xavercai/PICAR/论文设计与代码实现对照分析.docx

# 论文设计思路与代码实现对照分析

## 引言

本文档以论文《仿草履虫应激机制的小车避障进化验证系统设计与实现》的设计思路为线索，逐一对比分析系统代码（OEETestFinal_v9.7.1.ino）中各核心设计概念的代码级实现机制。论文提出了”物理结构即算法”的核心假说，并围绕该假说构建了”去标定、去滤波、去PID”三原则、草履虫应激仿生、新奇度驱动开放式进化、“向死而生”混沌机制、自身对照实验设计等五大设计支柱。代码实现（约134,000字符、3,148行）完整覆盖了上述设计思想，以下按论文章节结构展开对照分析。

## 一、“去标定、去滤波、去PID”三原则的代码实现

### 1.1 去标定：ADC原始值直接用于阈值比较

论文表2-3明确指出”去标定”原则的含义为”不转换物理单位”，实现方式为”ADC原始值直接用于阈值比较”，工程要点为”仅做零点校准（相对校准）“。代码中这一原则体现在传感器数据的读取与使用方式上。

在SensorCalibration类中，getLeftRaw()和getRightRaw()方法直接调用analogRead()读取GPIO引脚的原始ADC值，没有任何量程转换、物理单位映射或零点校准操作：

static int getLeftRaw() { return analogRead(PIN_SENSOR_LEFT); }
static int getRightRaw() { return analogRead(PIN_SENSOR_RIGHT); }

传感器原始值随后被直接用于条件比较。在BehaviorRule::compare()中，传感器值直接与预设的阈值常数进行大于/小于/等于比较：

case OP_GREATER: return value > threshold;
case OP_LESS: return value < threshold;
case OP_EQUAL: return abs(value - threshold) < 50;

阈值常量OBSTACLE_ADC_THRESH（1500）和CLEAR_ADC_THRESH（600）直接作用于ADC原始值域，没有经过任何线性变换或物理距离映射。这完全符合论文”去标定”原则中”ADC原始值直接用于阈值比较”的设计要求。传感器值在帧日志FrameLogEntry中也是以原始int16_t形式记录，保持了数据的”未加工”状态。

### 1.2 去滤波：传感器直连ADC，无信号平滑

论文表2-3指出”去滤波”原则的含义为”不进行信号平滑”，实现方式为”传感器直连ADC，无RC滤波”，工程要点为”ADC采样抖动约±50计数”。代码中同样没有任何滤波操作：

在MotorController::update()方法的每一帧执行中，传感器值通过SensorCalibration::getLeftRaw()和getRightRaw()直接读取，未进行移动平均、中值滤波、低通滤波或任何平滑处理。传感器原始值的抖动（约±50计数）被完整保留并传递到行为规则的条件评估和帧日志记录中。论文明确指出这种抖动不是需要消除的噪声，而是”硬件噪声与差动驱动的机械耦合成为行为变异的天然来源”——这正是”去滤波”原则的核心思想：让物理噪声参与计算，而非将其过滤掉。

### 1.3 去PID：不用反馈控制

论文表2-3指出”去PID”原则的含义为”不用反馈控制”。代码中确实不存在任何PID控制器、比例调节或误差反馈回路。电机的PWM输出完全由行为表规则（BehaviorRule）的motorL/motorR字段直接指定，或混沌模式下由GPIO35热噪声直接映射：

int modMotorL = constrain((int)(r.motorL * noiseMod), -255, 255);
int modMotorR = constrain((int)(r.motorR * noiseMod), -255, 255);
startPhysicsAction(modMotorL, modMotorR, modDuration);

电机速度不基于任何误差信号的积分/微分计算，而是由基因编码的规则条件直接触发离散的动作指令。即使存在编码器反馈（用于卡死检测和物理终止），也仅用于判断是否终止当前动作，而非用于实时速度调节。这严格遵循了论文”去PID”原则——用”全或无”的规则触发替代连续反馈控制。

## 二、草履虫应激机制的仿生实现

### 2.1 膜电位作为通用物理量

论文2.1.2节指出，草履虫的细胞膜电位将多模态环境信息（化学、机械、电信号）统一编码为单一物理量（电压），膜电位的升降直接决定纤毛摆动方向。论文2.2.1节进一步说明：ESP32微控制器的GPIO引脚电平或ADC读数被赋予了类似”膜电位”的功能，作为整合传感器信息的通用物理量，直接驱动电机的差动转向。

代码中，左右红外传感器的ADC原始值（leftSensorRaw、rightSensorRaw）扮演了”膜电位”的角色：它们是被统一编码的”通用物理量”，不经过任何语义解析或特征提取，直接被行为规则的条件部分（condType/condOp/condValue）进行比较判断。当传感器值超过阈值时，直接触发对应的电机动作（motorL/motorR），实现了论文所描述的”传感器原始值直接映射为左右轮PWM输出”的仿生映射链路。

### 2.2 回避反射的”全或无”特性

论文2.1.3节描述了草履虫的”回避反射”（Avoiding Reaction）机制：一旦刺激强度超过阈值，纤毛摆动方向瞬间反转，使虫体后退；随后以特定角度转向，再尝试前进。这种”全或无”（All-or-None）特性避免了弱刺激下的无效微调。

代码中，行为表规则引擎完整复现了这一机制：

（1）条件触发是二值的：BehaviorRule::compare()返回true或false，不存在”部分触发”或”渐变响应”。当传感器值超过OBSTACLE_ADC_THRESH时，条件匹配立即触发完整动作。

（2）动作执行是离散的：匹配到规则后，立即调用startPhysicsAction()设置电机PWM值和方向，动作持续durationMs毫秒后自动终止。不存在比例调节——要么全速前进/后退/转向，要么停止。

（3）种子个体中编码了回避反射的典型模式：规则0”左传感器遇障→左轮后退150、右轮前进150”（差动转向），规则1”右传感器遇障→左轮前进150、右轮后退150”（反向差动转向），规则3”卡死检测→后退右转脱困”。这些规则精确对应了草履虫”后退→转向→前进”的回避反射三阶段。

## 三、开放式进化范式的代码实现

### 3.1 新奇度搜索替代目标导向优化

论文1.2.4节指出，传统遗传算法的适应度函数将搜索限制在静态适应性景观中，而开放式进化追求”无目标的进化”。论文的核心设计之一是以新奇度搜索（Novelty Search）替代适应度函数。代码中NoveltyArchive类完整实现了这一机制：

（1）12维行为描述符（BehaviorDescriptor）：

代码中BehaviorDescriptor结构体定义了12个维度的行为特征，分为传感器维度（左/右传感器均值、方差、不对称性）、运动维度（平均速度、速度方差、转向偏置、总距离）和行为模式维度（前进比、转向比、后退比、空闲比）：

struct BehaviorDescriptor {
float leftSensorMean, rightSensorMean; // 传感器均值
float sensorVariance, sensorAsymmetry; // 传感器方差与不对称性
float avgSpeed, speedVariance, turnBias, totalDistance; // 运动维度
float forwardRatio, turnRatio, reverseRatio, idleRatio; // 行为模式
};

（2）K近邻新奇度计算：

NoveltyArchive::computeNovelty()方法计算当前个体到档案中K=5个最近邻的平均欧氏距离。距离计算在12维归一化空间中进行（normalize()方法），确保各维度量纲一致：

float distances[NOVELTY_ARCHIVE_MAX];
int k = min(NOVELTY_K_NEAREST, count);
// 排序取前K个最近邻
float sum = 0;
for (int i = 0; i < k; i++) sum += distances[i];
return sum / k; // 平均最近邻距离 = 新奇度

（3）档案管理与选择机制：

addIfNovel()方法将新奇度超过阈值（NOVELTY_ADD_THRESHOLD=0.15）且档案未满的个体加入档案（最多200条）。进化引擎中，种群按新奇度分数降序排序，保留前25%（精英保留），然后通过锦标赛选择（tournamentSelectByNovelty，规模为3）选择父本进行交叉和变异。这完全替代了传统GA中基于适应度值的排序与选择。

### 3.2 物理结构承担计算

论文v8.0版本日志提出”物理结构承担计算”的设计维度，包含三个子机制：物理终止条件、噪声连续调制、脉冲式控制。

（1）物理终止条件：

论文强调”以物理碰撞终止与噪声连续调制替代代码级计时”。代码中，动作的终止不是由固定计时器决定，而是由编码器检测物理运动状态决定：

void updatePhysicsAction() {
updateEncoders(); // 读取编码器
int32_t currentTicks = distanceTicks;
int deltaTicks = abs((int)(currentTicks - actionLastTicks));
if (deltaTicks == 0) actionStallFrames++; // 编码器停滞计数
else actionStallFrames = max(0, actionStallFrames - 1);
if (actionStallFrames > PHYSICS_STALL_FRAMES || elapsed > PHYSICS_MAX_ACTION_MS)
stopMotors(); // 物理停滞 → 终止动作
}

当编码器检测到轮子停滞（deltaTicks=0持续10帧）或动作超过最大时长3秒时，动作自动终止。终止条件由物理系统的实际运动状态驱动，而非代码中硬编码的固定时间。

（2）噪声连续调制：

论文v8.0版本日志指出”GPIO35每帧读取，调制所有行为参数（0.71.3倍）“。代码中，MotorController::update()方法每帧读取GPIO35的热噪声，并将其映射为0.71.3的调制系数：

float noise = (float)(SensorCalibration::readNoise() % 1000) / 1000.0f;
float noiseMod = 0.7f + noise * 0.6f; // 范围: 0.7 ~ 1.3
int modMotorL = constrain((int)(r.motorL * noiseMod), -255, 255);
int modMotorR = constrain((int)(r.motorR * noiseMod), -255, 255);

这一机制将硬件热噪声（物理世界的随机性）连续地注入到行为参数中，使同一基因型在不同时刻产生略有差异的行为输出。这正是论文所说的”硬件噪声与差动驱动的机械耦合成为行为变异的天然来源”的代码实现。

（3）脉冲式控制：

论文v8.0版本日志提到”删除逐帧平滑，速度变化由物理系统决定”。代码中，电机PWM值由行为规则的durationMs字段控制持续时间，动作在持续时间内以恒定PWM输出，结束后立即停止。速度变化是脉冲式的（突增突降），而非逐帧平滑过渡，符合”物理系统决定运动平滑”的设计理念。

### 3.3 可变长度行为表基因

论文v8.0版本日志提出”以可变长度行为表基因替代固定参数编码”。代码中，BehaviorRule结构体定义了一条IF-THEN规则，包含8种条件类型（后扩展为10种）和动作参数：

struct BehaviorRule {
uint8_t condType; // 条件类型 (0-9, 10种)
int16_t condValue; // 阈值
uint8_t condOp; // 比较操作 (> / < / =)
int16_t motorL; // 左轮PWM
int16_t motorR; // 右轮PWM
uint16_t durationMs; // 持续时间
uint8_t nextRule; // 跳转下一条规则
};

每个个体携带2~16条规则（MIN_RULES=2, MAX_RULES=16），规则数量本身是可进化的。Gene结构体中的ruleCount字段动态记录当前规则数量。

（1）条件类型（10种）： 代码支持COND_SENSOR_LEFT、COND_SENSOR_RIGHT、COND_SENSOR_BOTH、COND_SENSOR_ANY、COND_DISTANCE、COND_TIME、COND_IDLE、COND_ALWAYS、COND_STUCK、COND_ESCAPE共10种条件类型，覆盖了传感器感知、距离判断、时间判断、状态检测等多种行为触发场景。

（2）交叉操作： Gene::crossover()实现随机切割点交叉：从父本1取前k1条规则，从父本2取后k2条规则拼接为子代，结果约束在MIN_RULES~MAX_RULES范围内。这支持可变长度基因组的自然重组。

（3）变异操作（10种）： Gene::mutate()实现了丰富的变异操作，包括：参数微调（condValue±200、motorL/R±50）、持续时间微调（±200ms）、条件类型随机变更（10种随机选择）、操作符变更、跳转目标变更、规则增删（ruleCount++/–）、规则交换顺序。这些操作共同保证了行为空间的充分探索。

（4）规则执行引擎： MotorController::update()方法实现了规则评估引擎：每帧遍历个体的所有规则，按顺序匹配条件。匹配到规则后执行对应动作（startPhysicsAction），动作持续durationMs后自动终止，然后根据nextRule字段跳转到下一条规则或结束当前规则链。这种”条件→动作→计时→跳转”的执行模式构成了行为表的完整语义。

## 四、“向死而生”混沌机制的代码实现

### 4.1 卡死检测（三模式）

论文v8.9-chaos-v4版本日志提出”双模式卡死检测”，代码中实现了三种检测模式，全部在MotorController::update()方法中实现：

// 模式1：编码器差值卡死 - diff > 30 且持续增大，两轮都在转，持续1秒
bool diffStuck = (diff > ENCODER_DIFF_THRESHOLD && diffIncreasing &&
leftSpinning && rightSpinning && !escapeActive);
// 模式2：单轮卡死 - 一个轮子转(>20)，另一个轮子停(<3)，持续1秒
bool oneWheelStuck = ((leftSpinning && rightStopped) ||
(rightSpinning && leftStopped)) && !escapeActive;
// 模式3：大差值兜底 - diff > 60，任意轮子在转，持续1秒
bool largeDiffStuck = (diff > ENCODER_DIFF_THRESHOLD * 2 &&
anySpinning && !escapeActive);
bool isStuckCondition = diffStuck || oneWheelStuck || largeDiffStuck;

三种模式分别检测不同类型的卡死场景：差值卡死（两轮都在转但编码器差值持续增大，可能打滑）、单轮卡死（一个轮子停转，可能卡在障碍物上）、大差值兜底（极端差值情况）。当卡死条件持续ENCODER_STUCK_DURATION（1000ms=1秒）后，设置stuckFlag=true。

### 4.2 混沌触发与物理噪声驱动

论文v8.9-chaos-v5版本日志提出”向死而生”混沌机制的核心哲学：当基因驱动的脱困策略在CHAOS_TIMEOUT_MS（2秒）内未能解除卡死，系统判定”物理结构陷入了基因也无法破解的绝境”。此时代码彻底退场，GPIO35热噪声直接驱动电机，物理世界自主寻找脱困路径。

if (stuckFlag && !chaosActive) {
uint32_t stuckDuration = millis() - stuckStartTime;
if (stuckDuration >= CHAOS_TIMEOUT_MS) { // 2秒超时
startChaos(); // 触发混沌
return;
}
}

startChaos()方法设置chaosActive=true，记录混沌起始时间和距离快照。随后MotorController::updateChaos()方法每帧执行：读取GPIO35热噪声（analogRead(PIN_NOISE_SOURCE)），放大后映射到左右电机PWM：

uint16_t noiseRaw = SensorCalibration::readNoise();
int noiseL = constrain((int)(noiseRaw / 4) * CHAOS_NOISE_AMPLIFIER / 64,
-CHAOS_NOISE_AMPLIFIER, CHAOS_NOISE_AMPLIFIER);
int noiseR = constrain((int)(-noiseRaw / 4) * CHAOS_NOISE_AMPLIFIER / 64,
-CHAOS_NOISE_AMPLIFIER, CHAOS_NOISE_AMPLIFIER);
setMotorSpeed(noiseL, noiseR);

关键设计在于：混沌期间，代码不执行任何行为表规则评估、不进行任何基因解码、不做出任何决策。GPIO35的热噪声（物理世界的量子/热力学随机性）直接驱动电机，小车的行为完全由物理世界的随机涨落决定。这正是论文所说的”代码退场哲学：混沌期间代码不决策，物理世界自主探索”的精确实现。

### 4.3 混沌退出与代码接管

混沌模式需要安全退出机制，让代码在物理运动恢复后重新接管控制。代码中实现了基于编码器实际运动检测的退出机制：

bool hasPhysicalMovement = (totalDelta > 5);
if (hasPhysicalMovement) {
stableFrames++;
if (stableFrames >= CHAOS_RECOVER_STABLE_FRAMES) { // 20帧稳定
endChaos(); // 物理运动恢复 → 代码重新接管
}
}
// 超时保护：5秒无运动强制退出 + 脱困冲撞
if (millis() - chaosStartTime > CHAOS_FORCE_TIMEOUT_MS) {
setMotorSpeed(-CHAOS_ESCAPE_PWM, CHAOS_ESCAPE_PWM); // 后退
delay(300);
setMotorSpeed(CHAOS_ESCAPE_PWM, -CHAOS_ESCAPE_PWM); // 前进
delay(300);
endChaos();
}

退出机制包含两层保障：（1）正常退出——编码器检测到持续运动（totalDelta>5持续20帧），表明物理结构已恢复运动能力，代码安全接管；（2）强制退出——混沌持续5秒无运动，执行脱困冲撞动作（前后交替反转）后强制退出，防止系统永久陷入混沌。这体现了论文”向死而生”的完整闭环：物理结构”死寂”→代码感知→接通物理随机源→物理世界自主决策→物理运动恢复→代码重新接管。

## 五、自身对照实验设计的代码实现

### 5.1 数据分流标记

论文v8.9-chaos-v6版本日志提出”自身对照”方法论：以混沌触发为时间分界线，将同一硬件上的行为数据划分为基线组（Chaos-Free）和实验组（Chaos-Intervention），通过差分分析消除硬件偏差与环境噪声干扰。

代码中，FrameLogEntry结构体新增了chaosActive:1位字段，用于标记每帧数据属于基线组还是实验组：

struct FrameLogEntry {
uint32_t timestamp_ms;
int16_t sensorLeft;
int16_t sensorRight;
uint8_t motorLeftPWM;
uint8_t motorRightPWM;
uint8_t directionL : 1;
uint8_t directionR : 1;
uint8_t chaosActive : 1; // 关键标记位
uint8_t reserved : 4;
};

MotorController::logFrame()方法根据chaosActive标志将每帧数据分流到不同的统计通道：

if (chaosActive) {
chaosFrameCount++;
chaosSpeedLSum += currentSpeedL;
chaosSpeedRSum += currentSpeedR;
} else {
baselineFrameCount++;
baselineSpeedLSum += currentSpeedL;
baselineSpeedRSum += currentSpeedR;
}

这样，同一测试周期内的基线行为数据和混沌干预行为数据被完整记录且可区分，为后续的差分分析（基线 vs 实验组对比）提供了数据结构基础。

### 5.2 混沌统计记录与保存

ChaoticTestRecord结构体（56字节/条）完整记录了混沌相关的统计数据，包括触发次数、总时长、最大时长、首次/末次触发时间、基线/混沌组的距离和帧数、基线/混沌组的平均速度等：

struct ChaoticTestRecord {
uint32_t chaosTriggerCount; // 混沌触发次数
uint32_t chaosTotalDuration; // 混沌总时长
uint32_t chaosMaxDuration; // 单次最大混沌时长
int32_t baselineDistance; // 基线组距离
int32_t chaosDistance; // 混沌组距离
float baselineAvgSpeedL; // 基线组左轮平均速度
float chaosAvgSpeedL; // 混沌组左轮平均速度
uint8_t chaosSuccess; // 混沌是否发生
};

在endCurrentTestImpl()方法中，系统收集MotorController中累积的混沌统计数据，构建ChaoticTestRecord并保存到SPIFFS（/chaos_g{N}_i{X}.csv）。同时，RobustStorage类提供了混沌记录的内存缓冲和批量写入能力，确保数据不丢失。

## 六、物理终止条件与非阻塞状态机

### 6.1 非阻塞状态机重构

论文v8.6版本日志指出RTC看门狗复位问题：“physicsTerminatedAction()内部使用while(1)+delay()，最长阻塞3秒，期间不喂狗→触发RTCWDT_RTC_RST”。修复方案是将阻塞式动作执行重构为非阻塞状态机：

// 旧设计（阻塞式）：
void physicsTerminatedAction() { while(1) { delay(1000); } } // 致命！

// 新设计（非阻塞状态机）：
void startPhysicsAction(int leftPWM, int rightPWM, uint16_t minDurationMs) {
actionInProgress = true; // 设置状态
actionStartTime = millis();
setMotorSpeed(leftPWM, rightPWM);
}
void updatePhysicsAction() {
if (!actionInProgress) return; // 非阻塞，每帧调用
updateEncoders();
if (actionStallFrames > PHYSICS_STALL_FRAMES) {
actionInProgress = false; // 物理终止
stopMotors();
}
}

这种重构使系统在每个loop()周期内可以处理多个任务（传感器读取、编码器更新、Web请求、串口命令），避免了单一动作执行阻塞整个系统。论文v8.6版本日志明确指出”Web控制台在动作执行期间保持响应”，这正是非阻塞状态机带来的工程收益。

### 6.2 主循环架构

代码的主循环（loop()方法）体现了分层架构设计，按照优先级依次处理：

void loop() {
// 1. 物理动作更新（非阻塞）
MotorController::updatePhysicsAction();

// 2. 混沌模式处理（物理噪声驱动）
if (MotorController::isChaosActive()) {
MotorController::updateChaos();
}

// 3. 进化测试执行（行为表规则引擎）
if (EvolutionEngine::isTestActive()) {
Gene& gene = EvolutionEngine::getCurrentGene();
MotorController::update(gene); // 规则评估+动作执行
if (millis() - testStartTime > TEST_DURATION_MS) {
EvolutionEngine::endCurrentTest();
EvolutionEngine::nextIndividual();
}
}

// 4. Web服务器处理
if (wifiReady) CarWebServer::handleClient();

// 5. 状态过渡处理
if (EvolutionEngine::getPendingTransition()) { ... }

// 6. 串口命令处理
if (Serial.available()) { ... }

// 7. 存储心跳
RobustStorage::tick();
}

主循环的架构清晰地体现了论文提出的”三层算法”思想：混沌层（物理噪声直接驱动，代码不决策）> 行为表层（基因编码的规则引擎）> 进化层（代际选择与变异）。每层有明确的优先级和执行边界，互不干扰。

## 七、数据持久化与实验生命周期管理

论文v8.7版本日志提出了完整的数据持久化方案。代码中GeneStorage类实现了多种数据格式的持久化：

（1）种群快照（二进制）： pop_gen_{N}.bin文件以二进制格式保存整个种群的完整基因（所有个体的所有规则），包含魔数（0x47454E45）和版本号（0x0002）用于数据完整性校验。写入采用原子操作策略：先写临时文件→验证大小→重命名为正式文件，防止写入中断导致数据损坏。

（2）个体记录（CSV）： gen_{N}id{M}.csv文件以人类可读的CSV格式保存单个个体的完整基因和测试数据，包括规则数量、每条规则的条件类型/阈值/动作/持续时间、存活时间、编码器计数、新奇度分数等。

（3）帧日志（二进制）： frm_{N}_i{M}.bin文件以紧凑的二进制格式（每帧11字节）保存测试过程中的逐帧数据，包括时间戳、左右传感器值、左右电机PWM、方向标志和混沌标记。FRAME_LOG_SIZE=4096，可存储约40秒的连续数据。

（4）实验状态管理： 实验状态持久化到experiment_state.mrk文件，支持重启后自动恢复实验进度。每轮固定20代（MAX_GENERATIONS_PER_EXPERIMENT=20），自动检测新实验并清理旧数据。这确保了实验的可重复性和断点续跑能力。

## 八、电机PWM不平衡补偿

论文附录A.3记录了电机动力失衡问题的排查过程：“小车存在动力失衡问题（原地打转），经排查发现左电机接线极性错误且左右电机存在约10%~15%的物理性能差异”。代码中通过分方向增益补偿解决此问题：

#define LEFT_FWD_GAIN 1.00 // 左轮前进增益
#define RIGHT_FWD_GAIN 1.30 // 右轮前进增益（补偿）
#define LEFT_REV_GAIN 1.30 // 左轮反转增益
#define RIGHT_REV_GAIN 1.30 // 右轮反转增益

setMotorSpeed()方法根据电机方向应用不同的增益系数：前进时右轮增益1.30倍补偿其物理偏弱，反转时两轮均使用1.30倍增益。同时设置了死区补偿（LEFT_DEADZONE/RIGHT_DEADZONE），解决PWM低占空比下电机不转的问题。这体现了论文”硬件不透明算法”理念中的工程实践——承认硬件的物理不对称性，在代码层面进行补偿而非试图消除。

## 九、总结：代码与论文设计的一致性评估

通过对代码实现与论文设计的逐一对比分析，可以得出以下一致性评估结论：

（1）“去标定、去滤波、去PID”三原则——完全实现。 代码中传感器数据全程保持原始ADC值，未经任何标定转换、滤波平滑或PID调节。传感器值直接用于条件比较和帧日志记录，硬件噪声被完整保留并作为行为变异的来源。电机PWM由行为规则直接指定，不存在任何误差反馈回路。

（2）草履虫应激仿生——完整实现。 传感器原始值作为”通用物理量”直接驱动电机差动转向，行为规则采用”全或无”的二值触发机制，种子个体中编码了完整的”后退→转向→前进”回避反射三阶段规则链。COND_STUCK和COND_ESCAPE两种新条件类型进一步扩展了仿生应激的语义空间。

（3）新奇度搜索——完整实现。 NoveltyArchive类实现了12维行为描述符、K近邻新奇度计算、阈值档案管理和基于新奇度的锦标赛选择+精英保留机制。进化目标从”最大化适应度”转变为”最大化行为多样性”，自适应变异率根据种群新奇度健康度动态调整。

（4）物理结构承担计算——完整实现。 物理终止条件（编码器停滞检测）替代代码计时，GPIO35热噪声连续调制行为参数（0.7~1.3倍），脉冲式控制使速度变化由物理系统决定。非阻塞状态机确保系统多任务并发响应。

（5）“向死而生”混沌机制——完整实现。 三模式卡死检测（差值卡死、单轮卡死、大差值兜底）在2秒超时后触发混沌。混沌期间代码彻底退场，GPIO35热噪声直接驱动电机。基于编码器运动检测的安全退出机制确保物理运动恢复后代码重新接管，5秒强制超时提供兜底保障。

（6）自身对照实验设计——完整实现。 FrameLogEntry中的chaosActive标记位实现帧级数据分流，ChaoticTestRecord结构体完整记录混沌前后的统计数据（距离、帧数、平均速度等），支持基线组与实验组的差分分析。所有数据通过SPIFFS持久化，提供Web下载端点供离线分析。

综上所述，代码（v9.7.1版本）对论文设计思路的实现是完整且高度忠实的。论文提出的”物理结构即算法”核心假说在代码中得到了系统性的工程落地，从传感器数据采集到行为规则执行、从新奇度驱动进化到混沌机制干预、从数据持久化到实验管理，每一层设计都有对应的代码实现。代码不仅是论文思想的”翻译”，更在工程实现过程中通过迭代修复（如类型溢出修复、卡死检测修复、电机平衡补偿等）丰富了设计的细节和鲁棒性。
