xavercai/PICAR/软件版本演进路径0824.docx

仿草履虫应激机制 - 小车避障进化验证系统
软件版本演进路径

版本按时间顺序升序排列 | 共计40个版本记录 | 覆盖v2.0 ~ v9.11

硬件平台: ESP32-S3-WROOM-1U (AT8236电机驱动) | 文档来源: OEETestLOG_full.ino

版本号 | 时间 | 演进内容 | 硬件变化 | 引脚变化 | 新逻辑
v2.0 | 早期 | 仿草履虫应激机制 - 向死而生。死局检测：卡住3秒以上或前方障碍物过近且持续无变化；混沌注入：进入死局后主动发疯（随机PWM激荡3秒）；共振脱困：混沌中发现脱困路径立即退出；向死而生：混沌后无改善个体被淘汰。 | 原始小车平台 | | 物理差动驱动（left-right直接控制转向）；基因（k_turn, speed_bias）通过物理噪声变异+生存时间选择；混沌注入器：卡住时随机激荡尝试脱困。
v3.3 | 早期 | 左右轮速度补偿（左轮独立加速）。修复左轮方向，增加LEFT_SPEED_COMP补偿左轮硬件速度不足，保持steer驱动转向的核心逻辑。 | | 矫正左轮电机方向 | 左轮独立速度补偿
v3.4 | 早期 | Wi-Fi实时日志 + 混沌强制停机修复。Wi-Fi AP模式实时发送日志到电脑/手机；混沌失败后强制停机并跳转STATE_CALC_SCORE；增加混沌超时保护防止死循环。 | | | 新增Wi-Fi AP模块；混沌超时保护机制
v3.4.1 | 早期 | 上电不走问题修复版。FORWARD_BIAS从30提升到80；speed_bias范围从120~180调整为150~180；STATE_LOAD_GENE增加基因损坏检测和自动修复；增加启动PWM调试输出。 | | | 基因损坏检测与自动修复；增大基础驱动力
v3.4.2 | 早期 | 主动前进修复版。增加主动前进模式（即使无传感器刺激也前进）；优化转向灵敏度避免疯狂转圈；增加速度阈值检测。 | | | 主动前进模式；转向灵敏度优化
v3.4.3 | 早期 | 电机方向修正 + 动力增强版。交换DIR引脚定义修正电机方向；FORWARD_BIAS 80→120；ACTIVE_FORWARD 60→80；增加最小PWM阈值保护(≥150)；左轮独立补偿+30。 | | 交换DIR引脚定义（修正电机方向） | 最小PWM阈值保护(≥150)
v3.4.4 | 早期 | 左偏修正版。LEFT_WHEEL_COMP从30→70（加大左轮补偿）；增加RIGHT_WHEEL_REDUCE参数（右轮减速）；强制对称校正（左轮优先满速，右轮跟随）。 | | | 强制对称校正机制
v3.4.5 | 早期 | 方向修正（右拐修复）。LEFT_WHEEL_COMP从+70→-20（左轮减速）；RIGHT_WHEEL_REDUCE从+20→-30（右轮加速）；增加调试信息观察左右轮PWM差。 | | | 细化左右轮PWM偏差调试
v3.5.0 | 早期 | WiFi远程控制与数据提取增强版（无JSON依赖）。WiFi命令控制：启动/停止/重置进化；实时状态监测：速度、传感器、位置；数据提取：种群数据导出、统计信息。Web控制面板美观UI界面。 | | | Web控制面板；WiFi命令控制；数据提取API
v4.0.0 | 2026-07-14 | Web控制 + 自身对照。记录每个个体混沌前/后生存时间（纯物理差动阶段 vs 混沌干预阶段）；通过自身对照消除硬件差异对进化数据的影响；CSV导出包含自身对照数据。6个精英保留（原4个），增加基因多样性。16个体种群规模，30-60秒测试时长。 | | | 自身对照实验设计（混沌前/后数据分离）；6精英保留机制；16个体种群
v4.1.0 | 2026-07-15 | Web控制 + 自身对照 + 6精英 + 驱动修复。修复左轮驱动逻辑错误；降低PWM阈值提升低速性能；优化基础速度计算。 | | | 左轮驱动逻辑修复；低速性能优化
v5.0 | 2026-07-16 | 模块化重构 · 鲁棒性增强。代码划分为15个模块（硬件参数、基因结构、全局变量、电机控制、传感器读取、物理差动控制、死局检测、基因库、变异杂交、种群初始化、打印调试、进化状态机、中断服务、主程序）；看门狗复位（卡死超5秒自动重启）；传感器超时保护；死区补偿；数据有效性检查；参数集中管理。 | | 参数集中管理，所有可调参数统一在模块1 | 看门狗复位；传感器超时保护；死区补偿；参数集中管理
v5.1 | 2026-07-16 | 模块化 + Wi-Fi/Web控制 + 方向修正。新增Web服务器处理模块；代码结构扩展至15个模块。修复方向控制逻辑。 | | | 增加Web模块；方向修正
v5.2 | 2026-07-17 | 杂交版（501界面 + 402核心）。Web界面采用v5.01美观界面；状态机采用v4.02可靠状态机；电机控制采用v4.02逻辑但修正方向；保留硬件健康管理和传感器鲁棒读取。 | | | 多版本代码融合策略
v5.3 | 2026-07-17 | 整合版 - 电机控制已优化。正PWM=前进，负PWM=后退（清晰统一）；方向引脚配置集中一处；所有功能模块化可读性强；电机控制逻辑从bylwv503pmotor整合。代码按类重构：Logger/Gene/EEPROMStorage/Motor/Encoders/Sensors/Population/EvolutionEngine/MyWebServer。 | | 方向引脚配置集中定义 | 正PWM=前进/负PWM=后退统一范式；类封装重构
v5.4 | 2026-07-18 | 修正传感器反逻辑 + 页面动态显示。传感器值反转（未遮挡高值→低值，遮挡低值→高值），适应[遮挡=低值]传感器特性。修复速度计算逻辑避免原地转圈；页面动态显示传感器和电机参数；每个个体生存时间改为30秒。降低传感器阈值：SENSOR_THRESHOLD=400, CLEAR_THRESHOLD=150。evo2~evo9多次迭代调优。 | 硬件端对调IN1和IN2的GPIO12和14对接方式 | IN1/IN2 GPIO12和14对调接线 | 传感器值反转；阈值降低(2000→400,1500→150)；重写速度计算逻辑（差值>80才转向）；限制转向幅度≤基础速度30%；evo5修复PWM通道共用问题
v5.6-ESP32S3-RAM-ONLY | 2026-07-25 | 基于v5.5修改，将EEPROM/SPIFFS存储替换为RAM存储。移除EEPROM和SPIFFS相关所有代码；种群数据仅存储在RAM中；历史数据通过Web接口从RAM导出；保留所有控制逻辑、传感器逻辑、混沌逻辑、避障算法、进化机制。 | ESP32-S3-WROOM-1U (AT8236电机驱动) | 左电机: IN1=GPIO16, IN2=GPIO15；右电机: IN1=GPIO9, IN2=GPIO46；左编码器: A=GPIO18, B=GPIO17；右编码器: A=GPIO11, B=GPIO10；TCRT5000: GPIO35/36；板载LED: GPIO14 | 去除EEPROM依赖；纯RAM存储；Web导出替代Flash持久化
v5.6-ESP32S3-RAM-ONLY-GP2Y0E03 | 2026-07-27 | 传感器换代：TCRT5000模拟传感器 → GP2Y0E03 I2C数字测距传感器。移除ADC传感器引脚，启用I2C GPIO12(SDA)/GPIO13(SCL)；Sensors类接口完全兼容上层代码。 | 传感器从TCRT5000升级为GP2Y0E03 I2C数字测距传感器 | 废弃ADC传感器引脚(GPIO4/5)；新增I2C: SDA=GPIO12, SCL=GPIO13 | I2C数字传感器接口；传感器类接口向后兼容
v5.6-ESP32S3-RAM-ONLY-GP2Y0E03-PowerControl | 2026-07-27 | 分时供电方案：两个GPIO分别控制左右传感器VCC。解决I2C地址冲突问题。 | HW-131降压模块（分时供电） | 新增GPIO2/GPIO3分时控制左右传感器VDD（后续修正为GPIO40/GPIO41） | 分时供电；I2C总线设备冲突规避
v5.6-ESP32S3-GP2Y0E03-TIME-SHARE（最终版） | 2026-07-28 | 分时供电引脚修正：GPIO2/3板载插座未引出，更换为GPIO40(IO40)/GPIO41(IO41)。搭载两块HW-131降压模块：HW131#1输出3.3V持续供给GP2Y0E03 VIN(IO)引脚永久通电；GP2Y0E03 VDD由ESP32 GPIO40/41分时控制通断，电源源自ESP32板载3.3V。电机增益：LeftGain=1.30f, RightGain=1.50f。 | ESP32-S3 Maturo一体底板(AT8236驱动)；两块HW-131降压模块；GP2Y0E03双路I2C传感器 | GPIO40→左传感器VDD分时供电；GPIO41→右传感器VDD分时供电；I2C: SDA=GPIO12, SCL=GPIO13；左电机: PWM=GPIO9, DIR2=GPIO46；右电机: PWM=GPIO16, DIR2=GPIO15；编码器: 左A/B=18/17, 右A/B=11/10；GPIO6悬空噪声；板载LED=GPIO14 | 供电架构：VIN(IO)永久常通+VDD分时开关；I2C总线并联；左右传感器地址0x40/0x41
v5.9-ESP32S3-GP2Y0A21YK0F-PURE-ANALOG | 2026-08-03 | 废弃GP2Y0E03 I2C数字方案，更换为GP2Y0A21YK0F模拟红外测距传感器。关键决策：I2C数字接口引入了量化环节（物理世界离散化），违背[去标定]三原则。无滑动平均、无RC滤波，环境噪声直接参与控制与基因变异；控制逻辑steer=左ADC-右ADC，纯物理几何差动映射。 | 传感器从GP2Y0E03更换为GP2Y0A21YK0F模拟红外；需5V供电（禁止直连3.3V） | GPIO35→左传感器ADC；GPIO36→右传感器ADC；GPIO6→悬空热噪声；GPIO39→预留中断；GPIO14→LED；GPIO9→左电机PWM；GPIO46→左电机DIR2；GPIO16→右电机PWM；GPIO15→右电机DIR2；GPIO18/17→左编码器A/B；GPIO11/10→右编码器A/B | 回归[去标定]原则：仅读ADC原始值(0~4095)，不换算距离/电压；物理即算法：steer = left_adc - right_adc；GPIO6悬空热噪声生成物理真随机变异源
v6.0 / v6.1-NOVELTY-BEHAVIOR | 2026-08-13 | 代码融合：融合v5.9硬件驱动层 + v8.6 NoveltySearch进化引擎。延迟WiFi初始化避免softAP阻塞；新增SPIFFS持久化存储（掉电/复位后自动恢复）；传感器引脚确认GP2Y0A21YK0F模拟红外(GPIO4/5)；电机驱动AT8236(GPIO9/46/16/15内部走线)。Novelty Search新奇度驱动进化 + 可变长度行为表基因(2~16条IF-THEN规则)。 | ESP32-S3 Maturo一体底板；GP2Y0A21YK0F模拟红外；AT8236电机驱动 | 采用目标系统定义：GPIO46/GPIO15方向控制；GPIO4/5传感器ADC | Novelty Search新奇度驱动进化；行为表基因(BehaviorRule 2~16条)；SPIFFS持久化+RAM双轨；非阻塞物理动作状态机
v7.0-脱困优先版 | 2026-08-09 | 舍弃[生存时间]作为适应度指标，以[脱困能力]为唯一筛选标准。脱困率+脱困速度→综合评分；不能脱困的个体淘汰；从连续量进化转向离散量进化。 | | | 脱困率为核心适应度指标；离散量进化
v7.1-全面修复版 | 2026-08-09 | 修复11项：电机转向定义验证；左右电机增益重新校准；双轮转速差卡死检测（双维度判定）；碰撞计数器衰减逻辑；传感器基准值启动校准；速度平滑过渡(每帧最大变化15)；转向死区(差值<50直行)；混沌脱困后计数器重置；直行偏好；摇摆检测阈值修复；编译错误修复。 | | | 双维度卡死检测；传感器自动校准；速度平滑过渡；转向死区
v7.2-鲁棒持久化版 | 2026-08-09 | SPIFFS存储鲁棒性大幅提升：3次挂载重试；批量写入策略(每10秒或5条记录)；原子文件操作(临时文件+重命名)；写入失败3次重试；文件完整性验证；自动清理旧数据(保留500条)；电源中断保护；双缓冲区(RAM+Flash)；强制保存API；存储状态监控。修复所有编译错误。 | | | 鲁棒SPIFFS存储（批量写入+原子操作+3次重试）；双缓冲区；存储状态监控
v7.3-完整修复版 | 2026-08-09/10 | 电机增益调优(左1.20/右1.35)；混沌超时后进入后退复位；修复strategyStats重复计数；后退复位增加防卡死逻辑；混沌超时后清空困境计数器；优化转向平滑度；增加混沌步数动态调整。移植自v5.9 MotorDriver电机增益控制逻辑：新增writeMotorHardware统一入口；全部替换为ledcWrite匹配AT8236；修复编码器ISR正交解码；混沌脱困后增加escapeRetreat随机方向后退500ms。 | 右电机驱动补偿RIGHT_GAIN=1.25 | PIN_NOISE_SOURCE从GPIO6改为GPIO35（GPIO6与Flash SPI CLK冲突） | 电机增益统一控制；编码器正交解码ISR；混沌脱困后随机方向后退；混沌脱困失败→立即死亡（不靠recovery苟活稀释进化压力）
v7.3-fixed-v2 | 2026-08-11 | 编译错误全面修复（10项致命+警告修复）：EvolutionEngine重构为单例+静态包装模式；ledcAttach拆分为ledcSetup+ledcAttachPin；ledcWrite参数改为通道号；PIN_NOISE_SOURCE GPIO6→GPIO35；删除重复server.on注册；添加<cstdio>头文件；新增public getter方法。 | | 确认PIN_NOISE_SOURCE=GPIO35 | 单例+静态包装模式；编译系统全面修正
v8.0-开放式进化重构 | 2026-08-11 | 设计哲学转变：从[目标导向优化]转向[行为多样性探索]。Novelty Search新奇度驱动：12维行为描述符(传感器4维+运动4维+策略4维)；新奇度=到档案k=5近邻欧氏距离；自适应变异率。物理结构承担计算：物理终止条件、噪声连续调制(0.7~1.3倍)、脉冲式控制。可变长度行为表基因(2~16条规则，数量可进化)。 | | | Novelty Search新奇度驱动；12维行为描述符；可变长度行为表基因；自适应变异率；物理结构承担计算（去PID/去滤波/去标定）
v8.5-final | 2026-08-12 | 硬件适配与编译修复。方向引脚修正：PIN_LEFT_DIR2 21→46，PIN_RIGHT_DIR2 33→15；setMotorSigned重写为setMotorSpeed同时控制方向和PWM；删除writeMotorHardware统一使用setMotorSpeed。此时SPIFFS被禁用，数据仅保存在RAM中。 | | PIN_LEFT_DIR2: 21→GPIO46；PIN_RIGHT_DIR2: 33→GPIO15 | 统一电机控制接口setMotorSpeed；右电机正反转与v5.9对齐
v8.6-非阻塞状态机重构 | 2026-08-13~14 | 修复RTC看门狗复位(rst:0x10)问题。physicsTerminatedAction()拆分：startPhysicsAction()+updatePhysicsAction()每帧调用；移除所有阻塞delay()；Web控制台在动作执行期间保持响应。 | | | 非阻塞物理动作状态机（无delay）；每帧检测编码器停滞→自动终止
v8.6.4-数据修复 | 2026-08-14 | 实机运行数据分析与关键Bug修复。distanceTicks uint32_t下溢溢出修复(→int32_t)；distanceTicks在个体间从未重置修复；下溢值污染行为描述符修复。共12处类型修复。 | | | distanceTicks: uint32_t→int32_t；个体间编码器重置
v8.7-完整基因存储+二进制帧日志 | 2026-08-15 | GeneStorage类：完整基因原子保存与加载（种群快照/pop_gen_N.bin、个体记录/gen_N_id_X.csv、帧日志/frm_N_iX.bin）。原子写入策略（临时文件→验证大小→重命名）。实验生命周期管理（每轮20代自动检测）；重启后自动恢复进度。文件头含魔数(0x47454E45)和版本号(0x0002)。 | | | GeneStorage完整基因持久化；原子写入；实验生命周期管理（20代）；数据完整性魔数校验
v8.8-卡死感知+向死而生混沌 | 2026-08-15 | 恢复混沌/卡死检测逻辑。卡死检测硬编码基础设施：检测条件轮子在转(>50)但编码器差值持续增大(>50)→持续1秒→stuckFlag=true。COND_STUCK和COND_ESCAPE条件类型；种子个体包含卡死脱困规则。 | | | 卡死检测基础设施；COND_STUCK/COND_ESCAPE条件类型；种子个体含脱困规则
v8.9-robust-stable | 2026-08-15 | 鲁棒性增强：修复状态机死锁(stopMotors强制重置ruleActive)；种群数据完整性验证自动修复损坏个体；initImpl末尾强制验证重建种子个体；startPhysicsAction检查motorEnabled；所有状态记录帧日志。 | | | 状态机死锁修复；种群数据完整性验证；自动修复损坏个体
v8.9-chaos ~ v8.9-chaos-v6 | 2026-08-15/16 | 混沌机制完整实现与向死而生演进。条件类型COND_STUCK=8/COND_ESCAPE=9实装；双模式卡死检测(差值+单轮+大差值兜底)；向死而生混沌机制：GPIO35热噪声直接驱动电机，代码彻底退场；物理世界自主寻找脱困路径。自身对照实验设计：ChaoticTestRecord结构体(56字节/条)；混沌/基线分流统计；14处代码修改。 | | GPIO35热噪声源 | 向死而生混沌（代码退场，物理噪声直接驱动电机）；双模式卡死检测；自身对照实验（混沌前/后数据分流）；基因驱动脱困策略→物理噪声自主探索
v9.3-OEETestV3 | 2026-08-16 | 完整功能基线：Novelty Search新奇度驱动进化；可变长度行为表基因(2~16条规则)；物理终止条件；噪声连续调制；双模式卡死检测；向死而生混沌机制；完整基因存储；二进制帧日志；原子写入；实验生命周期管理；自身对照实验设计；完整Web下载端点；SPIFFS持久化。 | | | 代码退场哲学：混沌期间代码不决策，物理世界自主探索；物理结构即算法；进化不预设目标
v9.4-ChaosFix | 2026-08-16 | 混沌触发修复。根因：卡死检测和混沌触发逻辑被放在if(!ruleActive)代码块内部→ruleActive恒为true→永不触发。修复：卡死检测逻辑移出→每帧都执行；混沌触发判断移到ruleActive块外部；触发后立即return避免规则冲突。 | | | 混沌触发链路完全修复（从ruleActive内部移出）
v9.5-DataAuditFix | 2026-08-16 | 数据审计修复。FRAME_LOG_SIZE 256→4096(可存40秒)；删除重复写入；新增独立下载端点(/download/genes, /download/frames, /download/individual, /download/population)；单个体完整数据包下载。 | | | 帧日志容量256→4096；独立下载端点分离；单个体完整数据包
v9.7-MotorBalanceFix | 2026-08-16 | 电机平衡修复。分方向增益+死区补偿：LEFT_FWD_GAIN=1.00, RIGHT_FWD_GAIN=1.25唯一直行组合；左转/右转Web控制PWM调整(-130/120)；完整串口命令(ls/status/frame/pop/chaos/popall/help)；FRAME_LOG_SIZE=4096(可存40秒)。 | | | 分方向电机增益补偿；死区补偿；完整串口命令系统
v9.7.1-ChaosTimeoutFix ★ | 2026-08-16 | 混沌超时修复（当前版本标注）。混沌模式基于编码器实际运动检测恢复（替代虚假信号检测）；混沌超时保护：5秒无运动强制退出+脱困冲撞(CHAOS_ESCAPE_PWM=200)；电机PWM不平衡补偿(LEFT_FWD=1.00, RIGHT_FWD=1.30)；新增popall<代>命令。 | | | CHAOS_FORCE_TIMEOUT_MS=5000ms强制退出；CHAOS_ESCAPE_PWM=200脱困冲撞；CHAOS_RECOVER_STABLE_FRAMES=20稳定帧检测；基于编码器实际运动检测恢复
v9.8-RAMLogBuffer ★ | 2026-08-16 | RAM动态日志缓冲+SPIFFS滚动覆盖（当前版本）。RAMLogBuffer类：6000帧环形缓冲区(72KB)，Web/串口动态提取；RollingStorage类：自动滚动覆盖保留最近5代Top2；增量保存每500帧写入SPIFFS；CRC32校验文件头；滑动窗口卡死检测(10帧窗口验证)；存储空间预警。MotorState枚举(IDLE/WALKING/STUCK/CHAOS/ESCAPING)替代4个布尔标志。帧日志差分压缩每帧压缩1字节。 | | PIN_NOISE_SOURCE改为GPIO1 | RAMLogBuffer 6000帧环形缓冲；RollingStorage滚动覆盖(5代Top2)；CRC32校验；滑动窗口卡死检测(10帧)；状态机重构(单一枚举替代多布尔)；差分压缩帧日志
v9.9-ChaosFix+WebRefactor | 2026-08-17 | 混沌修复+Web重构。修复混沌永不触发Bug（卡死检测条件过严+stuckStartTime被错误重置）；loop()中兜底保护检测STATE_STUCK超时强制触发混沌；startChaos增加醒目日志。Web页面重构：顶部全宽状态矩阵卡片(IDLE/WALKING/STUCK/CHAOS/ESCAPING高亮)；混沌噪声值实时显示；存储报警；一键下载全部文件。新增/download/all端点。 | | | 混沌触发兜底保护；5状态矩阵可视；存储空间预警变色；一键下载全部文件
v9.9-Fixed | 2026-08-18 | 数据持久化修复。loadExperimentState()增加种群文件验证；initImpl()增加种群文件存在性检查；新增setCurrentGeneration()方法；FORMAT_SPIFFS_ON_BOOT宏控制格式化；新增串口命令reset/format。 | | | 种群文件验证与自动修复；reset/format串口命令
v9.10-AuditFix | 2026-08-18 | 依赖链路审计与修复（15个问题，3轮修复全部通过）。C级3个：Fix#C01 logFrame环形缓冲区溢出修复；Fix#C02 saveFrameLog差分压缩参考值类型错误修复；Fix#C03 FORMAT_SPIFFS_ON_BOOT改为0。H级4个：Fix#H01 baselineDistanceTicks累积修复；Fix#H02 atomicWrite原子性修复；Fix#H03 ensureSpace死代码激活；Fix#H04 SPIFFS总空间硬编码→SPIFFS.totalBytes()。M级+L级8个：重复调用/CSV格式/缓冲/死代码/原子重试/时间戳等修复。 | | | 15个链路问题全修复（C3+H4+M5+L3）；全链路依赖审计通过
v9.11-Emergence | 2026-08-18 | 物理涌现重构：目标移除植入算法，让物理参数由基因编码。Phase1: Gene结构体扩展11个物理参数移入基因(obstacleThreshold/clearThreshold/encoderDiffThreshold/encoderDiffMin/wheelSpinThreshold/wheelStopThreshold/stuckWindowSize/chaosNoiseAmplifier/chaosMinPwm/chaosTimeoutMs/chaosForceTimeoutMs)。Phase2: FILE_VERSION 0x0004→0x0005。Phase3: 移除COND_STUCK(8)和COND_ESCAPE(9)→卡死只能通过混沌模式(物理噪声)脱困。Phase4: MotorController使用基因参数替代硬编码常量。Phase5: 移除人工种子个体→完全随机初始化。Phase6: 移除PHYSICS_STALL_FRAMES和PHYSICS_MAX_ACTION_MS→仅由基因durationMs控制。Phase7: SensorCalibration使用基因阈值。约60%硬编码物理参数已移入基因，剩余10个植入算法标记待后续演进。 | | | 11个物理参数移入基因可进化；移除COND_STUCK/ESCAPE（算法脱困→物理噪声脱困）；ESCAPING状态移除（5→4状态机）；种子个体随机初始化；基因durationMs控制动作长度；基因阈值替代校准代码；60%硬编码参数已基因化

说明：

1. "★"标注的版本为当前活跃版本号。版本按时间顺序升序排列，早期未标注具体日期的版本以功能迭代为序。

2. 硬件平台经历了多次迭代：TCRT5000 → GP2Y0E03(I2C) → GP2Y0A21YK0F(模拟红外)，每次更换都基于实验发现和设计哲学的根本性冲突。

3. 进化策略经历了三次范式转换：经典GA(v7.x) → Novelty Search(v8.x) → 物理涌现(v9.11)，逐步从[植入算法驱动]走向[物理结构涌现驱动]。

4. 存储方案多次演进：EEPROM → SPIFFS → RAM Only → SPIFFS滚动覆盖+RAMLogBuffer，最终在v9.8确定了当前稳定方案。

文档生成日期: 2026-08-24 来源: OEETestLOG_full.ino INTERNAL
