xavercai/PICAR/进化小车固件功能结构地图.docx

# 进化小车固件 v9.7.1 — 功能结构地图

基于函数最小颗粒度的模块化功能结构分析

## 一、全局常量与枚举定义模块

### 1.1 硬件引脚定义（L28-L48）

宏定义 | 引脚号 | 功能说明
PIN_SENSOR_LEFT | 4 | 左侧传感器模拟输入
PIN_SENSOR_RIGHT | 5 | 右侧传感器模拟输入
PIN_NOISE_SOURCE | 1 | 噪声源模拟输入（用于混沌模式和随机种子）
PIN_OBSTACLE_INT | 39 | 障碍物中断输入
PIN_LED | 14 | LED 指示灯
PIN_LEFT_PWM | 9 | 左电机 PWM 输出
PIN_LEFT_DIR2 | 46 | 左电机方向控制
PIN_RIGHT_PWM | 16 | 右电机 PWM 输出
PIN_RIGHT_DIR2 | 15 | 右电机方向控制
PIN_LEFT_ENC_A | 18 | 左编码器 A 相
PIN_LEFT_ENC_B | 17 | 左编码器 B 相
PIN_RIGHT_ENC_A | 11 | 右编码器 A 相
PIN_RIGHT_ENC_B | 10 | 右编码器 B 相

核心功能：定义 ESP32 所有硬件引脚的映射关系，是底层硬件驱动的抽象层。

### 1.2 LEDC 配置（L51-L55）

宏定义 | 值 | 功能说明
LEDC_FREQ | 5000 | PWM 频率 (Hz)
LEDC_RESOLUTION | 8 | PWM 分辨率 (bit)
LEDC_CHANNEL_LEFT | 0 | 左电机 PWM 通道
LEDC_CHANNEL_RIGHT | 1 | 右电机 PWM 通道

核心功能：配置 ESP32 的 LEDC（LED 控制器）PWM 输出参数，用于电机调速。

### 1.3 电机方向定义（L58-L62）

宏定义 | 值 | 功能说明
LEFT_FORWARD | HIGH | 左电机正转方向电平
LEFT_REVERSE | LOW | 左电机反转方向电平
RIGHT_FORWARD | LOW | 右电机正转方向电平（反向逻辑）
RIGHT_REVERSE | HIGH | 右电机反转方向电平（反向逻辑）

核心功能：定义左右电机正转/反转对应的 GPIO 电平，右电机方向逻辑与左电机相反。

### 1.4 电机增益补偿（L65-L73）

宏定义 | 值 | 功能说明
LEFT_FWD_GAIN | 1.00f | 左轮前进增益
RIGHT_FWD_GAIN | 1.30f | 右轮前进增益（右轮加力）
LEFT_REV_GAIN | 1.30f | 左轮反转增益（左转力度不够调大）
RIGHT_REV_GAIN | 1.30f | 右轮反转增益（右转力度不够调大）
LEFT_DEADZONE | 35 | 左轮死区补偿值
RIGHT_DEADZONE | 20 | 右轮死区补偿值（右轮死区降低）
MOTOR_PWM_MAX | 255 | 电机 PWM 最大值

核心功能：配置电机增益补偿和死区参数，解决左右轮动力不平衡和低速死区问题。

### 1.5 WiFi 配置（L76-L78）

宏定义 | 值 | 功能说明
WIFI_SSID | “CarLogger” | WiFi AP 名称
WIFI_PASSWORD | “12345678” | WiFi AP 密码

核心功能：定义 Web 服务器的 WiFi AP 热点凭据。

### 1.6 进化参数（L81-L83）

宏定义 | 值 | 功能说明
POPULATION_SIZE | 16 | 种群大小
TEST_DURATION_MS | 30000 | 单个个体测试时长 (ms)
LOOP_DELAY_MS | 10 | 主循环延迟 (ms)

核心功能：配置进化算法的核心参数（种群大小、测试时长、循环周期）。

### 1.7 物理动作参数（L86-L87）

宏定义 | 值 | 功能说明
PHYSICS_STALL_FRAMES | 10 | 物理动作卡死检测帧数阈值
PHYSICS_MAX_ACTION_MS | 3000 | 物理动作最大持续时间 (ms)

核心功能：配置物理动作的卡死检测和超时参数。

### 1.8 传感器阈值（L90-L91）

宏定义 | 值 | 功能说明
CLEAR_ADC_THRESH | 600 | 无障碍 ADC 阈值
OBSTACLE_ADC_THRESH | 1500 | 障碍物 ADC 阈值

核心功能：定义传感器判断无障碍/障碍物的 ADC 阈值。

### 1.9 行为规则参数（L94-L98）

宏定义 | 值 | 功能说明
MAX_RULES | 16 | 最大规则数
MIN_RULES | 2 | 最小规则数
MAX_RULE_DURATION | 2000 | 规则最大持续时间 (ms)
MIN_RULE_DURATION | 50 | 规则最小持续时间 (ms)

核心功能：定义行为规则的数量和时长约束边界。

### 1.10 Novelty Search 参数（L101-L103）

宏定义 | 值 | 功能说明
NOVELTY_ARCHIVE_MAX | 200 | 新奇档案库最大容量
NOVELTY_K_NEAREST | 5 | K 近邻数量
NOVELTY_ADD_THRESHOLD | 0.15f | 加入档案库的新奇度阈值

核心功能：配置 Novelty Search 算法的档案库大小、K 近邻数和加入阈值。

### 1.11 存储参数（L106-L107）

宏定义 | 值 | 功能说明
STORAGE_SAVE_INTERVAL_MS | 10000 | 自动保存间隔 (ms)
FRAME_LOG_SIZE | 4096 | 帧日志最大条目数

核心功能：配置数据存储的保存间隔和帧日志缓冲区大小。

### 1.12 固件版本（L110-L111）

宏定义 | 值 | 功能说明
FIRMWARE_VERSION | “v9.7.1-ChaosTimeoutFix” | 固件版本号
VERSION_MARKER_FILE | “/version_…” | 版本标记文件路径

核心功能：定义固件版本号及版本标记文件路径，用于检测版本升级并清理旧数据。

### 1.13 卡死检测参数（L114-L118）

宏定义 | 值 | 功能说明
ENCODER_DIFF_THRESHOLD | 30 | 编码器差值卡死阈值
ENCODER_STUCK_DURATION | 1000 | 卡死持续时间阈值 (ms)
ENCODER_DIFF_MIN | 5 | 编码器差值最小增量
WHEEL_SPIN_THRESHOLD | 20 | 车轮打滑检测阈值
WHEEL_STOP_THRESHOLD | 3 | 车轮停止检测阈值

核心功能：配置编码器卡死检测的多种判定参数（差值阈值、打滑阈值、停止阈值）。

### 1.14 混沌超时参数（L121-L126）

宏定义 | 值 | 功能说明
CHAOS_TIMEOUT_MS | 2000 | 混沌模式触发超时 (ms)
CHAOS_NOISE_AMPLIFIER | 180 | 混沌噪声放大器系数
CHAOS_MIN_PWM | 20 | 混沌模式最小 PWM
CHAOS_RECOVER_STABLE_FRAMES | 20 | 混沌恢复稳定帧数
CHAOS_FORCE_TIMEOUT_MS | 5000 | 混沌强制退出超时 (ms)
CHAOS_ESCAPE_PWM | 200 | 脱困冲撞 PWM 值

核心功能：配置混沌模式（卡死后的应急行为）的触发、执行和退出参数。

### 1.15 条件类型枚举 CondType（L130-L141）

枚举值 | 编号 | 功能说明
COND_SENSOR_LEFT | 0 | 左传感器条件
COND_SENSOR_RIGHT | 1 | 右传感器条件
COND_SENSOR_BOTH | 2 | 左右传感器同时条件
COND_SENSOR_ANY | 3 | 左右传感器任一条件
COND_DISTANCE | 4 | 距离条件
COND_TIME | 5 | 时间条件
COND_IDLE | 6 | 空闲条件
COND_ALWAYS | 7 | 恒真条件
COND_STUCK | 8 | 卡死条件
COND_ESCAPE | 9 | 逃逸条件

核心功能：定义行为规则的 10 种条件判断类型，覆盖传感器、距离、时间、状态等多种触发源。

### 1.16 条件操作枚举 CondOp（L143-L147）

枚举值 | 编号 | 功能说明
OP_GREATER | 0 | 大于比较
OP_LESS | 1 | 小于比较
OP_EQUAL | 2 | 等于比较（容差 50）

核心功能：定义条件比较操作的 3 种运算符。

## 二、数据结构定义模块

### 2.1 BehaviorRule 结构体（L152-L189）

核心功能：定义行为规则的数据结构，包含条件类型、条件值、操作符、左右电机 PWM、持续时间、下一条规则索引。

函数名 | 功能说明
randomize() | 随机生成规则参数（条件类型 0-9、条件值 -3000~3000、操作符 0-2、电机 PWM -255~255、持续时间、下一条规则 0-2）
clamp() | 将所有字段约束到合法范围（电机 PWM 约束 -255~255、持续时间约束 50~2000、条件类型约束 0-9、操作符约束 0-2）
compare() | 根据操作符比较值与阈值（OP_GREATER: value > threshold; OP_LESS: value < threshold; OP_EQUAL: abs(value-threshold) < 50）

### 2.2 BehaviorDescriptor 结构体（L194-L232）

核心功能：定义行为描述符，包含 12 个浮点特征维度，用于 Novelty Search 的行为相似度计算。

函数名 | 功能说明
init() | 将所有 12 个特征字段初始化为 0
distance() | 计算与另一个描述符的欧几里得距离（12 维特征空间）
normalize() | 按最大值的比例归一化（leftSensorMean, rightSensorMean, sensorVariance, avgSpeed, speedVariance, totalDistance）

### 2.3 FrameLogEntry 结构体（L237-L247）

核心功能：定义 11 字节紧凑帧日志条目，记录每帧的传感器、电机、方向、混沌状态。

字段 | 大小 | 说明
timestamp_ms | 4 bytes | 时间戳
sensorLeft | 2 bytes | 左传感器值
sensorRight | 2 bytes | 右传感器值
motorLeftPWM | 1 byte | 左电机 PWM
motorRightPWM | 1 byte | 右电机 PWM
directionL | 1 bit | 左电机方向
directionR | 1 bit | 右电机方向
chaosActive | 1 bit | 混沌模式激活
reserved | 4 bits | 保留

### 2.4 HistoryRecord 结构体（L252-L260）

核心功能：定义进化历史记录条目，包含时间戳、代数、新奇度、存活时间、距离、规则数。

### 2.5 ChaoticTestRecord 结构体（L265-L285）

核心功能：定义混沌实验记录条目，包含混沌触发次数、总时长、最大时长、基线/混沌距离和速度等 18 个字段。

## 三、Logger 模块（L303-L317）

核心功能：提供系统日志输出能力，所有日志带时间戳前缀。

函数名 | 访问修饰 | 功能说明
init() | static | 初始化串口通信（115200 波特率，延迟 500ms）
log() | static | 输出日志消息，自动添加 “[OE] {秒数}s” 时间戳前缀
logf() | static | 格式化日志输出（支持 printf 风格可变参数），内部调用 log()

## 四、SensorCalibration 模块（L322-L354）

核心功能：传感器校准与读取，提供左右传感器原始值读取、障碍物检测、无障碍检测和噪声源读取。

函数名 | 访问修饰 | 功能说明
calibrate() | static | 传感器校准：采样 50 次取平均，计算左右基准值
getLeftRaw() | static | 读取左传感器原始 ADC 值
getRightRaw() | static | 读取右传感器原始 ADC 值
isObstacleLeft() | static | 判断左传感器是否检测到障碍物（ADC > 1500）
isObstacleRight() | static | 判断右传感器是否检测到障碍物（ADC > 1500）
isClear() | static | 判断路径是否无障碍（左右传感器 ADC 均 < 600）
readNoise() | static | 读取噪声源 ADC 值（用于混沌模式和随机种子）

静态变量： - leftBase：左传感器校准基准值 - rightBase：右传感器校准基准值

## 五、RobustStorage 模块（L359-L535）

核心功能：鲁棒数据存储层，提供 SPIFFS 文件的缓冲写入、历史记录管理、混沌实验记录管理和 CSV 数据导出。

### 私有函数

函数名 | 功能说明
appendToFile() | 以追加模式打开文件写入数据，文件不存在则创建
loadHistory() | 从 SPIFFS 读取历史记录 CSV 文件，解析并加载到 RAM 缓冲区（最多 1000 条）

### 公有函数

函数名 | 功能说明
init() | 初始化存储系统：尝试挂载 SPIFFS，失败则使用 RAM 模式；挂载成功后加载历史记录
addRecord() | 添加历史记录：写入 RAM 缓冲区（满时前滚覆盖），同时追加到待写入缓冲区，缓冲区满或条目数 >= 5 时自动刷新
flushBuffer() | 刷新待写入缓冲区到 SPIFFS 文件；SPIFFS 不可用时清空缓冲区
forceSave() | 强制保存待写入缓冲区
isReady() | 检查存储系统是否就绪（SPIFFS 是否挂载成功）
getTotalSaved() | 获取已保存的记录总数
tick() | 周期保存钩子：距上次保存超过 10 秒且有待写入数据时自动刷新
clearAll() | 清空所有存储数据（缓冲区 + RAM 历史）
getCSVData() | 获取完整 CSV 数据字符串（先刷新缓冲区，再从文件读取或从 RAM 构建）
addChaosRecord() | 添加混沌实验记录到混沌历史 CSV 文件
getChaosHistoryCSV() | 读取混沌历史 CSV 文件内容

静态变量： - HISTORY_FILE：“/oe_history.csv” - CHAOS_HISTORY_FILE：“/chaos_history.csv” - fsReady：SPIFFS 就绪标志 - lastSaveTime：上次保存时间 - unsavedCount：未保存计数 - totalSaved：总保存计数 - pendingBuffer：待写入缓冲区 - ramHistory[1000]：RAM 历史记录数组 - ramHistoryCount：RAM 历史记录计数

## 六、FirmwareVersionManager 模块（L540-L578）

核心功能：固件版本管理，检测版本升级并清理旧数据。

函数名 | 功能说明
isNewVersion() | 检查是否为新版本：无 SPIFFS 或版本标记文件不存在或内容不匹配则返回 true
cleanAllData() | 清理所有数据文件：删除 /pop_gen_, /gen_, /frm_*, /oe_history.csv, /experiment_state.mrk, 旧版本标记文件
writeVersionMarker() | 写入版本标记文件，内容为当前固件版本号

## 七、FileUtils 模块（L583-L622）

核心功能：文件工具集，提供原子写入、安全读取和文件大小查询。

函数名 | 功能说明
atomicWrite() | 原子写入：先写入 .tmp 文件，写入成功后删除原文件并重命名 .tmp 为目标文件
atomicWriteString() | 原子写入字符串，内部调用 atomicWrite()
safeRead() | 安全读取文件全部内容，文件不存在或 SPIFFS 不可用时返回空字符串
getFileSize() | 获取文件大小，文件不存在或 SPIFFS 不可用时返回 0

## 八、Gene 模块（L627-L677 + L1616-L1634）

核心功能：基因结构体定义及进化操作（初始化、条件评估、变异、交叉）。

### 内联函数

函数名 | 功能说明
init() | 初始化基因：随机规则数（MIN_RULES~MAX_RULES），随机化所有规则，重置存活时间、距离、新奇度、行为描述符
mutate() | 变异函数：对每条规则执行 7 种变异操作（条件值扰动 ±200、左电机扰动 ±50、右电机扰动 ±50、持续时间扰动 ±200、条件类型随机替换、操作符随机替换、下一条规则随机替换），以及 3 种结构变异（增加规则、删除规则、交换两条规则）
crossover() | 交叉函数：双点交叉，从两个父代各取一段规则拼接成子代，不足部分用父代规则填充

### 前置声明函数（在结构体内声明，L1616-L1634 实现）

函数名 | 功能说明
evaluateCondition() | 评估行为规则条件：根据 condType 选择传感器值/距离/时间等，处理特殊条件（COND_SENSOR_BOTH/ANY/IDLE/ALWAYS/STUCK/ESCAPE），最后调用 BehaviorRule::compare() 比较

## 九、GeneStorage 模块（L682-L928）

核心功能：基因持久化存储，管理种群文件、个体记录、帧日志和混沌记录的读写，以及实验状态管理。

### 公有函数

函数名 | 功能说明
init() | 初始化基因存储：加载实验状态（代数、实验 ID）
startNewExperiment() | 开始新实验：清空所有实验数据，设置新实验 ID 和代数
shouldStartNewExperiment() | 检查是否应开始新实验：实验标记不存在或代数 >= 20 时返回 true
isExperimentActive() | 检查实验是否活跃
getCurrentGeneration() | 获取当前代数
getMaxGenerations() | 获取最大代数（20）
getProgress() | 获取实验进度（当前代数/最大代数）
isExperimentComplete() | 检查实验是否完成（当前代数 >= 20）
incrementGeneration() | 增加代数并保存实验状态
savePopulation() | 保存种群：二进制格式写入（Magic + Version + PopSize + Gen + ExpID + 个体数据），使用原子写入
saveIndividualRecord() | 保存个体记录：CSV 格式，包含每条规则的参数和个体评估结果
saveFrameLog() | 保存帧日志：二进制格式（每帧 11 字节），最多保存 FRAME_LOG_SIZE 帧
saveChaosRecord() | 保存混沌记录：CSV 格式
loadPopulation() | 加载种群：二进制格式读取，验证 Magic 和 PopSize
clearAllExperimentData() | 清空所有实验数据文件

### 私有函数

函数名 | 功能说明
saveExperimentState() | 保存实验状态到标记文件（实验 ID, 代数）
loadExperimentState() | 从标记文件加载实验状态

静态变量： - MAX_GENERATIONS_PER_EXPERIMENT：20 - FILE_VERSION：0x0002 - FILE_MAGIC：0x47454E45 (“GENE”) - POP_PREFIX：“/pop_gen_” - GEN_RECORD_PREFIX：“/gen_” - FRAME_LOG_PREFIX：“/frm_” - EXPERIMENT_MARKER：“/experiment_state.mrk” - currentExperimentId：当前实验 ID - currentGeneration：当前代数 - experimentActive：实验活跃标志

## 十、NoveltyArchive 模块（L933-L1029）

核心功能：新奇度搜索档案库，维护行为描述符档案，计算新奇度评分，支持从帧日志提取行为描述符。

函数名 | 访问修饰 | 功能说明
init() | public | 初始化档案库（大小为 0，最大值归一化基准为 0）
updateMaxValues() | private | 更新归一化最大值（leftSensorMean, rightSensorMean, sensorVariance, avgSpeed, speedVariance, totalDistance）
computeNovelty() | public | 计算新奇度：归一化描述符 → 计算与档案库中所有描述符的距离 → K 近邻排序 → 返回 K 个最近距离的平均值
addIfNovel() | public | 若新奇度 >= 阈值则加入档案库（档案满时循环覆盖）；更新最大值
extractFromFrameLog() | public | 从帧日志提取行为描述符：计算 12 个特征（左/右传感器均值、传感器方差、传感器不对称性、平均速度、速度方差、转向偏差、总距离、前进/转向/后退/空闲比例）
getArchiveSize() | const | 获取档案库当前大小

私有变量： - archive[NOVELTY_ARCHIVE_MAX]：行为描述符档案数组 - archiveSize：档案库当前大小 - maxValues：归一化最大值

## 十一、MotorController 模块（L1034-L1611）

核心功能：电机驱动核心模块，负责 PWM 输出、编码器读取、卡死检测、混沌模式、行为规则执行和帧日志记录。是系统中功能最密集的模块。

### 私有函数

函数名 | 功能说明
setMotorSpeed() | 设置电机速度：左右电机分别处理（分方向增益 + 死区补偿），写入 PWM 和方向 GPIO
updateEncoders() | 更新编码器：读取左右编码器 A/B 相，计算增量（正交编码），累加到距离计数器，去抖（10ms 间隔）

### 公有函数

函数名 | 功能说明
isStuck() | 检查是否处于卡死状态
isEscapeActive() | 检查是否处于逃逸状态
isChaosActive() | 检查是否处于混沌模式
getChaosDuration() | 获取混沌模式持续时间
getTestChaosTriggerCount() | 获取混沌触发次数
getTestChaosTotalDuration() | 获取混沌累计持续时间
getTestChaosMaxDuration() | 获取混沌最大单次持续时间
getTestChaosFirstTriggerTime() | 获取首次混沌触发时间
getTestChaosLastTriggerTime() | 获取上次混沌触发时间
getBaselineDistanceTicks() | 获取基线阶段距离
getChaosDistanceTicks() | 获取混沌阶段距离
getBaselineFrameCount() | 获取基线阶段帧数
getChaosFrameCount() | 获取混沌阶段帧数
getBaselineAvgSpeedL() | 获取基线阶段左轮平均速度
getBaselineAvgSpeedR() | 获取基线阶段右轮平均速度
getChaosAvgSpeedL() | 获取混沌阶段左轮平均速度
getChaosAvgSpeedR() | 获取混沌阶段右轮平均速度
getChaosHappened() | 检查是否发生过混沌
resetChaosStatistics() | 重置所有混沌统计数据
setEscapeActive() | 设置逃逸状态
resetStuck() | 重置卡死标志和计时
getLeftTicks() | 获取左编码器累计刻度
getRightTicks() | 获取右编码器累计刻度
getEncoderDiff() | 获取左右编码器差值绝对值
init() | 初始化电机控制器：设置 GPIO 模式、配置 LEDC PWM、附加引脚、初始化所有状态变量
stopMotors() | 停止所有电机：设置 PWM 为 0、方向为 LOW、重置动作/规则/卡死状态
enableMotor() | 启用电机并停止
disableMotor() | 禁用电机并停止
isMotorEnabled() | 检查电机是否启用
startPhysicsAction() | 开始物理动作：设置动作标志、记录起始时间和刻度、调用 setMotorSpeed()
updatePhysicsAction() | 更新物理动作：读取编码器、计算增量、检测卡死（deltaTicks == 0 累计帧数），超时或卡死则停止
forceStopAction() | 强制停止动作
isActionInProgress() | 检查是否有动作正在进行
startChaos() | 启动混沌模式：停止当前动作，设置混沌标志，记录触发时间和距离，递增触发计数
updateChaos() | 更新混沌模式：读取噪声源 → 生成左右噪声 PWM → 驱动电机；基于编码器实际运动检测恢复条件（稳定帧 >= 20）；5 秒无运动强制退出（执行脱困冲撞：前后交替 PWM 200）
endChaos() | 结束混沌模式：停止电机，记录混沌持续时间/距离，重置卡死/逃逸状态
startFrameLog() | 开始帧日志记录：重置日志头指针和计数
logFrame() | 记录一帧：写入帧日志缓冲区（时间戳、传感器、电机 PWM、方向、混沌标志），同时统计基线/混沌阶段的帧数和速度累加
update() | 主更新循环（核心调度函数）：更新编码器 → 读取传感器 → 卡死检测（三种卡死条件：差值卡死、单轮卡死、大差值卡死）→ 卡死超时触发混沌 → 混沌模式执行 → 动作执行 → 行为规则匹配（遍历规则，评估条件，应用噪声调制，启动物理动作）→ 记录帧
getDistanceTicks() | 获取距离刻度
resetDistanceTicks() | 重置距离刻度和编码器
getFrameLog() | 获取帧日志指针
getFrameLogCount() | 获取帧日志计数
getCurrentSpeedL() | 获取左轮当前速度
getCurrentSpeedR() | 获取右轮当前速度

静态变量（共 35+ 个）： - currentSpeedL/R：当前左右速度 - distanceTicks：距离刻度（volatile） - lastMoveTime：上次移动时间 - testStartTime：测试开始时间 - leftSensorRaw/rightSensorRaw：传感器原始值 - currentRuleIndex/ruleStartTime/ruleActive：当前规则状态 - frameLog[frameLogCount]：帧日志缓冲区 - motorEnabled：电机启用标志 - lastLeftA/lastRightA：编码器上次状态 - lastEncoderReadTime：上次编码器读取时间 - actionInProgress/StartTime/LastTicks/StallFrames：动作状态 - leftTicks/rightTicks：编码器刻度（volatile） - stuckFlag/stuckStartTime/lastDiff：卡死检测 - escapeActive：逃逸标志 - chaosActive/chaosStartTime：混沌模式 - testChaos：混沌统计 - baseline/chaos：基线/混沌阶段统计

## 十二、EvolutionEngine 模块（L1639-L1852）

核心功能：进化引擎核心，管理种群、测试循环、进化操作（选择、交叉、变异）和新奇度搜索。采用单例模式。

### 私有函数

函数名 | 功能说明
createSeedIndividual() | 创建种子个体：6 条预定义规则（左传感器避障、右传感器避障、空闲前进、卡死逃逸、逃逸完成、恒真前进）
initImpl() | 初始化进化引擎：加载已有种群或创建初始种群（前两个个体为种子变异），保存初始种群
startCurrentTestImpl() | 开始当前个体测试：启用电机、开始帧日志、重置卡死和混沌统计
endCurrentTestImpl() | 结束当前个体测试：停止电机、计算存活时间和距离、提取行为描述符、计算新奇度、加入档案库、保存历史记录和个体记录、帧日志、混沌记录
nextIndividualImpl() | 切换到下一个个体：结束当前测试，如果是最后一个个体则执行进化操作，然后开始下一个个体的测试
evolveImpl() | 进化操作：按新奇度排序 → 精英保留（前 1/4）→ 锦标赛选择 → 交叉 → 变异 → 自适应变异率调整
tournamentSelectByNovelty() | 锦标赛选择：随机选 3 个个体，返回新奇度最高的
getAvgNovelty() | 计算种群平均新奇度

### 公有函数

函数名 | 功能说明
init() | 初始化进化引擎
startCurrentTest() | 开始当前个体测试
endCurrentTest() | 结束当前个体测试
nextIndividual() | 切换到下一个个体
isTestActive() | 检查测试是否活跃
getTestStartTime() | 获取测试开始时间
getGeneration() | 获取当前代数
getIndividual() | 获取当前个体索引
getMutationRate() | 获取当前变异率
getBestNoveltyEver() | 获取历史最佳新奇度
getArchiveSize() | 获取档案库大小
getCurrentGene() | 获取当前基因引用
setPendingTransition() | 设置待处理切换标志
getPendingTransition() | 获取待处理切换标志
clearPendingTransition() | 清除待处理切换标志
setMutationRate() | 设置变异率（约束 0.01~1.0）
setControlMode() | 设置控制模式（关闭进化，允许手动控制）

私有变量： - instance：单例实例 - population[POPULATION_SIZE]：种群数组 - archive：新奇度档案库 - currentGeneration：当前代数 - currentIndividual：当前个体索引 - testStartTime：测试开始时间 - testActive：测试活跃标志 - pendingTransition：待处理切换标志 - controlMode：控制模式标志 - mutationRate：变异率 - bestNoveltyEver：历史最佳新奇度

## 十三、CarWebServer 模块（L1857-L2339）

核心功能：Web 服务器，提供基于 ESP32 软 AP 的 Web 界面和 RESTful API，用于监控、控制和数据导出。

### 私有函数

函数名 | 功能说明
buildHTMLPage() | 构建完整的 HTML 网页（含 CSS 样式、JavaScript 自动刷新逻辑、控制面板）

### 公有函数（Web 路由处理）

函数名 | 路由 | 功能说明
init() | — | 注册所有路由并启动 Web 服务器（端口 80）
handleClient() | — | 处理 Web 客户端请求
handleStatus() | GET /status | 返回系统状态 JSON（代数、个体、新奇度、规则数、距离、传感器、编码器、卡死/混沌状态等）
handleArchive() | GET /archive | 返回档案库大小和最佳新奇度 JSON
handleEvolution() | GET /evolution?action=start/stop/next | 控制进化流程（启动/停止/下一个）
handleMotor() | GET /motor?action=enable/disable/stop/forward/backward/left/right | 电机控制（启用/禁用/停止/前进/后退/左转/右转）
handleReset() | GET /reset | 重启 ESP32
handleAdminClean() | GET /admin/clean | 清理所有数据（调用 FirmwareVersionManager::cleanAllData）
handleExperimentStatus() | GET /experiment/status | 返回实验状态 JSON（活跃标志、当前代数、最大代数、进度）
handleVersion() | GET /version | 返回固件版本 JSON
handleDownloadHistory() | GET /download/history | 下载历史记录 CSV
handleDownloadEvolution() | GET /download/evolution | 下载进化数据 CSV
handleDownloadChaos() | GET /download/chaos | 下载混沌数据（所有 /chaos_* 文件）
handleDownloadPopulation() | GET /download/population | 下载种群快照（所有 /pop_gen_* 文件）
handleDownloadGenes() | GET /download/genes | 下载基因记录（所有 /gen_* 文件）
handleDownloadFrames() | GET /download/frames | 下载帧日志（所有 /frm_* 文件或指定代/个体）
handleDownloadIndividual() | GET /download/individual?gen=X&id=Y | 下载个体数据包（基因 + 帧日志 + 混沌数据）
handleListFiles() | GET /list/files | 列出 SPIFFS 所有文件 JSON

## 十四、串口命令处理模块（L2347-L2591）

核心功能：提供串口调试命令，用于在串口终端查看和解析存储数据。

函数名 | 功能说明
listSPIFFSFiles() | 列出 SPIFFS 所有文件，按类型分类显示（种群/基因/帧日志/混沌/历史），统计总文件数和总字节数
printStatus() | 打印系统状态：版本、代数、个体、新奇度、规则数、距离、卡死/混沌状态、SPIFFS 状态
parseFrameLog() | 解析帧日志二进制文件，显示前 50 帧的完整字段（时间戳、传感器、PWM、方向、混沌标志）
parsePopulation() | 解析种群快照二进制文件，显示 Magic/版本/种群大小/代数，以及每个个体的所有规则详情
parseChaosRecord() | 解析混沌记录 CSV 文件，完整输出
parseAllIndividuals() | 汇总一代所有 16 个个体的数据：规则数、新奇度、混沌次数、左右轮速度、速度比、评价（良好/混沌救回/死亡/失衡），并统计总体指标

## 十五、WiFi 初始化模块（L2596-L2609）

函数名 | 功能说明
initWiFi() | 初始化 WiFi AP：设置 AP 模式，创建热点（SSID: CarLogger），启动 Web 服务器。调用一次后不再重复（wifiInitialized 标志）

静态变量： - wifiInitialized：WiFi 已初始化标志 - wifiReady：WiFi 就绪标志

## 十六、setup() 函数（L2614-L2648）

核心功能：系统启动初始化流程，按依赖顺序依次初始化各子系统。

初始化顺序： 1. 串口初始化（115200 波特率） 2. 打印启动信息 3. RobustStorage::init() — 存储系统 4. FirmwareVersionManager::isNewVersion() — 检查版本，升级则清理数据 5. GeneStorage::init() — 基因存储 6. GeneStorage::shouldStartNewExperiment() — 检查是否需新实验 7. 配置噪声源引脚为输入 8. randomSeed() — 以噪声源值初始化随机种子 9. SensorCalibration::calibrate() — 传感器校准 10. MotorController::init() — 电机控制器 11. EvolutionEngine::init() — 进化引擎 12. 打印就绪信息（含 WiFi 热点信息）

## 十七、loop() 函数（L2653-L2732）

核心功能：主循环，按优先级执行各子系统。

执行顺序： 1. initWiFi() — 首次循环初始化 WiFi（若未初始化） 2. MotorController::updatePhysicsAction() — 更新物理动作（编码器 + 卡死检测） 3. MotorController::updateChaos() — 若混沌模式激活则更新混沌 4. EvolutionEngine 测试循环： - 获取当前基因 - MotorController::update(gene) — 执行行为规则驱动 - 超时检测（30 秒）→ 结束当前测试 → 下一个个体 5. CarWebServer::handleClient() — 若 WiFi 就绪则处理 Web 请求 6. 待处理切换：若 pendingTransition 为 true 则切换到下一个个体 7. 串口命令处理：解析串口输入并执行对应命令（ls/status/frame/pop/chaos/popall/help） 8. RobustStorage::tick() — 周期保存 9. delay(LOOP_DELAY_MS) — 主循环延迟 10ms

## 附录：全局函数调用关系总览

调用方 | 被调用方 | 调用场景
setup() | RobustStorage::init() | 系统启动
setup() | FirmwareVersionManager::isNewVersion() | 版本检测
setup() | GeneStorage::init() | 存储初始化
setup() | SensorCalibration::calibrate() | 传感器校准
setup() | MotorController::init() | 电机初始化
setup() | EvolutionEngine::init() | 进化引擎初始化
loop() | MotorController::updatePhysicsAction() | 主循环
loop() | MotorController::updateChaos() | 混沌更新
loop() | MotorController::update(gene) | 行为驱动
loop() | CarWebServer::handleClient() | Web 服务
loop() | RobustStorage::tick() | 周期保存
EvolutionEngine::endCurrentTestImpl() | RobustStorage::addRecord() | 保存历史
EvolutionEngine::endCurrentTestImpl() | GeneStorage::saveIndividualRecord() | 保存个体
EvolutionEngine::endCurrentTestImpl() | GeneStorage::saveFrameLog() | 保存帧日志
EvolutionEngine::endCurrentTestImpl() | GeneStorage::saveChaosRecord() | 保存混沌记录
EvolutionEngine::evolveImpl() | GeneStorage::savePopulation() | 保存种群
MotorController::update() | Gene::evaluateCondition() | 条件评估
MotorController::update() | MotorController::startChaos() | 混沌触发
MotorController::update() | MotorController::startPhysicsAction() | 动作启动
NoveltyArchive::computeNovelty() | BehaviorDescriptor::distance() | 距离计算
NoveltyArchive::addIfNovel() | NoveltyArchive::computeNovelty() | 新奇度计算
NoveltyArchive::addIfNovel() | NoveltyArchive::updateMaxValues() | 更新最大值
CarWebServer::buildHTMLPage() | (返回 HTML 字符串) | Web 页面构建
CarWebServer::handleStatus() | EvolutionEngine::getCurrentGene() | 状态查询
CarWebServer::handleMotor() | MotorController::enableMotor() | 电机控制
CarWebServer::handleEvolution() | EvolutionEngine::startCurrentTest() | 进化控制
