xavercai/PICAR/智能体构建手册.docx

# "物理结构即算法"具身智能体实验平台搭建手册

# "物理结构即算法"具身智能体实验平台

从零搭建手册 —— 一个可操作、可重复、可验证的四阶段构建指南

2026年8月 · 配套文档 · 与《方法论文档》和《学术论文》互补

## 目录

1. 前言：这份手册是什么、不是什么
2. 第一阶段：物理基线的建立（v2.0→v3.4.5）
3. 第二阶段：进化底板与数据体系（v4.0→v7.3）
4. 第三阶段：范式转变与涌现重构（v8.0→v9.11）
5. 第四阶段：审计与可靠性收敛（v9.10→v9.15）
6. 附录A：物料清单（BOM）
7. 附录B：常见故障排查表
8. 附录C：阶段自检清单汇总
9. 后记：从"搭出来"到"证明它"

## 前言：这份手册是什么、不是什么

#### 这份手册是

- 一份按时间线组织的搭建指南，告诉你每一步做什么、为什么这样做
- 一份技术决策参考，在每个岔路口提供选择依据
- 一份故障排查手册，记录了我们踩过的坑和修复方法
- 一份自检清单，每个阶段结束后你可以对照检查

#### 这份手册不是

- 不是代码文档——如果你需要完整的函数索引，请参考《函数编号与依赖关系定义文档》
- 不是理论论文——如果你需要哲学论证，请参考《"物理结构即算法"驱动的具身智能体构建方法论》
- 不是逐行代码教程——它会引用关键代码片段，但不会展示全部实现

搭建手册的核心承诺 如果你按照本手册的四个阶段，从第一阶段搭到第四阶段，你将得到：一个能够自主进化出避障能力的双轮机器人，其行为不由程序员预设，而是由物理结构+新奇度搜索在代际迭代中涌现。

4

构建阶段

13

GPIO引脚

19

关键版本节点

220+

函数总量

## 第一阶段：物理基线的建立

时间跨度：v2.0 → v3.4.5 · 约占总工作量 25%

核心目标：让机器人能动、能感知、能在卡死时通过物理噪声自救。这一阶段不涉及任何进化或实验逻辑——只做最底层的物理验证。

### 1.1 阶段动机：为什么不直接从进化开始？

在任何进化实验开始之前，你必须先回答一个基础问题：这个物理平台能否在"无人干预"的情况下持续运行？如果机器人卡在墙角时需要一个人类去手动扶正，进化就不可能运行——因为进化需要数百代的无人值守操作。第一阶段的所有工作都围绕"无人值守自持运行"展开。

### 1.2 硬件准备

#### 所需物料

组件 | 规格/型号 | 数量 | 来源/建议
主控板 | ESP32 Dev Module (双核 Xtensa LX6) | 1 | 带WiFi，需支持SPIFFS
电机驱动 | TB6612FNG（推荐）或 L298N（需电平转换） | 1 | TB6612可直接用3.3V逻辑
直流电机 | TT马达或N20减速电机，工作电压6-12V | 2 | 带正交编码器的型号优先
正交编码器 | AB相输出，每圈脉冲≥20 | 2 | 须与电机匹配安装
红外传感器 | 模拟反射式（如TCRT5000模块） | 2 | 模拟输出比数字输出提供更多信息
轮子 | 直径≥60mm，有足够抓地力 | 2 | 过小的轮子在毛毡/地毯上会打滑
底板 | 亚克力/铝板/3D打印 | 1 | 需预留所有模块的安装孔位
电源 | 2S（7.4V）或3S（11.1V）锂电池 | 1 | 需配合LM2596降压模块给ESP32供电
降压模块 | LM2596 DC-DC，输出5V/3A | 1 | 将电池电压降至ESP32可接受的5V
万向轮 | 小型球式或旋转式 | 1-2 | 用于底盘支撑

[留白：需要线下确认的硬件信息]

请补充以下信息：① 所使用的具体电机型号和额定参数（电压/空载转速/堵转扭矩）；② 编码器的每圈脉冲数和安装方式（轴装/轮装）；③ 底板的实际尺寸和材质；④ 电池的具体容量（mAh）和放电倍率。

#### 引脚接线表

以下接线表基于最终稳定版本（v9.15），已验证可正常工作。如果你使用不同的电机驱动芯片（如L298N），请注意EN引脚的连接方式可能不同。

功能 | ESP32引脚 | 连接到 | 类型 | 注意事项
左红外 | GPIO4 (ADC1_CH0) | TCRT5000模块模拟输出 | 模拟输入 | 使用ADC1通道，不受WiFi干扰
右红外 | GPIO5 (ADC1_CH1) | TCRT5000模块模拟输出 | 模拟输入 | 同上
噪声源 | GPIO1 (ADC1_CH0) | 悬空！不接任何东西 | 浮空ADC | 必须避开Flash/PSRAM复用的GPIO
障碍物中断 | GPIO39 | 数字障碍物传感器（可选） | 仅输入 | 仅支持输入，无内部上拉
状态LED | GPIO14 | LED + 220Ω限流电阻 → GND | 数字输出
左电机PWM | GPIO9 | 电机驱动 IN1/PWM | LEDC输出 | 5kHz, 8-bit (0-255)
左电机DIR | GPIO46 | 电机驱动 IN2/DIR | 数字输出 | 前进=HIGH, 后退=LOW
右电机PWM | GPIO16 | 电机驱动 IN3/PWM | LEDC输出 | 5kHz, 8-bit
右电机DIR | GPIO15 | 电机驱动 IN4/DIR | 数字输出 | 前进=LOW, 后退=HIGH（极性反转！）
L298N ENA | GPIO21 | L298N ENA（若用L298N） | PWM | TB6612可直接拉高或跳过
L298N ENB | GPIO22 | L298N ENB（若用L298N） | PWM
左编码A相 | GPIO18 | 左轮编码器A相 | 数字输入 | 上升沿触发计数
左编码B相 | GPIO17 | 左轮编码器B相 | 数字输入 | 方向判断
右编码A相 | GPIO11 | 右轮编码器A相 | 数字输入 | 上升沿触发计数
右编码B相 | GPIO10 | 右轮编码器B相 | 数字输入 | 方向判断（注意左右方向逻辑不同）

关键警告：噪声源引脚选择 GPIO1被用作浮空ADC读取热噪声。历史上噪声源曾使用GPIO6（与ESP32内部Flash冲突导致读取异常），后迁移到GPIO35，最终v9.9确定为GPIO1。选择噪声源引脚时必须查阅ESP32的IO_MUX表，确认该引脚不与Flash/PSRAM复用。如果你使用不同的ESP32开发板（如ESP32-S3），噪声源引脚需要重新验证。

### 1.3 物理差动驱动：第一步代码

在开始任何复杂逻辑之前，你需要先实现最底层的电机控制。本系统的核心控制公式（v2.0确立）极其简单：

// 物理差动驱动：转向 = 左右PWM原始差值
steer = left_raw_pwm - right_raw_pwm;

// 无PID、无滤波、无标定
// 物理系统自行吸收速度差异

这看起来像是"偷懒"，但实际上是一个深思熟虑的方法论决策：任何PID校正都会引入软件对物理系统的"模型假设"——假设电机是线性的、假设摩擦力是恒定的、假设左右是对称的。这些假设在真实物理世界中都不成立。与其建立一个虚假的模型去"修正"物理，不如让物理系统自己定义运动轨迹。

#### 技术决策树：方向极性问题的排查流程

① 现象： 机器人前进时明显偏向一侧（如向左偏）
→ 不是去调整代码中的速度补偿，而是先检查：那个"慢"的轮子是方向反了吗？
→ v3.3.2的教训：左轮方向反转导致看似"速度慢"，实则是"方向反"。

② 排查方法： 抬起机器人，单独驱动一个轮子，用肉眼确认它是否按预期方向旋转。
→ 如果方向反了：交换该电机的DIR引脚逻辑（前进=HIGH改为前进=LOW）。
→ 如果方向正确但转速不对：进入增益补偿阶段。

### 1.4 电机调校的实证记录

以下是v3.3到v3.4.5的实际调校过程——它不是"一次性校准"的案例，而是反复试错的经验收敛。搭建者应做好类似的迭代准备：

版本 | 尝试的措施 | 观察到的结果 | 结论
v3.3 | 左轮速度补偿+30 | 左轮仍明显慢于右轮 | 补偿量不足
v3.3.1 | 左轮速度补偿增至+70 | 左轮加速过度，反而右边慢了 | 补偿超调
v3.3.2 | 发现左轮在"正向"命令下实际反转 | 根本原因不是速度，是方向极性 | 方向极性错误被误认为速度问题
v3.3.3 | 交换左电机DIR引脚的正反转定义 | 方向修正，但速度需要重新标定 | 硬件接线是根因
v3.4 | 左轮速度补偿重新标定为-20 | 基本达到左右平衡 | 方向修正后补偿值完全不同
v3.4.5 | FORWARD_BIAS从30增至120 | 爬坡和越过门槛的能力显著增强 | 动力参数与地形直接相关

最重要的教训：先查物理，再调参数 当你的机器人"跑不直"时，最高概率的原因不是补偿参数不对，而是物理假设不对——方向反了、轮子松了、电池没电了。软件工程师的本能是改代码，但硬件调校的正确顺序是：① 检查接线 → ② 检查供电 → ③ 检查方向极性 → ④ 最后才调整软件补偿参数。

### 1.5 增益补偿体系

当方向正确、接线正确，但左右仍然速度不一致时，你需要引入增益补偿。这不是"精确标定"——这是"够用就行"的工程补偿。本系统最终使用的补偿参数如下（你的机器人几乎肯定需要不同的值）：

参数 | 左电机 | 右电机 | 说明
前进增益 | 1.00 | 1.30 | 右电机前进时需额外30%的PWM占空比才能与左电机匹敌
后退增益 | 1.30 | 1.30 | 两电机后退时效率均低于前进，统一需要30%补偿
死区阈值 | 35 | 20 | 低于此值的PWM电机不转，直接抬升到此值
最大PWM | 255（8-bit LEDC分辨率） | | ESP32 LEDC的8-bit模式上限

死区补偿的逻辑：当目标PWM值低于死区阈值时（如要求左轮走10），电机根本不转。代码将自动把输出值抬升到死区阈值（35），使电机至少能转动。这比复杂的"低PWM线性化"更实用——因为物理世界不在乎线性，它只在乎"动还是不动"。

[留白：需要你在你自己的机器上实测的增益值]

上述增益值仅适用于本项目使用的具体电机和机械结构。你需要在自己的机器人上做以下实测：
① 给左右电机相同的PWM（如100），测量它们各自在10秒内走的距离，计算前进增益比；
② 给左右电机相同的负PWM（如-100），重复测量，确定后退增益；
③ 从低到高逐渐增加PWM，找到每个电机"开始转动"的最小PWM值——这就是死区阈值。

### 1.6 "向死而生"混沌注入器

这是第一阶段最核心的模块——它是整个"物理结构即算法"哲学的第一个工程落地。其设计原则在v2.0中确立并在后续版本中不断完善：

混沌注入器的设计原则 当机器人检测到卡死状态时，代码不再执行任何方向性决策。GPIO1（浮空ADC）的实时噪声读数被放大后直接驱动左右电机。代码的角色从"决策者"变为"物理世界的接口"——它只是在读取和放大物理信号，而不是在"想"怎么脱困。

卡死检测逻辑：

// 滑动窗口（10帧）监测编码器差值变化
// 条件：轮子速度 > 20（命令确实发出了）
// + 编码器差值 < 30（轮子实际几乎没转）
// + 持续1秒以上（排除瞬时打滑）
// → 判定卡死 → 进入混沌模式

混沌模式的行为：

// 每帧执行：
left_pwm = analogRead(GPIO1) * CHAOS_NOISE_AMPLIFIER / 4095;
right_pwm = analogRead(GPIO1) * CHAOS_NOISE_AMPLIFIER / 4095;
setMotorSpeed(left_pwm, right_pwm);

// 每一帧的GPIO1读数都不同
// → 每一帧的PWM输出都不同
// → 机器人产生不可预测的随机运动
// → 这是物理热噪声在"计算"，不是代码在计算

混沌退出条件：

// 编码器读数连续20帧稳定变化（差值 > 5）
// → 轮子实际上在转，机器人已脱离卡死
// → 退出混沌，恢复正常行为表驱动

混沌注入器必须验证的基础用例 在你继续任何后续阶段之前，请确认以下三个场景都能正常运行：
① 机器人被手动推向墙角（模拟卡死）→ 1秒内应自动进入混沌模式，开始随机挣扎
② 混沌中的随机挣扎最终使其脱离墙角 → 编码器稳定读数后应自动退出混沌
③ 让机器人在开放空间中跑1分钟 → 不应触发混沌（验证卡死检测没有误触发）

### 1.7 第一阶段自检清单

电机能正反转，方向正确

红外传感器能正确区分"有障碍"和"无障碍"（参考阈值：<600无障碍，>1500有障碍）

编码器读数在电机转动时持续变化（用串口打印验证）

GPIO1悬空时读取到明显波动的ADC值（范围应覆盖0-4095的至少50%）

机器人被卡在墙角时，1秒内自动进入混沌模式

混沌模式中的随机运动能够使其脱困，且脱困后自动退出混沌

增益补偿和死区补偿生效：低速命令下电机也能转动，左右基本平衡

## 第二阶段：进化底板与数据体系

时间跨度：v4.0 → v5.4 → v7.3 · 约占总工作量 20%

核心目标：在第一阶段"能动"的基础上，搭建进化算法的基本框架、自身对照实验的数据采集体系、以及让系统能够"存下实验结果"的持久化机制。

### 2.1 阶段动机：从"活着"到"进化"

第一阶段结束后，你的机器人已经能够自主运行、在卡死时通过混沌脱困。但这不够——它只是在"活着"，而不是在"变好"。第二阶段要解决的问题是：如何让机器人通过反复运行自动变得更好？

这需要三个基础设施：一个进化算法（用于"选择更好的个体"）、一个实验设计（用于"判断谁是更好的个体"）、以及一个数据存储系统（用于"记住谁更好，下一轮继续"）。

### 2.2 自身对照实验设计

v4.0引入了"自身对照实验"（Self-Controlled Experiment），这是本系统实验方法论的基石。其设计动机非常务实：

问题： 如果你有两个机器人A和B，A混了10秒后脱困，B混了30秒后脱困。能说A"更好"吗？
不能。 因为它们的硬件不同（左轮偏快0.5%就可能有巨大影响）、起始位置不同、电池电量不同——这些差异不是"进化"的结果，而是"物理偏差"的结果。
解决方案： 不做A vs B的比较，而是做"每个个体自身的混沌前 vs 混沌后"的比较。以混沌触发时刻为分界线，将每个个体的生命周期切为"基线组"（混沌前）和"实验组"（混沌后）。因为同一个体的基线组和实验组使用完全相同的硬件，硬件偏差在差分时自动抵消。

实现这一设计的关键变量：

变量 | 含义 | 记录时机
baselineFrameCount | 混沌触发前，该个体正常运行的帧数 | 混沌触发时刻快照
baselineDistanceTicks | 混沌触发前，该个体编码器累计行程 | 混沌触发时刻快照
chaosFrameCount | 混沌期间运行的帧数 | 混沌持续期间的逐帧累加
chaosTriggerCount | 该个体累计触发混沌的次数 | 每次进入混沌时递增

v9.10的重大发现： baselineDistanceTicks 变量在代码中定义了，但从未被真正赋值——它一直停留在初始值0。这意味着自有代码历史以来，自身对照实验的"基线行程"数据是完全缺失的。这个Bug只有在进行系统性依赖链路审计时才会被发现。它表明：你的实验设计再精巧，如果没有对数据管道做端到端的赋值路径验证，关键数据可能从未存在。

### 2.3 经典GA基线（v7.3）

v7.3实现了一个标准的经典遗传算法作为"学习走路"的基线。如果你之前在计算机上做过GA实验，这里的主要区别是：适应度评估发生在真实的物理世界中，而不是在仿真中。这带来了三个你必须在设计中考虑的问题：

#### 个体死亡率

计算机GA中每个个体都"活完"评估周期。但在物理世界中，个体可能死在墙角（耗光电）、死在桌腿缝里（物理卡死无法脱困）、电池没电。你必须设计超时终止和死亡处理机制。

#### 测试时间成本

计算机GA每代几毫秒，物理GA每代几分钟到几十分钟。种群大小=5，每代60秒测试时间+通信开销，一代约6-8分钟。100代大约需要10-13小时——这不是你能"看着"的实验。

#### 环境不可控

光照条件变？红外传感器读数漂移。地毯皱了？摩擦力变化。这类环境变量在计算机仿真中不存在，在物理实验中却是常态。自身对照实验的设计正是为了应对这一点。

#### 技术决策树：GA参数的选择依据

① 种群大小 = 5: 非标准选择（通常≥20）。选择5的原因是时间预算——20个体×60秒=20分钟/代，实验将不可接受地慢。5个体×60秒=5分钟/代，100代≈8小时，可接受。

② 测试时长 = 60秒: 平衡"足够发生卡死"和"单代总时间可控"。如果你的环境更大/更复杂，可能需要延长。

③ 突变率 = 0.2: 高突变率（相对于典型的0.01-0.05）。因为种群小、多样性容易丧失，需要高突变维持探索。

### 2.4 数据存储子系统

第二阶段需要搭建数据存储的基础设施。你可能认为这是"最后才做的事"，但实际上数据存储的设计决定了你能从实验中获得什么信息——一个没有完善存储系统的实验等于没做实验。

#### 存储介质选择：SPIFFS

ESP32有约3MB的SPIFFS可用空间。你不需要SD卡——SPIFFS足够存储数代进化数据，而且没有额外的接线和功耗。但SPIFFS有一个关键特性：它不是事务性文件系统。如果写入中途断电或复位，文件可能损坏。这就是为什么后续版本中引入了原子写入策略。

#### 基本数据结构

结构 | 典型大小 | 存储内容
个体基因文件 | ~500B | 行为表规则集 + 物理参数（v9.11后）
行为描述符 | ~48B (12×4B) | 12维浮点数向量
帧日志（每个体） | ~5KB (256帧×20B) | 逐帧状态快照
种群文件 | ~5KB | 当前一代所有个体数据

#### SPIFFS容量预算

基于上述数据结构，你可以做一个简单的存储预算：每个个体约67KB，一代5个体约335KB，SPIFFS 1.5MB可用空间约可存4.5代数据。你需要设计一个淘汰策略——在空间不足时，决定覆盖哪些老数据。

### 2.5 第二阶段自检清单

经典GA能完整运行一代：5个个体依次测试、记录数据、选择、交叉、变异

自身对照实验的两个关键变量（baselineFrameCount、chaosFrameCount）在混沌触发时正确记录

baselineDistanceTicks在混沌触发前确实被赋值（非0）。这是v9.10才修复的Bug——你从一开始就应该做对

数据能正确写入SPIFFS，重启后能正确读取（验证持久化不是"看起来写了"）

连续运行至少3代，确认每代数据不互相覆盖、不丢失

## 第三阶段：范式转变与涌现重构

时间跨度：v8.0 → v9.11 · 约占总工作量 35%

核心目标：从"经典GA优化"转向"开放式进化"，让行为不再由程序员预设，而是由物理结构+新奇度搜索在代际迭代中涌现。这是整个项目中最深刻、最复杂的一个阶段。

### 3.1 阶段动机：为什么经典GA不够？

v7.3的经典GA可以工作——它确实能让机器人"避障"（通过最大化生存时间）。但问题在于：最大化生存时间的策略几乎肯定是"躲在一个安全角落不动"。GA收敛到了最无聊的策略上，因为它被要求优化一个错误的指标。v8.0的回答是：不要问"谁更好"，要问"谁更新"。

### 3.2 v8.0：三维范式转变

v8.0在三个维度上同时完成了范式转变——这不是三个独立的修改，而是同一个哲学前提在不同维度的表达：

#### 维度一：新奇度搜索

替代： 适应度最大化 → 新奇度最大化
机制： 维护一个NoveltyArchive（容量200），记录所有个体的12维行为描述符。新个体的新奇度 = 其行为向量与档案中K=5最近邻的平均距离。
参数： K=5, 档案容量=200, 12维行为描述符

#### 维度二：可变长度行为表基因

替代： 固定基因 → 可变长度基因
机制： 每个个体携带2~16条IF-THEN规则，规则数量本身可进化。变异操作包括增删规则。
含义： 基因长度不是设计选择，而是进化结果。

#### 维度三：物理结构承担计算

替代： 代码控制 → 物理涌现
机制： 行为表不再描述"动作序列"，只描述"触发条件→施加PWM"。PWM施加后物理系统的动力学响应是计算。
配套： 脉冲式控制 + 物理终止条件 + 噪声连续调制

### 3.3 12维行为描述符的设计

行为描述符是连接"物理行为"和"进化选择"的桥梁。它的12个维度不是随意选择的——每个维度都对应一种特定的物理行为模式：

维度 | 含义 | 反映什么物理行为
totalDistance | 总行程（编码器累计） | 活跃度——爱动的个体vs爱停的个体
avgSpeed | 平均速度 | 运动风格——快冲vs慢走
leftTurnBias | 左转倾向 | 方向偏好——总是左转的个体会被发现
rightTurnBias | 右转倾向 | 方向偏好——总是右转的个体也会被发现
stuckCount | 卡死次数 | 鲁棒性——但"从不卡死"可能意味着从不探索复杂地形
chaosDuration | 混沌总时长 | 依赖混沌的程度——频繁混沌暗示策略脆弱
sensorLeftAvg | 左传感器平均读数 | 传感器使用模式——靠左走vs靠右走
sensorRightAvg | 右传感器平均读数 | 传感器使用模式
... | 等其余4个维度

为什么是12维？ 太少（如3维）不足以区分不同行为策略——所有个体看起来都差不多。太多（如50维）会导致"维度灾难"——稀疏空间中新奇度计算失去意义。12维是在"区分度"和"稀疏性"之间的经验平衡点。

### 3.4 v9.11物理涌现重构：七个Phase的详细操作

v9.11完成了本系统最深层的重构——将11个关键物理参数从硬编码常量（#define）移到基因结构体中。这意味着这些参数不再由程序员设定，而是由进化决定。以下是七个Phase的操作指南：

Phase | 具体操作 | 验证方法
Phase 1 | 在基因结构体中添加11个物理参数字段：obstacleThreshold（障碍检测阈值）、encoderDiffThreshold（卡死检测编码器差值阈值）、chaosNoiseAmplifier（混沌噪声放大倍数）、chaosDurationMin/Max（混沌持续时间范围）、stuckDetectFrames（卡死检测帧数）等。从#define中删除这些常量。 | 编译通过；原#define引用全部报错→确认已被替换
Phase 2 | 实现syncGeneParams()函数：每帧从基因结构体中将11个参数复制到MotorController运行实例中。 | 在串口打印每帧的参数值，确认基因值确实被同步
Phase 3 | 从基因条件枚举中移除COND_STUCK和COND_ESCAPE。这两种条件原本是程序员预设的"脱困策略"——属于"代码在决策"而非"物理在涌现"。 | 检查evaluateRule()中不再有这两个条件的处理路径
Phase 4 | 控制器中所有使用原#define常量的位置，改为读取基因参数。 | 逐一核对原#define的每个引用点是否已被替换
Phase 5 | 修改种群初始化：完全随机生成初始种群的基因（包括11个物理参数的范围内的随机值），不预设任何"聪明"的初始行为。 | 观察初始代的行为——它们应该看起来"很笨"
Phase 6 | 移除PHYSICS_STALL_FRAMES和PHYSICS_MAX_ACTION_MS两个固定值——物理终止条件（多少帧无变化算堵转、单动作最大持续多久）也移入基因。 | 验证不同个体的这些参数不同
Phase 7 | 进行涌现审计：审查系统中所有决策点，分类为"纯涌现""混合""已移除""剩余植入"。审计工具：遍历所有if/else分支，判断每个分支的条件是否来自基因参数。 | 生成审计报告：3个纯涌现点+8个混合点+7个已移除+10个剩余植入点

Phase 7涌现审计的方法论意义 审计结论不是"消除所有植入点"——有些植入点是结构性的（如行为表规则格式本身、种群大小5）。正确的结论是："标记所有植入点，为每一个评估消除的可行性，对不可消除的明确其方法论含义。" 10个剩余植入点（I-01~I-10）的完整列表详见日志文件log.ino的v9.11审计记录。

### 3.5 v9.13混沌反馈进化

v9.13完成了"向死而生"哲学的最后一环——让混沌中发现的脱困行为变成可遗传的基因规则。在此之前，混沌只是"帮助个体活下来"；在此之后，混沌中发现的策略可以在种群中传播。

实现步骤：

Step 1: 快照收集

混沌期间，每T帧收集一个ChaosSnapshotEntry（7字节）：sensorLeft, sensorRight, leftPWM, rightPWM, duration。存储于RAM中。

Step 2: 条件反推

从快照的传感器读数反推匹配条件。例如：左红外>阈值→COND_SENSOR_LEFT。关键是使用基因中的阈值参数，而非全局常量。

Step 3: 基因注入

将反推的条件+动作编码为行为表规则，注入当前个体的基因。规则数达到上限(16)时替换新奇度最低的已有规则。

Step 4: 交叉继承

在交叉操作中，标记为chaosRule=1的规则与父本规则平等参与交换，可传递给子代。

混沌反馈进化的核心论证 如果某个混沌中发现的脱困行为（如"后退+右转"）在物理世界中反复有效，它会被编码为基因规则→通过交叉在种群中传播→后代不再需要依赖混沌来执行同样的脱困。这意味着混沌频率应该代际衰减——这是论文提出的三个可证伪条件之一。

### 3.6 第三阶段自检清单

新奇度档案能正常运作：新个体的新奇度分数正确计算，档案不超过200条

可变长度基因正确运作：2~16条规则，增删变异能改变规则数量

11个基因物理参数在每帧被正确同步到控制器（验证方法：在串口打印参数值确认变化）

初始种群行为看起来"笨"——不应该有任何预设的聪明策略

混沌快照被正确收集和存储（v9.13后）

连续运行≥20代，确认行为多样性没有崩溃（行为描述符种类持续增长或至少不萎缩）

## 第四阶段：审计与可靠性收敛

时间跨度：v9.10 → v9.15 · 约占总工作量 20%

核心目标：从"能跑"到"可证明"——通过系统性依赖链路审计，确保从物理现象到实验结论的每一条数据链路都完整、正确、可追溯。

### 4.1 阶段动机：在"看起来能跑"和"真的对"之间

前三阶段结束后，你的机器人可以自主进化。但你能回答以下问题吗？

- 自身对照实验的基线数据（混沌前的baselineDistanceTicks）是否真的被记录了？
- SPIFFS中的数据在写入中断后是否完整可读？
- 不同文件之间的版本号是否一致——有没有某个文件还在用旧格式？
- 混沌帧和非混沌帧在数据文件中是否能被区分？

如果任何一个问题的答案是"不确定"，你的实验结论就缺乏经验基础。第四阶段的工作就是系统性地回答这些问题，并修复所有发现的问题。

### 4.2 审计的四个维度

依赖链路审计不是一次性的"代码审查"——它是一个持续的方法论实践。本项目经历了四次审计，分别关注不同的维度：

审计 | 版本 | 焦点 | 发现问题数
系统审计 | v9.10 | 所有数据链路的完整性——从硬件中断到SPIFFS写入 | 15个（C01-C03, H01-H04, M01-M04, L01-L03）
涌现审计 | v9.11 | 系统中每个决策点是否由物理涌现决定 | 18个决策点分类+10个剩余植入点
数据管道审计 | v9.11 | 7个数据流动阶段的转换正确性 | 两个管道完整性95%，一个管道存在截断风险
存储审计 | v9.14-v9.15 | 数据在存储介质上的物理语义保留 | 9个（R1-R9）

### 4.3 v9.10系统审计：最重要的六个修复

编号 | 问题 | 修复 | 方法论教训
C01 | 环形缓冲区溢出：frameLogCount可能超过缓冲区容量 | 添加frameLogCount上限检查和截断 | 缓冲区边界检查不是可选的防御——它是结构性的必需
C02 | 差分压缩参考值使用了错误的类型（CompressedFrameEntry而非FrameLogEntry） | 修正prev变量的类型 | 类型系统的"隐式转换"在嵌入式场景中几乎是Bug的同义词
H01 | baselineDistanceTicks从未被赋值 | 在混沌触发前添加距离快照 | 核心实验变量的赋值路径必须端到端追踪
H02 | atomicWrite采用"先删后改"策略 | 改为"写临时文件→验证大小→rename" | "原子"在文件系统中的精确定义：不存在双丢失窗口
H03 | CRC校验码在数据写入前计算 | CRC计算移到数据写入完成后 | 校验码保护的是"刚写下去的数据"，而非"将要写的数据"
H04 | 部分基因文件版本号0x0004，部分0x0005 | 统一为0x0005（后升级到0x0006） | 版本号变更必须是事务性的——要么全改，要么全不改

### 4.4 原子写入的正确实现

v9.10 Fix#H02的修复是本阶段最重要的方法论收获。在嵌入式文件系统中，"原子写入"有一个精确的工程定义，而这个定义与直觉相反：

// ❌ 错误：直觉上的"原子"（先删后写）
SPIFFS.remove("/data.dat"); // 旧数据已删除
File f = SPIFFS.open("/data.dat", "w");
f.write(newData); // 如果在这里断电→新旧数据都丢失！
f.close();

// ✅ 正确：工程上的"原子"（写临时→验证→重命名）
File tmp = SPIFFS.open("/data.tmp", "w");
tmp.write(newData);
tmp.close(); // 确保flush到闪存
if (SPIFFS.exists("/data.tmp") &&
getFileSize("/data.tmp") >= MIN_EXPECTED_SIZE) {
SPIFFS.remove("/data.dat"); // 现在才删除旧文件是安全的
SPIFFS.rename("/data.tmp", "/data.dat");
}
// 任何时刻断电：要么旧数据完好（重命名之前），要么新数据就位（重命名之后）
// 不存在"双丢失"窗口

### 4.5 v9.14-v9.15存储审计（R1-R9）

存储审计的9个修复代表了审计的最高维度——不再只关心"数据正确"，而是关心"物理语义在存储介质上是否被完整保留"：

编号 | 修复内容 | 为什么重要
R1 | chaosSnapshots持久化到SPIFFS | 混沌快照是"可遗传的物理经验"，不是调试信息
R2 | inferRule使用基因阈值而非全局常量 | 规则推断的参数化程度决定了规则的"进化兼容性"
R3 | CSV输出中添加chaosRule标记位 | 数据格式的每个字段都是某个物理事实的符号对应物
R5 | 引入excludeChaosFrames参数 | 混沌帧与行为表帧在分析时需要战略区分
R6 | 交叉操作中保留chaosRule标记 | 混沌生成规则的"遗传身份"必须逐代传递
R7 | FrameLogEntry中添加isChaosFrame位 | 帧级混沌标记→离线可重建完整混沌时间线
R8 | 文件头版本统一 | 跨文件版本不一致可导致解析失败

### 4.6 如何进行你自己的审计

以下是你可以在自己的项目中使用的审计流程：

依赖链路审计标准化流程
Step 1 —— 绘制数据流图：从硬件中断到文件写入，标出每一个变量的产生、转换、存储节点。
Step 2 —— 逐节点追踪赋值路径：对每个关键变量，在代码中搜索所有赋值语句，确认赋值确实发生。
Step 3 —— 验证类型一致性：每个"A的输出= B的输入"的数据流，验证两端类型完全一致。
Step 4 —— 测试存储完整性：模拟写入中途断电（手动复位），重启后验证数据是否完整。
Step 5 —— 生成审计报告：列出所有发现的问题，标注优先级和影响范围。

### 4.7 第四阶段自检清单

所有关键实验变量（baselineDistanceTicks, chaosFrameCount等）都有完整的端到端赋值路径

原子写入策略正确实现：写入中途断电后数据不丢失、不损坏

所有数据文件的FILE_VERSION一致

CRC32校验码保护的是"刚写入的数据"，不是"写入前的数据"

混沌帧和非混沌帧在数据文件中可被区分（isChaosFrame标记位）

已完成涌现审计：你知道系统中哪些决策是涌现的、哪些是预设的

## 附录A：物料清单（BOM）

# | 组件 | 规格 | 数量 | 预估单价 | 关键注意事项

1 | ESP32 Dev Module | 双核Xtensa LX6, 4MB Flash | 1 | ¥25-40 | 必须确认支持SPIFFS；不同开发板的GPIO编号可能不同
2 | 电机驱动模块 | TB6612FNG（推荐） | 1 | ¥8-15 | TB6612支持3.3V逻辑，L298N需要5V逻辑需电平转换
3 | 直流减速电机 | | 2 | | [留白] 型号和参数待补充
4 | 正交编码器 | AB相，每圈≥20脉冲 | 2 | | [留白] 具体型号和安装方式待补充
5 | 红外传感器模块 | TCRT5000模拟输出 | 2 | ¥3-5 | 模拟输出比数字输出提供更多信息
6 | 轮子 | 直径≥60mm | 2 | ¥5-10 | 需适配电机轴径；过小的轮子抓地力差
7 | 万向轮 | 小型球式/旋转式 | 1-2 | ¥3-8 | 底盘支撑用
8 | 底板 | | 1 | | [留白] 材质、尺寸、加工方式待补充
9 | 锂电池 | 2S(7.4V)或3S(11.1V) | 1 | | [留白] 容量和放电倍率待补充
10 | 降压模块 | LM2596, 5V/3A输出 | 1 | ¥5-10 | 将电池电压降至ESP32可接受的5V
11 | 面包板/杜邦线 | 公母各若干 | 若干 | ¥10-20 | 初期调试用；最终版本建议焊接
12 | 状态LED | 5mm红色/蓝色 | 1 | ¥1 | + 220Ω限流电阻

[留白：需要线下补充的BOM项]

以下信息在你的搭建过程中需要补全：
① 电机的具体品牌/型号、额定电压、空载转速(rpm)、堵转扭矩、轴径；
② 编码器的品牌/型号、每圈脉冲数、安装方式（轴装还是轮装）；
③ 底板的材质（亚克力/铝合金/3D打印）、精确尺寸、是否有图纸；
④ 电池的容量(mAh)、放电倍率(C数)、实际续航时间；
⑤ 各物料的实际购买来源和单价（方便其他搭建者采购）。

## 附录B：常见故障排查表

以下故障排查表基于本项目实际遇到的Bug和修复经验。当你的搭建过程中遇到问题时，按"症状→可能根因→修复方法"的顺序排查。

症状 | 最可能的原因（按概率排序） | 修复方法
机器人前进时严重偏向一侧 | ① "慢"的那侧电机方向反了 ② 电机接线松动 ③ 增益补偿不够 | ① 抬起机器人，单独驱动该电机确认方向 ② 检查并加固接线 ③ 增大该侧的增益补偿
GPIO1噪声源读数始终为0或异常稳定 | ① GPIO1被其他外设占用或接了东西 ② GPIO1与Flash/PSRAM共用（不同型号板） ③ ADC配置错误 | ① 确保GPIO1完全悬空 ② 换用GPIO35或查阅你的板的IO_MUX ③ 检查analogRead调用是否正确
SPIFFS数据每次重启后丢失 | FORMAT_SPIFFS_ON_BOOT被设为1（v9.10 Fix#C03） | 将该宏改为0。这是调试配置，绝不能留在生产代码中
编码器读数出现4294967xxx等巨大数字 | uint32_t类型存储了负数差值（下溢） | 将所有编码器差值变量改为int32_t类型
混沌模式无法退出，一直随机运动 | ① 编码器未正确连接 ② 卡死恢复阈值（差值>5）太高 ③ 编码器方向不一致导致读数相互抵消 | ① 验证编码器接线，在串口打印编码器计数 ② 降低恢复阈值到3或2 ③ 检查编码器方向逻辑（左右方向判断不同）
SPIFFS写入后文件大小为0或异常小 | ① 写入后未调用close()或flush() ② 写入中途ESP32复位 ③ SPIFFS空间不足 | ① 确保所有File对象在写入后close() ② 实现原子写入策略 ③ 实现RollingStorage淘汰机制
进化实验中所有个体行为趋同（多样性崩溃） | ① 新奇度档案已满且淘汰策略不合理 ② K值（近邻数）太小 ③ 变异率太低 | ① 检查NoveltyArchive容量和淘汰逻辑 ② 增大K（如5→10） ③ 增大变异率（如0.2→0.3）
电机低速命令下不转动 | 死区效应：PWM值低于电机启动所需的最小占空比 | 实现死区补偿：低于阈值时自动抬升到阈值

[留白：需要你在搭建过程中补充的故障记录]

建议你在搭建过程中维护自己的故障日志，格式：日期 | 症状 | 排查过程 | 根因 | 修复方案 | 是否引入新问题。这将帮助后续的搭建者。

## 附录C：阶段自检清单汇总

使用说明： 完成每个阶段后逐项检查。所有项打勾前不要进入下一阶段。如果你跳过某个阶段直接进入下一阶段，你将在后续阶段中花费成倍的时间来调试被跳过的项目所覆盖的问题。

#### 第一阶段自检（物理基线）

电机正反转正确，增益补偿使左右基本平衡

红外传感器正确区分有障/无障

编码器读数正常工作

GPIO1悬空ADC读数显著波动

卡死→混沌自动触发，脱困→混沌自动退出

#### 第二阶段自检（进化底板）

GA完整运行一代（测试→选择→交叉→变异）

自身对照实验变量正确记录（特别是baselineDistanceTicks非0）

SPIFFS读写正确，重启后数据不丢失

连续运行≥3代数据不互相覆盖

#### 第三阶段自检（涌现重构）

新奇度档案正常运作

可变长度基因增删变异生效

11个基因参数每帧同步到控制器

混沌快照被正确收集

≥20代后行为多样性未崩溃

#### 第四阶段自检（可靠性收敛）

所有关键变量有完整赋值路径

原子写入中途断电不丢数据

所有文件版本号一致

CRC校验码保护正确数据

混沌/非混沌帧可区分

已完成涌现审计

## 后记：从"搭出来"到"证明它"

如果你完成了上述四个阶段，你手头就有了一个能自主进化避障行为的双轮机器人。但"搭出来"只是第一步——接下来的问题是"证明它真的在工作"。

三个可证伪条件（来自论文第五章）
① 新奇度档案饱和度： 如果进化在产生真正的新行为，档案应该持续增长——如果它在200条之前就停滞了，说明进化没有产生任何新东西。
② 行为多样性指数： 种群中不同行为描述符的数量应该随着代数增加或至少维持——如果它下降，说明进化收敛到了一个局部最优。
③ 混沌频率代际衰减： 如果混沌反馈进化在生效，后代应该比前代更少触发混沌——因为有效的脱困策略已在基因中编码。

这三个条件是可证伪的——如果你的实验数据与它们不一致，说明你的系统没有按照预期工作。这比"机器人看起来在避障"强得多，因为"看起来"不是科学证据。

本手册与配套文档的关系
如果你需要理解每个决策背后的理论依据，请参考《"物理结构即算法"驱动的具身智能体构建方法论》（methodology-report.html）。
如果你需要查阅完整的函数索引和依赖关系，请参考《函数编号与依赖关系定义文档》。
如果你需要理解论文的学术框架和四层架构，请参考论文中期底稿和结构分析文档。

— 手册完 —

## 数据来源

1. 仿草履虫应激机制的小车避障进化验证系统设计与实现（论文中期底稿，2026年8月）。 用户上传论文文档
2. log.ino + OEETestLOG_Integrated.ino + OEETestLOG v2.ino — 三个版本演进日志文件，覆盖v2.0~v9.15全版本历史。 用户上传代码文件
3. 函数编号与依赖关系定义文档 — 220个函数索引、六层架构归类、四大核心调用链路。 用户上传文档
4. Hardware Analysis.html + 电路图.html — 硬件平台逆向复原报告和引脚接线图。 用户上传文档
5. 论文结构图、论文-软件映射、软件架构图 — 22个概念节点×14个软件类的结构分析文档。 用户上传文档

本搭建手册基于用户提供的论文、代码、日志、硬件分析和结构分析文件综合撰写。所有代码引用以最终版本 OEETestFinal_v9919_Final_v2.ino 为基准。
标记为"[留白]"的部分需要搭建者根据实际使用的硬件自行补全。
