xavercai/PICAR/智能体构建方法论.docx

# "物理结构即算法"驱动的具身智能体构建方法论

# "物理结构即算法"驱动的具身智能体构建方法论

基于仿草履虫应激机制的开放式进化机器人系统的工程实践与方法论重构

2026年8月 · 方法论文档 · 与其学术论文互补

## 目录

1. 引言：从论文框架到方法论重构
2. 第一章 哲学前提
3. 第二章 硬件规划、演进、约束与赋能
4. 第三章 软件与硬件的关系
5. 第四章 哲学前提对软件构建的推动
6. 第五章 实验可验证性
7. 第六章 依赖链路审计作为构建总监理
8. 结语：从平台搭建到大规模验证的方法论路线图

## 引言：从论文框架到方法论重构

论文《仿草履虫应激机制的小车避障进化验证系统设计与实现》提供了一个完整的学术证明：它从草履虫的物理应激机制出发，论证了"物理结构即算法"这一核心命题，并搭建了一个可运行的开放式进化验证平台。该论文的六章结构——绪论、仿生控制理论基础与系统定义、硬件设计、软件设计、实验验证、总结与展望——构成了一个经典工程论文的完整闭环。

然而，方法论文档的任务与论文不同。论文关心的是"我们做了什么、为什么正确"，而方法论文档关心的是"我们如何做到、如何重复做到、如何让其他人也能做到"。论文是"证明"，方法论是"指南"。两者互补：论文定义了四层架构（物理层→具身算法层→元算法层→实验基础设施层），包含22个核心概念节点（P1-P4, E1-E6, M1-M6, X1-X6）；方法论文档则以这四层架构为骨架，填充论文无法容纳的工程演进细节。

方法论的核心论证 一个成功的具身智能体系统的构建，不是"先有理论再有实践"的线性推进，而是在哲学前提→硬件约束→软件架构→实验验证→依赖审计的五维闭环中螺旋上升。每一轮迭代都同时涉及这五个维度的调整；遗漏任何一个维度，闭环就会断裂。

4

架构层次（物理→具身→元算法→实验）

22

核心概念节点

220+

函数，六层代码归类

19

主要版本迭代（v2.0→v9.15）

方法论文档的主要素材来源包括：论文中期底稿（学术框架）、三个版本演进日志文件（集成版+两个未归档详细版）、函数编号与依赖关系定义文档（220函数索引+四大核心调用链路）、硬件复原报告与电路图、以及论文结构分析与软件架构映射文档。这些素材共同构成了从"学术概念"到"代码实现"的完整证据链。

## 第一章 哲学前提

构建一个具身智能体，首先需要回答一个本体论问题：计算发生在哪里？ 传统AI的回答是"计算发生在神经网络权重中"或"计算发生在规则引擎中"——计算与物理世界是分离的。然而，当我们将这个前提推到一个四轮机器人的极限场景——一个资源极度受限、必须与物理世界实时交互的系统中——传统答案开始失效。

### 1.1 线性代数三重预设的批判

论文第一章第五节提出了对当前自动驾驶技术范式的三个批判性预设[1]：

#### 预设一：多维独立变量构成状态空间（本体论预设）

线性代数将任何空间的维度视为相互独立的基底——这意味着变量之间不存在结构耦合。但在物理系统中，电机转速与传感器读数是时序耦合的，不是可独立枚举的基底。

#### 预设二：矩阵乘法构成映射（关系论预设）

神经网络的核心计算是矩阵乘法——这是一种将高维空间映射到低维空间的操作。但物理系统中的因果关系不是映射，而是时序耦合。

#### 预设三：结果依赖训练函数而非结构本身（认识论预设）

神经网络的性能取决于训练数据和损失函数，而非其架构的物理对应物。这意味着"能力"是从外部注入的，而非从结构内部涌现的。

这三个预设共同构成了一种"计算与物理分离"的世界观。而本项目的方法论起点恰恰是对这组预设的倒转：如果把计算"还"给物理结构本身，会怎样？

### 1.2 "物理结构即算法"的四层本体论框架

论文第二章提出了核心概念定义[1]："物理结构即算法"（Physical Structure as Algorithm）是一种智能体构建哲学，它主张物理结构本身不是算法的被动执行媒介，而是直接参与计算——物理结构的非线性、物理随机性、动力学耦合本身就是算法的一部分。为完整描述这一框架，论文定义了四层架构：

物理层

硬件拓扑作为计算基底：差速驱动底盘、红外传感器、正交编码器、物理噪声源（GPIO1浮空ADC）。这一层不是"执行算法"的硬件，而是本身就在计算。

具身算法层

物理结构的计算能力被"读取"：行为表规则引擎、物理终止条件、噪声连续调制、脉冲式控制、混沌注入器。这一层不是"控制"，而是翻译——将物理正在做的事翻译为可操作、可记录的符号。

元算法层

慢时间尺度上的搜索：新奇度驱动进化、12维行为描述符、可变长度行为表基因、10种变异操作。这一层不直接参与物理交互，而是在代际尺度上"挑选"物理结构。

实验基础设施层

方法论保障：自身对照实验设计、逐帧数据采集、可证伪条件、数据持久化、依赖链路审计。这一层确保前三层的所有操作可观测、可验证、可复现。

这四个层次不是简单的抽象堆叠。它们之间存在严格的时序约束：物理层以微秒级运行，具身算法层以毫秒级（每帧10ms），元算法层以分钟级（单次测试60秒），实验基础设施层以小时/天级（一代进化数小时）。这种时序分层本身就是方法论的核心——它确保了"快时间尺度上的探索"与"慢时间尺度上的选择"不会相互干扰。

### 1.3 "向死而生"：混沌作为相变催化剂

在传统机器人编程中，"卡死"是一个需要被"处理"的异常——代码检测到卡死后，执行一个预设的脱困程序。但在本项目中，"向死而生"（Embrace Death to Live）被确立为核心哲学前提[2]：卡死不是需要修复的Bug，而是物理结构获得自主探索权的契机。

该概念在v2.0中首次确立[3]：当机器人检测到卡死状态时，系统不执行任何代码设计的脱困策略，而是将电机控制权完全移交给物理噪声源——GPIO1浮空ADC读取的环境电磁噪声和半导体热噪声被放大后直接驱动左右电机。这意味着代码在混沌期间完全退场，物理世界成为唯一决策者。其方法论含义是深远的：

代码退场哲学的核心论点 混沌不是"代码设计的逃生机制"，而是物理结构在绝境中的自我救赎。在混沌期间，代码不决策——GPIO1热噪声直接驱动电机，物理世界自主探索。如果物理结构能够通过噪声驱动的随机运动找到脱困路径，说明物理结构本身具备计算能力——而这种能力无法被任何预编码的算法替代，因为它依赖于物理世界在那一特定时刻的具体状态。

从方法论角度看，"向死而生"定义了三个层次的技术退场[4]：

#### 第一层：代码退场

- 混沌期间，不执行行为表规则匹配
- 不执行任何方向性运动决策
- 电机控制直接来自GPIO1噪声读数
- CHAOS_NOISE_AMPLIFIER = 180 控制噪声放大倍数

#### 第二层：算法退场

- 混沌期间的行为不能被行为表基因编码
- 但混沌中"发现"的脱困行为可以被后续版本通过混沌快照机制转化为可遗传基因规则（v9.13混沌反馈进化）

第三层：进化退场 当物理结构通过混沌探索发现了稳定的脱困模式，且该模式被编码为可遗传的基因规则后，该个体在进化竞争中将自然地淘汰那些需要频繁依赖混沌的同代个体。这意味着进化本身在"退场"——它不再需要主动搜索，而是让物理效率说话。

### 1.4 物理噪声的本体论地位

在上述哲学前提下，物理噪声不是一个工程缺陷，而是在本体论上具有独立地位的"计算资源"。它与PRNG（伪随机数生成器）的区别不仅仅是"真随机vs伪随机"——它们的区别在于谁拥有计算权：

维度 | PRNG（伪随机数生成器） | GPIO1物理噪声（热噪声ADC）
本体论地位 | 确定性算法的输出，由CPU执行 | 物理世界的直接取样，不由CPU生成
计算权归属 | 软件拥有计算权，PRNG是工具 | 物理结构拥有计算权，ADC是接口
时间依赖性 | 同一种子产生相同序列（可复现） | 每一时刻的读数都与该时刻的物理状态耦合（不可复现）
在系统中的作用 | 随机种子初始化（randomSeed） | 混沌驱动（CHAOS_NOISE_AMPLIFIER）
历史教训 | 无需演化 | GPIO6→GPIO35→GPIO1三次迁移（避开Flash/PSRAM冲突）

这种对物理噪声的本体论重新定位，在本项目的方法论框架中具有基础性地位。它不仅解释了为什么选择浮空ADC而非软件PRNG——更重要的是，它确立了一条方法论原则：在"物理结构即算法"的体系中，任何物理特性都可以被重新定位为计算资源，只要你能在代码中为它找到一个"不替代它、而是读取它"的接口。

## 第二章 硬件规划、演进、约束与赋能

如果哲学前提定义了"我们为什么这样做"，那么硬件规划定义了"我们能在什么边界内做"。本章的核心论点是：硬件约束并非需要被克服的障碍，而是塑造智能体行为的"骨架"——编码器的下溢、电机的偏航、传感器的噪声，都是进化可以利用的物理资源。

### 2.1 系统总体架构与引脚分配

系统基于ESP32 Dev Module，共使用13个GPIO引脚，构成一个完整的双轮差速驱动机器人平台[5]：

功能类别 | 引脚 | 用途 | 类型
传感器 | GPIO4 (ADC1_CH0) | 左红外避障传感器 | 模拟输入
| GPIO5 (ADC1_CH1) | 右红外避障传感器 | 模拟输入
物理噪声源 | GPIO1 (ADC1_CH0) | 浮空ADC读取热噪声 | 模拟输入
数字输入 | GPIO39 | 障碍物中断引脚 | 仅输入
状态指示 | GPIO14 | 板载状态LED | 数字输出
电机驱动 | GPIO9 | 左电机PWM | LEDC输出
| GPIO46 | 左电机方向 | 数字输出
| GPIO16 | 右电机PWM | LEDC输出
| GPIO15 | 右电机方向 | 数字输出
| GPIO21/22 | L298N ENA/ENB使能 | PWM输出
编码器 | GPIO18 | 左编码器A相 | 数字输入
| GPIO17 | 左编码器B相 | 数字输入
| GPIO11 | 右编码器A相 | 数字输入
| GPIO10 | 右编码器B相 | 数字输入

这一引脚分配不是随意确定的。从v3.x到v8.5的多次硬件适配中[3]，经历了左轮方向引脚从21→46的修正、右轮方向引脚从33→15的修正、噪声源从GPIO6（Flash冲突）→GPIO35→GPIO1的三次迁移。每一次修正都是一个方法论教训：引脚分配的"正确性"不是从数据手册中读出的，而是从实际电路板的物理行为中试出来的。

### 2.2 四个核心硬件约束及其软件应对

论文3.6节提出了硬件约束"定义"软件架构的论点。以下是四个最核心的硬件约束及其在代码中的具体映射[5]：

硬件约束 | 物理表现 | 软件应对 | 方法论教训
Flash/GPIO复用冲突 | GPIO6与ESP32内部Flash共用，噪声采样导致Flash读取异常 | 噪声源引脚三迁移：GPIO6→GPIO35→GPIO1 | 选择浮空ADC引脚时必须查阅芯片的IO_MUX表，避开与Flash/PSRAM复用的GPIO
电机不对称性 | 左右电机相同PWM值下转速差异显著；前进后退效率不同 | 分方向增益补偿：LEFT_FWD_GAIN=1.00, LEFT_REV_GAIN=1.30, RIGHT_FWD_GAIN=1.30, RIGHT_REV_GAIN=1.30；死区补偿（左35/右20） | 电机不对称不是"缺陷"，而是可以被软件体系"吸收"的已知参数——增益补偿表就是这种吸收的机制
编码器方向不一致 | 右电机物理安装方向与左电机相反，同一方向逻辑下编码器计数方向相反 | 正交解码逻辑中左右编码器方向判断条件不同：左A↑时B=HIGH→leftTicks--, 右A↑时B=HIGH→rightTicks++ | 编码器的"正向"不由逻辑定义，而由物理安装决定——软件必须适应这一点，而非试图"修正"物理
uint32_t下溢陷阱 | v8.6.4中编码器距离差用uint32_t计算，负差导致下溢为4294967257等数据 | 统一改用int32_t存储编码器差值 | 数据类型选择是硬件约束的直接映射——unsigned类型在物理世界中几乎没有对应物，因为物理量天然可正可负

### 2.3 电机调校实证记录（v3.3~v3.4.5）

来自日志文件中的一段详细记录[2]，展示了硬件调校不是一个"一次性校准"过程，而是一个反复试错的经验收敛过程：

版本 | 调校措施 | 效果 | 方法论含义
v3.3 | 左轮速度补偿+30 | 左轮仍明显慢于右轮 | 初始补偿不足
v3.3.1 | 左轮速度补偿增至+70 | 左轮加速过度 | 补偿超调
v3.3.2 | 发现左轮方向反转问题 | 正向运动时左电机实际反转 | 方向极性错误非速度问题
v3.3.3 | 交换左电机DIR引脚极性 | 方向修正 | 硬件接线是根本原因
v3.4 | 左轮速度补偿调整为-20 | 基本平衡 | 方向修正后补偿参数需重新标定
v3.4.5 | FORWARD_BIAS从30增至120 | 爬坡/越障能力提升 | 动力参数与地形相关

方法论结论 这段调校记录揭示了硬件适配最重要的教训：软件工程师倾向于先改软件再检查硬件，但硬件调校的顺序应该是先检查物理接线，再调整补偿参数。v3.3→v3.3.2的弯路（先加速→再减速→才发现方向反了）说明：当遇到"参数调不动"的情况时，最大概率的原因不是参数值不对，而是物理假设（方向、接线、供电）不对。

### 2.4 硬件约束"定义"软件架构

论文3.6节的核心论点是[1]：在"物理结构即算法"的方法论中，硬件约束不是消极的限制，而是积极的定义——它定义了软件需要"读取"什么、软件需要"补偿"什么、软件需要"保护"什么。从代码层面看，这一论点体现在三个关键架构决策中：

第一，增益补偿体系不是可选的优化，而是结构性的必需。 setMotorSpeed()函数（F-MC-004[4]）在每一帧执行时都进行分方向增益计算：正转×前进增益、反转×前进增益×后退增益。这意味着物理不对称性被"吸收"到了软件的正常运行路径中，而非作为一个需要外部校准才能消除的"偏差"。

第二，物理随机源的选择是一个本体论决策，而非工程权衡。 从PRNG到GPIO1浮空ADC的转变，反映了"物理结构即算法"这一哲学前提在硬件层面的具体落实——声音不能从假随机中诞生。

第三，编码器的软件轮询方式（非硬件中断）是一个有意的设计选择。 每10ms轮询一次（而非使用ESP32的PCNT硬件计数器），是为了将"编码器读数"与"系统帧时钟"绑定——这是一个方法论的权衡：牺牲微秒级精度换取数据采集的时序一致性。

## 第三章 软件与硬件的关系

在传统嵌入式系统中，软件与硬件的关系是清晰的：软件"控制"硬件，硬件"执行"指令。但在"物理结构即算法"的方法论中，这种关系被倒转：物理结构承担计算，软件负责"翻译"和"记录"。本章通过分析系统的四大核心调用链路，阐明这一倒转关系的具体代码体现。

### 3.1 物理差动驱动：软硬关系的核心宣言

物理差动驱动（Physical Differential Drive）在v2.0中确立[3]，是本系统中最根本的软硬关系宣言。其核心公式简化为：

steer = left_raw_pwm - right_raw_pwm;
// 无PID、无滤波、无标定
// 物理系统自行吸收速度差异

这一公式的含义是：软件不试图"修正"物理系统的非线性，而是将原始PWM值直接映射到转向行为——物理系统自身的惯性、摩擦力和不对称性定义了实际运动轨迹。这种"不控制"反而是最精确的控制，因为任何PID校正都会引入软件对物理的"误读"。

### 3.2 四大核心调用链路分析

函数依赖文档将系统中约220个函数归类为六层架构，并标识出四条核心调用链路[4]——每条链路都展示了一种特定的软硬交互模式：

链路 | 函数路径 | 软硬交互特征 | 方法论含义
行动线 | loop() → runTestLoop() → evaluateRule() → setMotorSpeed() → 电机GPIO | 具身算法层→控制层→硬件。最短路径，微秒级延迟 | 行为决策到物理执行的路径必须极短，任何软件中间层都会破坏物理耦合
记录线 | loop() → updateEncoders() → logFrame() → RAMLogBuffer | 物理→软件读取→内存缓冲。每10ms触发一次 | 数据采集的时序绑定（与帧时钟对齐）比采集精度更重要
存储线 | runTestLoop() → saveIndividualData() → atomicWrite() → SPIFFS | RAM→SPIFFS。500帧触发一次增量保存 | 存储操作的I/O代价不能侵入行动线的时序约束
进化线 | finishCurrentTest() → evaluateNovelty() → selectParents() → crossover() → mutate() → savePopulation() | 测试结束后批量执行。与行动线完全时序隔离 | 进化计算不与物理交互竞争CPU——这是"快慢分离"的关键

### 3.3 物理终止条件："物理结构在计时"

在传统机器人编程中，动作时长由软件计时器控制——执行一个"前进行走2秒"。但在本系统中，动作终止不由软件计时，而由物理状态决定[1]：

#### 编码器堵转检测

物理动作执行期间，如果编码器连续10帧（100ms）无变化，判定电机堵转，自动终止当前动作。这不是"超时"终止，而是"物理事实"终止。

#### 卡死恢复检测

混沌模式下，当编码器读数连续20帧稳定变化（差值>5），判定已脱离卡死。退出的触发者是轮子实际转动的事实，而非一个预设的时间阈值。

物理终止条件的核心方法论意义在于：它消除了软件对物理世界的"时间假设"。代码不假设"前进2秒应该走多远"——它让物理结构自己"报告"动作何时结束。这种设计选择将"计时权"从软件移交给了物理结构。

### 3.4 脉冲式控制与噪声连续调制

在v8.0的范式转变中[2]，系统从逐帧平滑控制转向了脉冲式控制：行为表规则匹配后直接施加目标PWM值，不做逐帧平滑过渡。速度变化由物理系统的惯性和摩擦力自然决定。与之配套的是GPIO1噪声的连续调制——每一帧读取的噪声值通过CHAOS_NOISE_AMPLIFIER放大后，与行为表的PWM输出融合。这创造了两个层次的计算分布：

#### 脉冲式控制

软件只做"离散决策"（匹配→施加），物理系统负责"连续执行"。软件不试图模拟物理的连续性——那是物理结构自己的事。

#### 噪声连续调制

每一帧的GPIO1读数都不同，因此每一帧的PWM输出都有微小的、不可预测的偏移。这创造了物理随机源对软件决策的持续扰动——一个正在运行的物理计算过程。

### 3.5 syncGeneParams()：基因到硬件的实时参数链

v9.11物理涌现重构中引入的syncGeneParams()（F-MC-019[4]）是最能体现"软件翻译物理"的函数。它在每帧执行时，将基因中存储的11个物理参数（如obstacleThreshold、encoderDiffThreshold、chaosNoiseAmplifier等）同步到MotorController的运行实例中。这个函数的存在意味着：

参数的"所有权"属于基因（元算法层），而非代码（具身算法层） 具身算法层的代码只是"读取"基因参数并将其"翻译"为物理信号。真正决定行为的参数值，是在代际进化中通过新奇度选择"涌现"的，而非由程序员预设。这是"物理结构即算法"在软硬关系中的最终体现：连参数值都不在代码中。

## 第四章 哲学前提对软件构建的推动

第一章的哲学前提不是悬挂在空中的抽象宣言——它直接驱动了软件架构的每一个关键决策。本章通过追踪从v7.3到v9.15的代码演进，展示哲学前提如何一步步"翻译"为具体的代码结构。

### 4.1 "三去"原则在代码中的贯彻路径

论文2.2.2节总结了"三去"原则（去控制/去预测/去优化）[1]。在代码演进中，这三个原则被转化为具体的架构决策，并贯穿了整个版本历史：

"去"原则 | 传统做法 | 本系统的做法 | 代码证据
去控制 | PID控制车速，精确标定左右平衡 | 脉冲式PWM施加，增益补偿为唯一校准 | setMotorSpeed() 无PID逻辑
去预测 | 预测前方路径、规划避障轨迹 | IF-THEN规则匹配，即时传感器条件触发 | evaluateRule() 仅检查当前传感器值
去优化 | 梯度下降优化损失函数，最大化适应度 | 新奇度搜索，保持多样性而非收敛 | evaluateNovelty() 使用K近邻稀疏度

### 4.2 v8.0：三维范式转变的代码体现

v8.0是本项目历史上最重要的单次版本跃迁[2]。它在三个维度上同步完成了从"经典GA优化"到"开放式进化"的范式转变：

#### 搜索目标维度：适应度 → 新奇度

不再问"谁更好"，而问"谁更新"。NoveltyArchive类维护一个容量200的行为描述符档案，每位新个体的新奇度等于其行为向量与档案中K=5最近邻的平均距离。

#### 基因结构维度：固定长度 → 可变长度

每个个体携带2~16条IF-THEN规则，规则数量本身是一个可进化的元参数。增删规则的变异操作意味着基因长度是进化的结果，而非设计的选择。

#### 计算位置维度：代码中 → 物理中

行为表描述的是"触发条件→施加PWM"，而非"触发条件→执行动作序列"。PWM施加后，物理系统如何响应——那是物理结构在计算。

### 4.3 v9.11物理涌现重构：软件撤退的七个阶段

日志文件中对v9.11的详述[2]记录了物理涌现重构的7个Phase，这一过程堪称"软件主动撤退"的方法论教科书：

Phase | 操作 | 方法论意义
Phase 1 | 11个关键参数从#define移至基因结构体字段（obstacleThreshold, encoderDiffThreshold, chaosNoiseAmplifier等） | 参数的所有权从程序员移交进化
Phase 2 | 添加syncGeneParams()每帧从基因同步参数到控制器实例 | 建立"基因→软件→硬件"的实时参数链
Phase 3 | 移除基因条件枚举中的COND_STUCK和COND_ESCAPE | 软件脱困策略完全退场
Phase 4 | 控制器改用基因参数替代硬编码常量 | 所有行为阈值不再由程序员设定
Phase 5 | 初始种群完全随机初始化，不预设任何"聪明"行为 | 进化从零开始，不注入人类领域知识
Phase 6 | 移除PHYSICS_STALL_FRAMES和PHYSICS_MAX_ACTION_MS固定值 | 物理终止条件也移入基因
Phase 7 | 对18个决策点进行涌现审计（3纯涌现+8混合+7已移除） | 系统性地评估软件"撤退"到什么程度

在这七个阶段完成后，代码中属于"人类预设"的部分大幅缩减。这不仅仅是代码量的减少——更关键的是，剩余代码的角色从"决策者"变成了"翻译器"：它不再说"遇到障碍应该左转"，而是说"如果基因中的规则X匹配了当前传感器条件，就施加基因中规定的PWM值"。决策来自进化，进化来自物理。

### 4.4 v9.13混沌反馈进化：物理行为到可遗传基因规则的编码闭环

日志文件中保存了v9.13混沌反馈进化的完整设计文档[2]，这是"向死而生"哲学在进化层面最完整的落地。其核心问题是：混沌期间通过噪声随机运动发现的脱困行为，如何转化为可遗传的基因规则？

整个链条分为四个步骤：

Step 1: 快照收集

混沌期间收集ChaosSnapshotEntry（7字节）：发现运动方向、传感器状态、电机PWM读数、持续时间。存储于RAM中的chaosSnapshots环形缓冲。

Step 2: 条件反推

从快照的传感器状态反推匹配条件（左红外>阈值→COND_SENSOR_LEFT，右红外基因中的阈值参数而非全局常量。

Step 3: 基因注入

将反推的条件+动作编码为行为表基因规则，注入当前个体的基因中。如果规则数达到上限(16)，替换新奇度最低的已有规则。

Step 4: 交叉继承

在下一代的交叉操作中，混沌生成的规则与父本规则平等参与交换，标记chaosRule=1的规则可以被交叉传递给子代个体。

这一闭环的方法论意义在于：它打通了从"物理行为"到"可遗传信息"的完整通道。在此之前，混沌只是帮助个体"活下来"——但现在，混沌中发现的脱困策略可以在代际间传播。这是一个本体论上的跃迁：物理探索的成果获得了符号表征，符号表征通过进化在种群中传播，传播后的符号在新个体身上重新表达为物理行为。

### 4.5 "代码退场"的精确实现边界

函数依赖文档中标出了28个"物理结构即算法"核心函数[4]。通过分析这些函数的实现，可以精确界定"代码退场"的边界——代码在哪一刻停止决策，物理在哪一刻接管：

函数 | 代码的角色 | 物理的角色 | 退场时刻
evaluateRule() | 匹配条件，选择动作 | PWM施加后的运动轨迹 | PWM写入LEDC寄存器后
setMotorSpeed() | 增益补偿计算，写入方向+占空比 | 电机响应、惯性、摩擦力 | GPIO写入后
enterChaosMode() | 设置标志位，切换状态 | GPIO1噪声→PWM→运动 | 标志位设置后
exitChaosMode() | 检查编码器条件 | 编码器读数变化（轮子实际转动的事实） | 条件判断——物理事实驱动
updateEncoders() | 轮询GPIO，更新计数 | 编码器A/B相电平 | 代码从不决策，只读取

## 第五章 实验可验证性

一个方法论范式如果不能证明自己，就不是方法论。实验可验证性不是本项目的"附加功能"——它是整个四层架构的第四层（实验基础设施层），其地位与前三个层次同等。本章从数据结构设计、数据持久化、自身对照实验和可证伪条件四个子维度展开。

### 5.1 自身对照实验设计的方法论基础

自身对照实验（Self-Controlled Experiment）在v4.0中首次引入[3]，在v8.9-chaos-v6中得到完善[2]。其基本逻辑是：以混沌触发时刻为时间分界线，将每个个体的生命历程自动切分为"基线组"（混沌前）和"实验组"（混沌后），从而消除个体间硬件差异对实验结果的影响。

差分分析的自动抵消原理 因为每个个体的"基线组"和"实验组"来自同一个体、同一套硬件、同一次测试，所以硬件偏差（如左轮偏快）在两组数据中表现为相同的系统性偏移——做差分比较时自动抵消。这比传统的"对照组+实验组"设计更适用于硬件高度不对称的嵌入式实验场景。

实现这一设计的关键变量在两个日志文件中都有详细追踪。v9.10的Fix#H01是自身对照实验数据完整性的典型案例[2]：发现baselineDistanceTicks从未被累积赋值——这意味着混沌前的基线行程数据完全缺失，自身对照实验的差分分析无法执行。修复后，代码在混沌触发前记录baselineFrameCount和baselineDistanceTicks，在混沌触发后开始累积chaosFrameCount，确保两组数据都能正确采集。

### 5.2 数据结构的物理语义

系统中的每个数据结构都不是随意定义的——它们都承载着特定的物理语义，是"物理状态"在代码中的符号对应物：

数据结构 | 大小 | 关键字段 | 物理语义
FrameLogEntry | 20字节 | state:3bit (IDLE/WALKING/STUCK/CHAOS/ESCAPING), chaosActive:1bit, isChaosFrame:1bit, reserved:2bit | 每帧的状态机快照。3-bit状态字段可离线重建完整的MotorState转移序列，无需保留中间代码逻辑
ChaosSnapshotEntry | 7字节 | sensorLeft, sensorRight, leftPWM, rightPWM, duration | 混沌期间的传感器-动作配对，是v9.13混沌反馈进化的数据来源
BehaviorDescriptor | 12维向量 | totalDistance, avgSpeed, leftTurnBias, rightTurnBias, stuckCount, chaosCount等 | 个体的"行为指纹"，新奇度计算的基础。12个维度覆盖了运动学特征、传感器使用模式和生存策略
基因字段 | v9.11后11个参数 | obstacleThreshold, encoderDiffThreshold, chaosNoiseAmplifier, chaosDurationMin/Max等 | 可进化的物理参数，定义了该个体与物理世界交互的全部"预设"

FrameLogEntry.state字段的3-bit设计特别值得注意。为什么不是4个布尔flag？日志文件中的解释是[2]：用单一枚举变量替代多个布尔标志，确保了"状态机在任何时刻只处于一个确定状态"——这是对物理确定性的软件承诺。如果使用多个布尔标志，不同标志之间的竞态条件会导致未定义的中间状态，而物理世界没有"中间状态"这回事。

### 5.3 数据持久化体系

系统的数据持久化经历了从v8.7的初步SPIFFS集成到v9.8-RAMLogBuffer再到v9.15存储审计修复的多次迭代，最终形成了一个RAM+SPIFFS双轨、原子写入、CRC32校验、版本感知清理的完整体系[2]：

组件 | 机制 | 目的 | 引入版本
RAMLogBuffer | 6000帧环形缓冲，内存中保留最新数据 | 高频采集不触发I/O | v9.8-RAMLogBuffer
SPIFFS RollingStorage | 保留5代Top2个体的数据；满时覆盖最旧非Top2 | 有限存储的智能淘汰 | v9.8-RAMLogBuffer
原子写入 | 临时文件→验证大小→rename覆盖目标 | 防止写入中断导致文件损坏 | v9.9-Fixed
CRC32校验 | 数据块末尾附加CRC32哈希 | 读取时验证完整性 | v9.9-Fixed
增量保存 | 每500帧触发一次SPIFFS写盘 | 平衡采集频率与存储开销 | v9.8-RAMLogBuffer
FILE_VERSION魔数 | 文件头包含版本号（0x0005→0x0006） | 版本感知的格式兼容性 | v9.8→v9.15

日志文件中的SPIFFS容量分析[2]提供了精确的数据预算：每个个体约67KB（FrameLog 256帧 × 20B + 行为描述符12×4B + 基因数据约500B + 快照缓冲约1KB），一代种群(5个体)约335KB，SPIFFS总计约1.5MB可用空间可容纳约4代数据。这个容量预算直接驱动了RollingStorage的淘汰策略设计——在你只有5代缓冲时，必须精心选择保留哪些个体。

### 5.4 可证伪条件与"条件复现→能力复现"的方法论转换

论文第五章提出的三个可证伪条件[1]——新奇度档案饱和度（200条阈值）、种群行为多样性指数下降趋势、混沌频率代际衰减——为整个系统提供了"这个实验是否有效"的判断标准。论文第六章进一步提出了"条件复现→能力复现"的方法论转换：在物理结构即算法的框架下，实验复现不是"复现某次实验的确切结果"（因为物理噪声不可复现），而是"复现实验的条件设置"——如果条件复现了，能力的涌现应该是一致的。

从方法论实践的角度，这意味着实验文档需要记录的不仅是结果数据，还包括：硬件配置（引脚接线、电源电压、电机型号）、软件版本（FILE_VERSION魔数）、初始种群随机种子、进化代数与种群规模、以及数据持久化的完整性校验结果。

## 第六章 依赖链路审计作为构建总监理

如果前五章定义了"物理结构即算法"的构建方法论，那么本章描述的依赖链路审计就是这套方法论在工程层面的总监理——它确保方法论的每一个环节都在代码中有准确、完整的实现，且数据在各个环节之间的传递不会断裂。

### 6.1 v9.10第一次系统审计：15个修复的方法论意义

日志文件详细记录了v9.10-AuditFix的完整内容[2]——这是项目历史上第一次对所有数据链路进行系统性审计，分三轮完成，共发现15个问题：

优先级 | 编号 | 问题简述 | 影响 | 方法论教训
Critical | C01 | 环形缓冲区溢出：frameLogCount上限修正 | 内存污染，数据丢失 | 缓冲区边界检查不是可选的防御，是结构性必需
| C02 | 差分压缩参考值类型错误（prev类型CompressedFrameEntry→FrameLogEntry） | 所有压缩帧解压后数据异常 | 类型系统的"隐式转换"在嵌入式场景中几乎是Bug的同义词
| C03 | FORMAT_SPIFFS_ON_BOOT=1导致每次启动格式化 | 所有历史数据永久丢失 | 调试用的配置绝不能留在发布版本中
High | H01 | baselineDistanceTicks从未累积 | 自身对照实验的基线数据缺失 | 核心实验变量的赋值路径必须从硬件中断一直追踪到SPIFFS写入
| H02 | atomicWrite先删后改导致双文件丢失窗口 | 写入中断时新旧数据同时丢失 | 原子操作的定义不是"先删后写"，而是"写临时→验证→重命名"
| H03 | CRC校验码写入与实际数据不同步 | 校验码保护的是旧数据 | CRC计算必须在数据写入完成后进行，而非写入前
| H04 | 基因文件版本号不一致（部分文件0x0004/部分0x0005） | 跨文件数据解析出错 | 版本号的变更必须是事务性的——要么全部更新，要么全部保持
Medium | M01-M04 | Web端点数据竞态、串口命令缓冲区溢出等 | 交互层数据不一致 | 交互层与存储层的读写必须是同一事务
| Low | L01-L03 | 日志输出格式不一致、注释过期等 | 可读性下降

### 6.2 v9.11涌现审计：18个决策点的审查框架

v9.11在完成物理涌现重构后，进行了一次专门的"涌现审计"[2]——系统性地审查系统中每一个决策点，判断它是由物理结构自然决定（纯涌现）、还是由代码预设但受物理参数影响（混合）、还是完全由代码控制（已移除）。审查覆盖了18个决策点：

3

纯涌现决策点

8

混合决策点

7

已移除植入点

10

剩余植入点(I-01~I-10)

10个剩余植入点（I-01~I-10）的识别和分类尤为关键。它们包括：结构性植入（如行为表规则格式本身是一种结构性约束）、可进一步参数化的混合点（如变异率的固定范围）、以及元参数（如种群大小5）。审计的结论不是"消除所有植入点"——有些植入点是结构性的，无法消除——而是"标记所有植入点，为每一个评估其消除的可行性，并对不可消除的明示其方法论含义"。

### 6.3 v9.11数据管道审计与链路完整性评估

同一版本中还进行了数据管道审计[2]：将整个系统的数据流分解为7个阶段（T0-T7），逐阶段评估数据完整性和转换正确性。审计结果以完整性百分比表示：传感器→logFrame链路完整性95%，交叉→变异→savePopulation链路完整性95%，但帧日志→差分压缩→SPIFFS写入链路中发现了数据截断风险。

这种"以数据链路为审计单元"的方法，其方法论意义在于：在"物理结构即算法"的系统中，数据链路不仅是"记录工具"，而是整个论证体系的脊梁骨。如果链路断裂，意味着从物理现象到论文结论之间的证据链就断了——这比Bug更严重，这是方法论本身的失效。

### 6.4 v9.14-v9.15存储审计（R1-R9）

日志文件中记录了存储审计的9个修复（R1-R9）[2]，它们代表了审计的第三个维度——从"数据正确性"深入到"物理语义的完整保存"：

编号 | 修复内容 | 版本 | 方法论含义
R1 | chaosSnapshots持久化至SPIFFS | v9.14 | 混沌快照不是"调试信息"，而是可遗传的物理经验
R2 | inferRule使用基因阈值而非全局常量 | v9.14 | 规则推断的参数化程度决定了规则的"进化兼容性"
R3 | CSV中添加chaosRule标记位 | v9.14 | 数据格式的每个字段都是某个物理事实的符号对应物
R4 | FILE_VERSION 0x0005→0x0006 | v9.14 | 版本号的更新必须与schema变更同步
R5 | 引入excludeChaosFrames参数 | v9.15 | 混沌帧与行为表帧的战略区分
R6 | 交叉操作中保留chaosRule标记 | v9.15 | 混沌生成规则的"遗传身份"必须逐代传递
R7 | FrameLogEntry中添加isChaosFrame位 | v9.15 | 帧级混沌标记→离线可重建混沌vs非混沌时间线
R8 | 文件头版本统一 | v9.15 | 跨文件一致性是数据链完整性的前提
R9 | SPIFFS清理策略修复 | v9.15 | 存储淘汰不能破坏进化档案的连续性

### 6.5 审计作为方法论的必然环节

函数依赖文档的依赖矩阵[4]本身就揭示了审计的必然性：220个函数分布在六层架构中，函数间的依赖关系形成了复杂的交叉网络。当任何一个函数的输出是另一个函数的输入时，数据格式、时序约束、物理语义的一致性就必须被验证。这不是"优秀的工程实践"，而是方法论的强制性要求——因为如果数据不可信，整个"物理结构即算法"的论证就失去了经验基础。

依赖链路审计的方法论地位 在"物理结构即算法"的构建方法论中，依赖链路审计不是Bug修复的附属活动，而是方法论的第五个维度。它与哲学前提、硬件约束、软件架构、实验验证共同构成了方法论的五维闭环。审计的缺席意味着方法论的缺席——因为没有人能担保"物理结构在计算"这个断言在代码中有完整的、无断裂的实现。

### 6.6 审计发现的核心方法论原则

综合分析四次审计（v9.10-15修复/v9.11涌现审计/v9.11管道审计/v9.14-15存储审计），可以提炼出五条方法论原则：

#### 原则一：完整性追踪

任何核心实验变量的赋值路径必须从硬件中断一直追踪到SPIFFS写入。v9.10 Fix#H01（baselineDistanceTicks从未累积）是一个警示范例——核心变量没有赋值路径，意味着该维度的实验数据从未存在。

#### 原则二：原子性承诺

存储操作的事务性不是可选的"防御"，而是数据可信度的前提。v9.10 Fix#H02（atomicWrite先删后改）揭示了"原子"一词在文件系统中的精确语义：必须是不存在"双丢失窗口"的写临时→验证→重命名序列。

#### 原则三：版本同步

数据格式的版本号变更必须是跨文件的事务性操作。v9.10 Fix#H04（部分文件版本号不一致）和v9.15 Fix#R8（文件头统一）共同说明了版本号管理的精确性要求。

#### 原则四：物理语义保留

数据结构中的每一个字段都必须有明确的物理语义，且该语义在数据管道的每一阶段都不能丢失或变异。v9.15 Fix#R7（isChaosFrame位）和Fix#R2（inferRule使用基因阈值）都是物理语义在存储层面的精确保留。

## 结语：从平台搭建到大规模验证的方法论路线图

本方法论文档以论文的四层架构为阅读地图，以22个核心概念节点为索引，以版本演进日志中的实际经验为证据，重构了"物理结构即算法"驱动的具身智能体构建方法论。

### 方法论的五维闭环

经过六章的分析，可以明确方法论的五个维度及其相互关系：

哲学前提

定义"计算发生在哪里"——物理结构即算法，代码退场。这是方法论的起点，所有后续维度都从这个起点衍生。

硬件约束

定义"计算的物理边界"——硬件不是被克服的障碍，而是塑造行为的骨架。软件的任务是"读取"和"补偿"，而非"修正"。

软件架构

定义"计算如何被翻译"——脉冲式控制+物理终止+噪声调制+基因参数同步。代码的角色从决策者变成翻译器。

实验验证

定义"计算结果如何被证明"——自身对照实验+逐帧数据采集+数据持久化+可证伪条件。数据的完整性就是论证的完整性。

第五维度：依赖链路审计 这是贯穿前四个维度的"总监理"。它不单独存在，而是嵌入在哲学前提的实现验证、硬件约束的代码映射、软件架构的数据管道、实验验证的证据链完整性之中。审计的缺席意味着前四个维度都失去了经验基础。

### 四层架构的螺旋上升

从v2.0到v9.15的版本演进清晰地展示了一个模式：每个层次在演进中都经历了"功能构建→可靠性审计→涌现重构→反馈闭环"的螺旋上升：

图：四层架构的螺旋上升模式（每个层次都经历相同的四阶段循环）

论文第六章提出的"条件复现→能力复现"的方法论转换，为后续大规模实验提供了操作指南：后续实验不需要复现某次实验的确切轨迹（物理噪声使其不可能），而需要复现实验条件——相同的硬件平台、相同的代码版本、相同的进化参数、相同的自身对照实验协议。如果条件复现了，能力的涌现应该是一致的。

### 方法论文档的最终定位

本方法论文档与学术论文形成互补关系：论文是"证明"，方法论是"指南"。论文证明了"物理结构即算法"这一命题在理论和实验层面的可行性；方法论文档则提供了如何在工程实践中重复这一构建过程的详细指南。它不只是一个"项目总结"——它是为其他具身智能体研究者提供的一套可直接参照的构建方法论，包含：哲学前提的设定方式、硬件约束的应对策略、软件架构的设计原则、实验验证的数据结构设计、以及依赖链路审计的操作规程。

这套方法论的核心贡献不在于"我们做出了一个能避障的机器人"——而在于"我们用一种可以被重复的方法，证明了物理结构本身可以承担计算"。这是方法论的终极价值：它让"物理结构即算法"从一个有趣的哲学命题，变成了一个可操作、可验证、可重复的研究范式。

## 数据来源

1. 仿草履虫应激机制的小车避障进化验证系统设计与实现（中期底稿，2026年8月）。 用户上传论文文档
2. log.ino — 未归档详细版本演进日志，包含v9.8~v9.15的完整设计文档、审计记录和状态转移分析。 用户上传代码文件
3. OEETestLOG_Integrated.ino — 集成版版本演进日志，覆盖v2.0~v9.15全版本历史。 用户上传代码文件
4. 函数编号与依赖关系定义文档 — 220个函数的完整索引、六层架构归类、四大核心调用链路及28个核心函数标注。 用户上传文档
5. Hardware Analysis.html — 基于最终代码逆向复原的硬件平台分析报告，包含完整引脚映射表和驱动电路分析。 用户上传文档
6. OEETestLOG v2.ino — 未归档详细版本演进日志补遗。 用户上传代码文件
7. 论文结构图、论文-软件映射、软件架构图 — 22个概念节点×14个软件类的结构分析文档。 用户上传文档

本方法论文档基于用户提供的论文、代码、日志和结构分析文件综合撰写。所有代码引用以最终版本 OEETestFinal_v9919_Final_v2.ino 为基准。
