xavercai/PICAR/OEETestFinal_v99.ino

/*
 * ================================================================
 * 项目名称：仿草履虫应激机制 - 脱困能力进化系统
 * 文件：OEETestFinal_v9.8.ino
 * 版本：v9.8-StateMachineRefactor
 * 最后更新：2026-08-16
 * 
 * 【v9.8 状态管理重构】- 2026-08-16
 * ────────────────────────────────────────────────────────────────
 * 
 *   改进1：单一状态枚举替代多个布尔标志
 *   ────────────────────────────────────────
 *   问题：原系统使用 stuckFlag、chaosActive、escapeActive、ruleActive 
 *         四个独立布尔标志，状态组合存在歧义（如 stuckFlag=true 且 
 *         chaosActive=true 同时存在的不合理状态）。
 * 
 *   解决：引入 MotorState 枚举，包含 5 个互斥状态：
 *         STATE_IDLE(0)     - 空闲
 *         STATE_WALKING(1)  - 基因规则驱动行走
 *         STATE_STUCK(2)    - 卡死检测中
 *         STATE_CHAOS(3)    - 混沌模式（物理噪声驱动）
 *         STATE_ESCAPING(4) - 脱困规则执行中
 *         
 *         用单一 static MotorState motorState 变量替代全部布尔标志。
 * 
 *   收益：状态互斥，无歧义；状态转换清晰可追踪；便于调试和扩展。
 * 
 * 
 *   改进2：统一封装卡死状态清除逻辑
 *   ────────────────────────────────────────
 *   问题：stuckFlag = false 的清除逻辑分散在 stopMotors()、resetStuck()、
 *         update() 等 5 处，修改时容易遗漏，导致状态不一致。
 * 
 *   解决：新增 clearStuckState() 函数，集中处理所有卡死状态清除：
 *         - 判断当前状态是否为 STUCK 或 CHAOS
 *         - 自动切换到 IDLE
 *         - 重置 stuckStartTime
 *         - 清除 escapeActiveCompat
 * 
 *   收益：单一修改点，确保所有清除逻辑一致，避免状态残留。
 * 
 * 
 *   改进3：帧日志增加 state 字段
 *   ────────────────────────────────────────
 *   问题：帧日志仅记录 chaosActive 标志 (1bit)，无法还原完整状态机
 *         阶段，离线分析时无法判断卡死/脱困/混沌的精确时序。
 * 
 *   解决：FrameLogEntry 结构体调整：
 *         - reserved:5 拆分为 state:3 + reserved:2
 *         - 每帧记录当前 motorState 值 (0-4)
 *         - 帧大小从 11 字节变为 11 字节（不变，利用原有保留位）
 * 
 *   收益：离线可精确重建状态机时间线，支持论文数据分析。
 * 
 * 
 *   【状态转换图】v9.8
 *   ──────────────────────────────────────────────────────
 * 
 *         规则匹配成功                   卡死检测
 *    IDLE ──────────────→ WALKING ──────────────→ STUCK
 *      ↑                    │                      │
 *      │                    │ 动作结束              │ 超时2秒
 *      │                    ↓                      ↓
 *      │                  IDLE                   CHAOS
 *      │                                           │
 *      │                   脱困规则触发             │ 运动恢复/超时5秒
 *      └─────────────── ESCAPING ←────────────────┘
 * 
 *   【字段变更】
 *   ──────────────────────────────────────────────────────
 *   FrameLogEntry (11 bytes)
 *   ┌────────────┬────────────┬────────────┬──────────┐
 *   │ 字段       │ 原大小     │ 新大小     │ 说明     │
 *   ├────────────┼────────────┼────────────┼──────────┤
 *   │ timestamp  │ 4 bytes    │ 4 bytes    │ 不变     │
 *   │ sensorL    │ 2 bytes    │ 2 bytes    │ 不变     │
 *   │ sensorR    │ 2 bytes    │ 2 bytes    │ 不变     │
 *   │ motorL PWM │ 1 byte     │ 1 byte     │ 不变     │
 *   │ motorR PWM │ 1 byte     │ 1 byte     │ 不变     │
 *   │ directionL │ 1 bit      │ 1 bit      │ 不变     │
 *   │ directionR │ 1 bit      │ 1 bit      │ 不变     │
 *   │ chaosActive│ 1 bit      │ 1 bit      │ 保留兼容 │
 *   │ state      │ 无         │ 3 bits     │ ★ 新增   │
 *   │ reserved   │ 5 bits     │ 2 bits     │ 缩小     │
 *   └────────────┴────────────┴────────────┴──────────┘
 * 
 * ================================================================
 *//*
 * ================================================================
 * 项目名称：仿草履虫应激机制 - 脱困能力进化系统
 * 文件：OEETestFinal_v9.7.1.ino
 * 版本：v9.7.1-ChaosTimeoutFix
 * 最后更新：2026-08-16
 * 
 * 【版本演进日志】- 按时间顺序完整记录
 * ================================================================
 * 
 * v7.3-fixed-v2 - 经典遗传算法基线 (2026-08-09 ~ 2026-08-11)
 * ────────────────────────────────────────────────────────────────
 *   设计哲学：经典遗传算法(GA)，固定适应度函数，精英保留，收敛到最优。
 *   基因型：5个固定参数 (k_turn, speed_bias, chaos_threshold,
 *           recovery_mode, preferred_action)
 * 
 *   编译错误修复 (v7.3-fixed → v7.3-fixed-v2)：
 *   1. EvolutionEngine 重构为单例+静态包装模式
 *   2. ledcAttach(pin, freq, bits) → ledcSetup + ledcAttachPin 拆分
 *   3. ledcWrite 参数从引脚号改为通道号
 *   4. case 2 中声明 int dir 跨越初始化 → 加花括号
 *   5. PIN_NOISE_SOURCE 从 GPIO6（与Flash冲突）改为 GPIO35
 *   6. isClear() 删除不可达代码
 *   7. 删除重复的 server.on("/status") 注册
 *   8. 添加 #include <cstdio>
 *   9. 新增 MotorController public getter 方法
 * 
 * v8.0 - 开放式进化重构 "物理结构即算法" (2026-08-11)
 * ────────────────────────────────────────────────────────────────
 *   设计哲学转变：从"目标导向优化"转向"行为多样性探索"。
 *   核心思想：不问"谁表现好"，问"谁的行为是档案里没见过的"。
 * 
 *   维度一：Novelty Search 新奇度驱动进化
 *     - 行为描述符 (12维)：传感器4维 + 运动4维 + 策略4维
 *     - 新奇度 = 到档案中 k=5 个最近邻的平均欧氏距离
 *     - 新奇度 > 0.15 → 加入档案 (最多200条)
 *     - 选择：新奇度排序 → 精英保留前25% → 锦标赛选新奇度高的
 *     - 自适应变异率：新奇度停滞 → 加大变异；新奇度健康 → 降低变异
 * 
 *   维度二：物理结构承担计算
 *     - 物理终止条件：physicsTerminatedAction() 检测编码器停滞
 *     - 噪声连续调制：GPIO35每帧读取，调制所有行为参数 (0.7~1.3倍)
 *     - 脉冲式控制：删除逐帧平滑，速度变化由物理系统决定
 * 
 *   维度三：可变长度行为表基因
 *     - BehaviorRule 结构体：8种条件类型 + 电机PWM + 持续时间 + 跳转
 *     - 每个个体 2~16 条规则，规则数量本身可进化
 *     - 交叉：随机切割点交叉 (父本1前k1 + 父本2后k2)
 *     - 变异：10种操作 (参数微调、条件变更、增删规则、交换顺序等)
 * 
 * v8.5-final - 硬件适配与编译修复 (2026-08-12)
 * ────────────────────────────────────────────────────────────────
 *   1. 方向引脚修正：PIN_LEFT_DIR2 21→46，PIN_RIGHT_DIR2 33→15
 *   2. setMotorSigned() 重写为 setMotorSpeed()，同时控制方向和PWM
 *   3. 删除 writeMotorHardware()，统一使用 setMotorSpeed()
 *   4. stopMotors() 直接调用 setMotorSpeed(0, 0)
 *   5. 右电机正反转方向与 v5.9 对齐
 *   SPIFFS状态：此时SPIFFS被禁用，数据仅保存在RAM中。
 * 
 * v8.6 - 非阻塞状态机重构 (2026-08-13 ~ 2026-08-14)
 * ────────────────────────────────────────────────────────────────
 *   问题根因：RTC看门狗复位 (rst:0x10)
 *     physicsTerminatedAction() 内部使用 while(1) + delay()
 *     最长阻塞3秒，期间不喂狗 → 触发 RTCWDT_RTC_RST
 * 
 *   修复方案：
 *     - physicsTerminatedAction() → startPhysicsAction() + updatePhysicsAction()
 *     - startPhysicsAction(): 设置电机并记录起始状态
 *     - updatePhysicsAction(): 每帧调用，检测编码器停滞 → 自动终止
 *     - 移除所有阻塞 delay()
 *     - Web控制台在动作执行期间保持响应
 * 
 * v8.6.4 - 实机运行数据分析与关键Bug修复 (2026-08-14)
 * ────────────────────────────────────────────────────────────────
 *   实机运行数据：
 *     distanceTicks 显示为 4294967257, 4294967220, 4294967204
 *     对应有符号值：-39, -76, -92 (逐个体累积恶化)
 * 
 *   问题1（致命）：distanceTicks 的 uint32_t 下溢溢出
 *     修复：volatile uint32_t → volatile int32_t
 * 
 *   问题2（致命）：distanceTicks 在个体之间从未重置
 *     修复：新增 resetDistanceTicks() 并在 startCurrentTestImpl() 中调用
 * 
 *   问题3（致命）：下溢值污染行为描述符，破坏新奇度计算
 *     修复：改用 int32_t + abs()，确保 totalDistance 反映真实位移
 * 
 *   问题4（中等）：种子个体可能未被首先测试
 *     修复：移除重复的 endCurrentTest() 调用
 * 
 *   修复清单 (共12处类型修复)：
 *     - distanceTicks: uint32_t → int32_t
 *     - actionLastTicks: uint32_t → int32_t
 *     - HistoryRecord::distance_ticks: uint32_t → int32_t
 *     - Gene::distance_ticks: uint32_t → int32_t
 *     - 新增 MotorController::resetDistanceTicks()
 *     - startCurrentTestImpl() 中调用 resetDistanceTicks()
 *     - handleEvolution action="next" 移除重复的 endCurrentTest()
 * 
 * v8.7 - 完整基因存储 + 二进制帧日志 (2026-08-15)
 * ────────────────────────────────────────────────────────────────
 *   改动原因：
 *     1. 完整基因（每条规则的具体内容）从未被持久化
 *     2. 帧日志仅保存在RAM环形缓冲区，测试结束后丢失
 *     3. 数据写入无原子性保证
 *     4. 实验状态无法恢复，重启后所有RAM数据丢失
 * 
 *   新增功能：
 *     1. GeneStorage 类：完整基因的原子保存与加载
 *        - 种群快照：/pop_gen_N.bin (二进制，含所有个体的完整规则)
 *        - 个体记录：/gen_N_id_X.csv (CSV，人类可读)
 *        - 帧日志：/frm_N_iX.bin (二进制，每帧11字节)
 * 
 *     2. 原子写入策略 (FileUtils::atomicWrite)
 *        - 先写临时文件 → 验证大小 → 重命名为正式文件
 * 
 *     3. 实验生命周期管理
 *        - 每轮固定20代，自动检测新实验并清理旧数据
 *        - 实验状态持久化到 /experiment_state.mrk
 *        - 重启后自动恢复实验进度
 * 
 *     4. 数据完整性保证
 *        - 文件头包含魔数 (0x47454E45) 和版本号 (0x0002)
 * 
 *   存储空间需求：总计约1MB (适合1.5-2MB SPIFFS)
 * 
 * v8.8 - 卡死感知 + 向死而生混沌机制 (2026-08-15)
 * ────────────────────────────────────────────────────────────────
 *   问题背景：v8.0-v8.7 重构时，原有的混沌/卡死检测逻辑被"行为表规则替代"
 *   但没有等价功能补上。进化没有选择压力，退化为随机游走。
 * 
 *   新增功能：
 *     1. 卡死检测（硬编码基础设施）
 *        - 检测条件：轮子在转（速度>50）但编码器差值持续增大 (>50)
 *        - 持续1秒 → stuckFlag = true
 * 
 *     2. COND_STUCK 和 COND_ESCAPE 条件类型
 *        - 行为表规则可以检测卡死状态并执行脱困动作
 * 
 *     3. 种子个体包含卡死脱困规则
 *        - 规则3: COND_STUCK → 后退右转脱困 (nextRule=4)
 *        - 规则4: COND_ESCAPE → 清除状态
 * 
 *   设计哲学：
 *     - 卡死检测 = 硬编码基础设施（生存保障）
 *     - 脱困行为 = 基因中的规则控制（可进化）
 * 
 * v8.9-robust-stable - 鲁棒性增强 (2026-08-15)
 * ────────────────────────────────────────────────────────────────
 *   问题现象：烧录后 Web 显示正常，解锁后电机没有任何响应，LED也不闪烁
 * 
 *   根因1（致命）：状态机死锁
 *     修复：stopMotors() 中强制重置 ruleActive=false，重置 currentRuleIndex
 * 
 *   根因2（致命）：种群数据损坏或无有效个体
 *     修复：增加数据完整性验证，自动修复损坏个体
 * 
 *   根因3（致命）：种子个体被覆盖或未正确创建
 *     修复：initImpl() 末尾强制验证并重建种子个体
 * 
 *   根因4（严重）：startPhysicsAction() 未检查 motorEnabled
 *     修复：返回 bool 表示是否成功启动
 * 
 *   根因5（严重）：update() 中无规则匹配时没有 logFrame()
 *     修复：所有状态都记录帧日志
 * 
 * v8.9-chaos - 混沌机制完整实现 (2026-08-15)
 * ────────────────────────────────────────────────────────────────
 *   问题背景：v8.8 中加入的 COND_STUCK 和 COND_ESCAPE 条件类型，
 *   在 evaluateCondition() 中从未实现判断逻辑。
 * 
 *   修复内容：
 *     1. CondType 枚举增加 COND_STUCK = 8, COND_ESCAPE = 9
 *     2. MotorController 新增静态成员：stuckFlag, stuckCounter, 
 *        escapeActive, lastSensorSum, lastSpeedSum
 *     3. 静态变量在类外定义并初始化为 0/false
 *     4. Gene::evaluateCondition() 增加 case COND_STUCK 和 COND_ESCAPE
 *     5. 规则匹配时管理 escapeActive 状态
 *     6. Web界面增加卡死/脱困状态显示
 * 
 * v8.9-chaos-v2 ~ v8.9-chaos-v6 - 向死而生混沌机制演进 (2026-08-15)
 * ────────────────────────────────────────────────────────────────
 *   核心设计哲学：
 *     当基因驱动的脱困策略在 CHAOS_TIMEOUT_MS (2秒) 内未能解除卡死，
 *     系统判定"物理结构陷入了基因也无法破解的绝境"。
 *     此时代码彻底退场，GPIO35 热噪声直接驱动电机，
 *     物理世界自主寻找脱困路径（各态历经搜索 + 对称性破缺）。
 * 
 *   双模式卡死检测 (v8.9-chaos-v4)：
 *     模式1：编码器差值卡死 - diff > 15 且持续增大，两轮都在转，持续1秒
 *     模式2：单轮卡死 - 一个轮子转(>20)，另一个轮子停(<3)，持续1秒
 *     模式3：大差值兜底 - diff > 30，任意轮子在转，持续1秒
 * 
 *   向死而生混沌机制 (v8.9-chaos-v5)：
 *     1. 卡死持续 2 秒后，基因脱困超时 → 启动混沌
 *     2. 读取 GPIO35 热噪声，放大后映射到左右电机 PWM
 *     3. 不经过任何行为表规则、不经过任何基因解码
 *     4. 编码器检测到物理运动恢复 → 自动退出混沌，代码重新接管
 * 
 *   完整闭环：
 *     物理结构"死寂" → 代码感知 → 接通物理随机源
 *     → 物理世界自主决策 (各态历经搜索)
 *     → 物理运动恢复 → 代码重新接管
 * 
 * v8.9-chaos-v6 - 自身对照实验设计 (2026-08-16)
 * ────────────────────────────────────────────────────────────────
 *   论文背景：论文实验设计章节提出了"自身对照"方法论——
 *   以混沌触发为时间分界线，将同一硬件上的行为数据划分为
 *   基线组（Chaos-Free）和实验组（Chaos-Intervention），
 *   通过差分分析消除硬件偏差与环境噪声干扰。
 * 
 *   本次修改 (14处)：
 *     1. FrameLogEntry 结构体 - 将 reserved:6 拆分为 chaosActive:1 + reserved:4
 *     2. 新增 ChaoticTestRecord 结构体 (56字节/条)
 *     3. MotorController 类 (5处) - init(), startChaos(), endChaos(), 
 *        logFrame(), 14个公开访问器 + resetChaosStatistics()
 *     4. EvolutionEngine 类 (2处) - startCurrentTestImpl() 调用 resetChaosStatistics()
 *        endCurrentTestImpl() 收集统计数据并保存
 *     5. GeneStorage + RobustStorage + Web (5处) - saveChaosRecord(),
 *        addChaosRecord(), getChaosHistoryCSV(), /download/chaos 端点
 * 
 *  自身对照数据流：
 *    运行时: 每帧 → logFrame() → 按 chaosActive 分流到基线/实验组
 *    混沌触发 → startChaos() → 记录起始快照
 *    混沌退出 → endChaos() → 计算持续时长和距离
 *    死亡时: endCurrentTestImpl() → 收集全部统计 → 写入个体CSV + 汇总CSV
 * 
 * v9.3-OEETestV3 - 当前状态 (2026-08-16)
 * ────────────────────────────────────────────────────────────────
 *   完整功能清单：
 *     ✅ Novelty Search 新奇度驱动进化
 *     ✅ 可变长度行为表基因 (2~16条IF-THEN规则)
 *     ✅ 物理终止条件 (编码器检测)
 *     ✅ 噪声连续调制 (GPIO35)
 *     ✅ 双模式卡死检测 (差值+单轮)
 *     ✅ 向死而生混沌机制 (物理噪声直接驱动)
 *     ✅ 完整基因存储 (种群快照+个体记录)
 *     ✅ 二进制帧日志 (每帧11字节)
 *     ✅ 原子写入策略 (临时文件+重命名)
 *     ✅ 实验生命周期管理 (20代自动检测)
 *     ✅ 自身对照实验设计 (混沌前后数据标记)
 *     ✅ 完整Web下载端点 (历史/基因/帧日志/混沌记录)
 *     ✅ SPIFFS数据持久化
 * 
 *   架构特点：
 *     - 代码退场哲学：混沌期间代码不决策，物理世界自主探索
 *     - 物理结构即算法：身体参与决策、计时和运动平滑
 *     - 进化不预设目标：新奇度驱动行为多样性探索
 * 
 * v9.4-ChaosFix - 混沌触发修复 (2026-08-16)
 * ────────────────────────────────────────────────────────────────
 *   问题现象：即使编码器差值超过100甚至200，混沌机制从未被触发
 * 
 *   问题根因：MotorController::update() 中，卡死检测和混沌触发逻辑
 *   被放在 if (!ruleActive) 代码块内部。
 *   因为 ruleActive 一直为 true，永远跳不到触发混沌的代码。
 * 
 *   修复方案：
 *     1. 将卡死检测逻辑从 if (!ruleActive) 块中移出 → 每帧都执行
 *     2. 将混沌触发判断移到 if (!ruleActive) 块外部
 *     3. 混沌触发后立即 return，避免与规则执行冲突
 *     4. 增加详细调试日志
 * 
 * v9.5-DataAuditFix - 数据审计修复 (2026-08-16)
 * ────────────────────────────────────────────────────────────────
 *   修复1：增加帧日志容量 - FRAME_LOG_SIZE 256 → 4096 (可存储40秒数据)
 *   修复2：删除重复写入 - endCurrentTestImpl() 中删除 GeneStorage::saveHistoryRecord()
 *   修复3：新增独立下载端点
 *     /download/genes → 仅下载 gen_*.csv 基因记录
 *     /download/frames → 下载帧日志 (支持 ?gen=N&id=M 单个体)
 *     /download/individual → 下载单个体完整数据包
 *   修复4：分离种群快照和基因记录
 *     /download/population → 仅 pop_gen_*.bin
 *     /download/genes → 仅 gen_*.csv
 *   修复5：单个体完整数据包
 *     /download/individual?gen=N&id=M 返回完整数据包
 * 
 * v9.7-MotorBalanceFix - 电机平衡修复 (2026-08-16)
 * ────────────────────────────────────────────────────────────────
 *   1. 电机PWM不平衡补偿 - 分方向增益 + 死区补偿
 *   2. LEFT_FWD_GAIN=1.00, RIGHT_FWD_GAIN=1.25 唯一直行组合
 *   3. 左转/右转 Web 控制 PWM 调整 (-130/120)
 *   4. 完整串口命令: ls, status, frame, pop, chaos, popall, help
 *   5. FRAME_LOG_SIZE=4096 (可存40秒数据)
 * 
 * v9.7.1-ChaosTimeoutFix - 混沌超时修复 (2026-08-16) ★ 当前版本
 * ────────────────────────────────────────────────────────────────
 *   [核心修复]
 *   ● 混沌模式基于编码器实际运动检测恢复（替代虚假信号检测）
 *   ● 混沌超时保护：5秒无运动强制退出 + 脱困冲撞
 *   ● 电机PWM不平衡补偿 (LEFT_FWD=1.00, RIGHT_FWD=1.25)
 *   ● 完整串口命令和Web下载界面
 *   ● 新增 popall <代> 命令：一键查看一代所有个体汇总数据
 * 
 *   [技术细节]
 *   - CHAOS_FORCE_TIMEOUT_MS = 5000ms 强制退出
 *   - CHAOS_ESCAPE_PWM = 200 脱困冲撞
 *   - CHAOS_RECOVER_STABLE_FRAMES = 20 稳定帧检测
 *   - 右轮前进增益从1.25调整为1.30
 * 
 * 【系统架构】
 * ================================================================
 *   ┌─────────────────────────────────────────────────────────────┐
 *   │              仿草履虫应激进化系统 v9.7.1                    │
 *   ├─────────────────────────────────────────────────────────────┤
 *   │  ┌──────────┐  ┌──────────┐  ┌────────────────────────┐  │
 *   │  │ 传感器层 │  │ 执行器层 │  │       存储层           │  │
 *   │  │ ├左红外  │  │ ├左电机  │  │ ├SPIFFS               │  │
 *   │  │ ├右红外  │  │ ├右电机  │  │ ├种群快照             │  │
 *   │  │ └噪声源  │  │ └编码器  │  │ ├帧日志               │  │
 *   │  └────┬─────┘  └────┬─────┘  │ └混沌记录             │  │
 *   │       │             │        └────────────────────────┘  │
 *   │  ┌────┴─────────────┴────┐  ┌────────────────────────┐  │
 *   │  │      控制器层         │  │       接口层           │  │
 *   │  │  ├ MotorController   │  │  ├ Web Server          │  │
 *   │  │  │   ├动作执行       │  │  ├ WiFi AP            │  │
 *   │  │  │   ├卡死检测       │  │  └ 串口命令           │  │
 *   │  │  │   └混沌控制       │  └────────────────────────┘  │
 *   │  │  └ EvolutionEngine   │                               │
 *   │  │      ├Novelty Search │                               │
 *   │  │      ├遗传算法       │                               │
 *   │  │      └行为评估       │                               │
 *   │  └──────────────────────┘                               │
 *   └─────────────────────────────────────────────────────────────┘
 * 
 * 【关键参数速查】
 * ================================================================
 *   混沌控制：
 *     CHAOS_TIMEOUT_MS        = 2000ms  卡死检测超时
 *     CHAOS_FORCE_TIMEOUT_MS  = 5000ms  混沌强制退出
 *     CHAOS_ESCAPE_PWM        = 200     脱困冲撞PWM
 *     CHAOS_NOISE_AMPLIFIER   = 180     噪声放大系数
 * 
 *   电机补偿 (v9.7.1)：
 *     LEFT_FWD_GAIN   = 1.00    左轮前进增益
 *     RIGHT_FWD_GAIN  = 1.30    右轮前进增益（补偿）
 *     LEFT_REV_GAIN   = 1.30    左轮反转增益
 *     RIGHT_REV_GAIN  = 1.30    右轮反转增益
 * 
 *   进化参数：
 *     POPULATION_SIZE = 16      种群大小
 *     TEST_DURATION_MS = 30000  每代测试时长
 *     NOVELTY_K_NEAREST = 5     K近邻数
 *     NOVELTY_ADD_THRESHOLD = 0.15  档案添加阈值
 * 
 * 【硬件引脚映射】
 * ================================================================
 *   PIN_SENSOR_LEFT    = 4     左红外传感器
 *   PIN_SENSOR_RIGHT   = 5     右红外传感器
 *   PIN_NOISE_SOURCE   = 35    噪声源ADC (GPIO35)
 *   PIN_LEFT_PWM       = 9     左电机PWM
 *   PIN_LEFT_DIR2      = 46    左电机方向
 *   PIN_RIGHT_PWM      = 16    右电机PWM
 *   PIN_RIGHT_DIR2     = 15    右电机方向
 *   PIN_LEFT_ENC_A     = 18    左编码器A
 *   PIN_LEFT_ENC_B     = 17    左编码器B
 *   PIN_RIGHT_ENC_A    = 11    右编码器A
 *   PIN_RIGHT_ENC_B    = 10    右编码器B
 *   PIN_LED            = 14    状态LED
 *   PIN_OBSTACLE_INT   = 39    中断输入
 * 
 * 【串口命令】
 * ================================================================
 *   ls / list     - 列出SPIFFS所有文件
 *   status        - 显示系统状态
 *   frame <代> <个体>  - 解析帧日志
 *   pop <代>      - 解析种群快照
 *   chaos <代> <个体>  - 解析混沌记录
 *   popall <代>   - ★ 显示一代所有个体汇总数据
 *   help          - 显示帮助
 * 
 * 【Web界面】
 * ================================================================
 *   AP名称: CarLogger
 *   密码: 12345678
 *   访问地址: http://192.168.4.1
 *   功能：实时监控、电机控制、实验控制、数据导出
 * 
 * 【编译信息】
 * ================================================================
 *   开发板: ESP32 Dev Module
 *   Flash Size: 4MB
 *   Partition: SPIFFS (1.2MB APP / 1.5MB SPIFFS)
 * 
 * 【数据流总览】
 * ================================================================
 * 
 * ┌─ 运行时数据流 ───────────────────────────────────────────────┐
 * │                                                             │
 * │  loop() 每帧:                                               │
 * │    ├─ 混沌模式? → updateChaos() (物理噪声驱动)              │
 * │    ├─ 物理动作? → updatePhysicsAction() (编码器检测终止)    │
 * │    ├─ 规则评估 → 匹配条件 → startPhysicsAction()            │
 * │    ├─ logFrame() → 标记 chaosActive → 分流统计              │
 * │    └─ 卡死检测 → 超时2秒 → startChaos()                    │
 * │                                                             │
 * └─────────────────────────────────────────────────────────────┘
 * 
 * ┌─ 持久化数据流 ───────────────────────────────────────────────┐
 * │                                                             │
 * │  个体死亡 → endCurrentTestImpl():                           │
 * │    ├─ 新奇度计算 → archive.addIfNovel()                    │
 * │    ├─ HistoryRecord → /oe_history.csv                      │
 * │    ├─ ChaoticTestRecord → /chaos_g{N}_i{X}.csv             │
 * │    ├─ 基因记录 → /gen_{N}_id_{X}.csv                       │
 * │    ├─ 帧日志 → /frm_{N}_i{X}.bin (11字节/帧)              │
 * │    └─ 种群快照 → /pop_gen_{N}.bin (原子写入)              │
 * │                                                             │
 * └─────────────────────────────────────────────────────────────┘
 * 
 * ================================================================
 */

/*
 * ================================================================
 * 项目名称：仿草履虫应激机制 - 脱困能力进化系统
 * 文件：OEETestFinal_v9.8_RAMLogBuffer.ino
 * 版本：v9.8-RAMLogBuffer
 * 最后更新：2026-08-16
 * 
 * 【版本演进日志】- 按时间顺序完整记录
 * ================================================================
 * 
 * v7.3-fixed-v2 - 经典遗传算法基线 (2026-08-09 ~ 2026-08-11)
 * ────────────────────────────────────────────────────────────────
 *   设计哲学：经典遗传算法(GA)，固定适应度函数，精英保留，收敛到最优。
 *   基因型：5个固定参数 (k_turn, speed_bias, chaos_threshold,
 *           recovery_mode, preferred_action)
 * 
 *   编译错误修复 (v7.3-fixed → v7.3-fixed-v2)：
 *   1. EvolutionEngine 重构为单例+静态包装模式
 *   2. ledcAttach(pin, freq, bits) → ledcSetup + ledcAttachPin 拆分
 *   3. ledcWrite 参数从引脚号改为通道号
 *   4. case 2 中声明 int dir 跨越初始化 → 加花括号
 *   5. PIN_NOISE_SOURCE 从 GPIO6（与Flash冲突）改为 GPIO35
 *   6. isClear() 删除不可达代码
 *   7. 删除重复的 server.on("/status") 注册
 *   8. 添加 #include <cstdio>
 *   9. 新增 MotorController public getter 方法
 * 
 * v8.0 - 开放式进化重构 "物理结构即算法" (2026-08-11)
 * ────────────────────────────────────────────────────────────────
 *   设计哲学转变：从"目标导向优化"转向"行为多样性探索"。
 *   核心思想：不问"谁表现好"，问"谁的行为是档案里没见过的"。
 * 
 *   维度一：Novelty Search 新奇度驱动进化
 *     - 行为描述符 (12维)：传感器4维 + 运动4维 + 策略4维
 *     - 新奇度 = 到档案中 k=5 个最近邻的平均欧氏距离
 *     - 新奇度 > 0.15 → 加入档案 (最多200条)
 *     - 选择：新奇度排序 → 精英保留前25% → 锦标赛选新奇度高的
 *     - 自适应变异率：新奇度停滞 → 加大变异；新奇度健康 → 降低变异
 * 
 *   维度二：物理结构承担计算
 *     - 物理终止条件：physicsTerminatedAction() 检测编码器停滞
 *     - 噪声连续调制：GPIO35每帧读取，调制所有行为参数 (0.7~1.3倍)
 *     - 脉冲式控制：删除逐帧平滑，速度变化由物理系统决定
 * 
 *   维度三：可变长度行为表基因
 *     - BehaviorRule 结构体：8种条件类型 + 电机PWM + 持续时间 + 跳转
 *     - 每个个体 2~16 条规则，规则数量本身可进化
 *     - 交叉：随机切割点交叉 (父本1前k1 + 父本2后k2)
 *     - 变异：10种操作 (参数微调、条件变更、增删规则、交换顺序等)
 * 
 * v8.5-final - 硬件适配与编译修复 (2026-08-12)
 * ────────────────────────────────────────────────────────────────
 *   1. 方向引脚修正：PIN_LEFT_DIR2 21→46，PIN_RIGHT_DIR2 33→15
 *   2. setMotorSigned() 重写为 setMotorSpeed()，同时控制方向和PWM
 *   3. 删除 writeMotorHardware()，统一使用 setMotorSpeed()
 *   4. stopMotors() 直接调用 setMotorSpeed(0, 0)
 *   5. 右电机正反转方向与 v5.9 对齐
 *   SPIFFS状态：此时SPIFFS被禁用，数据仅保存在RAM中。
 * 
 * v8.6 - 非阻塞状态机重构 (2026-08-13 ~ 2026-08-14)
 * ────────────────────────────────────────────────────────────────
 *   问题根因：RTC看门狗复位 (rst:0x10)
 *     physicsTerminatedAction() 内部使用 while(1) + delay()
 *     最长阻塞3秒，期间不喂狗 → 触发 RTCWDT_RTC_RST
 * 
 *   修复方案：
 *     - physicsTerminatedAction() → startPhysicsAction() + updatePhysicsAction()
 *     - startPhysicsAction(): 设置电机并记录起始状态
 *     - updatePhysicsAction(): 每帧调用，检测编码器停滞 → 自动终止
 *     - 移除所有阻塞 delay()
 *     - Web控制台在动作执行期间保持响应
 * 
 * v8.6.4 - 实机运行数据分析与关键Bug修复 (2026-08-14)
 * ────────────────────────────────────────────────────────────────
 *   实机运行数据：
 *     distanceTicks 显示为 4294967257, 4294967220, 4294967204
 *     对应有符号值：-39, -76, -92 (逐个体累积恶化)
 * 
 *   问题1（致命）：distanceTicks 的 uint32_t 下溢溢出
 *     修复：volatile uint32_t → volatile int32_t
 * 
 *   问题2（致命）：distanceTicks 在个体之间从未重置
 *     修复：新增 resetDistanceTicks() 并在 startCurrentTestImpl() 中调用
 * 
 *   问题3（致命）：下溢值污染行为描述符，破坏新奇度计算
 *     修复：改用 int32_t + abs()，确保 totalDistance 反映真实位移
 * 
 *   问题4（中等）：种子个体可能未被首先测试
 *     修复：移除重复的 endCurrentTest() 调用
 * 
 *   修复清单 (共12处类型修复)：
 *     - distanceTicks: uint32_t → int32_t
 *     - actionLastTicks: uint32_t → int32_t
 *     - HistoryRecord::distance_ticks: uint32_t → int32_t
 *     - Gene::distance_ticks: uint32_t → int32_t
 *     - 新增 MotorController::resetDistanceTicks()
 *     - startCurrentTestImpl() 中调用 resetDistanceTicks()
 *     - handleEvolution action="next" 移除重复的 endCurrentTest()
 * 
 * v8.7 - 完整基因存储 + 二进制帧日志 (2026-08-15)
 * ────────────────────────────────────────────────────────────────
 *   改动原因：
 *     1. 完整基因（每条规则的具体内容）从未被持久化
 *     2. 帧日志仅保存在RAM环形缓冲区，测试结束后丢失
 *     3. 数据写入无原子性保证
 *     4. 实验状态无法恢复，重启后所有RAM数据丢失
 * 
 *   新增功能：
 *     1. GeneStorage 类：完整基因的原子保存与加载
 *        - 种群快照：/pop_gen_N.bin (二进制，含所有个体的完整规则)
 *        - 个体记录：/gen_N_id_X.csv (CSV，人类可读)
 *        - 帧日志：/frm_N_iX.bin (二进制，每帧11字节)
 * 
 *     2. 原子写入策略 (FileUtils::atomicWrite)
 *        - 先写临时文件 → 验证大小 → 重命名为正式文件
 * 
 *     3. 实验生命周期管理
 *        - 每轮固定20代，自动检测新实验并清理旧数据
 *        - 实验状态持久化到 /experiment_state.mrk
 *        - 重启后自动恢复实验进度
 * 
 *     4. 数据完整性保证
 *        - 文件头包含魔数 (0x47454E45) 和版本号 (0x0002)
 * 
 *   存储空间需求：总计约1MB (适合1.5-2MB SPIFFS)
 * 
 * v8.8 - 卡死感知 + 向死而生混沌机制 (2026-08-15)
 * ────────────────────────────────────────────────────────────────
 *   问题背景：v8.0-v8.7 重构时，原有的混沌/卡死检测逻辑被"行为表规则替代"
 *   但没有等价功能补上。进化没有选择压力，退化为随机游走。
 * 
 *   新增功能：
 *     1. 卡死检测（硬编码基础设施）
 *        - 检测条件：轮子在转（速度>50）但编码器差值持续增大 (>50)
 *        - 持续1秒 → stuckFlag = true
 * 
 *     2. COND_STUCK 和 COND_ESCAPE 条件类型
 *        - 行为表规则可以检测卡死状态并执行脱困动作
 * 
 *     3. 种子个体包含卡死脱困规则
 *        - 规则3: COND_STUCK → 后退右转脱困 (nextRule=4)
 *        - 规则4: COND_ESCAPE → 清除状态
 * 
 *   设计哲学：
 *     - 卡死检测 = 硬编码基础设施（生存保障）
 *     - 脱困行为 = 基因中的规则控制（可进化）
 * 
 * v8.9-robust-stable - 鲁棒性增强 (2026-08-15)
 * ────────────────────────────────────────────────────────────────
 *   问题现象：烧录后 Web 显示正常，解锁后电机没有任何响应，LED也不闪烁
 * 
 *   根因1（致命）：状态机死锁
 *     修复：stopMotors() 中强制重置 ruleActive=false，重置 currentRuleIndex
 * 
 *   根因2（致命）：种群数据损坏或无有效个体
 *     修复：增加数据完整性验证，自动修复损坏个体
 * 
 *   根因3（致命）：种子个体被覆盖或未正确创建
 *     修复：initImpl() 末尾强制验证并重建种子个体
 * 
 *   根因4（严重）：startPhysicsAction() 未检查 motorEnabled
 *     修复：返回 bool 表示是否成功启动
 * 
 *   根因5（严重）：update() 中无规则匹配时没有 logFrame()
 *     修复：所有状态都记录帧日志
 * 
 * v8.9-chaos - 混沌机制完整实现 (2026-08-15)
 * ────────────────────────────────────────────────────────────────
 *   问题背景：v8.8 中加入的 COND_STUCK 和 COND_ESCAPE 条件类型，
 *   在 evaluateCondition() 中从未实现判断逻辑。
 * 
 *   修复内容：
 *     1. CondType 枚举增加 COND_STUCK = 8, COND_ESCAPE = 9
 *     2. MotorController 新增静态成员：stuckFlag, stuckCounter, 
 *        escapeActive, lastSensorSum, lastSpeedSum
 *     3. 静态变量在类外定义并初始化为 0/false
 *     4. Gene::evaluateCondition() 增加 case COND_STUCK 和 COND_ESCAPE
 *     5. 规则匹配时管理 escapeActive 状态
 *     6. Web界面增加卡死/脱困状态显示
 * 
 * v8.9-chaos-v2 ~ v8.9-chaos-v6 - 向死而生混沌机制演进 (2026-08-15)
 * ────────────────────────────────────────────────────────────────
 *   核心设计哲学：
 *     当基因驱动的脱困策略在 CHAOS_TIMEOUT_MS (2秒) 内未能解除卡死，
 *     系统判定"物理结构陷入了基因也无法破解的绝境"。
 *     此时代码彻底退场，GPIO35 热噪声直接驱动电机，
 *     物理世界自主寻找脱困路径（各态历经搜索 + 对称性破缺）。
 * 
 *   双模式卡死检测 (v8.9-chaos-v4)：
 *     模式1：编码器差值卡死 - diff > 15 且持续增大，两轮都在转，持续1秒
 *     模式2：单轮卡死 - 一个轮子转(>20)，另一个轮子停(<3)，持续1秒
 *     模式3：大差值兜底 - diff > 30，任意轮子在转，持续1秒
 * 
 *   向死而生混沌机制 (v8.9-chaos-v5)：
 *     1. 卡死持续 2 秒后，基因脱困超时 → 启动混沌
 *     2. 读取 GPIO35 热噪声，放大后映射到左右电机 PWM
 *     3. 不经过任何行为表规则、不经过任何基因解码
 *     4. 编码器检测到物理运动恢复 → 自动退出混沌，代码重新接管
 * 
 *   完整闭环：
 *     物理结构"死寂" → 代码感知 → 接通物理随机源
 *     → 物理世界自主决策 (各态历经搜索)
 *     → 物理运动恢复 → 代码重新接管
 * 
 * v8.9-chaos-v6 - 自身对照实验设计 (2026-08-16)
 * ────────────────────────────────────────────────────────────────
 *   论文背景：论文实验设计章节提出了"自身对照"方法论——
 *   以混沌触发为时间分界线，将同一硬件上的行为数据划分为
 *   基线组（Chaos-Free）和实验组（Chaos-Intervention），
 *   通过差分分析消除硬件偏差与环境噪声干扰。
 * 
 *   本次修改 (14处)：
 *     1. FrameLogEntry 结构体 - 将 reserved:6 拆分为 chaosActive:1 + reserved:4
 *     2. 新增 ChaoticTestRecord 结构体 (56字节/条)
 *     3. MotorController 类 (5处) - init(), startChaos(), endChaos(), 
 *        logFrame(), 14个公开访问器 + resetChaosStatistics()
 *     4. EvolutionEngine 类 (2处) - startCurrentTestImpl() 调用 resetChaosStatistics()
 *        endCurrentTestImpl() 收集统计数据并保存
 *     5. GeneStorage + RobustStorage + Web (5处) - saveChaosRecord(),
 *        addChaosRecord(), getChaosHistoryCSV(), /download/chaos 端点
 * 
 *  自身对照数据流：
 *    运行时: 每帧 → logFrame() → 按 chaosActive 分流到基线/实验组
 *    混沌触发 → startChaos() → 记录起始快照
 *    混沌退出 → endChaos() → 计算持续时长和距离
 *    死亡时: endCurrentTestImpl() → 收集全部统计 → 写入个体CSV + 汇总CSV
 * 
 * v9.3-OEETestV3 - 完整功能基线 (2026-08-16)
 * ────────────────────────────────────────────────────────────────
 *   完整功能清单：
 *     ✅ Novelty Search 新奇度驱动进化
 *     ✅ 可变长度行为表基因 (2~16条IF-THEN规则)
 *     ✅ 物理终止条件 (编码器检测)
 *     ✅ 噪声连续调制 (GPIO35)
 *     ✅ 双模式卡死检测 (差值+单轮)
 *     ✅ 向死而生混沌机制 (物理噪声直接驱动)
 *     ✅ 完整基因存储 (种群快照+个体记录)
 *     ✅ 二进制帧日志 (每帧11字节)
 *     ✅ 原子写入策略 (临时文件+重命名)
 *     ✅ 实验生命周期管理 (20代自动检测)
 *     ✅ 自身对照实验设计 (混沌前后数据标记)
 *     ✅ 完整Web下载端点 (历史/基因/帧日志/混沌记录)
 *     ✅ SPIFFS数据持久化
 * 
 *   架构特点：
 *     - 代码退场哲学：混沌期间代码不决策，物理世界自主探索
 *     - 物理结构即算法：身体参与决策、计时和运动平滑
 *     - 进化不预设目标：新奇度驱动行为多样性探索
 * 
 * v9.4-ChaosFix - 混沌触发修复 (2026-08-16)
 * ────────────────────────────────────────────────────────────────
 *   问题现象：即使编码器差值超过100甚至200，混沌机制从未被触发
 * 
 *   问题根因：MotorController::update() 中，卡死检测和混沌触发逻辑
 *   被放在 if (!ruleActive) 代码块内部。
 *   因为 ruleActive 一直为 true，永远跳不到触发混沌的代码。
 * 
 *   修复方案：
 *     1. 将卡死检测逻辑从 if (!ruleActive) 块中移出 → 每帧都执行
 *     2. 将混沌触发判断移到 if (!ruleActive) 块外部
 *     3. 混沌触发后立即 return，避免与规则执行冲突
 *     4. 增加详细调试日志
 * 
 * v9.5-DataAuditFix - 数据审计修复 (2026-08-16)
 * ────────────────────────────────────────────────────────────────
 *   修复1：增加帧日志容量 - FRAME_LOG_SIZE 256 → 4096 (可存储40秒数据)
 *   修复2：删除重复写入 - endCurrentTestImpl() 中删除 GeneStorage::saveHistoryRecord()
 *   修复3：新增独立下载端点
 *     /download/genes → 仅下载 gen_*.csv 基因记录
 *     /download/frames → 下载帧日志 (支持 ?gen=N&id=M 单个体)
 *     /download/individual → 下载单个体完整数据包
 *   修复4：分离种群快照和基因记录
 *     /download/population → 仅 pop_gen_*.bin
 *     /download/genes → 仅 gen_*.csv
 *   修复5：单个体完整数据包
 *     /download/individual?gen=N&id=M 返回完整数据包
 * 
 * v9.7-MotorBalanceFix - 电机平衡修复 (2026-08-16)
 * ────────────────────────────────────────────────────────────────
 *   1. 电机PWM不平衡补偿 - 分方向增益 + 死区补偿
 *   2. LEFT_FWD_GAIN=1.00, RIGHT_FWD_GAIN=1.25 唯一直行组合
 *   3. 左转/右转 Web 控制 PWM 调整 (-130/120)
 *   4. 完整串口命令: ls, status, frame, pop, chaos, popall, help
 *   5. FRAME_LOG_SIZE=4096 (可存40秒数据)
 * 
 * v9.7.1-ChaosTimeoutFix - 混沌超时修复 (2026-08-16)
 * ────────────────────────────────────────────────────────────────
 *   [核心修复]
 *   ● 混沌模式基于编码器实际运动检测恢复（替代虚假信号检测）
 *   ● 混沌超时保护：5秒无运动强制退出 + 脱困冲撞
 *   ● 电机PWM不平衡补偿 (LEFT_FWD=1.00, RIGHT_FWD=1.25)
 *   ● 完整串口命令和Web下载界面
 *   ● 新增 popall <代> 命令：一键查看一代所有个体汇总数据
 * 
 *   [技术细节]
 *   - CHAOS_FORCE_TIMEOUT_MS = 5000ms 强制退出
 *   - CHAOS_ESCAPE_PWM = 200 脱困冲撞
 *   - CHAOS_RECOVER_STABLE_FRAMES = 20 稳定帧检测
 *   - 右轮前进增益从1.25调整为1.30
 * 
 * v9.8-Refactor - 状态机重构 + 单一状态变量 (2026-08-16)
 * ────────────────────────────────────────────────────────────────
 *   [核心重构]
 *   ● 引入 MotorState 枚举 (IDLE/WALKING/STUCK/CHAOS/ESCAPING)
 *   ● 用单一状态变量替代 4 个布尔标志，消除状态组合歧义
 *   ● 统一封装 clearStuckState() 函数
 *   ● FrameLogEntry 增加 state 字段 (3bit)
 *   ● 状态切换自动记录时间和距离快照
 * 
 *   [架构改进]
 *   - 状态机更加清晰，易于调试和扩展
 *   - 帧日志可离线重建行为模式
 *   - 减少状态不一致导致的bug
 * 
 * v9.8-RAMLogBuffer - RAM动态日志缓冲 + SPIFFS滚动覆盖 (2026-08-16) ★ 当前版本
 * ────────────────────────────────────────────────────────────────
 *   [核心功能]
 *   ● RAMLogBuffer 类：6000帧环形缓冲区，Web/串口动态提取
 *   ● RollingStorage 类：自动滚动覆盖，保留最近5代Top2
 *   ● 增量保存：每500帧自动写入SPIFFS (P1修复)
 *   ● CRC32校验：文件头增加校验字段 (P3修复)
 *   ● 滑动窗口卡死检测：10帧窗口验证 (P4修复)
 *   ● 存储空间预警：getFreeSpace() 实时监控 (P2修复)
 *   ● 帧日志差分压缩：每帧压缩1字节 (P0-①修复)
 * 
 *   [容量优化]
 *   - SPIFFS占用: 12×3000×2×5 = 360KB (原11MB)
 *   - RAM占用: 12×6000 = 72KB
 *   - 压缩后: 11×3000×2×5 = 330KB
 * 
 *   [P0-P4 完整处理状态]
 *   ┌────────┬─────────────────────┬──────────┐
 *   │ 优先级 │ 问题               │ 状态     │
 *   ├────────┼─────────────────────┼──────────┤
 *   │ P0     │ SPIFFS容量不足     │ ✅ 已解决│
 *   │ P1     │ 帧日志中断丢失     │ ✅ 已解决│
 *   │ P2     │ 无存储空间预警     │ ✅ 已解决│
 *   │ P3     │ 数据完整性校验     │ ✅ 已解决│
 *   │ P4     │ 卡死检测误判       │ ✅ 已解决│
 *   └────────┴─────────────────────┴──────────┘
 * 
 *   [新增Web接口]
 *   - /ramlog?start=N&end=M  文本格式提取RAM日志
 *   - /ramlog/download?start=N&end=M  二进制下载
 *   - /storage/status  存储状态查询
 * 
 *   [新增串口命令]
 *   - ramlog <start> <end>  提取RAM日志
 *   - ramlog all  提取全部
 *   - storage  查看存储状态
 * 
 * 【系统架构】v9.8-RAMLogBuffer
 * ================================================================
 *   ┌─────────────────────────────────────────────────────────────────────┐
 *   │              仿草履虫应激进化系统 v9.8-RAMLogBuffer                │
 *   ├─────────────────────────────────────────────────────────────────────┤
 *   │                                                                     │
 *   │  ┌─────────────────────────────────────────────────────────────────┐│
 *   │  │                    RAM 层 (实时可查)                          ││
 *   │  │  ┌──────────────────────────────────────────────────────────┐ ││
 *   │  │  │  RAMLogBuffer (6000帧环形缓冲区, 72KB)                 │ ││
 *   │  │  │  ├─ Web: /ramlog?start=N&end=M 实时提取                │ ││
 *   │  │  │  ├─ 串口: ramlog 0 100 实时提取                        │ ││
 *   │  │  │  └─ 个体结束前数据始终可查                              │ ││
 *   │  │  └──────────────────────────────────────────────────────────┘ ││
 *   │  └─────────────────────────────────────────────────────────────────┘│
 *   │                              │                                      │
 *   │                              ▼                                      │
 *   │  ┌─────────────────────────────────────────────────────────────────┐│
 *   │  │                    SPIFFS 层 (滚动覆盖)                       ││
 *   │  │  ┌──────────────────────────────────────────────────────────┐ ││
 *   │  │  │  RollingStorage (保留最近5代Top2)                       │ ││
 *   │  │  │  ├─ 自动空间检查: getFreeSpace()                        │ ││
 *   │  │  │  ├─ 空间不足时删除最旧代                                 │ ││
 *   │  │  │  ├─ CRC32校验保护数据完整性                             │ ││
 *   │  │  │  └─ 增量保存: 每500帧写入一次                          │ ││
 *   │  │  └──────────────────────────────────────────────────────────┘ ││
 *   │  └─────────────────────────────────────────────────────────────────┘│
 *   │                                                                     │
 *   └─────────────────────────────────────────────────────────────────────┘
 * 
 * 【关键参数速查】
 * ================================================================
 *   混沌控制：
 *     CHAOS_TIMEOUT_MS        = 2000ms  卡死检测超时
 *     CHAOS_FORCE_TIMEOUT_MS  = 5000ms  混沌强制退出
 *     CHAOS_ESCAPE_PWM        = 200     脱困冲撞PWM
 *     CHAOS_NOISE_AMPLIFIER   = 180     噪声放大系数
 * 
 *   电机补偿 (v9.7.1)：
 *     LEFT_FWD_GAIN   = 1.00    左轮前进增益
 *     RIGHT_FWD_GAIN  = 1.30    右轮前进增益（补偿）
 *     LEFT_REV_GAIN   = 1.30    左轮反转增益
 *     RIGHT_REV_GAIN  = 1.30    右轮反转增益
 * 
 *   进化参数：
 *     POPULATION_SIZE = 16      种群大小
 *     TEST_DURATION_MS = 30000  每代测试时长
 *     NOVELTY_K_NEAREST = 5     K近邻数
 *     NOVELTY_ADD_THRESHOLD = 0.15  档案添加阈值
 * 
 *   RAM日志缓冲 (v9.8)：
 *     RAM_LOG_BUFFER_SIZE = 6000    RAM中保留帧数 (≈60秒)
 *     SPIFFS_MAX_GENERATIONS = 5    SPIFFS保留代数
 *     SPIFFS_MAX_INDIVIDUALS = 2    每代保留个体数
 *     INCREMENTAL_SAVE_INTERVAL = 500  增量保存间隔 (帧)
 * 
 * 【硬件引脚映射】
 * ================================================================
 *   PIN_SENSOR_LEFT    = 4     左红外传感器
 *   PIN_SENSOR_RIGHT   = 5     右红外传感器
 *   PIN_NOISE_SOURCE   = 1     噪声源ADC (GPIO1)
 *   PIN_OBSTACLE_INT   = 39    中断输入
 *   PIN_LED            = 14    状态LED
 *   PIN_LEFT_PWM       = 9     左电机PWM
 *   PIN_LEFT_DIR2      = 46    左电机方向
 *   PIN_RIGHT_PWM      = 16    右电机PWM
 *   PIN_RIGHT_DIR2     = 15    右电机方向
 *   PIN_LEFT_ENC_A     = 18    左编码器A
 *   PIN_LEFT_ENC_B     = 17    左编码器B
 *   PIN_RIGHT_ENC_A    = 11    右编码器A
 *   PIN_RIGHT_ENC_B    = 10    右编码器B
 * 
 * 【串口命令】v9.8
 * ================================================================
 *   ls / list     - 列出SPIFFS所有文件
 *   status        - 显示系统状态
 *   frame <代> <个体>  - 解析帧日志
 *   pop <代>      - 解析种群快照
 *   chaos <代> <个体>  - 解析混沌记录
 *   popall <代>   - 显示一代所有个体汇总数据
 *   ramlog <开始> <结束>  - ★ 提取RAM日志 (文本格式)
 *   ramlog all    - ★ 提取全部RAM日志
 *   storage       - ★ 查看存储状态
 *   help          - 显示帮助
 * 
 * 【Web界面】v9.8
 * ================================================================
 *   AP名称: CarLogger
 *   密码: 12345678
 *   访问地址: http://192.168.4.1
 * 
 *   新增端点:
 *   /ramlog?start=N&end=M     - 文本格式提取RAM日志
 *   /ramlog/download?start=N&end=M  - 二进制下载RAM日志
 *   /storage/status           - 存储状态查询
 * 
 * 【编译信息】
 * ================================================================
 *   开发板: ESP32 Dev Module
 *   Flash Size: 4MB
 *   Partition: SPIFFS (1.2MB APP / 1.5MB SPIFFS)
 * 
 * 【数据流总览】v9.8
 * ================================================================
 * 
 * ┌─ 运行时数据流 ───────────────────────────────────────────────────────┐
 * │                                                                     │
 * │  loop() 每帧 (10ms):                                                │
 * │    ├─ MotorController::update()                                    │
 * │    │   ├─ 滑动窗口卡死检测 (10帧窗口)                              │
 * │    │   ├─ 状态机管理 (IDLE→STUCK→CHAOS)                           │
 * │    │   └─ 规则匹配 → 执行动作                                      │
 * │    ├─ MotorController::logFrame()                                 │
 * │    │   ├─ 写入 frameLog[] (环形, 4096帧)                          │
 * │    │   ├─ 写入 RAMLogBuffer (环形, 6000帧) ★                      │
 * │    │   └─ 每500帧增量保存到SPIFFS ★                               │
 * │    └─ updateChaos() (混沌模式)                                    │
 * │                                                                     │
 * └─────────────────────────────────────────────────────────────────────┘
 * 
 * ┌─ 持久化数据流 ───────────────────────────────────────────────────────┐
 * │                                                                     │
 * │  个体结束 → endCurrentTestImpl():                                   │
 * │    ├─ 新奇度计算 → archive.addIfNovel()                            │
 * │    ├─ HistoryRecord → /oe_history.csv                              │
 * │    ├─ ChaoticTestRecord → /chaos_g{N}_i{X}.csv                     │
 * │    ├─ 基因记录 → /gen_{N}_id_{X}.csv                               │
 * │    ├─ 帧日志 → RollingStorage::saveFrameLog() ★                    │
 * │    │   ├─ CRC32校验 ★                                              │
 * │    │   ├─ 只保留Top2 ★                                             │
 * │    │   └─ 自动滚动覆盖 (最多5代) ★                                 │
 * │    └─ 种群快照 → /pop_gen_{N}.bin (原子写入)                       │
 * │                                                                     │
 * └─────────────────────────────────────────────────────────────────────┘
 * 
 * ┌─ 数据提取流 ─────────────────────────────────────────────────────────┐
 * │                                                                     │
 * │  Web/串口请求:                                                      │
 * │    ├─ /ramlog?start=N&end=M → RAMLogBuffer::extractFrames() ★      │
 * │    ├─ /ramlog/download → RAMLogBuffer::extractBinary() ★           │
 * │    ├─ /storage/status → RollingStorage::getStorageStatus() ★       │
 * │    └─ 串口: ramlog 0 100 → RAMLogBuffer::extractFrames() ★        │
 * │                                                                     │
 * └─────────────────────────────────────────────────────────────────────┘
 * 
 * ================================================================
 */

// ================================================================
// 头文件包含
// ================================================================

/*
 * ================================================================
 * 项目名称：仿草履虫应激机制 - 脱困能力进化系统
 * 文件：OEETestFinal_v9.9.ino
 * 版本：v9.9-ChaosFix+WebRefactor
 * 最后更新：2026-08-17
 * 
 * 【v9.9 混沌修复 + Web重构】- 2026-08-17
 * ────────────────────────────────────────────────────────────────
 * 
 *   修复1：混沌永不触发Bug
 *   ─────────────────────────
 *   问题：小车卡死后，Web显示混沌始终为"空闲"，混沌机制从未被触发。
 * 
 *   根因分析：
 *     ① 卡死检测条件过于严格，需要同时满足多个条件
 *     ② stuckStartTime 在卡死状态持续时可能被错误重置
 *     ③ 卡死状态到混沌触发的链路中存在条件判断漏洞
 * 
 *   解决方案：
 *     ① 增加详细的串口调试日志，实时输出卡死检测状态
 *     ② 在 loop() 中添加兜底保护：检测到 STATE_STUCK 超时时强制触发混沌
 *     ③ 降低卡死清除门槛，避免状态抖动导致 stuckStartTime 重置
 *     ④ startChaos() 增加醒目日志输出，便于确认触发
 * 
 * 
 *   改进2：Web页面重构 - 状态矩阵 + 实时监控
 *   ─────────────────────────────────────────────
 *   布局变更：
 *     【顶部区域 - 全宽显示】
 *     ├── 代际 / 个体 / 新奇度 / 存活时间
 *     ├── 状态矩阵卡片 (IDLE/WALKING/STUCK/CHAOS/ESCAPING 高亮)
 *     ├── 混沌噪声值 (GPIO1 实时读数)
 *     ├── 存储报警 (SPIFFS剩余空间，低于阈值变色)
 *     └── 一键下载全部文件 (新增)
 * 
 *     【下部区域 - 原有功能整合】
 *     ├── 实时状态 (传感器、编码器、电机)
 *     ├── 实验控制 (启动/停止/下一个)
 *     ├── 电机控制 (启用/禁用/方向)
 *     └── 数据导出 (历史/混沌/种群/基因/帧日志/个体)
 * 
 * 
 *   新增Web接口：
 *     /download/all - 一键导出所有数据文件
 * 
 *   扩展 /status 接口：
 *     - noiseValue: GPIO1 噪声实时读数
 *     - freeSpace: SPIFFS 剩余空间 (bytes)
 *     - freeSpaceKB: SPIFFS 剩余空间 (KB)
 *     - chaosTriggerCount: 混沌触发次数
 * 
 * 
 *   【状态转换图】v9.9
 *   ──────────────────────────────────────────────────────
 * 
 *         规则匹配成功                   卡死检测
 *    IDLE ──────────────→ WALKING ──────────────→ STUCK
 *      ↑                    │                      │
 *      │                    │ 动作结束              │ 超时2秒
 *      │                    ↓                      ↓
 *      │                  IDLE                   CHAOS (物理噪声驱动)
 *      │                                           │
 *      │                   脱困规则触发             │ 运动恢复/超时5秒
 *      └─────────────── ESCAPING ←────────────────┘
 * 
 *   【混沌触发条件】v9.9
 *   ──────────────────────────────────────────────────────
 *   条件1: 差值卡死 - diff > 30 且持续增大，双轮都在转
 *   条件2: 单轮卡死 - 一轮转(>20)，另一轮停(<3)
 *   条件3: 大差值兜底 - diff > 60，任意轮在转
 *   条件4: 滑动窗口 - 10帧中至少7帧差值持续增大 (★ v9.8)
 *   兜底: STATE_STUCK 持续超过 CHAOS_TIMEOUT_MS (★ v9.9)
 * 
 * ================================================================
 */

// ================================================================
// 头文件包含
// ================================================================

#include <WiFi.h>
#include <WebServer.h>
#include <FS.h>
#include <SPIFFS.h>
#include <vector>
#include <algorithm>
#include <cstdarg>
#include <cstdio>
#include <cmath>
#include <cstring>

// ================================================================
// 硬件引脚定义
// ================================================================
#define PIN_SENSOR_LEFT     4
#define PIN_SENSOR_RIGHT    5
#define PIN_NOISE_SOURCE    1       // ★ GPIO1 是噪声源
#define PIN_OBSTACLE_INT    39
#define PIN_LED             14
#define PIN_LEFT_PWM        9
#define PIN_LEFT_DIR2       46
#define PIN_RIGHT_PWM       16
#define PIN_RIGHT_DIR2      15
#define PIN_LEFT_ENC_A      18
#define PIN_LEFT_ENC_B      17
#define PIN_RIGHT_ENC_A     11
#define PIN_RIGHT_ENC_B     10

// ================================================================
// LEDC 配置
// ================================================================
#define LEDC_FREQ           5000
#define LEDC_RESOLUTION     8
#define LEDC_CHANNEL_LEFT   0
#define LEDC_CHANNEL_RIGHT  1

// ================================================================
// 电机方向定义
// ================================================================
#define LEFT_FORWARD   HIGH
#define LEFT_REVERSE   LOW
#define RIGHT_FORWARD  LOW
#define RIGHT_REVERSE  HIGH

// ================================================================
// 电机增益补偿
// ================================================================
#define LEFT_FWD_GAIN       1.00f
#define RIGHT_FWD_GAIN      1.30f
#define LEFT_REV_GAIN       1.30f
#define RIGHT_REV_GAIN      1.30f
#define LEFT_DEADZONE       35
#define RIGHT_DEADZONE      20
#define MOTOR_PWM_MAX       255

// ================================================================
// WiFi 配置
// ================================================================
#define WIFI_SSID           "CarLogger"
#define WIFI_PASSWORD       "12345678"

// ================================================================
// 进化参数
// ================================================================
#define POPULATION_SIZE     16
#define TEST_DURATION_MS    30000
#define LOOP_DELAY_MS       10

// ================================================================
// 物理动作参数
// ================================================================
#define PHYSICS_STALL_FRAMES    10
#define PHYSICS_MAX_ACTION_MS   3000

// ================================================================
// 传感器阈值
// ================================================================
#define CLEAR_ADC_THRESH     600
#define OBSTACLE_ADC_THRESH  1500

// ================================================================
// 行为规则参数
// ================================================================
#define MAX_RULES           16
#define MIN_RULES           2
#define MAX_RULE_DURATION   2000
#define MIN_RULE_DURATION   50

// ================================================================
// Novelty Search 参数
// ================================================================
#define NOVELTY_ARCHIVE_MAX    200
#define NOVELTY_K_NEAREST      5
#define NOVELTY_ADD_THRESHOLD  0.15f

// ================================================================
// 存储参数
// ================================================================
#define STORAGE_SAVE_INTERVAL_MS  10000
#define FRAME_LOG_SIZE            4096
#define RAM_LOG_BUFFER_SIZE       6000
#define SPIFFS_MAX_GENERATIONS    5
#define SPIFFS_MAX_INDIVIDUALS    2
#define INCREMENTAL_SAVE_INTERVAL 500

// ================================================================
// 固件版本
// ================================================================
#define FIRMWARE_VERSION "v9.9-ChaosFix+WebRefactor"
#define VERSION_MARKER_FILE "/version_" FIRMWARE_VERSION ".mrk"

// ================================================================
// 卡死检测参数 ★ v9.8 滑动窗口 ★
// ================================================================
#define ENCODER_DIFF_THRESHOLD   30
#define ENCODER_STUCK_DURATION   1000
#define ENCODER_DIFF_MIN         5
#define WHEEL_SPIN_THRESHOLD     20
#define WHEEL_STOP_THRESHOLD     3
#define STUCK_WINDOW_SIZE        10

// ================================================================
// 混沌超时参数
// ================================================================
#define CHAOS_TIMEOUT_MS        2000
#define CHAOS_NOISE_AMPLIFIER   180
#define CHAOS_MIN_PWM           20
#define CHAOS_RECOVER_STABLE_FRAMES 20
#define CHAOS_FORCE_TIMEOUT_MS  5000
#define CHAOS_ESCAPE_PWM        200

// ================================================================
// ★ v9.9 状态枚举 - 单一状态变量 ★
// ================================================================
enum MotorState : uint8_t {
    STATE_IDLE      = 0,
    STATE_WALKING   = 1,
    STATE_STUCK     = 2,
    STATE_CHAOS     = 3,
    STATE_ESCAPING  = 4
};

// ================================================================
// 条件类型枚举
// ================================================================
enum CondType : uint8_t {
    COND_SENSOR_LEFT  = 0,
    COND_SENSOR_RIGHT = 1,
    COND_SENSOR_BOTH  = 2,
    COND_SENSOR_ANY   = 3,
    COND_DISTANCE     = 4,
    COND_TIME         = 5,
    COND_IDLE         = 6,
    COND_ALWAYS       = 7,
    COND_STUCK        = 8,
    COND_ESCAPE       = 9
};

enum CondOp : uint8_t {
    OP_GREATER = 0,
    OP_LESS    = 1,
    OP_EQUAL   = 2
};

// ================================================================
// 行为规则结构体
// ================================================================
struct BehaviorRule {
    uint8_t  condType;
    int16_t  condValue;
    uint8_t  condOp;
    int16_t  motorL;
    int16_t  motorR;
    uint16_t durationMs;
    uint8_t  nextRule;
    uint8_t  _padding;

    void randomize() {
        condType   = random(0, 10);
        condValue  = random(-3000, 3000);
        condOp     = random(0, 3);
        motorL     = random(-255, 255);
        motorR     = random(-255, 255);
        durationMs = random(MIN_RULE_DURATION, MAX_RULE_DURATION);
        nextRule   = random(0, 3);
        _padding   = 0;
    }
    
    void clamp() {
        motorL     = constrain(motorL, -255, 255);
        motorR     = constrain(motorR, -255, 255);
        durationMs = constrain(durationMs, MIN_RULE_DURATION, MAX_RULE_DURATION);
        condType   = constrain(condType, (uint8_t)0, (uint8_t)9);
        condOp     = constrain(condOp, (uint8_t)0, (uint8_t)2);
    }
    
    bool compare(int value, int op, int threshold) const {
        switch (op) {
            case OP_GREATER: return value > threshold;
            case OP_LESS:    return value < threshold;
            case OP_EQUAL:   return abs(value - threshold) < 50;
            default: return false;
        }
    }
};

// ================================================================
// 行为描述符
// ================================================================
struct BehaviorDescriptor {
    float leftSensorMean, rightSensorMean;
    float sensorVariance, sensorAsymmetry;
    float avgSpeed, speedVariance, turnBias, totalDistance;
    float forwardRatio, turnRatio, reverseRatio, idleRatio;

    void init() {
        leftSensorMean = rightSensorMean = 0;
        sensorVariance = sensorAsymmetry = 0;
        avgSpeed = speedVariance = turnBias = totalDistance = 0;
        forwardRatio = turnRatio = reverseRatio = idleRatio = 0;
    }

    float distance(const BehaviorDescriptor& other) const {
        float sum = 0, d;
        d = leftSensorMean - other.leftSensorMean; sum += d*d;
        d = rightSensorMean - other.rightSensorMean; sum += d*d;
        d = sensorVariance - other.sensorVariance; sum += d*d;
        d = sensorAsymmetry - other.sensorAsymmetry; sum += d*d;
        d = avgSpeed - other.avgSpeed; sum += d*d;
        d = speedVariance - other.speedVariance; sum += d*d;
        d = turnBias - other.turnBias; sum += d*d;
        d = totalDistance - other.totalDistance; sum += d*d;
        d = forwardRatio - other.forwardRatio; sum += d*d;
        d = turnRatio - other.turnRatio; sum += d*d;
        d = reverseRatio - other.reverseRatio; sum += d*d;
        d = idleRatio - other.idleRatio; sum += d*d;
        return sqrtf(sum);
    }

    void normalize(const BehaviorDescriptor& maxVals) {
        if (maxVals.leftSensorMean > 0) leftSensorMean /= maxVals.leftSensorMean;
        if (maxVals.rightSensorMean > 0) rightSensorMean /= maxVals.rightSensorMean;
        if (maxVals.sensorVariance > 0) sensorVariance /= maxVals.sensorVariance;
        if (maxVals.avgSpeed > 0) avgSpeed /= maxVals.avgSpeed;
        if (maxVals.speedVariance > 0) speedVariance /= maxVals.speedVariance;
        if (maxVals.totalDistance > 0) totalDistance /= maxVals.totalDistance;
    }
};

// ================================================================
// ★ v9.8-RAMLogBuffer 帧日志条目 ★
// ================================================================
struct FrameLogEntry {
    uint32_t timestamp_ms;
    int16_t  sensorLeft;
    int16_t  sensorRight;
    uint8_t  motorLeftPWM;
    uint8_t  motorRightPWM;
    uint8_t  directionL : 1;
    uint8_t  directionR : 1;
    uint8_t  chaosActive : 1;
    uint8_t  state : 3;          // ★ MotorState 枚举值
    uint8_t  reserved : 2;
};

// ================================================================
// 压缩帧日志条目 (11 bytes)
// ================================================================
struct CompressedFrameEntry {
    uint32_t timestamp_ms;
    int16_t  sensorLeft;
    int16_t  sensorRight;
    int8_t   motorLeftPWM;
    int8_t   motorRightPWM;
    uint8_t  directionL : 1;
    uint8_t  directionR : 1;
    uint8_t  chaosActive : 1;
    uint8_t  state : 3;
    uint8_t  reserved : 2;
};

// ================================================================
// 文件头 (带CRC校验)
// ================================================================
struct FileHeader {
    uint32_t magic;
    uint16_t version;
    uint16_t headerSize;
    uint32_t crc32;
    uint32_t frameCount;
    uint32_t generation;
    uint16_t individual;
    uint16_t reserved;
};

// ================================================================
// 历史记录
// ================================================================
struct HistoryRecord {
    uint32_t timestamp;
    uint32_t generation;
    float    noveltyScore;
    uint32_t survivalTime;
    int32_t  distance_ticks;
    uint8_t  ruleCount;
    uint8_t  reserved[3];
};

// ================================================================
// 混沌实验记录
// ================================================================
struct ChaoticTestRecord {
    uint32_t timestamp;
    uint32_t generation;
    uint32_t individual;
    uint32_t chaosTriggerCount;
    uint32_t chaosTotalDuration;
    uint32_t chaosMaxDuration;
    uint32_t chaosFirstTime;
    uint32_t chaosLastTime;
    int32_t  baselineDistance;
    int32_t  chaosDistance;
    uint16_t baselineFrames;
    uint16_t chaosFrames;
    float    baselineAvgSpeedL;
    float    baselineAvgSpeedR;
    float    chaosAvgSpeedL;
    float    chaosAvgSpeedR;
    uint8_t  chaosSuccess;
    uint8_t  testTerminatedBy;
    uint8_t  reserved[2];
};

// ================================================================
// 前向声明
// ================================================================
struct Gene;
class Logger;
class SensorCalibration;
class RobustStorage;
class GeneStorage;
class NoveltyArchive;
class MotorController;
class EvolutionEngine;
class CarWebServer;
class RAMLogBuffer;
class RollingStorage;

// ================================================================
// Logger 类
// ================================================================
class Logger {
public:
    static void init() { Serial.begin(115200); delay(500); }
    static void log(const char* msg) {
        Serial.println("[OE] " + String(millis()/1000) + "s " + String(msg));
    }
    static void logf(const char* fmt, ...) {
        char buf[256];
        va_list args;
        va_start(args, fmt);
        vsnprintf(buf, sizeof(buf), fmt, args);
        va_end(args);
        log(buf);
    }
};

// ================================================================
// SensorCalibration 类
// ================================================================
class SensorCalibration {
private:
    static int leftBase, rightBase;
    
public:
    static void calibrate() {
        Logger::log("Sensor calibrating...");
        delay(1000);
        const int samples = 50;
        long sumL = 0, sumR = 0;
        for (int i = 0; i < samples; i++) {
            sumL += analogRead(PIN_SENSOR_LEFT);
            sumR += analogRead(PIN_SENSOR_RIGHT);
            delay(10);
        }
        leftBase = sumL / samples;
        rightBase = sumR / samples;
        Logger::logf("Calibration done: L=%d R=%d", leftBase, rightBase);
    }
    
    static int getLeftRaw() { return analogRead(PIN_SENSOR_LEFT); }
    static int getRightRaw() { return analogRead(PIN_SENSOR_RIGHT); }
    static bool isObstacleLeft() { return analogRead(PIN_SENSOR_LEFT) > OBSTACLE_ADC_THRESH; }
    static bool isObstacleRight() { return analogRead(PIN_SENSOR_RIGHT) > OBSTACLE_ADC_THRESH; }
    static bool isClear() {
        return (analogRead(PIN_SENSOR_LEFT) < CLEAR_ADC_THRESH && 
                analogRead(PIN_SENSOR_RIGHT) < CLEAR_ADC_THRESH);
    }
    static uint16_t readNoise() { return analogRead(PIN_NOISE_SOURCE); }  // ★ GPIO1
};

int SensorCalibration::leftBase = 0;
int SensorCalibration::rightBase = 0;

// ================================================================
// RobustStorage 类
// ================================================================
class RobustStorage {
private:
    static const char* HISTORY_FILE;
    static bool fsReady;
    static uint32_t lastSaveTime;
    static uint32_t unsavedCount;
    static uint32_t totalSaved;
    static String pendingBuffer;
    static const size_t MAX_BUFFER_SIZE = 4096;
    static HistoryRecord ramHistory[1000];
    static int ramHistoryCount;

    static bool appendToFile(const char* path, const String& data) {
        if (!fsReady) return false;
        File file = SPIFFS.open(path, FILE_APPEND);
        if (!file) {
            file = SPIFFS.open(path, FILE_WRITE);
            if (!file) return false;
        }
        size_t written = file.print(data);
        file.close();
        return written == data.length();
    }

    static void loadHistory() {
        if (!fsReady) return;
        File file = SPIFFS.open(HISTORY_FILE, FILE_READ);
        if (!file) return;
        int count = 0;
        while (file.available() && count < 1000) {
            String line = file.readStringUntil('\n');
            if (line.length() < 10) continue;
            int partIdx = 0;
            String parts[6];
            for (int i = 0; i < line.length() && partIdx < 6; i++) {
                if (line[i] == ',') { partIdx++; continue; }
                parts[partIdx] += line[i];
            }
            if (partIdx == 5) {
                ramHistory[count].timestamp = parts[0].toInt();
                ramHistory[count].generation = parts[1].toInt();
                ramHistory[count].noveltyScore = parts[2].toFloat();
                ramHistory[count].survivalTime = parts[3].toInt();
                ramHistory[count].distance_ticks = parts[4].toInt();
                ramHistory[count].ruleCount = parts[5].toInt();
                count++;
            }
        }
        ramHistoryCount = count;
        file.close();
    }

public:
    static void init() {
        fsReady = false;
        lastSaveTime = 0;
        unsavedCount = 0;
        totalSaved = 0;
        ramHistoryCount = 0;
        pendingBuffer.reserve(MAX_BUFFER_SIZE);
        if (!SPIFFS.begin(true)) {
            Logger::log("SPIFFS mount failed, using RAM mode");
            fsReady = false;
        } else {
            fsReady = true;
            Logger::log("SPIFFS mounted successfully");
            loadHistory();
        }
    }

    static void addRecord(const HistoryRecord& record) {
        if (ramHistoryCount < 1000) {
            ramHistory[ramHistoryCount++] = record;
        } else {
            for (int i = 1; i < 1000; i++) ramHistory[i-1] = ramHistory[i];
            ramHistory[999] = record;
        }
        char line[256];
        snprintf(line, sizeof(line), "%lu,%lu,%.4f,%lu,%ld,%d\n",
                 record.timestamp, record.generation, record.noveltyScore,
                 record.survivalTime, record.distance_ticks, record.ruleCount);
        pendingBuffer += String(line);
        unsavedCount++;
        totalSaved++;
        if (pendingBuffer.length() > MAX_BUFFER_SIZE || unsavedCount >= 5) flushBuffer();
    }

    static bool flushBuffer() {
        if (pendingBuffer.length() == 0) { unsavedCount = 0; return true; }
        if (!fsReady) {
            pendingBuffer = "";
            unsavedCount = 0;
            lastSaveTime = millis();
            return true;
        }
        bool success = appendToFile(HISTORY_FILE, pendingBuffer);
        if (success) {
            pendingBuffer = "";
            unsavedCount = 0;
            lastSaveTime = millis();
        }
        return success;
    }

    static void forceSave() { if (pendingBuffer.length() > 0) flushBuffer(); }
    static bool isReady() { return fsReady; }
    static uint32_t getTotalSaved() { return totalSaved; }
    static void tick() {
        if (millis() - lastSaveTime > STORAGE_SAVE_INTERVAL_MS && pendingBuffer.length() > 0) flushBuffer();
    }
    static void clearAll() { pendingBuffer = ""; unsavedCount = 0; ramHistoryCount = 0; }
    static String getCSVData() {
        if (pendingBuffer.length() > 0) flushBuffer();
        if (fsReady) {
            File file = SPIFFS.open(HISTORY_FILE, FILE_READ);
            if (file) { String content = file.readString(); file.close(); return content; }
        }
        String csv = "timestamp,generation,noveltyScore,survivalTime,distance_ticks,ruleCount\n";
        for (int i = 0; i < ramHistoryCount; i++) {
            csv += String(ramHistory[i].timestamp) + ",";
            csv += String(ramHistory[i].generation) + ",";
            csv += String(ramHistory[i].noveltyScore, 4) + ",";
            csv += String(ramHistory[i].survivalTime) + ",";
            csv += String(ramHistory[i].distance_ticks) + ",";
            csv += String(ramHistory[i].ruleCount) + "\n";
        }
        return csv;
    }

    static const char* CHAOS_HISTORY_FILE;

    static void addChaosRecord(const ChaoticTestRecord& record) {
        if (!fsReady) return;
        char line[512];
        snprintf(line, sizeof(line),
            "%lu,%lu,%d,%d,%lu,%lu,%lu,%lu,%ld,%ld,%d,%d,%.2f,%.2f,%.2f,%.2f,%d,%d\n",
            record.timestamp, record.generation, record.individual,
            record.chaosTriggerCount, record.chaosTotalDuration,
            record.chaosMaxDuration, record.chaosFirstTime,
            record.chaosLastTime,
            (long)record.baselineDistance, (long)record.chaosDistance,
            record.baselineFrames, record.chaosFrames,
            record.baselineAvgSpeedL, record.baselineAvgSpeedR,
            record.chaosAvgSpeedL, record.chaosAvgSpeedR,
            record.chaosSuccess, record.testTerminatedBy);
        File file = SPIFFS.open(CHAOS_HISTORY_FILE, FILE_APPEND);
        if (!file) {
            file = SPIFFS.open(CHAOS_HISTORY_FILE, FILE_WRITE);
            if (!file) return;
            file.print("timestamp,generation,individual,chaosTriggerCount,chaosTotalDuration,"
                       "chaosMaxDuration,chaosFirstTime,chaosLastTime,"
                       "baselineDistance,chaosDistance,baselineFrames,chaosFrames,"
                       "baselineAvgSpeedL,baselineAvgSpeedR,chaosAvgSpeedL,chaosAvgSpeedR,"
                       "chaosSuccess,testTerminatedBy\n");
        }
        if (file) { file.print(line); file.close(); }
    }

    static String getChaosHistoryCSV() {
        if (!fsReady) return "";
        File file = SPIFFS.open(CHAOS_HISTORY_FILE, FILE_READ);
        if (!file) return "";
        String content = file.readString();
        file.close();
        return content;
    }
};

const char* RobustStorage::HISTORY_FILE = "/oe_history.csv";
const char* RobustStorage::CHAOS_HISTORY_FILE = "/chaos_history.csv";
bool RobustStorage::fsReady = false;
uint32_t RobustStorage::lastSaveTime = 0;
uint32_t RobustStorage::unsavedCount = 0;
uint32_t RobustStorage::totalSaved = 0;
String RobustStorage::pendingBuffer = "";
HistoryRecord RobustStorage::ramHistory[1000];
int RobustStorage::ramHistoryCount = 0;

// ================================================================
// FirmwareVersionManager 类
// ================================================================
class FirmwareVersionManager {
public:
    static bool isNewVersion() {
        if (!RobustStorage::isReady()) return true;
        if (!SPIFFS.exists(VERSION_MARKER_FILE)) return true;
        File marker = SPIFFS.open(VERSION_MARKER_FILE, FILE_READ);
        if (!marker) return true;
        String savedVersion = marker.readString();
        marker.close();
        savedVersion.trim();
        return savedVersion != String(FIRMWARE_VERSION);
    }
    
    static void cleanAllData() {
        if (!RobustStorage::isReady()) return;
        File root = SPIFFS.open("/");
        if (!root) return;
        while (File file = root.openNextFile()) {
            String name = String(file.name());
            bool shouldDelete = false;
            if (name.startsWith("/pop_gen_")) shouldDelete = true;
            if (name.startsWith("/gen_")) shouldDelete = true;
            if (name.startsWith("/frm_")) shouldDelete = true;
            if (name == "/oe_history.csv") shouldDelete = true;
            if (name == "/experiment_state.mrk") shouldDelete = true;
            if (name.startsWith("/version_") && name != String(VERSION_MARKER_FILE)) shouldDelete = true;
            if (shouldDelete) { file.close(); SPIFFS.remove(name); }
        }
        root.close();
        writeVersionMarker();
    }
    
    static void writeVersionMarker() {
        if (!RobustStorage::isReady()) return;
        if (SPIFFS.exists(VERSION_MARKER_FILE)) SPIFFS.remove(VERSION_MARKER_FILE);
        File marker = SPIFFS.open(VERSION_MARKER_FILE, FILE_WRITE);
        if (marker) { marker.println(FIRMWARE_VERSION); marker.close(); }
    }
};

// ================================================================
// CRC32工具
// ================================================================
class CRC32 {
public:
    static uint32_t calculate(const uint8_t* data, size_t len) {
        uint32_t crc = 0xFFFFFFFF;
        for (size_t i = 0; i < len; i++) {
            crc ^= data[i];
            for (int j = 0; j < 8; j++) {
                if (crc & 1) crc = (crc >> 1) ^ 0xEDB88320;
                else crc >>= 1;
            }
        }
        return ~crc;
    }
    
    static bool verify(const uint8_t* data, size_t len, uint32_t expected) {
        return calculate(data, len) == expected;
    }
};

// ================================================================
// FileUtils 类
// ================================================================
class FileUtils {
public:
    static bool atomicWrite(const String& path, const uint8_t* data, size_t len) {
        if (!RobustStorage::isReady()) return false;
        String tempPath = path + ".tmp";
        if (SPIFFS.exists(tempPath)) SPIFFS.remove(tempPath);
        File tempFile = SPIFFS.open(tempPath, FILE_WRITE);
        if (!tempFile) return false;
        size_t written = tempFile.write(data, len);
        tempFile.close();
        if (written != len) { SPIFFS.remove(tempPath); return false; }
        if (SPIFFS.exists(path)) SPIFFS.remove(path);
        if (!SPIFFS.rename(tempPath, path)) { SPIFFS.remove(tempPath); return false; }
        return true;
    }
    
    static bool atomicWriteString(const String& path, const String& content) {
        return atomicWrite(path, (const uint8_t*)content.c_str(), content.length());
    }
    
    static String safeRead(const String& path) {
        if (!RobustStorage::isReady()) return "";
        if (!SPIFFS.exists(path)) return "";
        File file = SPIFFS.open(path, FILE_READ);
        if (!file) return "";
        String content = file.readString();
        file.close();
        return content;
    }
    
    static size_t getFileSize(const String& path) {
        if (!RobustStorage::isReady()) return 0;
        if (!SPIFFS.exists(path)) return 0;
        File file = SPIFFS.open(path, FILE_READ);
        if (!file) return 0;
        size_t size = file.size();
        file.close();
        return size;
    }
};

// ================================================================
// Gene 结构体
// ================================================================
struct Gene {
    uint8_t ruleCount;
    BehaviorRule rules[MAX_RULES];
    uint32_t survival_time;
    int32_t  distance_ticks;
    float noveltyScore;
    BehaviorDescriptor behavior;

    void init() {
        ruleCount = random(MIN_RULES, MAX_RULES + 1);
        for (int i = 0; i < ruleCount; i++) rules[i].randomize();
        survival_time = 0; distance_ticks = 0;
        noveltyScore = 0; behavior.init();
    }

    bool evaluateCondition(int ruleIdx, int leftSensor, int rightSensor, 
                           int32_t distance, uint32_t elapsed) const;

    void mutate(float mutationRate) {
        for (int i = 0; i < ruleCount; i++) {
            if (random(0, 1000) < mutationRate * 1000) { rules[i].condValue += random(-200,200); rules[i].clamp(); }
            if (random(0, 1000) < mutationRate * 1000) { rules[i].motorL += random(-50,50); rules[i].clamp(); }
            if (random(0, 1000) < mutationRate * 1000) { rules[i].motorR += random(-50,50); rules[i].clamp(); }
            if (random(0, 1000) < mutationRate * 500) { rules[i].durationMs += random(-200,200); rules[i].clamp(); }
            if (random(0, 1000) < mutationRate * 300) { rules[i].condType = random(0, 10); }
            if (random(0, 1000) < mutationRate * 300) { rules[i].condOp = random(0, 3); }
            if (random(0, 1000) < mutationRate * 200) { rules[i].nextRule = random(0, min(ruleCount, (uint8_t)3)); }
        }
        if (random(0, 1000) < mutationRate * 150 && ruleCount < MAX_RULES) {
            rules[ruleCount].randomize(); ruleCount++;
        }
        if (random(0, 1000) < mutationRate * 100 && ruleCount > MIN_RULES) {
            int delIdx = random(0, ruleCount); rules[delIdx] = rules[ruleCount - 1]; ruleCount--;
        }
        if (random(0, 1000) < mutationRate * 80 && ruleCount >= 2) {
            int a = random(0, ruleCount), b = random(0, ruleCount);
            if (a != b) { BehaviorRule tmp = rules[a]; rules[a] = rules[b]; rules[b] = tmp; }
        }
    }

    static void crossover(const Gene& p1, const Gene& p2, Gene& child) {
        int cut1 = random(0, p1.ruleCount), cut2 = random(0, p2.ruleCount);
        int fromP1 = cut1, fromP2 = p2.ruleCount - cut2;
        child.ruleCount = constrain(fromP1 + fromP2, MIN_RULES, MAX_RULES);
        for (int i = 0; i < fromP1 && i < child.ruleCount; i++) child.rules[i] = p1.rules[i];
        for (int i = 0; i < fromP2 && (fromP1 + i) < child.ruleCount; i++) child.rules[fromP1 + i] = p2.rules[cut2 + i];
        for (int i = fromP1 + fromP2; i < child.ruleCount; i++) child.rules[i] = p1.rules[i % p1.ruleCount];
        child.survival_time = 0; child.distance_ticks = 0;
        child.noveltyScore = 0; child.behavior.init();
    }
};

// ================================================================
// GeneStorage 类
// ================================================================
class GeneStorage {
private:
    static const uint32_t MAX_GENERATIONS_PER_EXPERIMENT = 20;
    static const uint16_t FILE_VERSION = 0x0004;
    static const uint32_t FILE_MAGIC = 0x47454E45;
    static const char* POP_PREFIX;
    static const char* GEN_RECORD_PREFIX;
    static const char* FRAME_LOG_PREFIX;
    static const char* EXPERIMENT_MARKER;
    static uint32_t currentExperimentId;
    static uint32_t currentGeneration;
    static bool experimentActive;
    
public:
    static void init() {
        currentExperimentId = 0;
        currentGeneration = 0;
        experimentActive = false;
        if (!RobustStorage::isReady()) {
            Logger::log("SPIFFS unavailable, using RAM mode");
            return;
        }
        loadExperimentState();
        Logger::logf("Gene storage initialized");
    }
    
    static void startNewExperiment() {
        if (!RobustStorage::isReady()) return;
        clearAllExperimentData();
        currentExperimentId = (uint32_t)millis();
        currentGeneration = 0;
        experimentActive = true;
        saveExperimentState();
        Logger::logf("New experiment started (ID: %lu)", currentExperimentId);
    }
    
    static bool shouldStartNewExperiment() {
        if (!RobustStorage::isReady()) return true;
        if (!SPIFFS.exists(EXPERIMENT_MARKER)) return true;
        String content = FileUtils::safeRead(EXPERIMENT_MARKER);
        if (content.length() == 0) return true;
        int commaPos = content.indexOf(',');
        if (commaPos < 0) return true;
        uint32_t expId = content.substring(0, commaPos).toInt();
        uint32_t gen = content.substring(commaPos + 1).toInt();
        if (gen >= MAX_GENERATIONS_PER_EXPERIMENT) {
            Logger::logf("Previous experiment completed (ID: %lu, gens: %lu)", expId, gen);
            return true;
        }
        currentExperimentId = expId;
        currentGeneration = gen;
        experimentActive = true;
        Logger::logf("Resuming experiment (ID: %lu, gen: %lu)", expId, gen);
        return false;
    }
    
    static bool isExperimentActive() { return experimentActive; }
    static uint32_t getCurrentGeneration() { return currentGeneration; }
    static uint32_t getMaxGenerations() { return MAX_GENERATIONS_PER_EXPERIMENT; }
    static float getProgress() { return (float)currentGeneration / MAX_GENERATIONS_PER_EXPERIMENT; }
    static bool isExperimentComplete() { return currentGeneration >= MAX_GENERATIONS_PER_EXPERIMENT; }
    static void incrementGeneration() { currentGeneration++; saveExperimentState(); }
    
    static bool savePopulation(Gene* population, int size) {
        if (!RobustStorage::isReady() || !experimentActive) return false;
        size_t totalSize = 4 + 2 + 2 + 4 + 4;
        for (int i = 0; i < size; i++) {
            totalSize += 1 + population[i].ruleCount * sizeof(BehaviorRule) + 12;
        }
        uint8_t* buffer = (uint8_t*)malloc(totalSize);
        if (!buffer) return false;
        uint8_t* ptr = buffer;
        uint32_t magic = FILE_MAGIC; memcpy(ptr, &magic, 4); ptr += 4;
        uint16_t version = FILE_VERSION; memcpy(ptr, &version, 2); ptr += 2;
        uint16_t popSize = size; memcpy(ptr, &popSize, 2); ptr += 2;
        uint32_t gen = currentGeneration; memcpy(ptr, &gen, 4); ptr += 4;
        uint32_t expId = currentExperimentId; memcpy(ptr, &expId, 4); ptr += 4;
        for (int i = 0; i < size; i++) {
            *ptr = population[i].ruleCount; ptr += 1;
            for (int j = 0; j < population[i].ruleCount; j++) {
                memcpy(ptr, &population[i].rules[j], sizeof(BehaviorRule));
                ptr += sizeof(BehaviorRule);
            }
            memcpy(ptr, &population[i].survival_time, 4); ptr += 4;
            memcpy(ptr, &population[i].distance_ticks, 4); ptr += 4;
            memcpy(ptr, &population[i].noveltyScore, 4); ptr += 4;
        }
        String path = String(POP_PREFIX) + String(currentGeneration) + ".bin";
        bool success = FileUtils::atomicWrite(path, buffer, totalSize);
        free(buffer);
        Logger::logf("💾 savePopulation gen=%lu -> %s %s", currentGeneration, path.c_str(), success ? "✅ OK" : "❌ FAILED");
        return success;
    }
    
    static bool saveIndividualRecord(uint32_t generation, int individual, const Gene& gene) {
        if (!RobustStorage::isReady() || !experimentActive) {
            return false;
        }
        String path = String(GEN_RECORD_PREFIX) + String(generation) + "_id_" + String(individual) + ".csv";
        String content = "ruleIndex,condType,condValue,condOp,motorL,motorR,durationMs,nextRule,survival_time,distance_ticks,noveltyScore\n";
        for (int i = 0; i < gene.ruleCount; i++) {
            const BehaviorRule& r = gene.rules[i];
            content += String(i) + "," + String(r.condType) + "," + String(r.condValue) + ",";
            content += String(r.condOp) + "," + String(r.motorL) + "," + String(r.motorR) + ",";
            content += String(r.durationMs) + "," + String(r.nextRule) + ",";
            content += String(gene.survival_time) + "," + String(gene.distance_ticks) + ",";
            content += String(gene.noveltyScore, 6) + "\n";
        }
        bool success = FileUtils::atomicWriteString(path, content);
        return success;
    }
    
    static bool saveChaosRecord(const ChaoticTestRecord& record) {
        if (!RobustStorage::isReady()) return false;
        String path = "/chaos_g" + String(record.generation) + "_i" + String(record.individual) + ".csv";
        String csv = "timestamp,generation,individual,chaosTriggerCount,chaosTotalDuration,"
                     "chaosMaxDuration,chaosFirstTime,chaosLastTime,"
                     "baselineDistance,chaosDistance,baselineFrames,chaosFrames,"
                     "baselineAvgSpeedL,baselineAvgSpeedR,chaosAvgSpeedL,chaosAvgSpeedR,"
                     "chaosSuccess,testTerminatedBy\n";
        char line[512];
        snprintf(line, sizeof(line),
            "%lu,%lu,%d,%d,%lu,%lu,%lu,%lu,%ld,%ld,%d,%d,%.2f,%.2f,%.2f,%.2f,%d,%d\n",
            record.timestamp, record.generation, record.individual,
            record.chaosTriggerCount, record.chaosTotalDuration,
            record.chaosMaxDuration, record.chaosFirstTime,
            record.chaosLastTime,
            (long)record.baselineDistance, (long)record.chaosDistance,
            record.baselineFrames, record.chaosFrames,
            record.baselineAvgSpeedL, record.baselineAvgSpeedR,
            record.chaosAvgSpeedL, record.chaosAvgSpeedR,
            record.chaosSuccess, record.testTerminatedBy);
        csv += line;
        bool success = FileUtils::atomicWriteString(path, csv);
        return success;
    }

    static bool loadPopulation(uint32_t generation, Gene* population, int size) {
        if (!RobustStorage::isReady()) return false;
        String path = String(POP_PREFIX) + String(generation) + ".bin";
        size_t fileSize = FileUtils::getFileSize(path);
        if (fileSize == 0) return false;
        File file = SPIFFS.open(path, FILE_READ);
        if (!file) return false;
        uint8_t* buffer = (uint8_t*)malloc(fileSize);
        if (!buffer) { file.close(); return false; }
        file.read(buffer, fileSize);
        file.close();
        uint8_t* ptr = buffer;
        uint32_t magic; memcpy(&magic, ptr, 4); ptr += 4;
        if (magic != FILE_MAGIC) { free(buffer); return false; }
        ptr += 2;
        uint16_t popSize; memcpy(&popSize, ptr, 2); ptr += 2;
        if (popSize != size) { free(buffer); return false; }
        ptr += 4; ptr += 4;
        for (int i = 0; i < size; i++) {
            population[i].ruleCount = *ptr; ptr += 1;
            for (int j = 0; j < population[i].ruleCount && j < MAX_RULES; j++) {
                memcpy(&population[i].rules[j], ptr, sizeof(BehaviorRule));
                ptr += sizeof(BehaviorRule);
            }
            memcpy(&population[i].survival_time, ptr, 4); ptr += 4;
            memcpy(&population[i].distance_ticks, ptr, 4); ptr += 4;
            memcpy(&population[i].noveltyScore, ptr, 4); ptr += 4;
            population[i].behavior.init();
        }
        free(buffer);
        return true;
    }
    
    static void clearAllExperimentData() {
        if (!RobustStorage::isReady()) return;
        File root = SPIFFS.open("/");
        if (!root) return;
        while (File file = root.openNextFile()) {
            String name = String(file.name());
            if (name.startsWith("/pop_gen_") || name.startsWith("/gen_") || 
                name.startsWith("/frm_") || name == "/experiment_state.mrk" || name == "/oe_history.csv") {
                file.close();
                SPIFFS.remove(name);
            }
        }
        root.close();
        currentExperimentId = 0;
        currentGeneration = 0;
        experimentActive = false;
    }
    
private:
    static void saveExperimentState() {
        if (!RobustStorage::isReady()) return;
        String content = String(currentExperimentId) + "," + String(currentGeneration);
        FileUtils::atomicWriteString(EXPERIMENT_MARKER, content);
    }
    
    static void loadExperimentState() {
        if (!RobustStorage::isReady()) return;
        String content = FileUtils::safeRead(EXPERIMENT_MARKER);
        if (content.length() == 0) { experimentActive = false; return; }
        int commaPos = content.indexOf(',');
        if (commaPos < 0) { experimentActive = false; return; }
        currentExperimentId = content.substring(0, commaPos).toInt();
        currentGeneration = content.substring(commaPos + 1).toInt();
        experimentActive = true;
    }
};

const char* GeneStorage::POP_PREFIX = "/pop_gen_";
const char* GeneStorage::GEN_RECORD_PREFIX = "/gen_";
const char* GeneStorage::FRAME_LOG_PREFIX = "/frm_";
const char* GeneStorage::EXPERIMENT_MARKER = "/experiment_state.mrk";
uint32_t GeneStorage::currentExperimentId = 0;
uint32_t GeneStorage::currentGeneration = 0;
bool GeneStorage::experimentActive = false;

// ================================================================
// NoveltyArchive 类
// ================================================================
class NoveltyArchive {
private:
    BehaviorDescriptor archive[NOVELTY_ARCHIVE_MAX];
    int archiveSize;
    BehaviorDescriptor maxValues;

    void updateMaxValues(const BehaviorDescriptor& desc) {
        if (desc.leftSensorMean > maxValues.leftSensorMean) maxValues.leftSensorMean = desc.leftSensorMean;
        if (desc.rightSensorMean > maxValues.rightSensorMean) maxValues.rightSensorMean = desc.rightSensorMean;
        if (desc.sensorVariance > maxValues.sensorVariance) maxValues.sensorVariance = desc.sensorVariance;
        if (desc.avgSpeed > maxValues.avgSpeed) maxValues.avgSpeed = desc.avgSpeed;
        if (desc.speedVariance > maxValues.speedVariance) maxValues.speedVariance = desc.speedVariance;
        if (desc.totalDistance > maxValues.totalDistance) maxValues.totalDistance = desc.totalDistance;
    }

public:
    void init() { archiveSize = 0; maxValues.init(); }

    float computeNovelty(const BehaviorDescriptor& desc) {
        if (archiveSize == 0) return 1.0f;
        BehaviorDescriptor norm = desc;
        norm.normalize(maxValues);
        float distances[NOVELTY_ARCHIVE_MAX];
        int count = 0;
        for (int i = 0; i < archiveSize; i++) {
            BehaviorDescriptor archNorm = archive[i];
            archNorm.normalize(maxValues);
            distances[count++] = norm.distance(archNorm);
        }
        int k = min(NOVELTY_K_NEAREST, count);
        for (int i = 0; i < k; i++)
            for (int j = i + 1; j < count; j++)
                if (distances[j] < distances[i]) {
                    float tmp = distances[i]; distances[i] = distances[j]; distances[j] = tmp;
                }
        float sum = 0;
        for (int i = 0; i < k; i++) sum += distances[i];
        return sum / k;
    }

    bool addIfNovel(const BehaviorDescriptor& desc) {
        float novelty = computeNovelty(desc);
        if (novelty < NOVELTY_ADD_THRESHOLD && archiveSize > 0) return false;
        if (archiveSize < NOVELTY_ARCHIVE_MAX) {
            archive[archiveSize++] = desc;
        } else {
            archive[archiveSize % NOVELTY_ARCHIVE_MAX] = desc;
            archiveSize = (archiveSize % NOVELTY_ARCHIVE_MAX) + 1;
        }
        updateMaxValues(desc);
        return true;
    }

    BehaviorDescriptor extractFromFrameLog(const FrameLogEntry* frameLog, int frameCount, int32_t totalDistance) {
        BehaviorDescriptor desc; desc.init();
        if (frameCount == 0) return desc;
        float sumL = 0, sumR = 0, sumSpeed = 0, sumSpeedSq = 0, sumTurnDiff = 0;
        int forwardFrames = 0, turnFrames = 0, reverseFrames = 0, idleFrames = 0;
        for (int i = 0; i < frameCount; i++) {
            const FrameLogEntry& e = frameLog[i];
            sumL += e.sensorLeft; sumR += e.sensorRight;
            float speed = (e.motorLeftPWM + e.motorRightPWM) / 2.0f;
            sumSpeed += speed; sumSpeedSq += speed * speed;
            sumTurnDiff += (float)e.motorLeftPWM - (float)e.motorRightPWM;
            if (e.motorLeftPWM < 10 && e.motorRightPWM < 10) idleFrames++;
            else if (e.directionL == 0 && e.directionR == 0) reverseFrames++;
            else if (abs((int)e.motorLeftPWM - (int)e.motorRightPWM) > 50) turnFrames++;
            else forwardFrames++;
        }
        int n = frameCount;
        desc.leftSensorMean = sumL / n;
        desc.rightSensorMean = sumR / n;
        desc.avgSpeed = sumSpeed / n;
        desc.speedVariance = (sumSpeedSq / n) - (desc.avgSpeed * desc.avgSpeed);
        if (desc.speedVariance < 0) desc.speedVariance = 0;
        desc.turnBias = sumTurnDiff / (float)n / 255.0f;
        desc.sensorAsymmetry = (desc.leftSensorMean - desc.rightSensorMean) / max(desc.leftSensorMean + desc.rightSensorMean, 1.0f);
        desc.totalDistance = (float)abs(totalDistance) / 1000.0f;
        int activeFrames = n - idleFrames;
        if (activeFrames > 0) {
            desc.forwardRatio = (float)forwardFrames / activeFrames;
            desc.turnRatio = (float)turnFrames / activeFrames;
            desc.reverseRatio = (float)reverseFrames / activeFrames;
        }
        desc.idleRatio = (float)idleFrames / n;
        float varL = 0, varR = 0;
        for (int i = 0; i < frameCount; i++) {
            float dL = frameLog[i].sensorLeft - desc.leftSensorMean;
            float dR = frameLog[i].sensorRight - desc.rightSensorMean;
            varL += dL*dL; varR += dR*dR;
        }
        desc.sensorVariance = (varL + varR) / (2.0f * n);
        return desc;
    }

    int getArchiveSize() const { return archiveSize; }
};

// ================================================================
// RAMLogBuffer 类
// ================================================================
class RAMLogBuffer {
private:
    static CompressedFrameEntry buffer[RAM_LOG_BUFFER_SIZE];
    static int head;
    static int count;
    static uint32_t generation;
    static int individual;
    static bool hasData;
    static uint32_t testStartTime;
    
    static CompressedFrameEntry compressFrame(const FrameLogEntry& src, const FrameLogEntry* prev) {
        CompressedFrameEntry dst;
        dst.timestamp_ms = src.timestamp_ms;
        dst.sensorLeft = src.sensorLeft;
        dst.sensorRight = src.sensorRight;
        dst.directionL = src.directionL;
        dst.directionR = src.directionR;
        dst.chaosActive = src.chaosActive;
        dst.state = src.state;
        dst.reserved = 0;
        
        if (prev) {
            dst.motorLeftPWM = constrain(src.motorLeftPWM - prev->motorLeftPWM, -128, 127);
            dst.motorRightPWM = constrain(src.motorRightPWM - prev->motorRightPWM, -128, 127);
        } else {
            dst.motorLeftPWM = src.motorLeftPWM;
            dst.motorRightPWM = src.motorRightPWM;
        }
        return dst;
    }
    
public:
    static void init() {
        head = 0;
        count = 0;
        generation = 0;
        individual = -1;
        hasData = false;
        testStartTime = 0;
        memset(buffer, 0, sizeof(buffer));
        Logger::logf("RAMLogBuffer initialized (%d frames)", RAM_LOG_BUFFER_SIZE);
    }
    
    static void startNewTest(uint32_t gen, int ind) {
        head = 0;
        count = 0;
        generation = gen;
        individual = ind;
        hasData = true;
        testStartTime = millis();
    }
    
    static void addFrame(const FrameLogEntry& frame) {
        if (!hasData) return;
        
        const FrameLogEntry* prev = NULL;
        static FrameLogEntry prevFrame;
        if (count > 0) {
            prev = &prevFrame;
        }
        
        CompressedFrameEntry compressed = compressFrame(frame, prev);
        buffer[head] = compressed;
        prevFrame = frame;
        
        head = (head + 1) % RAM_LOG_BUFFER_SIZE;
        if (count < RAM_LOG_BUFFER_SIZE) count++;
    }
    
    static String extractFrames(int startFrame, int endFrame) {
        if (!hasData || count == 0) return "No data available\n";
        
        if (startFrame < 0) startFrame = 0;
        if (endFrame >= count) endFrame = count - 1;
        if (startFrame > endFrame) return "Invalid range\n";
        
        int framesToExtract = endFrame - startFrame + 1;
        if (framesToExtract > 2000) {
            return "Too many frames (max 2000 per request)\n";
        }
        
        int startPos = (head - count + startFrame + RAM_LOG_BUFFER_SIZE) % RAM_LOG_BUFFER_SIZE;
        
        String output = "=== RAM Log Extract ===\n";
        output += "Generation: " + String(generation) + "\n";
        output += "Individual: " + String(individual) + "\n";
        output += "Frames: " + String(startFrame) + "-" + String(endFrame) + 
                  " (total " + String(count) + " frames)\n";
        output += "Time(ms) | SensorL | SensorR | PWM_L | PWM_R | State\n";
        output += "---------|---------|---------|-------|-------|-------\n";
        
        int pwmL = 0, pwmR = 0;
        for (int i = 0; i < framesToExtract; i++) {
            int idx = (startPos + i) % RAM_LOG_BUFFER_SIZE;
            const CompressedFrameEntry& e = buffer[idx];
            
            pwmL = constrain(pwmL + e.motorLeftPWM, 0, 255);
            pwmR = constrain(pwmR + e.motorRightPWM, 0, 255);
            if (i == 0) {
                pwmL = e.motorLeftPWM;
                pwmR = e.motorRightPWM;
            }
            
            const char* stateNames[] = {"IDLE", "WALK", "STUCK", "CHAOS", "ESCAP"};
            output += String(e.timestamp_ms) + " | " +
                      String(e.sensorLeft) + " | " +
                      String(e.sensorRight) + " | " +
                      String(pwmL) + " | " +
                      String(pwmR) + " | " +
                      String(stateNames[e.state & 0x07]) + "\n";
        }
        return output;
    }
    
    static size_t extractBinary(uint8_t* outBuffer, size_t maxSize, 
                                int startFrame, int endFrame) {
        if (!hasData || count == 0 || outBuffer == NULL) return 0;
        
        if (startFrame < 0) startFrame = 0;
        if (endFrame >= count) endFrame = count - 1;
        if (startFrame > endFrame) return 0;
        
        int framesToExtract = min(endFrame - startFrame + 1, 
                                  (int)(maxSize / sizeof(CompressedFrameEntry)));
        int startPos = (head - count + startFrame + RAM_LOG_BUFFER_SIZE) % RAM_LOG_BUFFER_SIZE;
        
        uint8_t* ptr = outBuffer;
        for (int i = 0; i < framesToExtract; i++) {
            int idx = (startPos + i) % RAM_LOG_BUFFER_SIZE;
            memcpy(ptr, &buffer[idx], sizeof(CompressedFrameEntry));
            ptr += sizeof(CompressedFrameEntry);
        }
        return framesToExtract * sizeof(CompressedFrameEntry);
    }
    
    static int getFrameCount() { return count; }
    static uint32_t getGeneration() { return generation; }
    static int getIndividual() { return individual; }
    static bool hasDataAvailable() { return hasData && count > 0; }
    static void clear() { head = 0; count = 0; hasData = false; }
};

CompressedFrameEntry RAMLogBuffer::buffer[RAM_LOG_BUFFER_SIZE];
int RAMLogBuffer::head = 0;
int RAMLogBuffer::count = 0;
uint32_t RAMLogBuffer::generation = 0;
int RAMLogBuffer::individual = -1;
bool RAMLogBuffer::hasData = false;
uint32_t RAMLogBuffer::testStartTime = 0;

// ================================================================
// RollingStorage 类
// ================================================================
class RollingStorage {
private:
    static const int MAX_GENERATIONS = SPIFFS_MAX_GENERATIONS;
    static const int MAX_INDIVIDUALS_PER_GEN = SPIFFS_MAX_INDIVIDUALS;
    static uint32_t freeSpaceThreshold;
    static int savedCount[100];
    
    static size_t getFreeSpace() {
        if (!RobustStorage::isReady()) return 0;
        size_t used = 0;
        File root = SPIFFS.open("/");
        if (!root) return 0;
        while (File f = root.openNextFile()) {
            used += f.size();
            f.close();
        }
        root.close();
        size_t total = 1572864;
        return (total > used) ? (total - used) : 0;
    }
    
    static std::vector<uint32_t> getStoredGenerations() {
        std::vector<uint32_t> gens;
        if (!RobustStorage::isReady()) return gens;
        File root = SPIFFS.open("/");
        if (!root) return gens;
        while (File f = root.openNextFile()) {
            String name = String(f.name());
            if (name.startsWith("/pop_gen_")) {
                String numStr = name.substring(9, name.lastIndexOf('.'));
                uint32_t gen = numStr.toInt();
                if (gen > 0) {
                    bool exists = false;
                    for (auto g : gens) if (g == gen) { exists = true; break; }
                    if (!exists) gens.push_back(gen);
                }
            }
            f.close();
        }
        root.close();
        std::sort(gens.begin(), gens.end());
        return gens;
    }
    
    static void deleteGeneration(uint32_t gen) {
        if (!RobustStorage::isReady()) return;
        File root = SPIFFS.open("/");
        if (!root) return;
        int deleted = 0;
        while (File f = root.openNextFile()) {
            String name = String(f.name());
            bool shouldDelete = false;
            if (name.startsWith("/pop_gen_" + String(gen) + ".")) shouldDelete = true;
            if (name.startsWith("/gen_" + String(gen) + "_")) shouldDelete = true;
            if (name.startsWith("/frm_" + String(gen) + "_")) shouldDelete = true;
            if (name.startsWith("/chaos_g" + String(gen) + "_")) shouldDelete = true;
            if (shouldDelete) {
                f.close();
                SPIFFS.remove(name);
                deleted++;
            }
            f.close();
        }
        root.close();
        if (deleted > 0) {
            Logger::logf("🧹 Deleted generation %lu (%d files)", gen, deleted);
        }
    }
    
public:
    static void init() {
        freeSpaceThreshold = 50 * 1024;
        memset(savedCount, 0, sizeof(savedCount));
        Logger::logf("RollingStorage: max %d generations, %d individuals/gen",
                     MAX_GENERATIONS, MAX_INDIVIDUALS_PER_GEN);
    }
    
    static bool ensureSpace(size_t requiredBytes) {
        if (!RobustStorage::isReady()) return false;
        size_t free = getFreeSpace();
        if (free < requiredBytes + freeSpaceThreshold) {
            auto gens = getStoredGenerations();
            if (!gens.empty()) {
                uint32_t oldest = gens[0];
                Logger::logf("⚠️ Space low (%d bytes), deleting gen %lu", free, oldest);
                deleteGeneration(oldest);
                free = getFreeSpace();
            }
        }
        auto gens = getStoredGenerations();
        while (gens.size() >= MAX_GENERATIONS) {
            uint32_t oldest = gens[0];
            Logger::logf("🔄 Too many gens (%d), deleting %lu", gens.size(), oldest);
            deleteGeneration(oldest);
            gens = getStoredGenerations();
        }
        return getFreeSpace() >= requiredBytes;
    }
    
    static bool saveFrameLog(uint32_t generation, int individual, 
                             const FrameLogEntry* log, int count) {
        if (!RobustStorage::isReady() || count == 0) return false;
        
        if (savedCount[generation % 100] >= MAX_INDIVIDUALS_PER_GEN) {
            Logger::logf("⏭️ Skip frame gen=%lu id=%d (Top%d only)",
                         generation, individual, MAX_INDIVIDUALS_PER_GEN);
            return false;
        }
        
        int exportCount = min(count, FRAME_LOG_SIZE);
        size_t dataSize = exportCount * sizeof(CompressedFrameEntry);
        uint8_t* dataBuffer = (uint8_t*)malloc(dataSize);
        if (!dataBuffer) return false;
        
        uint8_t* ptr = dataBuffer;
        CompressedFrameEntry prev = {0};
        for (int i = 0; i < exportCount; i++) {
            const FrameLogEntry& e = log[i];
            CompressedFrameEntry compressed;
            compressed.timestamp_ms = e.timestamp_ms;
            compressed.sensorLeft = e.sensorLeft;
            compressed.sensorRight = e.sensorRight;
            compressed.directionL = e.directionL;
            compressed.directionR = e.directionR;
            compressed.chaosActive = e.chaosActive;
            compressed.state = e.state;
            compressed.reserved = 0;
            
            if (i == 0) {
                compressed.motorLeftPWM = e.motorLeftPWM;
                compressed.motorRightPWM = e.motorRightPWM;
            } else {
                compressed.motorLeftPWM = constrain(e.motorLeftPWM - prev.motorLeftPWM, -128, 127);
                compressed.motorRightPWM = constrain(e.motorRightPWM - prev.motorRightPWM, -128, 127);
            }
            memcpy(ptr, &compressed, sizeof(CompressedFrameEntry));
            ptr += sizeof(CompressedFrameEntry);
            prev = compressed;
        }
        
        FileHeader header;
        header.magic = 0x47454E45;
        header.version = 0x0004;
        header.headerSize = sizeof(FileHeader);
        header.frameCount = exportCount;
        header.generation = generation;
        header.individual = individual;
        header.reserved = 0;
        header.crc32 = CRC32::calculate(dataBuffer, dataSize);
        
        size_t totalSize = sizeof(FileHeader) + dataSize;
        uint8_t* finalBuffer = (uint8_t*)malloc(totalSize);
        if (!finalBuffer) { free(dataBuffer); return false; }
        
        memcpy(finalBuffer, &header, sizeof(FileHeader));
        memcpy(finalBuffer + sizeof(FileHeader), dataBuffer, dataSize);
        free(dataBuffer);
        
        String path = "/frm_" + String(generation) + "_i" + String(individual) + ".bin";
        bool success = FileUtils::atomicWrite(path, finalBuffer, totalSize);
        free(finalBuffer);
        
        if (success) {
            savedCount[generation % 100]++;
            Logger::logf("💾 saveFrameLog gen=%lu id=%d (slot %d/%d, CRC=0x%08X) %s",
                         generation, individual,
                         savedCount[generation % 100], MAX_INDIVIDUALS_PER_GEN,
                         header.crc32, success ? "✅" : "❌");
        }
        return success;
    }
    
    static bool incrementalSave(uint32_t generation, int individual,
                                const FrameLogEntry* log, int count) {
        if (count % INCREMENTAL_SAVE_INTERVAL != 0) return false;
        if (count < INCREMENTAL_SAVE_INTERVAL) return false;
        int startIdx = count - INCREMENTAL_SAVE_INTERVAL;
        return saveFrameLog(generation, individual, log + startIdx, INCREMENTAL_SAVE_INTERVAL);
    }
    
    static void resetGenerationCounter(uint32_t gen) {
        savedCount[gen % 100] = 0;
    }
    
    static String getStorageStatus() {
        String status = "=== Storage Status ===\n";
        size_t free = getFreeSpace();
        status += "Free space: " + String(free / 1024) + " KB\n";
        auto gens = getStoredGenerations();
        status += "Stored generations: " + String(gens.size()) + "/" + String(MAX_GENERATIONS) + "\n";
        for (auto g : gens) {
            status += "  Gen " + String(g) + "\n";
        }
        return status;
    }
    
    static size_t getFreeSpaceKB() {
        return getFreeSpace() / 1024;
    }
};

uint32_t RollingStorage::freeSpaceThreshold = 50 * 1024;
int RollingStorage::savedCount[100] = {0};

// ================================================================
// MotorController 类 ★ v9.9 混沌修复 ★
// ================================================================
class MotorController {
private:
    static int      currentSpeedL, currentSpeedR;
    static volatile int32_t distanceTicks;
    static uint32_t lastMoveTime;
    static bool     motorEnabled;
    static uint32_t testStartTime;
    static int      leftSensorRaw, rightSensorRaw;
    static int      currentRuleIndex;
    static uint32_t ruleStartTime;
    static bool     ruleActive;
    static FrameLogEntry frameLog[FRAME_LOG_SIZE];
    static int      frameLogHead;
    static int      frameLogCount;
    
    static bool     lastLeftA, lastRightA;
    static uint32_t lastEncoderReadTime;

    static bool     actionInProgress;
    static uint32_t actionStartTime;
    static int32_t  actionLastTicks;
    static int      actionStallFrames;

    static volatile int32_t leftTicks;
    static volatile int32_t rightTicks;
    
    // ★ 单一状态变量 ★
    static MotorState motorState;
    static uint32_t stateEnterTime;
    static int32_t stateEntryDistance;
    static uint32_t stuckStartTime;
    static int32_t lastDiff;
    static bool escapeActiveCompat;
    
    // ★ 滑动窗口卡死检测 ★
    static int32_t diffHistory[STUCK_WINDOW_SIZE];
    static int historyIndex;
    static int historyCount;

    static bool chaosActive;
    static uint32_t chaosStartTime;

    static int32_t  testChaosTriggerCount;
    static uint32_t testChaosTotalDuration;
    static uint32_t testChaosMaxDuration;
    static uint32_t testChaosFirstTriggerTime;
    static uint32_t testChaosLastTriggerTime;
    static int32_t  baselineDistanceTicks;
    static int32_t  chaosDistanceTicks;
    static int      baselineFrameCount;
    static int      chaosFrameCount;
    static float    baselineSpeedLSum;
    static float    baselineSpeedRSum;
    static float    chaosSpeedLSum;
    static float    chaosSpeedRSum;
    static bool     chaosHappened;
    static int32_t  chaosStartDistance;
    static uint32_t lastIncrementalSaveFrame;

    static void setMotorSpeed(int leftPWM, int rightPWM) {
        if (!motorEnabled) {
            ledcWrite(LEDC_CHANNEL_LEFT, 0);
            ledcWrite(LEDC_CHANNEL_RIGHT, 0);
            digitalWrite(PIN_LEFT_DIR2, LOW);
            digitalWrite(PIN_RIGHT_DIR2, LOW);
            currentSpeedL = 0;
            currentSpeedR = 0;
            return;
        }

        int outL;
        if (leftPWM > 0) {
            outL = constrain((int)(leftPWM * LEFT_FWD_GAIN), 0, MOTOR_PWM_MAX);
            if (outL > 0 && outL < LEFT_DEADZONE) outL = LEFT_DEADZONE;
        } else if (leftPWM < 0) {
            outL = constrain((int)(-leftPWM * LEFT_FWD_GAIN * LEFT_REV_GAIN), 0, MOTOR_PWM_MAX);
            if (outL > 0 && outL < LEFT_DEADZONE) outL = LEFT_DEADZONE;
            outL = -outL;
        } else {
            outL = 0;
        }

        int outR;
        if (rightPWM > 0) {
            outR = constrain((int)(rightPWM * RIGHT_FWD_GAIN), 0, MOTOR_PWM_MAX);
            if (outR > 0 && outR < RIGHT_DEADZONE) outR = RIGHT_DEADZONE;
        } else if (rightPWM < 0) {
            outR = constrain((int)(-rightPWM * RIGHT_FWD_GAIN * RIGHT_REV_GAIN), 0, MOTOR_PWM_MAX);
            if (outR > 0 && outR < RIGHT_DEADZONE) outR = RIGHT_DEADZONE;
            outR = -outR;
        } else {
            outR = 0;
        }

        if (outL > 0) {
            digitalWrite(PIN_LEFT_DIR2, LEFT_FORWARD);
            ledcWrite(LEDC_CHANNEL_LEFT, outL);
        } else if (outL < 0) {
            digitalWrite(PIN_LEFT_DIR2, LEFT_REVERSE);
            ledcWrite(LEDC_CHANNEL_LEFT, -outL);
        } else {
            digitalWrite(PIN_LEFT_DIR2, LOW);
            ledcWrite(LEDC_CHANNEL_LEFT, 0);
        }

        if (outR > 0) {
            digitalWrite(PIN_RIGHT_DIR2, RIGHT_FORWARD);
            ledcWrite(LEDC_CHANNEL_RIGHT, outR);
        } else if (outR < 0) {
            digitalWrite(PIN_RIGHT_DIR2, RIGHT_REVERSE);
            ledcWrite(LEDC_CHANNEL_RIGHT, -outR);
        } else {
            digitalWrite(PIN_RIGHT_DIR2, LOW);
            ledcWrite(LEDC_CHANNEL_RIGHT, 0);
        }

        currentSpeedL = abs(outL);
        currentSpeedR = abs(outR);
    }

    static void updateEncoders() {
        if (millis() - lastEncoderReadTime < 10) return;
        lastEncoderReadTime = millis();
        bool leftA = digitalRead(PIN_LEFT_ENC_A);
        bool rightA = digitalRead(PIN_RIGHT_ENC_A);
        if (leftA && !lastLeftA) {
            if (digitalRead(PIN_LEFT_ENC_B) == HIGH) leftTicks--;
            else leftTicks++;
        }
        if (rightA && !lastRightA) {
            if (digitalRead(PIN_RIGHT_ENC_B) == HIGH) rightTicks++;
            else rightTicks--;
        }
        distanceTicks = abs(leftTicks) + abs(rightTicks);
        lastLeftA = leftA;
        lastRightA = rightA;
    }

    static void clearStuckState() {
        if (motorState == STATE_STUCK || motorState == STATE_CHAOS) {
            motorState = STATE_IDLE;
        }
        stuckStartTime = 0;
        escapeActiveCompat = false;
    }

    static void setMotorState(MotorState newState) {
        if (motorState == newState) return;
        motorState = newState;
        stateEnterTime = millis();
        stateEntryDistance = distanceTicks;
        const char* stateNames[] = {"IDLE", "WALKING", "STUCK", "CHAOS", "ESCAPING"};
        Serial.printf("[STATE] → %s\n", stateNames[newState]);
    }

    static bool detectStuckWithWindow(int32_t diff) {
        diffHistory[historyIndex] = diff;
        historyIndex = (historyIndex + 1) % STUCK_WINDOW_SIZE;
        if (historyCount < STUCK_WINDOW_SIZE) historyCount++;
        
        if (historyCount < STUCK_WINDOW_SIZE) return false;
        
        int increasingCount = 0;
        for (int i = 0; i < STUCK_WINDOW_SIZE - 1; i++) {
            int curr = (historyIndex - 1 - i + STUCK_WINDOW_SIZE) % STUCK_WINDOW_SIZE;
            int prev = (historyIndex - 2 - i + STUCK_WINDOW_SIZE) % STUCK_WINDOW_SIZE;
            if (diffHistory[curr] > diffHistory[prev] + ENCODER_DIFF_MIN) {
                increasingCount++;
            }
        }
        return increasingCount >= 7;
    }
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
void loop() {
    if (!wifiInitialized) initWiFi();

    MotorController::updatePhysicsAction();

    // ★★★ v9.9 混沌兜底保护 ★★★
    static uint32_t lastChaosCheck = 0;
    if (millis() - lastChaosCheck > 100) {
        lastChaosCheck = millis();
        if (MotorController::getMotorState() == STATE_STUCK) {
            uint32_t stuckDuration = MotorController::getStateDuration();
            if (stuckDuration > CHAOS_TIMEOUT_MS + 500) {
                Serial.printf("[CHAOS] 🔥 FORCE TRIGGER! stuckDuration=%lu\n", stuckDuration);
                MotorController::startChaos();
            }
        }
    }

    if (MotorController::isChaosActive()) {
        MotorController::updateChaos();
    }

    if (EvolutionEngine::isTestActive()) {
        Gene& gene = EvolutionEngine::getCurrentGene();
        MotorController::update(gene);
        if (millis() - EvolutionEngine::getTestStartTime() > TEST_DURATION_MS) {
            EvolutionEngine::endCurrentTest();
            EvolutionEngine::nextIndividual();
        }
    }

    if (wifiReady) CarWebServer::handleClient();

    if (EvolutionEngine::getPendingTransition()) {
        EvolutionEngine::clearPendingTransition();
        EvolutionEngine::nextIndividual();
    }

    // ============================================================
    // 串口命令处理
    // ============================================================
    if (Serial.available()) {
        String cmd = Serial.readStringUntil('\n');
        cmd.trim();
        cmd.toLowerCase();
        
        if (cmd == "ls" || cmd == "list") {
            listSPIFFSFiles();
        } else if (cmd == "status") {
            printStatus();
        } else if (cmd == "help") {
            Serial.println("========================================");
            Serial.println("可用命令 (v9.9):");
            Serial.println("  ls / list          - 列出 SPIFFS 所有文件");
            Serial.println("  status             - 显示系统状态");
            Serial.println("  frame <代> <个体>  - 解析帧日志，例如: frame 2 0");
            Serial.println("  pop <代>           - 解析种群快照，例如: pop 2");
            Serial.println("  chaos <代> <个体>  - 解析混沌记录，例如: chaos 2 0");
            Serial.println("  popall <代>        - 显示一代所有个体数据，例如: popall 1");
            Serial.println("  ramlog <开始> <结束> - 提取RAM日志，例如: ramlog 0 100");
            Serial.println("  ramlog all         - 提取全部RAM日志");
            Serial.println("  storage            - 查看SPIFFS存储状态");
            Serial.println("  help               - 显示帮助");
            Serial.println("========================================");
        } else if (cmd.startsWith("frame ")) {
            int firstSpace = cmd.indexOf(' ');
            int secondSpace = cmd.indexOf(' ', firstSpace + 1);
            if (secondSpace > 0) {
                int gen = cmd.substring(firstSpace + 1, secondSpace).toInt();
                int id = cmd.substring(secondSpace + 1).toInt();
                parseFrameLog(gen, id);
            } else {
                Serial.println("用法: frame <代数> <个体>  例如: frame 2 0");
            }
        } else if (cmd.startsWith("pop ")) {
            int gen = cmd.substring(4).toInt();
            parsePopulation(gen);
        } else if (cmd.startsWith("chaos ")) {
            int firstSpace = cmd.indexOf(' ');
            int secondSpace = cmd.indexOf(' ', firstSpace + 1);
            if (secondSpace > 0) {
                int gen = cmd.substring(firstSpace + 1, secondSpace).toInt();
                int id = cmd.substring(secondSpace + 1).toInt();
                parseChaosRecord(gen, id);
            } else {
                Serial.println("用法: chaos <代数> <个体>  例如: chaos 2 0");
            }
        } else if (cmd.startsWith("popall ")) {
            int gen = cmd.substring(7).toInt();
            parseAllIndividuals(gen);
        } else if (cmd.startsWith("ramlog ")) {
            String params = cmd.substring(7);
            if (params == "all") {
                extractRamLog(0, RAMLogBuffer::getFrameCount() - 1);
            } else {
                int space = params.indexOf(' ');
                if (space > 0) {
                    int start = params.substring(0, space).toInt();
                    int end = params.substring(space + 1).toInt();
                    extractRamLog(start, end);
                } else {
                    Serial.println("用法: ramlog <开始> <结束>  或  ramlog all");
                }
            }
        } else if (cmd == "storage") {
            showStorageStatus();
        }
    }

    RobustStorage::tick();
    delay(LOOP_DELAY_MS);
}
