xavercai/PICAR/OEETestFinal_v9.22-TieredStorage.ino

/*
* ================================================================
*                    代码迭代修改日志
*                 OEE 进化系统 v9.22-TieredStorage
* ================================================================
* 
* 版本: v9.22-TieredStorage
* 日期: 2026-09-05
* 作者: 系统优化
*/


// ================================================================
// ★★★ SPIFFS 格式化控制 ★★★
// ================================================================
#define FORMAT_SPIFFS_ON_BOOT 0
// ================================================================
// ★★★ 新增配置宏 - 定期保存 ★★★
// ================================================================
#define FORCE_SAVE_INTERVAL_MS 300000   // 30000秒强制保存一次
// ================================================================
// 头文件包含
// ================================================================
#include <WiFi.h>
#include <WebServer.h>
#include <FS.h>
#include <SPIFFS.h>
#include <vector>
#include <algorithm>
#include <cstdarg>
#include <cstdio>
#include <cmath>
#include <cstring>



// ================================================================
// 前向声明（文件开头）
// ================================================================
class RobustStorage;
class RollingStorage;
class FileUtils;
class NoveltyArchive;
class GeneStorage;
class EvolutionEngine;
class CarWebServer;

// 硬件引脚定义
// ================================================================
#define PIN_SENSOR_LEFT     4
#define PIN_SENSOR_RIGHT    5
#define PIN_NOISE_SOURCE    1
#define PIN_OBSTACLE_INT    39
#define PIN_LED             14
#define PIN_LEFT_PWM        9
#define PIN_LEFT_DIR2       46
#define PIN_RIGHT_PWM       16
#define PIN_RIGHT_DIR2      15
#define PIN_LEFT_ENC_A      18
#define PIN_LEFT_ENC_B      17
#define PIN_RIGHT_ENC_A     11
#define PIN_RIGHT_ENC_B     10

// ================================================================
// LEDC 配置
// ================================================================
#define LEDC_FREQ           5000
#define LEDC_RESOLUTION     8
#define LEDC_CHANNEL_LEFT   0
#define LEDC_CHANNEL_RIGHT  1

// ================================================================
// 电机方向定义
// ================================================================
#define LEFT_FORWARD   HIGH
#define LEFT_REVERSE   LOW
#define RIGHT_FORWARD  LOW
#define RIGHT_REVERSE  HIGH

// ================================================================
// 电机增益补偿
// ================================================================
#define LEFT_FWD_GAIN       1.00f
#define RIGHT_FWD_GAIN      1.30f
#define LEFT_REV_GAIN       1.30f
#define RIGHT_REV_GAIN      1.30f
#define LEFT_DEADZONE       35
#define RIGHT_DEADZONE      20
#define MOTOR_PWM_MAX       255

// ================================================================
// WiFi 配置
// ================================================================
#define WIFI_SSID           "CarLogger"
#define WIFI_PASSWORD       "12345678"

// ================================================================
// 进化参数
// ================================================================
#define POPULATION_SIZE     16
#define TEST_DURATION_MS    30000
#define LOOP_DELAY_MS       10

// ================================================================
// 行为规则参数
// ================================================================
#define MAX_RULES           16
#define MIN_RULES           2
#define MAX_RULE_DURATION   2000
#define MIN_RULE_DURATION   50

// ================================================================
// Novelty Search 参数
// ================================================================
#define NOVELTY_ARCHIVE_MAX    200
#define NOVELTY_K_NEAREST      5
#define NOVELTY_ADD_THRESHOLD  0.15f

// ================================================================
// 存储参数
// ================================================================
#define STORAGE_SAVE_INTERVAL_MS  10000
#define FRAME_LOG_SIZE            4096
#define RAM_LOG_BUFFER_SIZE       6000
#define SPIFFS_MAX_GENERATIONS    20
#define SPIFFS_MAX_INDIVIDUALS_PER_GEN 16
#define INCREMENTAL_SAVE_INTERVAL 100

// ================================================================
// ★★★ R1: 固件版本 - 移除"3轮混沌保障" ★★★
// ================================================================
#define FIRMWARE_VERSION "v9.22-ObserveOnly"
#define VERSION_MARKER_FILE "/version_" FIRMWARE_VERSION ".mrk"

// ================================================================
// ★★★ 数据分级定义 (L1-L4) ★★★
// ================================================================

// L1: 核心数据 - 永不删除 (新颖度存档)
#define DATA_LEVEL_CORE     1

// L2: 基因数据 - 永不删除 (基因记录 + 混沌记录)
#define DATA_LEVEL_GENE     2

// L3: 种群数据 - 可手动清理 (种群快照)
#define DATA_LEVEL_POP      3

// L4: 过程数据 - 可随时清理 (帧日志 + 历史摘要)
#define DATA_LEVEL_PROCESS  4

// ================================================================
// ★★★ R5: 混沌恢复条件放宽 ★★★
// ================================================================
#define CHAOS_RECOVER_STABLE_FRAMES 50   // ★★★ R5: 20→50 ★★★
#define CHAOS_ESCAPE_PWM            200
#define MAX_STUCK_WINDOW            20

// ================================================================
// ★★★ R4: 混沌触发时间尺度参数 ★★★
// ================================================================
#define CHAOS_TIMEOUT_MIN       2000   // ★★★ R4: 800→2000 ★★★
#define CHAOS_TIMEOUT_MAX       6000   // ★★★ R4: 1800→6000 ★★★
#define CHAOS_FORCE_TIMEOUT_MIN 3000
#define CHAOS_FORCE_TIMEOUT_MAX 8000

// ================================================================
// 检测机制参数
// ================================================================
#define STUCK_CLEAR_DEBOUNCE_MS     150
#define BOUNCE_WINDOW_MS            500
#define BOUNCE_THRESHOLD            3
#define NO_PROGRESS_TIMEOUT_MS      1000
#define SPEED_ASYMMETRY_RATIO       2.5f

// ================================================================
// 状态枚举
// ================================================================
enum MotorState : uint8_t {
    STATE_IDLE      = 0,
    STATE_WALKING   = 1,
    STATE_STUCK     = 2,
    STATE_CHAOS     = 3,
};

// ================================================================
// 条件类型枚举
// ================================================================
enum CondType : uint8_t {
    COND_SENSOR_LEFT  = 0,
    COND_SENSOR_RIGHT = 1,
    COND_SENSOR_BOTH  = 2,
    COND_SENSOR_ANY   = 3,
    COND_DISTANCE     = 4,
    COND_TIME         = 5,
    COND_IDLE         = 6,
    COND_ALWAYS       = 7
};

enum CondOp : uint8_t {
    OP_GREATER = 0,
    OP_LESS    = 1,
    OP_EQUAL   = 2
};

// ================================================================
// 行为规则结构体
// ================================================================
struct BehaviorRule {
    uint8_t  condType;
    int16_t  condValue;
    uint8_t  condOp;
    int16_t  motorL;
    int16_t  motorR;
    uint16_t durationMs;
    uint8_t  nextRule;
    uint8_t  _padding;

    void randomize() {
        condType   = random(0, 8);
        condValue  = random(-3000, 3000);
        condOp     = random(0, 3);
        motorL     = random(-255, 255);
        motorR     = random(-255, 255);
        durationMs = random(MIN_RULE_DURATION, MAX_RULE_DURATION);
        nextRule   = random(0, 3);
        _padding   = 0;
    }
    
    void clamp() {
        motorL     = constrain(motorL, -255, 255);
        motorR     = constrain(motorR, -255, 255);
        durationMs = constrain(durationMs, MIN_RULE_DURATION, MAX_RULE_DURATION);
        condType   = constrain(condType, (uint8_t)0, (uint8_t)7);
        condOp     = constrain(condOp, (uint8_t)0, (uint8_t)2);
    }
    
    bool compare(int value, int op, int threshold) const {
        switch (op) {
            case OP_GREATER: return value > threshold;
            case OP_LESS:    return value < threshold;
            case OP_EQUAL:   return abs(value - threshold) < 50;
            default: return false;
        }
    }
};

// ================================================================
// 行为描述符
// ================================================================
struct BehaviorDescriptor {
    float leftSensorMean, rightSensorMean;
    float sensorVariance, sensorAsymmetry;
    float avgSpeed, speedVariance, turnBias, totalDistance;
    float forwardRatio, turnRatio, reverseRatio, idleRatio;

    void init() {
        leftSensorMean = rightSensorMean = 0;
        sensorVariance = sensorAsymmetry = 0;
        avgSpeed = speedVariance = turnBias = totalDistance = 0;
        forwardRatio = turnRatio = reverseRatio = idleRatio = 0;
    }

    float distance(const BehaviorDescriptor& other) const {
        float sum = 0, d;
        d = leftSensorMean - other.leftSensorMean; sum += d*d;
        d = rightSensorMean - other.rightSensorMean; sum += d*d;
        d = sensorVariance - other.sensorVariance; sum += d*d;
        d = sensorAsymmetry - other.sensorAsymmetry; sum += d*d;
        d = avgSpeed - other.avgSpeed; sum += d*d;
        d = speedVariance - other.speedVariance; sum += d*d;
        d = turnBias - other.turnBias; sum += d*d;
        d = totalDistance - other.totalDistance; sum += d*d;
        d = forwardRatio - other.forwardRatio; sum += d*d;
        d = turnRatio - other.turnRatio; sum += d*d;
        d = reverseRatio - other.reverseRatio; sum += d*d;
        d = idleRatio - other.idleRatio; sum += d*d;
        return sqrtf(sum);
    }

    // ★★★ R8: 补全 12 维归一化 ★★★
    void normalize(const BehaviorDescriptor& maxVals) {
        if (maxVals.leftSensorMean > 0) leftSensorMean /= maxVals.leftSensorMean;
        if (maxVals.rightSensorMean > 0) rightSensorMean /= maxVals.rightSensorMean;
        if (maxVals.sensorVariance > 0) sensorVariance /= maxVals.sensorVariance;
        if (maxVals.avgSpeed > 0) avgSpeed /= maxVals.avgSpeed;
        if (maxVals.speedVariance > 0) speedVariance /= maxVals.speedVariance;
        if (maxVals.totalDistance > 0) totalDistance /= maxVals.totalDistance;
        // ★★★ R8: 补全剩余6维归一化 ★★★
        if (maxVals.turnBias > 0) turnBias /= maxVals.turnBias;
        if (maxVals.sensorAsymmetry > 0) sensorAsymmetry /= maxVals.sensorAsymmetry;
        if (maxVals.forwardRatio > 0) forwardRatio /= maxVals.forwardRatio;
        if (maxVals.turnRatio > 0) turnRatio /= maxVals.turnRatio;
        if (maxVals.reverseRatio > 0) reverseRatio /= maxVals.reverseRatio;
        if (maxVals.idleRatio > 0) idleRatio /= maxVals.idleRatio;
    }
};

// ================================================================
// 帧日志条目
// ================================================================
struct FrameLogEntry {
    uint32_t timestamp_ms;
    int16_t  sensorLeft;
    int16_t  sensorRight;
    uint8_t  motorLeftPWM;
    uint8_t  motorRightPWM;
    uint8_t  directionL : 1;
    uint8_t  directionR : 1;
    uint8_t  chaosActive : 1;
    uint8_t  isChaosFrame : 1;
    uint8_t  state : 3;
    uint8_t  reserved : 1;
};

struct CompressedFrameEntry {
    uint32_t timestamp_ms;
    int16_t  sensorLeft;
    int16_t  sensorRight;
    int8_t   motorLeftPWM;
    int8_t   motorRightPWM;
    uint8_t  directionL : 1;
    uint8_t  directionR : 1;
    uint8_t  chaosActive : 1;
    uint8_t  isChaosFrame : 1;
    uint8_t  state : 3;
    uint8_t  reserved : 1;
};

struct FileHeader {
    uint32_t magic;
    uint16_t version;
    uint16_t headerSize;
    uint32_t crc32;
    uint32_t frameCount;
    uint32_t generation;
    uint16_t individual;
    uint16_t reserved;
};

struct HistoryRecord {
    uint32_t timestamp;
    uint32_t generation;
    float    noveltyScore;
    uint32_t survivalTime;
    int32_t  distance_ticks;
    uint8_t  ruleCount;
    uint8_t  reserved[3];
};

struct ChaoticTestRecord {
    uint32_t timestamp;
    uint32_t generation;
    uint32_t individual;
    uint32_t chaosTriggerCount;
    uint32_t chaosTotalDuration;
    uint32_t chaosMaxDuration;
    uint32_t chaosFirstTime;
    uint32_t chaosLastTime;
    int32_t  baselineDistance;
    int32_t  chaosDistance;
    uint16_t baselineFrames;
    uint16_t chaosFrames;
    float    baselineAvgSpeedL;
    float    baselineAvgSpeedR;
    float    chaosAvgSpeedL;
    float    chaosAvgSpeedR;
    uint8_t  chaosSuccess;
    uint8_t  testTerminatedBy;
    uint8_t  reserved[2];
};

#define MAX_CHAOS_SNAPSHOTS 8

struct ChaosSnapshotEntry {
    int16_t  sensorLeft;
    int16_t  sensorRight;
    int8_t   motorLeftPWM;
    int8_t   motorRightPWM;
    uint16_t durationMs;
    uint32_t timestamp_ms;
};

struct ChaosSnapshotHeader {
    uint32_t magic;
    uint16_t version;
    uint16_t headerSize;
    uint32_t crc32;
    uint8_t  count;
    uint8_t  reserved[3];
};

// === 序列化结构体尺寸锁定 ===
static_assert(sizeof(BehaviorRule) == 14, "BehaviorRule size must be 14");
static_assert(sizeof(CompressedFrameEntry) == 12, "CompressedFrameEntry size must be 12");
static_assert(sizeof(FileHeader) == 24, "FileHeader size must be 24");
static_assert(sizeof(ChaosSnapshotEntry) == 12, "ChaosSnapshotEntry size must be 12");
static_assert(sizeof(ChaosSnapshotHeader) == 16, "ChaosSnapshotHeader size must be 16");

// ================================================================
// 前向声明
// ================================================================
struct Gene;
class Logger;
class SensorCalibration;
class RobustStorage;
class GeneStorage;
class NoveltyArchive;
class MotorController;
class EvolutionEngine;
class CarWebServer;
class RAMLogBuffer;
class RollingStorage;
class FileUtils;

// ================================================================
// Logger 类
// ================================================================
class Logger {
public:
    static void init() { Serial.begin(115200); delay(500); }
    static void log(const char* msg) {
        Serial.println("[OE] " + String(millis()/1000) + "s " + String(msg));
    }
    static void logf(const char* fmt, ...) {
        char buf[256];
        va_list args;
        va_start(args, fmt);
        vsnprintf(buf, sizeof(buf), fmt, args);
        va_end(args);
        log(buf);
    }
};

// ================================================================
// SensorCalibration 类
// ================================================================
class SensorCalibration {
private:
    static int leftBase, rightBase;
    static int16_t obstacleThreshold;
    static int16_t clearThreshold;
    
public:
    static void calibrate() {
        Logger::log("Sensor calibrating...");
        delay(1000);
        const int samples = 50;
        long sumL = 0, sumR = 0;
        for (int i = 0; i < samples; i++) {
            sumL += analogRead(PIN_SENSOR_LEFT);
            sumR += analogRead(PIN_SENSOR_RIGHT);
            delay(10);
        }
        leftBase = sumL / samples;
        rightBase = sumR / samples;
        obstacleThreshold = 1500;
        clearThreshold = 600;
        Logger::logf("Calibration done: L=%d R=%d", leftBase, rightBase);
    }
    
    static void setThresholds(int16_t obs, int16_t clr) {
        obstacleThreshold = obs;
        clearThreshold = clr;
    }
    
    static int getLeftRaw() { return analogRead(PIN_SENSOR_LEFT); }
    static int getRightRaw() { return analogRead(PIN_SENSOR_RIGHT); }
    static bool isObstacleLeft() { return analogRead(PIN_SENSOR_LEFT) > obstacleThreshold; }
    static bool isObstacleRight() { return analogRead(PIN_SENSOR_RIGHT) > obstacleThreshold; }
    static bool isClear() {
        return (analogRead(PIN_SENSOR_LEFT) < clearThreshold &&
                analogRead(PIN_SENSOR_RIGHT) < clearThreshold);
    }
    static uint16_t readNoise() { return analogRead(PIN_NOISE_SOURCE); }
};

int SensorCalibration::leftBase = 0;
int SensorCalibration::rightBase = 0;
int16_t SensorCalibration::obstacleThreshold = 1500;
int16_t SensorCalibration::clearThreshold = 600;

// ================================================================
// CRC32工具
// ================================================================
class CRC32 {
public:
    static uint32_t calculate(const uint8_t* data, size_t len) {
        uint32_t crc = 0xFFFFFFFF;
        for (size_t i = 0; i < len; i++) {
            crc ^= data[i];
            for (int j = 0; j < 8; j++) {
                if (crc & 1) crc = (crc >> 1) ^ 0xEDB88320;
                else crc >>= 1;
            }
        }
        return ~crc;
    }
    
    static bool verify(const uint8_t* data, size_t len, uint32_t expected) {
        return calculate(data, len) == expected;
    }
};

// ================================================================
// Class FileUtils 
// ================================================================
class FileUtils {
public:
    static bool atomicWrite(const String& path, const uint8_t* data, size_t len);
    static bool atomicWriteString(const String& path, const String& content);
    static bool verifyFile(const String& path, const uint8_t* expectedData, size_t expectedLen);
    static bool restoreFromBackup(const String& path);
    static String safeRead(const String& path);
    static String readStringCapped(const String& path, size_t maxBytes);
    static size_t getFileSize(const String& path);
    static bool exists(const String& path);
};



// ================================================================
// ★★★ RobustStorage 类 - 冗余存储 + 缓冲保留 ★★★
// ================================================================

class RobustStorage {
private:
    static const char* HISTORY_FILE;
    static bool fsReady;
    static uint32_t lastSaveTime;
    static uint32_t unsavedCount;
    static uint32_t totalSaved;
    static String pendingBuffer;
    static String chaosPendingBuffer;
    static uint32_t chaosUnsavedCount;
    static const size_t MAX_BUFFER_SIZE = 4096;
    static HistoryRecord ramHistory[1000];
    static int ramHistoryCount;
    static uint32_t lastFsRetryTime;
    static bool pendingBufferDirty;
    static const uint32_t FS_RETRY_INTERVAL = 5000;

    static bool appendToFile(const char* path, const String& data) {
        if (!fsReady) return false;
        File file = SPIFFS.open(path, FILE_APPEND);
        if (!file) {
            file = SPIFFS.open(path, FILE_WRITE);
            if (!file) return false;
        }
        size_t written = file.print(data);
        file.close();
        return written == data.length();
    }

    static bool isValidHistoryValue(uint32_t ts, uint32_t gen, float novelty, 
                                    uint32_t survival, int32_t dist, uint8_t rules) {
        if (ts < 1577836800UL || ts > 4102444800UL) return false;
        if (gen > 1000000UL) return false;
        if (novelty < 0.0f || novelty > 10.0f) return false;
        if (survival > 3600000UL) return false;
        if (rules < MIN_RULES || rules > MAX_RULES) return false;
        return true;
    }
    
    static void loadHistory() {
        if (!fsReady) return;
        File file = SPIFFS.open(HISTORY_FILE, FILE_READ);
        if (!file) return;
        int count = 0;
        bool firstLine = true;
        while (file.available() && count < 1000) {
            String line = file.readStringUntil('\n');
            if (line.length() > 0 && line[line.length()-1] == '\r') {
                line = line.substring(0, line.length()-1);
            }
            if (line.length() < 10) { firstLine = false; continue; }
            
            if (firstLine) {
                firstLine = false;
                if (line.startsWith("timestamp") || line.startsWith("#")) {
                    continue;
                }
            }
            
            int partIdx = 0;
            String parts[6];
            for (int i = 0; i < line.length() && partIdx < 6; i++) {
                if (line[i] == ',') { partIdx++; continue; }
                parts[partIdx] += line[i];
            }
            if (partIdx == 5) {
                uint32_t ts = parts[0].toInt();
                uint32_t gen = parts[1].toInt();
                float novelty = parts[2].toFloat();
                uint32_t survival = parts[3].toInt();
                int32_t dist = parts[4].toInt();
                uint8_t rules = (uint8_t)parts[5].toInt();
                
                if (!isValidHistoryValue(ts, gen, novelty, survival, dist, rules)) {
                    continue;
                }
                
                ramHistory[count].timestamp = ts;
                ramHistory[count].generation = gen;
                ramHistory[count].noveltyScore = novelty;
                ramHistory[count].survivalTime = survival;
                ramHistory[count].distance_ticks = dist;
                ramHistory[count].ruleCount = rules;
                count++;
            }
        }
        ramHistoryCount = count;
        file.close();
        Logger::logf("📋 历史记录加载完成: %d 条", count);
    }
    
    // ★★★ 尝试重新挂载 SPIFFS ★★★
    static bool tryRemountSPIFFS() {
        if (fsReady) return true;
        
        uint32_t now = millis();
        if (now - lastFsRetryTime < FS_RETRY_INTERVAL) return false;
        lastFsRetryTime = now;
        
        Logger::log("🔄 Attempting to remount SPIFFS...");
        SPIFFS.end();
        if (SPIFFS.begin(false)) {
            fsReady = true;
            Logger::log("✅ SPIFFS remounted successfully");
            loadHistory();
            flushBuffer();
            flushChaosBuffer();
            return true;
        }
        return false;
    }

public:
    static void init() {
        fsReady = false;
        lastSaveTime = 0;
        unsavedCount = 0;
        totalSaved = 0;
        ramHistoryCount = 0;
        pendingBuffer.reserve(MAX_BUFFER_SIZE);
        chaosPendingBuffer.reserve(MAX_BUFFER_SIZE);
        chaosUnsavedCount = 0;
        lastFsRetryTime = 0;
        pendingBufferDirty = false;
        
        #if FORMAT_SPIFFS_ON_BOOT
            Logger::log("⚠️ FORMAT_SPIFFS_ON_BOOT is ENABLED - formatting SPIFFS...");
            if (SPIFFS.format()) {
                Logger::log("⚠️ SPIFFS formatted (user requested)");
            } else {
                Logger::log("❌ SPIFFS format failed!");
            }
        #endif
        
        if (!SPIFFS.begin(false)) {
            Logger::log("========================================");
            Logger::log("❌ SPIFFS mount FAILED");
            Logger::log("   🔒 AUTO-FORMAT DISABLED - Data preserved");
            Logger::log("   ⚠️ Running in RAM-only mode");
            Logger::log("========================================");
            fsReady = false;
        } else {
            fsReady = true;
            Logger::log("✅ SPIFFS mounted successfully");
            loadHistory();
        }
    }

    static void addRecord(const HistoryRecord& record, bool forceFlush = false) {
        if (ramHistoryCount < 1000) {
            ramHistory[ramHistoryCount++] = record;
        } else {
            for (int i = 1; i < 1000; i++) ramHistory[i-1] = ramHistory[i];
            ramHistory[999] = record;
        }
        char line[256];
        snprintf(line, sizeof(line), "%lu,%lu,%.4f,%lu,%ld,%d\n",
                 record.timestamp, record.generation, record.noveltyScore,
                 record.survivalTime, record.distance_ticks, record.ruleCount);
        pendingBuffer += String(line);
        unsavedCount++;
        totalSaved++;
        pendingBufferDirty = true;
        if (forceFlush || pendingBuffer.length() > MAX_BUFFER_SIZE || unsavedCount >= 5) {
            flushBuffer();
        }
    }

    // ★★★ flushBuffer 在 SPIFFS 不可用时保留缓冲 ★★★
    static bool flushBuffer() {
        if (pendingBuffer.length() == 0) { 
            unsavedCount = 0; 
            pendingBufferDirty = false;
            return true; 
        }
        
        if (!fsReady) {
            if (!tryRemountSPIFFS()) {
                // 保留缓冲，不丢弃数据
                if (pendingBuffer.length() > MAX_BUFFER_SIZE * 4) {
                    int lastNewline = pendingBuffer.lastIndexOf('\n', pendingBuffer.lastIndexOf('\n') - 1);
                    if (lastNewline > 0) {
                        pendingBuffer = pendingBuffer.substring(lastNewline + 1);
                    }
                }
                lastSaveTime = millis();
                return false;
            }
        }
        
        if (!SPIFFS.exists(HISTORY_FILE)) {
            String header = "timestamp,generation,noveltyScore,survivalTime,distance_ticks,ruleCount\n";
            appendToFile(HISTORY_FILE, header);
        }
        bool success = appendToFile(HISTORY_FILE, pendingBuffer);
        if (success) {
            pendingBuffer = "";
            unsavedCount = 0;
            pendingBufferDirty = false;
            lastSaveTime = millis();
        } else {
            Logger::log("⚠️ flushBuffer: write failed, data retained in buffer");
            lastSaveTime = millis();
        }
        return success;
    }

    static bool flushChaosBuffer() {
        if (chaosPendingBuffer.length() == 0) { 
            chaosUnsavedCount = 0; 
            return true; 
        }
        
        if (!fsReady) {
            if (!tryRemountSPIFFS()) {
                if (chaosPendingBuffer.length() > MAX_BUFFER_SIZE * 4) {
                    int lastNewline = chaosPendingBuffer.lastIndexOf('\n', chaosPendingBuffer.lastIndexOf('\n') - 1);
                    if (lastNewline > 0) {
                        chaosPendingBuffer = chaosPendingBuffer.substring(lastNewline + 1);
                    }
                }
                return false;
            }
        }
        
        File checkFile = SPIFFS.open(CHAOS_HISTORY_FILE, FILE_READ);
        bool needHeader = !checkFile || checkFile.size() == 0;
        if (checkFile) checkFile.close();
        if (needHeader) {
            chaosPendingBuffer = String("timestamp,generation,individual,chaosTriggerCount,chaosTotalDuration,"
                "chaosMaxDuration,chaosFirstTime,chaosLastTime,"
                "baselineDistance,chaosDistance,baselineFrames,chaosFrames,"
                "baselineAvgSpeedL,baselineAvgSpeedR,chaosAvgSpeedL,chaosAvgSpeedR,"
                "chaosSuccess,testTerminatedBy\n") + chaosPendingBuffer;
        }
        bool success = appendToFile(CHAOS_HISTORY_FILE, chaosPendingBuffer);
        if (success) {
            chaosPendingBuffer = "";
            chaosUnsavedCount = 0;
        } else {
            Logger::log("⚠️ flushChaosBuffer: write failed, data retained in buffer");
        }
        return success;
    }

    static void forceSave() { 
        if (pendingBuffer.length() > 0) flushBuffer(); 
        if (chaosPendingBuffer.length() > 0) flushChaosBuffer();
    }
    
    static bool isReady() { return fsReady; }
    static uint32_t getTotalSaved() { return totalSaved; }
    static bool hasPendingData() { return pendingBuffer.length() > 0 || chaosPendingBuffer.length() > 0; }
    
    static void tick() {
        if (millis() - lastSaveTime > STORAGE_SAVE_INTERVAL_MS) {
            if (pendingBuffer.length() > 0) flushBuffer();
            if (chaosPendingBuffer.length() > 0) flushChaosBuffer();
        }
    }
    
    static void clearAll() { 
        pendingBuffer = ""; 
        unsavedCount = 0; 
        ramHistoryCount = 0; 
        chaosPendingBuffer = ""; 
        chaosUnsavedCount = 0;
        pendingBufferDirty = false;
    }
    
    static String getCSVData() {
        if (pendingBuffer.length() > 0) flushBuffer();
        if (fsReady && SPIFFS.exists(HISTORY_FILE)) {
            return FileUtils::readStringCapped(HISTORY_FILE, 131072);
        }
        String csv = "timestamp,generation,noveltyScore,survivalTime,distance_ticks,ruleCount\n";
        for (int i = 0; i < ramHistoryCount; i++) {
            csv += String(ramHistory[i].timestamp) + ",";
            csv += String(ramHistory[i].generation) + ",";
            csv += String(ramHistory[i].noveltyScore, 4) + ",";
            csv += String(ramHistory[i].survivalTime) + ",";
            csv += String(ramHistory[i].distance_ticks) + ",";
            csv += String(ramHistory[i].ruleCount) + "\n";
        }
        return csv;
    }

    static const char* CHAOS_HISTORY_FILE;

    static void addChaosRecord(const ChaoticTestRecord& record, bool forceFlush = false) {
        char line[512];
        snprintf(line, sizeof(line),
            "%lu,%lu,%d,%d,%lu,%lu,%lu,%lu,%ld,%ld,%d,%d,%.2f,%.2f,%.2f,%.2f,%d,%d\n",
            record.timestamp, record.generation, record.individual,
            record.chaosTriggerCount, record.chaosTotalDuration,
            record.chaosMaxDuration, record.chaosFirstTime,
            record.chaosLastTime,
            (long)record.baselineDistance, (long)record.chaosDistance,
            record.baselineFrames, record.chaosFrames,
            record.baselineAvgSpeedL, record.baselineAvgSpeedR,
            record.chaosAvgSpeedL, record.chaosAvgSpeedR,
            record.chaosSuccess, record.testTerminatedBy);
        
        chaosPendingBuffer += String(line);
        chaosUnsavedCount++;
        totalSaved++;
        if (forceFlush || chaosPendingBuffer.length() > MAX_BUFFER_SIZE || chaosUnsavedCount >= 5) {
            flushChaosBuffer();
        }
    }
    
    static String getChaosHistoryCSV() {
        if (!fsReady) return "";
        return FileUtils::readStringCapped(CHAOS_HISTORY_FILE, 131072);
    }
    
    static bool formatSPIFFS(bool confirmed = false) {
        if (!confirmed) {
            Logger::log("⚠️ formatSPIFFS() called without confirmation");
            return false;
        }
        
        Logger::log("========================================");
        Logger::log("⚠️ MANUAL SPIFFS FORMAT EXECUTED");
        Logger::log("========================================");
        
        SPIFFS.end();
        bool success = SPIFFS.format();
        if (success) {
            Logger::log("✅ SPIFFS formatted successfully");
            fsReady = SPIFFS.begin(false);
            if (fsReady) {
                Logger::log("✅ SPIFFS remounted");
            } else {
                Logger::log("❌ SPIFFS remount failed");
            }
        } else {
            Logger::log("❌ SPIFFS format failed");
        }
        return success;
    }
    
    static float getStorageHealth() {
        if (!fsReady) return 0.0f;
        size_t total = SPIFFS.totalBytes();
        size_t used = 0;
        File root = SPIFFS.open("/");
        if (root) {
            while (File f = root.openNextFile()) {
                used += f.size();
                f.close();
            }
            root.close();
        }
        float ratio = (float)used / total;
        if (ratio < 0.3f) return 1.0f;
        if (ratio < 0.6f) return 0.8f;
        if (ratio < 0.8f) return 0.5f;
        return 0.2f;
    }
};

// ★★★ 静态成员定义 ★★★
const char* RobustStorage::HISTORY_FILE = "/oe_history.csv";
const char* RobustStorage::CHAOS_HISTORY_FILE = "/chaos_history.csv";
bool RobustStorage::fsReady = false;
uint32_t RobustStorage::lastSaveTime = 0;
uint32_t RobustStorage::unsavedCount = 0;
uint32_t RobustStorage::totalSaved = 0;
String RobustStorage::pendingBuffer = "";
String RobustStorage::chaosPendingBuffer = "";
uint32_t RobustStorage::chaosUnsavedCount = 0;
HistoryRecord RobustStorage::ramHistory[1000];
int RobustStorage::ramHistoryCount = 0;
uint32_t RobustStorage::lastFsRetryTime = 0;
bool RobustStorage::pendingBufferDirty = false;


// ================================================================
// FileUtils 方法实现
// ================================================================
bool FileUtils::atomicWrite(const String& path, const uint8_t* data, size_t len) {
    if (!RobustStorage::isReady()) return false;
    
    String tempPath = path + ".tmp";
    for (int retry = 0; retry < 3; retry++) {
        if (SPIFFS.exists(tempPath)) SPIFFS.remove(tempPath);
        File tempFile = SPIFFS.open(tempPath, FILE_WRITE);
        if (!tempFile) { delay(10); continue; }
        size_t written = tempFile.write(data, len);
        tempFile.close();
        if (written != len) { SPIFFS.remove(tempPath); delay(10); continue; }
        
        if (!SPIFFS.rename(tempPath, path)) {
            if (SPIFFS.exists(path)) SPIFFS.remove(path);
            if (!SPIFFS.rename(tempPath, path)) {
                SPIFFS.remove(tempPath);
                delay(10);
                continue;
            }
        }
        return true;
    }
    return false;
}

bool FileUtils::atomicWriteString(const String& path, const String& content) {
    return atomicWrite(path, (const uint8_t*)content.c_str(), content.length());
}

String FileUtils::safeRead(const String& path) {
    if (!RobustStorage::isReady()) return "";
    if (!SPIFFS.exists(path)) return "";
    File file = SPIFFS.open(path, FILE_READ);
    if (!file) return "";
    String content = file.readString();
    file.close();
    return content;
}

String FileUtils::readStringCapped(const String& path, size_t maxBytes) {
    if (!RobustStorage::isReady()) return "";
    if (!SPIFFS.exists(path)) return "";
    File file = SPIFFS.open(path, FILE_READ);
    if (!file) return "";
    String out;
    size_t sz = file.size();
    if (sz > maxBytes) {
        out.reserve(maxBytes);
        uint8_t* tmp = (uint8_t*)malloc(maxBytes);
        if (tmp) {
            size_t n = file.read(tmp, maxBytes);
            out.concat((const char*)tmp, n);
            free(tmp);
        }
    } else {
        out = file.readString();
    }
    file.close();
    return out;
}

size_t FileUtils::getFileSize(const String& path) {
    if (!RobustStorage::isReady()) return 0;
    if (!SPIFFS.exists(path)) return 0;
    File file = SPIFFS.open(path, FILE_READ);
    if (!file) return 0;
    size_t size = file.size();
    file.close();
    return size;
}

bool FileUtils::exists(const String& path) {
    if (!RobustStorage::isReady()) return false;
    return SPIFFS.exists(path);
}
// ================================================================
// ★★★ TieredStorageManager 类 - 修复依赖检查 ★★★
// ================================================================

class TieredStorageManager {
public:
    static int getDataLevel(const String& filename) {
        if (filename == "/novelty_archive.bin" || 
            filename == "/novelty_archive.bin.bak" ||
            filename == "/novelty_archive.emergency.bin") {
            return DATA_LEVEL_CORE;
        }
        
        if (filename.startsWith("/gen_") || 
            filename.startsWith("/chaos_g")) {
            return DATA_LEVEL_GENE;
        }
        
        if (filename.startsWith("/pop_gen_")) {
            return DATA_LEVEL_POP;
        }
        
        if (filename.startsWith("/frm_") ||
            filename == "/oe_history.csv" ||
            filename == "/chaos_history.csv" ||
            filename == "/experiment_state.mrk") {
            return DATA_LEVEL_PROCESS;
        }
        
        return 0;
    }
    
    static String getLevelName(int level) {
        switch(level) {
            case DATA_LEVEL_CORE:    return "🔒 L1 核心";
            case DATA_LEVEL_GENE:    return "🧬 L2 基因";
            case DATA_LEVEL_POP:     return "📦 L3 种群";
            case DATA_LEVEL_PROCESS: return "📋 L4 过程";
            default:                 return "❓ 未知";
        }
    }
    
    // ★★★ 修复：由调用方传入当前代，避免交叉引用 ★★★
    static bool hasActiveDependency(const String& filename, uint32_t currentGen) {
        if (filename.startsWith("/pop_gen_")) {
            String numStr = filename.substring(9, filename.lastIndexOf('.'));
            uint32_t gen = numStr.toInt();
            if (gen > 0 && gen == currentGen) {
                return true;
            }
        }
        
        if (filename.startsWith("/gen_") || filename.startsWith("/chaos_")) {
            return true;
        }
        
        return false;
    }
    
    // ★★★ 修复：由调用方传入当前代 ★★★
    static int cleanL3AndL4(bool confirmed = false, bool previewOnly = false, uint32_t currentGen = 0) {
        if (!confirmed) {
            Logger::log("⚠️ cleanL3AndL4() called without confirmation");
            return -1;
        }
        
        if (!RobustStorage::isReady()) return 0;
        
        std::vector<String> toDelete;
        std::vector<String> protectedByDependency;
        
        File root = SPIFFS.open("/");
        if (root) {
            while (File f = root.openNextFile()) {
                String name = String(f.name());
                int level = getDataLevel(name);
                
                if (level == DATA_LEVEL_POP || level == DATA_LEVEL_PROCESS) {
                    if (hasActiveDependency(name, currentGen)) {
                        protectedByDependency.push_back(name);
                        Logger::logf("🔒 Protected (dependency): %s", name.c_str());
                        continue;
                    }
                    
                    if (level == DATA_LEVEL_POP) {
                        String numStr = name.substring(9, name.lastIndexOf('.'));
                        uint32_t gen = numStr.toInt();
                        if (gen == currentGen) {
                            protectedByDependency.push_back(name);
                            Logger::logf("🔒 Protected (current gen): %s", name.c_str());
                            continue;
                        }
                    }
                    
                    toDelete.push_back(name);
                }
                f.close();
            }
            root.close();
        }
        
        if (previewOnly) {
            Logger::log("📋 Preview of files to delete:");
            for (const String& name : toDelete) {
                Logger::logf("  🗑️ %s", name.c_str());
            }
            Logger::logf("📋 Protected: %d files", protectedByDependency.size());
            return toDelete.size();
        }
        
        int deleted = 0;
        for (const String& name : toDelete) {
            if (SPIFFS.remove(name)) {
                Logger::logf("🗑️ Deleted: %s", name.c_str());
                deleted++;
            }
        }
        
        Logger::logf("✅ Cleaned %d files (L3+L4), %d protected by dependency", 
                     deleted, protectedByDependency.size());
        return deleted;
    }
    
    static std::vector<uint32_t> getPopulationGenerations() {
        std::vector<uint32_t> gens;
        if (!RobustStorage::isReady()) return gens;
        
        File root = SPIFFS.open("/");
        if (!root) return gens;
        
        while (File f = root.openNextFile()) {
            String name = String(f.name());
            if (name.startsWith("/pop_gen_") && name.endsWith(".bin")) {
                String numStr = name.substring(9, name.lastIndexOf('.'));
                uint32_t gen = numStr.toInt();
                if (gen > 0) gens.push_back(gen);
            }
            f.close();
        }
        root.close();
        
        std::sort(gens.begin(), gens.end());
        return gens;
    }
    
    // ★★★ 修复：由调用方传入当前代 ★★★
    static String getCleanPreview(uint32_t currentGen = 0) {
        if (!RobustStorage::isReady()) return "SPIFFS not ready";
        
        std::vector<String> toDelete;
        std::vector<String> protectedFiles;
        
        File root = SPIFFS.open("/");
        if (root) {
            while (File f = root.openNextFile()) {
                String name = String(f.name());
                int level = getDataLevel(name);
                
                if (level == DATA_LEVEL_CORE || level == DATA_LEVEL_GENE) {
                    protectedFiles.push_back(name);
                    continue;
                }
                
                if (level == DATA_LEVEL_POP || level == DATA_LEVEL_PROCESS) {
                    if (hasActiveDependency(name, currentGen)) {
                        protectedFiles.push_back(name + " (dependency)");
                        continue;
                    }
                    if (level == DATA_LEVEL_POP) {
                        String numStr = name.substring(9, name.lastIndexOf('.'));
                        uint32_t gen = numStr.toInt();
                        if (gen == currentGen) {
                            protectedFiles.push_back(name + " (current)");
                            continue;
                        }
                    }
                    toDelete.push_back(name);
                }
                f.close();
            }
            root.close();
        }
        
        String result = "📋 Clean Preview:\n";
        result += "🗑️ To delete (" + String(toDelete.size()) + " files):\n";
        for (const String& name : toDelete) {
            result += "  - " + name + "\n";
        }
        result += "\n🔒 Protected (" + String(protectedFiles.size()) + " files):\n";
        for (const String& name : protectedFiles) {
            result += "  - " + name + "\n";
        }
        return result;
    }
    
    // ★★★ 新增：缺失的 getStorageStats ★★★
    static String getStorageStats() {
        if (!RobustStorage::isReady()) return "SPIFFS not ready";
        
        String result = "";
        size_t coreSize = 0, geneSize = 0, popSize = 0, processSize = 0;
        int coreCount = 0, geneCount = 0, popCount = 0, processCount = 0;
        
        File root = SPIFFS.open("/");
        if (root) {
            while (File f = root.openNextFile()) {
                String name = String(f.name());
                size_t size = f.size();
                int level = getDataLevel(name);
                
                switch(level) {
                    case DATA_LEVEL_CORE:
                        coreSize += size; coreCount++;
                        break;
                    case DATA_LEVEL_GENE:
                        geneSize += size; geneCount++;
                        break;
                    case DATA_LEVEL_POP:
                        popSize += size; popCount++;
                        break;
                    case DATA_LEVEL_PROCESS:
                        processSize += size; processCount++;
                        break;
                }
                f.close();
            }
            root.close();
        }
        
        result += "L1 核心: " + String(coreCount) + " 文件, " + String(coreSize/1024) + " KB\n";
        result += "L2 基因: " + String(geneCount) + " 文件, " + String(geneSize/1024) + " KB\n";
        result += "L3 种群: " + String(popCount) + " 文件, " + String(popSize/1024) + " KB\n";
        result += "L4 过程: " + String(processCount) + " 文件, " + String(processSize/1024) + " KB\n";
        
        size_t total = SPIFFS.totalBytes();
        size_t used = coreSize + geneSize + popSize + processSize;
        result += "总计: " + String(used/1024) + " KB / " + String(total/1024) + " KB";
        result += " (" + String(100 * used / total) + "%)\n";
        
        return result;
    }
};
// ================================================================
// ★★★ FirmwareVersionManager 类 - 只报警不清理 ★★★
// ================================================================

class FirmwareVersionManager {
public:
    // ★★★ 修改: isNewVersion - 永远返回 false ★★★
    static bool isNewVersion() {
        if (!RobustStorage::isReady()) return false;
        if (!SPIFFS.exists(VERSION_MARKER_FILE)) {
            writeVersionMarker();
            Logger::log("📌 First boot: version marker created (data preserved)");
            return false;
        }
        File marker = SPIFFS.open(VERSION_MARKER_FILE, FILE_READ);
        if (!marker) return false;
        String savedVersion = marker.readString();
        marker.close();
        savedVersion.trim();
        
        if (savedVersion != String(FIRMWARE_VERSION)) {
            Logger::log("========================================");
            Logger::log("⚠️ VERSION CHANGE DETECTED");
            Logger::logf("   Old: %s", savedVersion.c_str());
            Logger::logf("   New: %s", FIRMWARE_VERSION);
            Logger::log("   🔒 DATA PRESERVED - Auto-clear DISABLED");
            Logger::log("   📋 Use Web UI for manual cleanup");
            Logger::log("========================================");
            writeVersionMarker();
            return false;
        }
        return false;
    }
    
    // ★★★ 修改: cleanAllData - 只记录日志 ★★★
    static void cleanAllData() {
        Logger::log("========================================");
        Logger::log("⚠️ cleanAllData() called - DATA PRESERVED");
        Logger::log("   🔒 Auto-clear is DISABLED");
        Logger::log("   📋 Use Web UI for manual cleanup");
        Logger::log("========================================");
    }
    
    static void writeVersionMarker() {
        if (!RobustStorage::isReady()) return;
        if (SPIFFS.exists(VERSION_MARKER_FILE)) SPIFFS.remove(VERSION_MARKER_FILE);
        File marker = SPIFFS.open(VERSION_MARKER_FILE, FILE_WRITE);
        if (marker) { marker.println(FIRMWARE_VERSION); marker.close(); }
    }
};

// ================================================================
// Gene 结构体
// ================================================================
struct Gene {
    uint8_t ruleCount;
    BehaviorRule rules[MAX_RULES];
    uint32_t survival_time;
    int32_t  distance_ticks;
    float noveltyScore;
    BehaviorDescriptor behavior;
    BehaviorDescriptor baselineBehavior;

    int16_t obstacleThreshold;
    int16_t clearThreshold;
    int16_t encoderDiffThreshold;
    int16_t encoderDiffMin;
    int16_t wheelSpinThreshold;
    int16_t wheelStopThreshold;
    uint8_t stuckWindowSize;
    int16_t chaosNoiseAmplifier;
    int16_t chaosMinPwm;
    uint16_t chaosTimeoutMs;
    uint16_t chaosForceTimeoutMs;

    uint8_t  chaosRuleCount;
    uint8_t  chaosRulesStartIndex;
    bool     hasChaosRules;

    void init() {
        ruleCount = random(MIN_RULES, MAX_RULES + 1);
        for (int i = 0; i < ruleCount; i++) rules[i].randomize();
        survival_time = 0; distance_ticks = 0;
        noveltyScore = 0; behavior.init(); baselineBehavior.init();
        obstacleThreshold    = random(800, 2501);
        clearThreshold       = random(200, 1201);
        encoderDiffThreshold = random(10, 101);
        encoderDiffMin       = random(1, 21);
        wheelSpinThreshold   = random(5, 81);
        wheelStopThreshold   = random(1, 11);
        stuckWindowSize      = random(3, 21);
        chaosNoiseAmplifier  = random(50, 401);
        chaosMinPwm          = random(5, 81);
        chaosTimeoutMs       = random(CHAOS_TIMEOUT_MIN, CHAOS_TIMEOUT_MAX + 1);
        // ★★★ R9: 使用宏定义 ★★★
        chaosForceTimeoutMs  = random(CHAOS_FORCE_TIMEOUT_MIN, CHAOS_FORCE_TIMEOUT_MAX + 1);
        chaosRuleCount       = 0;
        chaosRulesStartIndex = 0;
        hasChaosRules        = false;
    }

    bool evaluateCondition(int ruleIdx, int leftSensor, int rightSensor, 
                           int32_t distance, uint32_t elapsed) const;

    void mutate(float mutationRate) {
        for (int i = 0; i < ruleCount; i++) {
            if (random(0, 1000) < mutationRate * 1000) { rules[i].condValue += random(-200,200); rules[i].clamp(); }
            if (random(0, 1000) < mutationRate * 1000) { rules[i].motorL += random(-50,50); rules[i].clamp(); }
            if (random(0, 1000) < mutationRate * 1000) { rules[i].motorR += random(-50,50); rules[i].clamp(); }
            if (random(0, 1000) < mutationRate * 500) { rules[i].durationMs += random(-200,200); rules[i].clamp(); }
            if (random(0, 1000) < mutationRate * 300) { rules[i].condType = random(0, 8); }
            if (random(0, 1000) < mutationRate * 300) { rules[i].condOp = random(0, 3); }
            if (random(0, 1000) < mutationRate * 200) { rules[i].nextRule = random(0, min(ruleCount, (uint8_t)3)); }
        }
        if (random(0, 1000) < mutationRate * 150 && ruleCount < MAX_RULES) {
            rules[ruleCount].randomize(); ruleCount++;
        }
        if (random(0, 1000) < mutationRate * 100 && ruleCount > MIN_RULES) {
            int delIdx = random(0, ruleCount); rules[delIdx] = rules[ruleCount - 1]; ruleCount--;
        }
        if (random(0, 1000) < mutationRate * 80 && ruleCount >= 2) {
            int a = random(0, ruleCount), b = random(0, ruleCount);
            if (a != b) { BehaviorRule tmp = rules[a]; rules[a] = rules[b]; rules[b] = tmp; }
        }
        if (random(0, 1000) < mutationRate * 500) { obstacleThreshold    += random(-100, 101); obstacleThreshold    = constrain(obstacleThreshold,    800, 2500); }
        if (random(0, 1000) < mutationRate * 500) { clearThreshold       += random(-50, 51);   clearThreshold       = constrain(clearThreshold,       200, 1200); }
        if (random(0, 1000) < mutationRate * 500) { encoderDiffThreshold += random(-5, 6);     encoderDiffThreshold = constrain(encoderDiffThreshold, 10,  100); }
        if (random(0, 1000) < mutationRate * 500) { encoderDiffMin       += random(-2, 3);     encoderDiffMin       = constrain(encoderDiffMin,       1,   20); }
        if (random(0, 1000) < mutationRate * 500) { wheelSpinThreshold   += random(-5, 6);     wheelSpinThreshold   = constrain(wheelSpinThreshold,   5,   80); }
        if (random(0, 1000) < mutationRate * 500) { wheelStopThreshold   += random(-1, 2);     wheelStopThreshold   = constrain(wheelStopThreshold,   1,   10); }
        if (random(0, 1000) < mutationRate * 300) { stuckWindowSize      += random(-2, 3);     stuckWindowSize      = constrain(stuckWindowSize,      3,   20); }
        if (random(0, 1000) < mutationRate * 500) { chaosNoiseAmplifier  += random(-30, 31);   chaosNoiseAmplifier  = constrain(chaosNoiseAmplifier,  50,  400); }
        if (random(0, 1000) < mutationRate * 500) { chaosMinPwm          += random(-5, 6);     chaosMinPwm          = constrain(chaosMinPwm,          5,   80); }
        
        if (random(0, 1000) < mutationRate * 500) {
            chaosTimeoutMs += random(-300, 301);
            chaosTimeoutMs = constrain(chaosTimeoutMs, CHAOS_TIMEOUT_MIN, CHAOS_TIMEOUT_MAX);
        }
        // ★★★ R9: 使用宏定义 ★★★
        if (random(0, 1000) < mutationRate * 500) {
            chaosForceTimeoutMs += random(-500, 501);
            chaosForceTimeoutMs = constrain(chaosForceTimeoutMs, CHAOS_FORCE_TIMEOUT_MIN, CHAOS_FORCE_TIMEOUT_MAX);
        }
    }

    static void crossover(const Gene& p1, const Gene& p2, Gene& child) {
        int cut1 = random(0, p1.ruleCount), cut2 = random(0, p2.ruleCount);
        int fromP1 = cut1, fromP2 = p2.ruleCount - cut2;
        child.ruleCount = constrain(fromP1 + fromP2, MIN_RULES, MAX_RULES);
        for (int i = 0; i < fromP1 && i < child.ruleCount; i++) child.rules[i] = p1.rules[i];
        for (int i = 0; i < fromP2 && (fromP1 + i) < child.ruleCount; i++) child.rules[fromP1 + i] = p2.rules[cut2 + i];
        for (int i = fromP1 + fromP2; i < child.ruleCount; i++) child.rules[i] = p1.rules[i % p1.ruleCount];
        child.survival_time = 0; child.distance_ticks = 0;
        child.noveltyScore = 0; child.behavior.init(); child.baselineBehavior.init();
        child.obstacleThreshold    = (random(0,2) == 0) ? p1.obstacleThreshold    : p2.obstacleThreshold;
        child.clearThreshold       = (random(0,2) == 0) ? p1.clearThreshold       : p2.clearThreshold;
        child.encoderDiffThreshold = (random(0,2) == 0) ? p1.encoderDiffThreshold : p2.encoderDiffThreshold;
        child.encoderDiffMin       = (random(0,2) == 0) ? p1.encoderDiffMin       : p2.encoderDiffMin;
        child.wheelSpinThreshold   = (random(0,2) == 0) ? p1.wheelSpinThreshold   : p2.wheelSpinThreshold;
        child.wheelStopThreshold   = (random(0,2) == 0) ? p1.wheelStopThreshold   : p2.wheelStopThreshold;
        child.stuckWindowSize      = (random(0,2) == 0) ? p1.stuckWindowSize      : p2.stuckWindowSize;
        child.chaosNoiseAmplifier  = (random(0,2) == 0) ? p1.chaosNoiseAmplifier  : p2.chaosNoiseAmplifier;
        child.chaosMinPwm          = (random(0,2) == 0) ? p1.chaosMinPwm          : p2.chaosMinPwm;
        child.chaosTimeoutMs       = (random(0,2) == 0) ? p1.chaosTimeoutMs       : p2.chaosTimeoutMs;
        child.chaosForceTimeoutMs  = (random(0,2) == 0) ? p1.chaosForceTimeoutMs  : p2.chaosForceTimeoutMs;
        
        int chaosInherited = 0;
        if (p1.hasChaosRules && p2.hasChaosRules) {
            const Gene& donor = (random(0, 2) == 0) ? p1 : p2;
            int donorStart = donor.chaosRulesStartIndex;
            int donorCount = donor.chaosRuleCount;
            while (child.ruleCount < MAX_RULES && chaosInherited < donorCount) {
                child.rules[child.ruleCount] = donor.rules[donorStart + chaosInherited];
                child.ruleCount++;
                chaosInherited++;
            }
        } else if (p1.hasChaosRules) {
            while (child.ruleCount < MAX_RULES && chaosInherited < p1.chaosRuleCount) {
                child.rules[child.ruleCount] = p1.rules[p1.chaosRulesStartIndex + chaosInherited];
                child.ruleCount++;
                chaosInherited++;
            }
        } else if (p2.hasChaosRules) {
            while (child.ruleCount < MAX_RULES && chaosInherited < p2.chaosRuleCount) {
                child.rules[child.ruleCount] = p2.rules[p2.chaosRulesStartIndex + chaosInherited];
                child.ruleCount++;
                chaosInherited++;
            }
        }
        if (chaosInherited > 0) {
            child.hasChaosRules = true;
            child.chaosRuleCount = chaosInherited;
            child.chaosRulesStartIndex = child.ruleCount - chaosInherited;
        } else {
            child.hasChaosRules = false;
            child.chaosRuleCount = 0;
            child.chaosRulesStartIndex = 0;
        }
    }
};

// ================================================================
// Gene::evaluateCondition 实现
// ================================================================
bool Gene::evaluateCondition(int ruleIdx, int leftSensor, int rightSensor, 
                             int32_t distance, uint32_t elapsed) const {
    const BehaviorRule& r = rules[ruleIdx];
    int value = 0;
    switch (r.condType) {
        case COND_SENSOR_LEFT:  value = leftSensor; break;
        case COND_SENSOR_RIGHT: value = rightSensor; break;
        case COND_SENSOR_BOTH:  return (leftSensor > obstacleThreshold) && (rightSensor > obstacleThreshold);
        case COND_SENSOR_ANY:   return (leftSensor > obstacleThreshold) || (rightSensor > obstacleThreshold);
        case COND_DISTANCE:     value = (int)distance; break;
        case COND_TIME:         value = (int)elapsed; break;
        case COND_IDLE:         return (leftSensor < clearThreshold) && (rightSensor < clearThreshold);
        case COND_ALWAYS:       return true;
        default: return false;
    }
    return r.compare(value, r.condOp, r.condValue);
}

// ================================================================
// ★★★ RollingStorage 类 - 增强空间检查 + 渐进式清理 + 依赖追踪 ★★★
// ================================================================

class RollingStorage {
private:
    static const int MAX_GENERATIONS = SPIFFS_MAX_GENERATIONS;
    static const int MAX_INDIVIDUALS_PER_GEN = SPIFFS_MAX_INDIVIDUALS_PER_GEN;
    static uint32_t freeSpaceThreshold;
    static int savedCount[100];
    static uint32_t currentGenerationForStorage;
    static int cleanupAttempts;
    static uint32_t lastCleanupWarningTime;
    
    // ★★★ P1修复：活跃依赖追踪 ★★★
    struct ActiveDependency {
        uint32_t generation;
        int individual;
        bool isActive;
        uint32_t startTime;
    };
    static ActiveDependency activeDependencies[16];
    static int dependencyCount;
    
    // 安全余量
    static const uint32_t SAFETY_MARGIN = 4096;  // 4KB
    
    static size_t getFreeSpace() {
        if (!RobustStorage::isReady()) return 0;
        size_t used = 0;
        File root = SPIFFS.open("/");
        if (!root) return 0;
        while (File f = root.openNextFile()) {
            used += f.size();
            f.close();
        }
        root.close();
        size_t total = SPIFFS.totalBytes();
        return (total > used) ? (total - used) : 0;
    }
    
    static std::vector<uint32_t> getStoredGenerations() {
        std::vector<uint32_t> gens;
        if (!RobustStorage::isReady()) return gens;
        File root = SPIFFS.open("/");
        if (!root) return gens;
        while (File f = root.openNextFile()) {
            String name = String(f.name());
            if (name.startsWith("/pop_gen_")) {
                String numStr = name.substring(9, name.lastIndexOf('.'));
                uint32_t gen = numStr.toInt();
                if (gen > 0) {
                    bool exists = false;
                    for (auto g : gens) if (g == gen) { exists = true; break; }
                    if (!exists) gens.push_back(gen);
                }
            }
            f.close();
        }
        root.close();
        std::sort(gens.begin(), gens.end());
        return gens;
    }
    
    // ★★★ 依赖追踪辅助函数 ★★★
    static bool hasActiveDependency(uint32_t gen) {
        uint32_t now = millis();
        for (int i = 0; i < dependencyCount; i++) {
            if (now - activeDependencies[i].startTime > 60000) {
                activeDependencies[i].isActive = false;
                continue;
            }
            if (activeDependencies[i].isActive && 
                activeDependencies[i].generation == gen) {
                return true;
            }
        }
        return false;
    }
    
    static void cleanExpiredDependencies() {
        uint32_t now = millis();
        for (int i = 0; i < dependencyCount; i++) {
            if (now - activeDependencies[i].startTime > 60000) {
                activeDependencies[i].isActive = false;
            }
        }
    }
    
    static int cleanExpiredFrameLogs() {
        if (!RobustStorage::isReady()) return 0;
        std::vector<String> toDelete;
        File root = SPIFFS.open("/");
        if (!root) return 0;
        
        while (File f = root.openNextFile()) {
            String name = String(f.name());
            if (name.startsWith("/frm_") && name.endsWith(".bin")) {
                toDelete.push_back(name);
            }
            f.close();
        }
        root.close();
        
        std::sort(toDelete.begin(), toDelete.end());
        int keepCount = 3;
        int deleted = 0;
        if (toDelete.size() > keepCount) {
            for (int i = 0; i < toDelete.size() - keepCount; i++) {
                if (SPIFFS.remove(toDelete[i])) {
                    deleted++;
                    Logger::logf("🧹 Deleted old frame log: %s", toDelete[i].c_str());
                }
            }
        }
        return deleted;
    }
    
    static int cleanOldPopulations(int keepGenerations) {
        if (!RobustStorage::isReady()) return 0;
        auto gens = getStoredGenerations();
        if (gens.size() <= keepGenerations) return 0;
        
        uint32_t currentGen = currentGenerationForStorage;
        int deleted = 0;
        
        for (auto gen : gens) {
            if (gen == currentGen) continue;
            if (hasActiveDependency(gen)) continue;
            
            bool isRecent = false;
            int recentCount = 0;
            for (int i = gens.size() - 1; i >= 0 && recentCount < keepGenerations; i--) {
                if (gens[i] == gen) { isRecent = true; break; }
                recentCount++;
            }
            if (isRecent) continue;
            
            String popPath = "/pop_gen_" + String(gen) + ".bin";
            if (SPIFFS.exists(popPath) && SPIFFS.remove(popPath)) {
                deleted++;
                Logger::logf("🧹 Deleted old population: gen %lu", gen);
            }
        }
        return deleted;
    }
    
    static bool progressiveCleanup(size_t requiredBytes) {
        Logger::log("🔄 Starting progressive cleanup...");
        size_t free = getFreeSpace();
        int maxIterations = 5;
        
        for (int i = 0; i < maxIterations; i++) {
            if (free >= requiredBytes + SAFETY_MARGIN) {
                Logger::logf("✅ Cleanup done, free: %d bytes", free);
                return true;
            }
            
            int deleted = cleanExpiredFrameLogs();
            if (deleted > 0) {
                Logger::logf("  🧹 Iteration %d: deleted %d frame logs", i+1, deleted);
                free = getFreeSpace();
                if (free >= requiredBytes + SAFETY_MARGIN) {
                    return true;
                }
            }
            
            int popDeleted = cleanOldPopulations(2);
            if (popDeleted > 0) {
                Logger::logf("  🧹 Iteration %d: deleted %d old populations", i+1, popDeleted);
                free = getFreeSpace();
                if (free >= requiredBytes + SAFETY_MARGIN) {
                    return true;
                }
            }
            
            delay(50);
        }
        
        Logger::log("⚠️ Progressive cleanup failed to free enough space");
        return false;
    }
    
    static void deleteGeneration(uint32_t gen) {
        if (!RobustStorage::isReady()) return;
        
        if (hasActiveDependency(gen)) {
            Logger::logf("🔒 Protected: gen %lu has active dependency", gen);
            return;
        }
        
        String genPrefix = "/gen_" + String(gen) + "_";
        bool hasGeneData = false;
        File root = SPIFFS.open("/");
        if (root) {
            while (File f = root.openNextFile()) {
                String name = String(f.name());
                if (name.startsWith(genPrefix)) {
                    hasGeneData = true;
                    break;
                }
                f.close();
            }
            root.close();
        }
        
        if (hasGeneData) {
            Logger::logf("🔒 Protected: gen %lu has gene data", gen);
            return;
        }
        
        std::vector<String> toDelete;
        String popPrefix = "/pop_gen_" + String(gen) + ".";
        String frmPrefix = "/frm_" + String(gen) + "_";
        String chaosPrefix = "/chaos_g" + String(gen) + "_";
        String chaosSnapsPrefix = "/chaos_snaps_g" + String(gen) + "_";
        
        root = SPIFFS.open("/");
        if (root) {
            while (File f = root.openNextFile()) {
                String name = String(f.name());
                if (name.startsWith(popPrefix) || name.startsWith(frmPrefix) ||
                    name.startsWith(chaosPrefix) || name.startsWith(chaosSnapsPrefix)) {
                    toDelete.push_back(name);
                }
                f.close();
            }
            root.close();
        }
        
        int deleted = 0;
        for (const String& name : toDelete) {
            if (SPIFFS.remove(name)) deleted++;
        }
        if (deleted > 0) {
            Logger::logf("🧹 Deleted generation %lu (%d files)", gen, deleted);
        }
    }
    
public:
    // ★★★ 依赖追踪公共接口 ★★★
    static void registerDependency(uint32_t generation, int individual) {
        uint32_t now = millis();
        
        cleanExpiredDependencies();
        
        for (int i = 0; i < dependencyCount; i++) {
            if (activeDependencies[i].generation == generation && 
                activeDependencies[i].individual == individual) {
                activeDependencies[i].isActive = true;
                activeDependencies[i].startTime = now;
                return;
            }
        }
        
        if (dependencyCount < 16) {
            activeDependencies[dependencyCount].generation = generation;
            activeDependencies[dependencyCount].individual = individual;
            activeDependencies[dependencyCount].isActive = true;
            activeDependencies[dependencyCount].startTime = now;
            dependencyCount++;
            Logger::logf("🔗 Dependency registered: gen=%lu, ind=%d", generation, individual);
        } else {
            Logger::logf("⚠️ Dependency full! gen=%lu, ind=%d", generation, individual);
        }
    }
    
    static void unregisterDependency(uint32_t generation, int individual) {
        for (int i = 0; i < dependencyCount; i++) {
            if (activeDependencies[i].generation == generation && 
                activeDependencies[i].individual == individual) {
                activeDependencies[i].isActive = false;
                Logger::logf("🔓 Dependency unregistered: gen=%lu, ind=%d", generation, individual);
                break;
            }
        }
    }
    
    static String getDependencyInfo() {
        String info = "=== Dependency Info ===\n";
        info += "Active: " + String(dependencyCount) + "/16\n";
        for (int i = 0; i < 16 && i < dependencyCount; i++) {
            if (activeDependencies[i].isActive) {
                info += "  gen=" + String(activeDependencies[i].generation);
                info += ", ind=" + String(activeDependencies[i].individual);
                info += ", age=" + String((millis() - activeDependencies[i].startTime) / 1000) + "s\n";
            }
        }
        return info;
    }
    
    // ★★★ 删除最旧代（带依赖保护）★★★
    static void deleteOldestGeneration(bool force = false) {
        if (!RobustStorage::isReady()) return;
        if (!force) {
            Logger::log("⚠️ deleteOldestGeneration() called without force flag");
            return;
        }
        
        cleanExpiredDependencies();
        auto gens = getStoredGenerations();
        if (gens.empty()) return;
        
        uint32_t currentGen = currentGenerationForStorage;
        
        for (auto g : gens) {
            if (g == currentGen) {
                Logger::logf("🔒 Skipping current generation: %lu", g);
                continue;
            }
            if (hasActiveDependency(g)) {
                Logger::logf("🔒 Skipping generation with active dependency: %lu", g);
                continue;
            }
            Logger::logf("🗑️ Force deleting generation %lu", g);
            deleteGeneration(g);
            return;
        }
        Logger::log("⚠️ No deletable generation found (all protected)");
    }

    static void init() {
        freeSpaceThreshold = 50 * 1024;
        currentGenerationForStorage = 0;
        cleanupAttempts = 0;
        lastCleanupWarningTime = 0;
        
        // ★★★ 初始化依赖追踪 ★★★
        dependencyCount = 0;
        for (int i = 0; i < 16; i++) {
            activeDependencies[i].generation = 0;
            activeDependencies[i].individual = -1;
            activeDependencies[i].isActive = false;
            activeDependencies[i].startTime = 0;
        }
        
        memset(savedCount, 0, sizeof(savedCount));
        Logger::logf("RollingStorage: max %d generations (auto-delete DISABLED)", MAX_GENERATIONS);
        Logger::log("🔒 Dependency tracking enabled (16 slots)");
        Logger::log("🔒 Progressive cleanup enabled");
    }
    
    static void setCurrentGeneration(uint32_t gen) {
        currentGenerationForStorage = gen;
    }
    
    static uint32_t getCurrentGeneration() {
        return currentGenerationForStorage;
    }
    
    // ★★★ 增强版 ensureSpace ★★★
    static bool ensureSpace(size_t requiredBytes, uint32_t currentGen = 0) {
        if (!RobustStorage::isReady()) {
            Logger::log("❌ ensureSpace: SPIFFS not ready");
            return false;
        }
        
        cleanExpiredDependencies();
        size_t free = getFreeSpace();
        size_t needed = requiredBytes + SAFETY_MARGIN;
        
        if (free >= needed) {
            return true;
        }
        
        Logger::logf("⚠️ Space check: free=%d, need=%d", free, needed);
        
        if (currentGen == 0) {
            currentGen = currentGenerationForStorage;
        }
        
        if (progressiveCleanup(requiredBytes)) {
            return true;
        }
        
        cleanupAttempts++;
        if (cleanupAttempts > 3) {
            Logger::log("🚨 Emergency: force deleting oldest generation");
            deleteOldestGeneration(true);
            free = getFreeSpace();
            if (free >= needed) {
                cleanupAttempts = 0;
                return true;
            }
        }
        
        if (millis() - lastCleanupWarningTime > 30000) {
            lastCleanupWarningTime = millis();
            Logger::log("========================================");
            Logger::log("❌ STORAGE SPACE CRITICAL");
            Logger::logf("   Free: %d bytes, Need: %d bytes", free, needed);
            Logger::log("   📋 Manual cleanup required via Web UI");
            Logger::log("========================================");
        }
        
        return false;
    }
    
    static bool saveFrameLog(uint32_t generation, int individual, 
                             const FrameLogEntry* log, int count, int head = 0,
                             int startOffset = 0, int saveCount = -1,
                             bool isIncremental = false) {
        if (!RobustStorage::isReady() || count == 0) return false;
        if (saveCount < 0) saveCount = count;
        if (startOffset + saveCount > count) saveCount = count - startOffset;
        if (saveCount <= 0) return false;
        
        size_t estimatedSize = saveCount * sizeof(CompressedFrameEntry) + sizeof(FileHeader) + 512;
        if (!ensureSpace(estimatedSize, generation)) {
            Logger::logf("❌ saveFrameLog gen=%lu id=%d: insufficient space", generation, individual);
            return false;
        }
        
        int exportCount = min(saveCount, FRAME_LOG_SIZE);
        size_t dataSize = exportCount * sizeof(CompressedFrameEntry);
        uint8_t* dataBuffer = (uint8_t*)malloc(dataSize);
        if (!dataBuffer) return false;
        
        uint8_t* ptr = dataBuffer;
        FrameLogEntry prev = {0};
        for (int i = 0; i < exportCount; i++) {
            int idx = (head - count + startOffset + i + FRAME_LOG_SIZE) % FRAME_LOG_SIZE;
            const FrameLogEntry& e = log[idx];
            CompressedFrameEntry compressed;
            compressed.timestamp_ms = e.timestamp_ms;
            compressed.sensorLeft = e.sensorLeft;
            compressed.sensorRight = e.sensorRight;
            compressed.directionL = e.directionL;
            compressed.directionR = e.directionR;
            compressed.chaosActive = e.chaosActive;
            compressed.isChaosFrame = e.isChaosFrame;
            compressed.state = e.state;
            compressed.reserved = 0;
            
            if (i == 0) {
                compressed.motorLeftPWM = e.motorLeftPWM;
                compressed.motorRightPWM = e.motorRightPWM;
            } else {
                compressed.motorLeftPWM = constrain(e.motorLeftPWM - prev.motorLeftPWM, -128, 127);
                compressed.motorRightPWM = constrain(e.motorRightPWM - prev.motorRightPWM, -128, 127);
            }
            memcpy(ptr, &compressed, sizeof(CompressedFrameEntry));
            ptr += sizeof(CompressedFrameEntry);
            prev = e;
        }
        
        FileHeader header;
        header.magic = 0x47454E45;
        header.version = 0x0006;
        header.headerSize = sizeof(FileHeader);
        header.frameCount = exportCount;
        header.generation = generation;
        header.individual = individual;
        header.reserved = 0;
        header.crc32 = CRC32::calculate(dataBuffer, dataSize);
        
        size_t totalSize = sizeof(FileHeader) + dataSize;
        uint8_t* finalBuffer = (uint8_t*)malloc(totalSize);
        if (!finalBuffer) { free(dataBuffer); return false; }
        
        memcpy(finalBuffer, &header, sizeof(FileHeader));
        memcpy(finalBuffer + sizeof(FileHeader), dataBuffer, dataSize);
        free(dataBuffer);
        
        String path = "/frm_" + String(generation) + "_i" + String(individual) + (isIncremental ? ".inc.bin" : ".bin");
        bool success = FileUtils::atomicWrite(path, finalBuffer, totalSize);
        free(finalBuffer);
        
        if (success) {
            savedCount[generation % 100]++;
            Logger::logf("💾 saveFrameLog gen=%lu id=%d ✅", generation, individual);
        } else {
            Logger::logf("❌ saveFrameLog gen=%lu id=%d FAILED", generation, individual);
        }
        return success;
    }
    
    static bool incrementalSave(uint32_t generation, int individual,
                                const FrameLogEntry* log, int count, int head = 0) {
        if (count % INCREMENTAL_SAVE_INTERVAL != 0) return false;
        if (count < INCREMENTAL_SAVE_INTERVAL) return false;
        int startIdx = count - INCREMENTAL_SAVE_INTERVAL;
        return saveFrameLog(generation, individual, log, count, head, startIdx, INCREMENTAL_SAVE_INTERVAL, true);
    }
    
    static void resetGenerationCounter(uint32_t gen) {
        savedCount[gen % 100] = 0;
    }
    
    static String getStorageStatus() {
        String status = "=== Storage Status ===\n";
        size_t free = getFreeSpace();
        status += "Free space: " + String(free / 1024) + " KB\n";
        auto gens = getStoredGenerations();
        status += "Stored generations: " + String(gens.size()) + "\n";
        for (auto g : gens) {
            bool hasDep = hasActiveDependency(g);
            status += "  Gen " + String(g) + (hasDep ? " 🔒 (active)" : "");
            if (g == currentGenerationForStorage) status += " ← current";
            status += "\n";
        }
        status += "\n🔒 AUTO-DELETE: DISABLED (except emergency)\n";
        status += "📋 Use Web UI to clean old data\n";
        return status;
    }
    
    static size_t getFreeSpaceKB() {
        return getFreeSpace() / 1024;
    }
    
    static std::vector<uint32_t> getStoredGenerationsPublic() {
        return getStoredGenerations();
    }
    
    static void resetCleanupAttempts() {
        cleanupAttempts = 0;
    }
};

// ★★★ RollingStorage 静态成员定义 ★★★
uint32_t RollingStorage::freeSpaceThreshold = 50 * 1024;
int RollingStorage::savedCount[100] = {0};
uint32_t RollingStorage::currentGenerationForStorage = 0;
int RollingStorage::cleanupAttempts = 0;
uint32_t RollingStorage::lastCleanupWarningTime = 0;
RollingStorage::ActiveDependency RollingStorage::activeDependencies[16];
int RollingStorage::dependencyCount = 0;

// ================================================================
// ★★★ GeneStorage 类 - 修复 P0 问题3：loadExperimentState 回退漏洞 ★★★
// ================================================================

class GeneStorage {
private:
    static const uint32_t MAX_GENERATIONS_PER_EXPERIMENT = 0xFFFFFFFF;
    static const uint16_t FILE_VERSION = 0x0006;
    static const uint32_t FILE_MAGIC = 0x47454E45;
    static const char* POP_PREFIX;
    static const char* GEN_RECORD_PREFIX;
    static const char* FRAME_LOG_PREFIX;
    static const char* EXPERIMENT_MARKER;
    static uint32_t currentExperimentId;
    static uint32_t currentGeneration;
    static bool experimentActive;
    static uint32_t pendingGeneration;
    static bool hasPendingGeneration;
    static bool pendingStateSave;

    static size_t serializeIndividual(const Gene& g, uint8_t* buffer, size_t maxSize) {
        uint8_t* ptr = buffer;
        size_t used = 0;
        
        if (used + 1 > maxSize) return 0;
        uint8_t rc = constrain(g.ruleCount, MIN_RULES, MAX_RULES);
        *ptr = rc; ptr++; used += 1;
        
        size_t rulesSize = rc * sizeof(BehaviorRule);
        if (used + rulesSize > maxSize) return 0;
        memcpy(ptr, g.rules, rulesSize);
        ptr += rulesSize; used += rulesSize;
        
        if (used + 4 > maxSize) return 0;
        memcpy(ptr, &g.survival_time, 4);
        ptr += 4; used += 4;
        
        if (used + 4 > maxSize) return 0;
        memcpy(ptr, &g.distance_ticks, 4);
        ptr += 4; used += 4;
        
        if (used + 4 > maxSize) return 0;
        memcpy(ptr, &g.noveltyScore, 4);
        ptr += 4; used += 4;
        
        if (used + 12 > maxSize) return 0;
        memcpy(ptr, &g.obstacleThreshold, 2); ptr += 2; used += 2;
        memcpy(ptr, &g.clearThreshold, 2); ptr += 2; used += 2;
        memcpy(ptr, &g.encoderDiffThreshold, 2); ptr += 2; used += 2;
        memcpy(ptr, &g.encoderDiffMin, 2); ptr += 2; used += 2;
        memcpy(ptr, &g.wheelSpinThreshold, 2); ptr += 2; used += 2;
        memcpy(ptr, &g.wheelStopThreshold, 2); ptr += 2; used += 2;
        
        if (used + 1 > maxSize) return 0;
        *ptr = g.stuckWindowSize; ptr++; used += 1;
        
        if (used + 8 > maxSize) return 0;
        memcpy(ptr, &g.chaosNoiseAmplifier, 2); ptr += 2; used += 2;
        memcpy(ptr, &g.chaosMinPwm, 2); ptr += 2; used += 2;
        memcpy(ptr, &g.chaosTimeoutMs, 2); ptr += 2; used += 2;
        memcpy(ptr, &g.chaosForceTimeoutMs, 2); ptr += 2; used += 2;
        
        if (used + 3 > maxSize) return 0;
        *ptr = g.hasChaosRules ? 1 : 0; ptr++; used += 1;
        *ptr = g.chaosRuleCount; ptr++; used += 1;
        *ptr = g.chaosRulesStartIndex; ptr++; used += 1;
        
        return used;
    }

    static size_t deserializeIndividual(const uint8_t* buffer, size_t maxSize, Gene& g, uint16_t fileVersion) {
        const uint8_t* ptr = buffer;
        size_t used = 0;
        
        if (used + 1 > maxSize) return 0;
        g.ruleCount = *ptr; ptr++; used += 1;
        if (g.ruleCount > MAX_RULES) g.ruleCount = MAX_RULES;
        
        size_t rulesSize = g.ruleCount * sizeof(BehaviorRule);
        if (used + rulesSize > maxSize) return 0;
        memcpy(g.rules, ptr, rulesSize);
        ptr += rulesSize; used += rulesSize;
        
        if (used + 12 > maxSize) return 0;
        memcpy(&g.survival_time, ptr, 4); ptr += 4; used += 4;
        memcpy(&g.distance_ticks, ptr, 4); ptr += 4; used += 4;
        memcpy(&g.noveltyScore, ptr, 4); ptr += 4; used += 4;
        
        if (fileVersion >= 0x0005) {
            if (used + 12 > maxSize) return 0;
            memcpy(&g.obstacleThreshold, ptr, 2); ptr += 2; used += 2;
            memcpy(&g.clearThreshold, ptr, 2); ptr += 2; used += 2;
            memcpy(&g.encoderDiffThreshold, ptr, 2); ptr += 2; used += 2;
            memcpy(&g.encoderDiffMin, ptr, 2); ptr += 2; used += 2;
            memcpy(&g.wheelSpinThreshold, ptr, 2); ptr += 2; used += 2;
            memcpy(&g.wheelStopThreshold, ptr, 2); ptr += 2; used += 2;
            
            if (used + 1 > maxSize) return 0;
            g.stuckWindowSize = *ptr; ptr++; used += 1;
            
            if (used + 8 > maxSize) return 0;
            memcpy(&g.chaosNoiseAmplifier, ptr, 2); ptr += 2; used += 2;
            memcpy(&g.chaosMinPwm, ptr, 2); ptr += 2; used += 2;
            memcpy(&g.chaosTimeoutMs, ptr, 2); ptr += 2; used += 2;
            memcpy(&g.chaosForceTimeoutMs, ptr, 2); ptr += 2; used += 2;
            
            if (fileVersion >= 0x0006) {
                if (used + 3 > maxSize) return 0;
                g.hasChaosRules = (*ptr == 1); ptr++; used += 1;
                g.chaosRuleCount = *ptr; ptr++; used += 1;
                g.chaosRulesStartIndex = *ptr; ptr++; used += 1;
            } else {
                g.hasChaosRules = false;
                g.chaosRuleCount = 0;
                g.chaosRulesStartIndex = 0;
            }
        } else {
            g.obstacleThreshold = 1500;
            g.clearThreshold = 600;
            g.encoderDiffThreshold = 30;
            g.encoderDiffMin = 5;
            g.wheelSpinThreshold = 20;
            g.wheelStopThreshold = 3;
            g.stuckWindowSize = 10;
            g.chaosNoiseAmplifier = 180;
            g.chaosMinPwm = 20;
            g.chaosTimeoutMs = 3000;
            g.chaosForceTimeoutMs = 5000;
            g.hasChaosRules = false;
            g.chaosRuleCount = 0;
            g.chaosRulesStartIndex = 0;
        }
        
        g.behavior.init();
        return used;
    }

    // ★★★ P0修复：延迟状态保存（不立即写盘）★★★
    static void scheduleStateSave() {
        pendingStateSave = true;
    }
    
    static void flushPendingStateSave() {
        if (!pendingStateSave) return;
        if (!RobustStorage::isReady()) {
            Logger::log("⚠️ Cannot flush state save: SPIFFS not ready");
            return;
        }
        String content = String(currentExperimentId) + "," + String(currentGeneration);
        if (FileUtils::atomicWriteString(EXPERIMENT_MARKER, content)) {
            pendingStateSave = false;
            Logger::logf("💾 State saved: ID=%lu, gen=%lu", currentExperimentId, currentGeneration);
        } else {
            Logger::log("⚠️ State save failed, will retry later");
        }
    }
    
    static bool safeSaveState() {
        if (!RobustStorage::isReady()) return false;
        String content = String(currentExperimentId) + "," + String(currentGeneration);
        for (int retry = 0; retry < 3; retry++) {
            if (FileUtils::atomicWriteString(EXPERIMENT_MARKER, content)) {
                pendingStateSave = false;
                return true;
            }
            delay(50);
        }
        pendingStateSave = true;
        return false;
    }

    // ★★★ P0修复：智能恢复 - 不立即持久化 ★★★
    static uint32_t findRecoverableGeneration(uint32_t savedGen) {
        // 1. 检查 savedGen 是否有效
        if (savedGen > 0) {
            String popPath = "/pop_gen_" + String(savedGen) + ".bin";
            if (SPIFFS.exists(popPath) && verifyPopulationFile(popPath, POPULATION_SIZE)) {
                return savedGen;
            }
        }
        
        // 2. 回退到前一代
        if (savedGen > 1) {
            uint32_t prevGen = savedGen - 1;
            String prevPath = "/pop_gen_" + String(prevGen) + ".bin";
            if (SPIFFS.exists(prevPath) && verifyPopulationFile(prevPath, POPULATION_SIZE)) {
                Logger::logf("✅ Recovered to previous generation: %lu", prevGen);
                return prevGen;
            }
        }
        
        // 3. 扫描所有可用代
        uint32_t latest = findLatestGeneration();
        if (latest > 0) {
            Logger::logf("✅ Recovered to latest available generation: %lu", latest);
            return latest;
        }
        
        // 4. 无可用数据
        return 0;
    }

public:
    static void init() {
        currentExperimentId = 0;
        currentGeneration = 0;
        experimentActive = false;
        pendingGeneration = 0;
        hasPendingGeneration = false;
        pendingStateSave = false;
        
        if (!RobustStorage::isReady()) {
            Logger::log("SPIFFS unavailable, using RAM mode");
            return;
        }
        loadExperimentState();
        if (pendingStateSave) {
            flushPendingStateSave();
        }
        Logger::logf("Gene storage initialized, current gen=%lu, active=%d", 
                     currentGeneration, experimentActive);
    }
    
    static void forceActivate() {
        experimentActive = true;
        if (currentGeneration == 0) {
            uint32_t latest = findLatestGeneration();
            if (latest > 0) {
                currentGeneration = latest;
            } else {
                currentGeneration = 1;
                Logger::log("⚠️ No existing data - will create new population on init");
            }
        }
        safeSaveState();
        Logger::logf("🔧 Force activated: gen=%lu, active=%d", 
                     currentGeneration, experimentActive);
    }
    
    static void loadExperimentState() {
    if (!RobustStorage::isReady()) {
        experimentActive = false;
        return;
    }
    
    String content = FileUtils::safeRead(EXPERIMENT_MARKER);
    
    // 1. 无状态文件 → 扫描恢复
    if (content.length() == 0) {
        uint32_t latest = findLatestGeneration();
        if (latest > 0) {
            Logger::logf("✅ Recovered to generation %lu (no state file)", latest);
            currentExperimentId = (uint32_t)millis();
            currentGeneration = latest;
            RollingStorage::setCurrentGeneration(latest);
            experimentActive = true;
            scheduleStateSave();  // 延迟保存，不立即写盘
            return;
        }
        experimentActive = false;
        Logger::log("📋 No state file and no population found. New experiment will be created.");
        return;
    }
    
    // 2. 解析状态文件
    int commaPos = content.indexOf(',');
    if (commaPos < 0) {
        experimentActive = false;
        return;
    }
    uint32_t savedExpId = content.substring(0, commaPos).toInt();
    uint32_t savedGen = content.substring(commaPos + 1).toInt();
    
    // 3. 验证状态文件指向的代数
    String popPath = "/pop_gen_" + String(savedGen) + ".bin";
    if (SPIFFS.exists(popPath) && verifyPopulationFile(popPath, POPULATION_SIZE)) {
        currentExperimentId = savedExpId;
        currentGeneration = savedGen;
        RollingStorage::setCurrentGeneration(savedGen);
        experimentActive = true;
        Logger::logf("✅ Loaded state: exp=%lu, gen=%lu", currentExperimentId, currentGeneration);
        return;
    }
    
    // 4. 回退到前一代
    if (savedGen > 1) {
        uint32_t prevGen = savedGen - 1;
        String prevPath = "/pop_gen_" + String(prevGen) + ".bin";
        if (SPIFFS.exists(prevPath) && verifyPopulationFile(prevPath, POPULATION_SIZE)) {
            Logger::logf("✅ Recovered to previous generation: %lu (state was %lu)", prevGen, savedGen);
            currentExperimentId = savedExpId;
            currentGeneration = prevGen;
            RollingStorage::setCurrentGeneration(prevGen);
            experimentActive = true;
            scheduleStateSave();  // 延迟修正状态文件
            return;
        }
    }
    
    // 5. 扫描所有可用代，找最新的
    uint32_t latest = findLatestGeneration();
    if (latest > 0) {
        Logger::logf("✅ Recovered to latest available generation: %lu (state was %lu)", latest, savedGen);
        currentExperimentId = savedExpId;
        currentGeneration = latest;
        RollingStorage::setCurrentGeneration(latest);
        experimentActive = true;
        scheduleStateSave();
        return;
    }
    
    // 6. 无可用数据 → 保留状态但不激活
    Logger::log("========================================");
    Logger::log("❌ No recoverable generation found");
    Logger::log("   🔒 DATA PRESERVED - Not auto-resetting");
    Logger::log("   📋 Manual action required via Web UI");
    Logger::log("========================================");
    currentExperimentId = savedExpId;
    currentGeneration = savedGen;
    experimentActive = false;
}
    
    static void startNewExperiment() {
        if (!RobustStorage::isReady()) {
            Logger::log("❌ startNewExperiment: SPIFFS not ready");
            return;
        }
        
        uint32_t latest = findLatestGeneration();
        if (latest > 0) {
            Logger::logf("⚠️ Existing data found (gen %lu) - continuing", latest);
            currentExperimentId = (uint32_t)millis();
            currentGeneration = latest;
            RollingStorage::setCurrentGeneration(latest);
            experimentActive = true;
            safeSaveState();
            Logger::logf("📌 New experiment session: ID=%lu, gen=%lu (data preserved)", 
                         currentExperimentId, currentGeneration);
        } else {
            currentExperimentId = (uint32_t)millis();
            currentGeneration = 1;
            RollingStorage::setCurrentGeneration(1);
            experimentActive = true;
            safeSaveState();
            Logger::logf("📌 New experiment initialized: ID=%lu, gen=1", 
                         currentExperimentId);
        }
    }
    
    static void setCurrentGeneration(uint32_t gen, bool saveState = true) {
        currentGeneration = gen;
        RollingStorage::setCurrentGeneration(gen);
        if (saveState) {
            safeSaveState();
            Logger::logf("📌 Generation set to %lu (state saved)", gen);
        } else {
            scheduleStateSave();
            Logger::logf("📌 Generation set to %lu (state pending)", gen);
        }
    }
    
    static void incrementGeneration() { 
        uint32_t newGen = currentGeneration + 1;
        pendingGeneration = newGen;
        hasPendingGeneration = true;
        Logger::logf("📈 Generation incremented to %lu (pending, state not saved)", newGen);
    }
    
    static uint32_t getCurrentGeneration() { return currentGeneration; }
    static uint32_t getMaxGenerations() { return MAX_GENERATIONS_PER_EXPERIMENT; }
    static float getProgress() { return (float)currentGeneration / MAX_GENERATIONS_PER_EXPERIMENT; }
    static bool isExperimentComplete() { return currentGeneration >= MAX_GENERATIONS_PER_EXPERIMENT; }
    static bool isExperimentActive() { return experimentActive; }
    
    static bool shouldStartNewExperiment() {
        return false;
    }
    
    static bool savePopulation(Gene* population, int size) {
        return savePopulationForGeneration(currentGeneration, population, size);
    }
    
    static bool loadPopulation(uint32_t generation, Gene* population, int size) {
        Logger::logf("📖 loadPopulation: loading gen=%lu, popSize=%d", generation, size);
        
        if (!RobustStorage::isReady()) {
            Logger::log("❌ loadPopulation: SPIFFS not ready");
            return false;
        }
        
        String path = String(POP_PREFIX) + String(generation) + ".bin";
        Logger::logf("  File path: %s", path.c_str());
        
        if (!SPIFFS.exists(path)) {
            Logger::logf("❌ loadPopulation: file not found: %s", path.c_str());
            return false;
        }
        
        size_t fileSize = FileUtils::getFileSize(path);
        if (fileSize == 0) {
            Logger::logf("❌ loadPopulation: file size 0: %s", path.c_str());
            return false;
        }
        Logger::logf("  File size: %d bytes", fileSize);
        
        File file = SPIFFS.open(path, FILE_READ);
        if (!file) {
            Logger::logf("❌ loadPopulation: cannot open: %s", path.c_str());
            return false;
        }
        
        uint8_t* buffer = (uint8_t*)malloc(fileSize);
        if (!buffer) { file.close(); return false; }
        file.read(buffer, fileSize);
        file.close();
        
        uint8_t* ptr = buffer;
        
        uint32_t magic; memcpy(&magic, ptr, 4); ptr += 4;
        if (magic != FILE_MAGIC) { 
            Logger::logf("❌ loadPopulation: invalid magic 0x%08X", magic);
            free(buffer); 
            return false; 
        }
        
        uint16_t fileVersion; memcpy(&fileVersion, ptr, 2); ptr += 2;
        uint16_t popSize; memcpy(&popSize, ptr, 2); ptr += 2;
        Logger::logf("  fileVersion=0x%04X, popSize=%d", fileVersion, popSize);
        
        if (popSize != size) { 
            Logger::logf("❌ loadPopulation: size mismatch: file=%d, expected=%d", popSize, size);
            free(buffer); 
            return false; 
        }
        
        uint32_t fileGen, fileExpId;
        memcpy(&fileGen, ptr, 4); ptr += 4;
        memcpy(&fileExpId, ptr, 4); ptr += 4;
        
        size_t remaining = fileSize - (ptr - buffer);
        size_t minPerIndiv = 1 + MIN_RULES * sizeof(BehaviorRule) + 4 + 4 + 4 + 12 + 1 + 8 + 3;
        size_t expectedMin = size * minPerIndiv;
        
        if (remaining < expectedMin) {
            Logger::logf("❌ loadPopulation: file too small! remaining=%d, need %d", remaining, expectedMin);
            free(buffer);
            return false;
        }
        
        for (int i = 0; i < size; i++) {
            size_t read = deserializeIndividual(ptr, remaining, population[i], fileVersion);
            if (read == 0) {
                Logger::logf("❌ loadPopulation: deserialization failed for individual %d", i);
                free(buffer);
                return false;
            }
            ptr += read;
            remaining -= read;
        }
        
        free(buffer);
        Logger::logf("✅ loadPopulation: loaded %d individuals from gen %lu", size, generation);
        return true;
    }
    
    static bool populationFileExists(uint32_t generation) {
        if (!RobustStorage::isReady()) return false;
        String path = String(POP_PREFIX) + String(generation) + ".bin";
        return SPIFFS.exists(path);
    }
    
    static bool savePopulationForGeneration(uint32_t gen, Gene* population, int size) {
        Logger::logf("💾 savePopulationForGeneration: saving gen=%lu, popSize=%d", gen, size);
        
        if (!RobustStorage::isReady()) {
            Logger::log("❌ savePopulationForGeneration: SPIFFS not ready");
            return false;
        }
        
        size_t totalSize = 4 + 2 + 2 + 4 + 4;
        for (int i = 0; i < size; i++) {
            uint8_t rc = constrain(population[i].ruleCount, MIN_RULES, MAX_RULES);
            size_t indivSize = 1 + rc * sizeof(BehaviorRule) + 4 + 4 + 4 + 12 + 1 + 8 + 3;
            totalSize += indivSize;
        }
        
        Logger::logf("  Total size: %d bytes", totalSize);
        
        if (!RollingStorage::ensureSpace(totalSize + 512)) {
            Logger::logf("❌ savePopulationForGeneration: insufficient SPIFFS space (need %d)", totalSize + 512);
            return false;
        }
        
        uint8_t* buffer = (uint8_t*)malloc(totalSize);
        if (!buffer) {
            Logger::log("❌ savePopulationForGeneration: malloc failed");
            return false;
        }
        
        uint8_t* ptr = buffer;
        
        uint32_t magic = FILE_MAGIC; memcpy(ptr, &magic, 4); ptr += 4;
        uint16_t version = FILE_VERSION; memcpy(ptr, &version, 2); ptr += 2;
        uint16_t popSize = size; memcpy(ptr, &popSize, 2); ptr += 2;
        uint32_t genVal = gen; memcpy(ptr, &genVal, 4); ptr += 4;
        uint32_t expId = currentExperimentId; memcpy(ptr, &expId, 4); ptr += 4;
        
        for (int i = 0; i < size; i++) {
            size_t written = serializeIndividual(population[i], ptr, totalSize - (ptr - buffer));
            if (written == 0) {
                free(buffer);
                Logger::logf("❌ savePopulationForGeneration: serialization failed for individual %d", i);
                return false;
            }
            ptr += written;
        }
        
        size_t finalSize = ptr - buffer;
        
        String tempPath = String(POP_PREFIX) + "temp_gen_" + String(gen) + ".bin.tmp";
        String targetPath = String(POP_PREFIX) + String(gen) + ".bin";
        
        if (!FileUtils::atomicWrite(tempPath, buffer, finalSize)) {
            free(buffer);
            Logger::logf("❌ savePopulationForGeneration: atomicWrite failed for gen=%lu", gen);
            return false;
        }
        free(buffer);
        
        if (!verifyPopulationFile(tempPath, size)) {
            SPIFFS.remove(tempPath);
            Logger::logf("❌ savePopulationForGeneration: verification failed for gen=%lu", gen);
            return false;
        }
        
        if (SPIFFS.exists(targetPath)) {
            SPIFFS.remove(targetPath);
        }
        
        if (!SPIFFS.rename(tempPath, targetPath)) {
            SPIFFS.remove(tempPath);
            Logger::logf("❌ savePopulationForGeneration: rename failed for gen=%lu", gen);
            return false;
        }
        
        if (!verifyPopulationFile(targetPath, size)) {
            SPIFFS.remove(targetPath);
            Logger::logf("❌ savePopulationForGeneration: final verification failed for gen=%lu", gen);
            return false;
        }
        
        Logger::logf("💾 savePopulationForGeneration: gen=%lu saved successfully ✅", gen);
        return true;
    }
    
    static bool verifyPopulationFile(const String& path, int expectedSize) {
        if (!RobustStorage::isReady() || !SPIFFS.exists(path)) return false;
        
        File file = SPIFFS.open(path, FILE_READ);
        if (!file) return false;
        
        size_t fileSize = file.size();
        if (fileSize < 4 + 2 + 2 + 4 + 4) {
            file.close();
            return false;
        }
        
        uint8_t* buffer = (uint8_t*)malloc(fileSize);
        if (!buffer) { file.close(); return false; }
        file.read(buffer, fileSize);
        file.close();
        
        uint8_t* ptr = buffer;
        uint32_t magic; memcpy(&magic, ptr, 4); ptr += 4;
        if (magic != FILE_MAGIC) { free(buffer); return false; }
        
        uint16_t version; memcpy(&version, ptr, 2); ptr += 2;
        uint16_t popSize; memcpy(&popSize, ptr, 2); ptr += 2;
        
        bool valid = (popSize == expectedSize && popSize <= POPULATION_SIZE);
        free(buffer);
        return valid;
    }
    
    static void commitGeneration(uint32_t gen) {
        currentGeneration = gen;
        RollingStorage::setCurrentGeneration(gen);
        safeSaveState();
        pendingGeneration = 0;
        hasPendingGeneration = false;
        Logger::logf("✅ Generation %lu committed (state.mrk updated)", gen);
    }
    
    static void rollbackPendingGeneration() {
        if (hasPendingGeneration) {
            Logger::logf("⚠️ Rolling back pending generation %lu", pendingGeneration);
            String tempPath = String(POP_PREFIX) + "temp_gen_" + String(pendingGeneration) + ".bin.tmp";
            if (SPIFFS.exists(tempPath)) SPIFFS.remove(tempPath);
            pendingGeneration = 0;
            hasPendingGeneration = false;
        }
    }
    
    static bool commitPendingGeneration() {
        if (!hasPendingGeneration) {
            Logger::log("⚠️ No pending generation to commit");
            return false;
        }
        
        uint32_t gen = pendingGeneration;
        Logger::logf("🔄 Committing pending generation %lu", gen);
        
        String targetPath = String(POP_PREFIX) + String(gen) + ".bin";
        if (!SPIFFS.exists(targetPath)) {
            Logger::logf("❌ Cannot commit gen %lu: population file not found!", gen);
            rollbackPendingGeneration();
            return false;
        }
        
        if (!verifyPopulationFile(targetPath, POPULATION_SIZE)) {
            Logger::logf("❌ Cannot commit gen %lu: population file verification failed!", gen);
            rollbackPendingGeneration();
            return false;
        }
        
        commitGeneration(gen);
        return true;
    }
    
    static bool hasPendingGenerationToCommit() { return hasPendingGeneration; }
    static uint32_t getPendingGeneration() { return pendingGeneration; }
    
    static uint32_t findLatestGeneration() {
        if (!RobustStorage::isReady()) return 0;
        
        uint32_t latest = 0;
        File root = SPIFFS.open("/");
        if (!root) return 0;
        
        while (File f = root.openNextFile()) {
            String name = String(f.name());
            if (name.startsWith(POP_PREFIX) && name.endsWith(".bin")) {
                String numStr = name.substring(strlen(POP_PREFIX), name.lastIndexOf('.'));
                uint32_t gen = numStr.toInt();
                if (gen > 0 && gen < 1000000) {
                    if (gen > latest) latest = gen;
                }
            }
            f.close();
        }
        root.close();
        
        return latest;
    }
    
    static bool saveIndividualRecord(uint32_t generation, int individual, const Gene& gene) {
        if (!RobustStorage::isReady()) return false;
        
        size_t estimatedSize = 512 + (size_t)gene.ruleCount * 64;
        if (!RollingStorage::ensureSpace(estimatedSize)) {
            Logger::logf("❌ saveIndividualRecord: insufficient space");
            return false;
        }
        
        String path = String(GEN_RECORD_PREFIX) + String(generation) + "_id_" + String(individual) + ".csv";
        String content = "# individual_meta: survival_time=" + String(gene.survival_time) 
                       + " distance_ticks=" + String(gene.distance_ticks) 
                       + " noveltyScore=" + String(gene.noveltyScore, 6)
                       + " obstacleThreshold=" + String(gene.obstacleThreshold)
                       + " clearThreshold=" + String(gene.clearThreshold)
                       + " encoderDiffThreshold=" + String(gene.encoderDiffThreshold)
                       + " encoderDiffMin=" + String(gene.encoderDiffMin)
                       + " wheelSpinThreshold=" + String(gene.wheelSpinThreshold)
                       + " wheelStopThreshold=" + String(gene.wheelStopThreshold)
                       + " stuckWindowSize=" + String(gene.stuckWindowSize)
                       + " chaosNoiseAmplifier=" + String(gene.chaosNoiseAmplifier)
                       + " chaosMinPwm=" + String(gene.chaosMinPwm)
                       + " chaosTimeoutMs=" + String(gene.chaosTimeoutMs)
                       + " chaosForceTimeoutMs=" + String(gene.chaosForceTimeoutMs)
                       + " hasChaosRules=" + String(gene.hasChaosRules ? 1 : 0)
                       + " chaosRuleCount=" + String(gene.chaosRuleCount)
                       + " chaosRulesStartIndex=" + String(gene.chaosRulesStartIndex) + "\n";
        content += "ruleIndex,condType,condValue,condOp,motorL,motorR,durationMs,nextRule,isChaosRule\n";
        for (int i = 0; i < gene.ruleCount; i++) {
            const BehaviorRule& r = gene.rules[i];
            bool isChaos = (gene.hasChaosRules && 
                            i >= gene.chaosRulesStartIndex && 
                            i < gene.chaosRulesStartIndex + gene.chaosRuleCount);
            content += String(i) + "," + String(r.condType) + "," + String(r.condValue) + ",";
            content += String(r.condOp) + "," + String(r.motorL) + "," + String(r.motorR) + ",";
            content += String(r.durationMs) + "," + String(r.nextRule) + ",";
            content += (isChaos ? "1" : "0");
            content += "\n";
        }
        bool success = FileUtils::atomicWriteString(path, content);
        Logger::logf("💾 saveIndividualRecord gen=%lu id=%d %s", generation, individual, success ? "✅" : "❌");
        return success;
    }
    
    static bool saveChaosRecord(const ChaoticTestRecord& record) {
        if (!RobustStorage::isReady()) return false;
        
        String path = "/chaos_g" + String(record.generation) + "_i" + String(record.individual) + ".csv";
        String csv = "timestamp,generation,individual,chaosTriggerCount,chaosTotalDuration,"
                     "chaosMaxDuration,chaosFirstTime,chaosLastTime,"
                     "baselineDistance,chaosDistance,baselineFrames,chaosFrames,"
                     "baselineAvgSpeedL,baselineAvgSpeedR,chaosAvgSpeedL,chaosAvgSpeedR,"
                     "chaosSuccess,testTerminatedBy\n";
        char line[512];
        snprintf(line, sizeof(line),
            "%lu,%lu,%d,%d,%lu,%lu,%lu,%lu,%ld,%ld,%d,%d,%.2f,%.2f,%.2f,%.2f,%d,%d\n",
            record.timestamp, record.generation, record.individual,
            record.chaosTriggerCount, record.chaosTotalDuration,
            record.chaosMaxDuration, record.chaosFirstTime,
            record.chaosLastTime,
            (long)record.baselineDistance, (long)record.chaosDistance,
            record.baselineFrames, record.chaosFrames,
            record.baselineAvgSpeedL, record.baselineAvgSpeedR,
            record.chaosAvgSpeedL, record.chaosAvgSpeedR,
            record.chaosSuccess, record.testTerminatedBy);
        csv += line;
        bool success = FileUtils::atomicWriteString(path, csv);
        Logger::logf("💾 saveChaosRecord gen=%lu id=%d %s", record.generation, record.individual, success ? "✅" : "❌");
        return success;
    }
    
    static void clearAllExperimentData(bool confirmed = false) {
        if (!confirmed) {
            Logger::log("⚠️ clearAllExperimentData() called without confirmation");
            Logger::log("   Call with confirmed=true to execute");
            return;
        }
        
        if (!RobustStorage::isReady()) return;
        
        Logger::log("========================================");
        Logger::log("⚠️ MANUAL DATA CLEAR");
        Logger::log("   🔒 L1+L2 DATA IS PROTECTED");
        Logger::log("   📋 Only L3+L4 will be deleted");
        Logger::log("========================================");
        
        std::vector<String> toDelete;
        std::vector<String> protectedFiles;
        
        File root = SPIFFS.open("/");
        if (root) {
            while (File file = root.openNextFile()) {
                String name = String(file.name());
                int level = TieredStorageManager::getDataLevel(name);
                
                if (level == DATA_LEVEL_CORE || level == DATA_LEVEL_GENE) {
                    protectedFiles.push_back(name);
                    continue;
                }
                
                if (level == DATA_LEVEL_POP || level == DATA_LEVEL_PROCESS) {
                    toDelete.push_back(name);
                }
                file.close();
            }
            root.close();
        }
        
        Logger::log("🔒 PROTECTED (L1+L2):");
        for (const String& name : protectedFiles) {
            Logger::logf("  ✅ %s", name.c_str());
        }
        
        int deleted = 0;
        for (const String& name : toDelete) {
            if (SPIFFS.remove(name)) {
                Logger::logf("  🗑️ Deleted: %s", name.c_str());
                deleted++;
            }
        }
        
        currentExperimentId = (uint32_t)millis();
        experimentActive = true;
        pendingGeneration = 0;
        hasPendingGeneration = false;
        safeSaveState();
        
        Logger::logf("✅ Clear complete: %d files deleted, %d protected", 
                     deleted, protectedFiles.size());
    }
    
    // ★★★ 新增：定期刷新待保存状态 ★★★
    static void tick() {
        if (pendingStateSave) {
            flushPendingStateSave();
        }
    }
};

// ★★★ 静态成员定义 ★★★
const char* GeneStorage::POP_PREFIX = "/pop_gen_";
const char* GeneStorage::GEN_RECORD_PREFIX = "/gen_";
const char* GeneStorage::FRAME_LOG_PREFIX = "/frm_";
const char* GeneStorage::EXPERIMENT_MARKER = "/experiment_state.mrk";
uint32_t GeneStorage::currentExperimentId = 0;
uint32_t GeneStorage::currentGeneration = 0;
bool GeneStorage::experimentActive = false;
uint32_t GeneStorage::pendingGeneration = 0;
bool GeneStorage::hasPendingGeneration = false;
bool GeneStorage::pendingStateSave = false;

// ================================================================
// ★★★ NoveltyArchive 类 - 安全保存（4原则实现）★★★
// ================================================================

class NoveltyArchive {
private:
    BehaviorDescriptor archive[NOVELTY_ARCHIVE_MAX];
    int archiveSize;
    BehaviorDescriptor maxValues;
    static const int MAX_SAVE_RETRIES = 3;
    static const char* ARCHIVE_FILE;
    static const char* BACKUP_FILE;
    static const char* TEMP_FILE;
    static const char* EMERGENCY_FILE;

    void updateMaxValues(const BehaviorDescriptor& desc) {
        if (desc.leftSensorMean > maxValues.leftSensorMean) maxValues.leftSensorMean = desc.leftSensorMean;
        if (desc.rightSensorMean > maxValues.rightSensorMean) maxValues.rightSensorMean = desc.rightSensorMean;
        if (desc.sensorVariance > maxValues.sensorVariance) maxValues.sensorVariance = desc.sensorVariance;
        if (desc.avgSpeed > maxValues.avgSpeed) maxValues.avgSpeed = desc.avgSpeed;
        if (desc.speedVariance > maxValues.speedVariance) maxValues.speedVariance = desc.speedVariance;
        if (desc.totalDistance > maxValues.totalDistance) maxValues.totalDistance = desc.totalDistance;
        if (desc.turnBias > maxValues.turnBias) maxValues.turnBias = desc.turnBias;
        if (desc.sensorAsymmetry > maxValues.sensorAsymmetry) maxValues.sensorAsymmetry = desc.sensorAsymmetry;
        if (desc.forwardRatio > maxValues.forwardRatio) maxValues.forwardRatio = desc.forwardRatio;
        if (desc.turnRatio > maxValues.turnRatio) maxValues.turnRatio = desc.turnRatio;
        if (desc.reverseRatio > maxValues.reverseRatio) maxValues.reverseRatio = desc.reverseRatio;
        if (desc.idleRatio > maxValues.idleRatio) maxValues.idleRatio = desc.idleRatio;
    }

    bool tryLoadFromFile(const char* path) {
        size_t size = FileUtils::getFileSize(path);
        if (size < 12) {
            Logger::logf("⚠️ tryLoadFromFile: file too small %s (%d bytes)", path, size);
            return false;
        }
        
        uint8_t* buf = (uint8_t*)malloc(size);
        if (!buf) return false;
        
        File f = SPIFFS.open(path, FILE_READ);
        if (!f) { free(buf); return false; }
        
        size_t rd = f.read(buf, size);
        f.close();
        if (rd != size) { free(buf); return false; }
        
        if (memcmp(buf, "ARCH", 4) != 0) { 
            Logger::logf("⚠️ tryLoadFromFile: invalid magic %s", path);
            free(buf); 
            return false; 
        }
        
        uint16_t ver; memcpy(&ver, buf + 4, 2);
        uint16_t cnt; memcpy(&cnt, buf + 6, 2);
        uint32_t crc; memcpy(&crc, buf + 8, 4);
        
        if (ver != 1 || cnt > NOVELTY_ARCHIVE_MAX) { 
            Logger::logf("⚠️ tryLoadFromFile: invalid version/count %s", path);
            free(buf); 
            return false; 
        }
        
        size_t expectPayload = (size_t)12 * sizeof(float) + (size_t)cnt * 12 * sizeof(float);
        if (size - 12 != expectPayload) { 
            Logger::logf("⚠️ tryLoadFromFile: size mismatch %s", path);
            free(buf); 
            return false; 
        }
        
        if (CRC32::calculate(buf + 12, size - 12) != crc) { 
            Logger::logf("⚠️ tryLoadFromFile: CRC mismatch %s", path);
            free(buf); 
            return false; 
        }
        
        archiveSize = cnt;
        uint8_t* p = buf + 12;
        memcpy(&maxValues, p, 12 * sizeof(float)); 
        p += 12 * sizeof(float);
        for (int i = 0; i < archiveSize; i++) {
            memcpy(&archive[i], p, 12 * sizeof(float)); 
            p += 12 * sizeof(float);
        }
        
        free(buf);
        Logger::logf("✅ tryLoadFromFile: loaded %d behaviors from %s", archiveSize, path);
        return true;
    }
    
    // ★★★ 安全保存到指定路径（使用临时文件）★★★
    bool saveToPath(const char* path) {
        if (!RobustStorage::isReady()) return false;
        
        if (archiveSize == 0) {
            Logger::log("⚠️ saveToPath: archive empty, skipping");
            return false;
        }
        
        size_t payloadSize = (size_t)12 * sizeof(float) + (size_t)archiveSize * 12 * sizeof(float);
        size_t totalSize = 12 + payloadSize;
        
        // 计算 CRC
        uint8_t* payload = (uint8_t*)malloc(payloadSize);
        if (!payload) return false;
        
        uint8_t* p = payload;
        memcpy(p, &maxValues, 12 * sizeof(float)); 
        p += 12 * sizeof(float);
        for (int i = 0; i < archiveSize; i++) {
            memcpy(p, &archive[i], 12 * sizeof(float)); 
            p += 12 * sizeof(float);
        }
        uint32_t crc = CRC32::calculate(payload, payloadSize);
        free(payload);
        
        // 构建完整文件
        size_t totalBufSize = 12 + payloadSize;
        uint8_t* buf = (uint8_t*)malloc(totalBufSize);
        if (!buf) return false;
        
        p = buf;
        memcpy(p, "ARCH", 4); p += 4;
        uint16_t ver = 1; memcpy(p, &ver, 2); p += 2;
        uint16_t cnt = (uint16_t)archiveSize; memcpy(p, &cnt, 2); p += 2;
        memcpy(p, &crc, 4); p += 4;
        
        // 重新写入 payload
        p = buf + 12;
        memcpy(p, &maxValues, 12 * sizeof(float)); 
        p += 12 * sizeof(float);
        for (int i = 0; i < archiveSize; i++) {
            memcpy(p, &archive[i], 12 * sizeof(float)); 
            p += 12 * sizeof(float);
        }
        
        // 使用原子写入
        bool ok = FileUtils::atomicWrite(path, buf, totalBufSize);
        free(buf);
        
        if (ok) {
            Logger::logf("💾 saveToPath: saved %d behaviors to %s (CRC=0x%08X)", archiveSize, path, crc);
        }
        return ok;
    }

    // ★★★ 计算文件大小 ★★★
    size_t calculatePayloadSize() const {
        return (size_t)12 * sizeof(float) + (size_t)archiveSize * 12 * sizeof(float);
    }
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
