xavercai/PICAR/(commit log)

2026-07-18 Add files via upload
    This is the first Software-Hardware compatible algorithm version to let the evolution car run. The generation and stuck situation performance have to be checked during the test. With this notes to mark a milestone of the project. John JULY 18th 2026 a great day...
    [bllw504_2CGWEB.ino]
2026-07-24 The fist version on new Hardware to run test
    The fist version on new Hardware to run test, changes are
    /*
    * ================================================================
    * 项目名称：仿草履虫应激机制 - 小车避障进化验证系统
    * 硬件平台：ESP32-S3-WROOM-1U (AT8236电机驱动)
    * 版本： v5.5-ESP32S3-FULL-DATA-PERSISTENCE
    * 适配日期: 2026-07-23
    *
    * 特色功能：
    * - 多重数据保存机制（EEPROM + SPIFFS）
    * - 3秒自动备份
    * - 断电恢复功能
    * - 完整历史数据保存
    *
    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
2026-08-06 第一个完整的硬件版本和软件版本
    2026年8月6日晚22时的录像里的小车的软件版本，无法陷入混沌状态，有避障行为但是没有避障记录
2026-08-06 正式测试的起始版本V6.0
    修正了“不记录避障，也不能陷入混沌”的代码缺陷，实验的真实起点
2026-08-09 The first version with Survival as key target
    The first version turning focus on survival ability rather than to run long time, POC and base for all further improvement.
    In case of big disaster, this version should be the restart point of PHASE II
2026-08-09 The first version with right motor parameter
    applicapable motor parameter for further coding
2026-08-13 GenEvoluion plus Correct Motor Control
    The first compatible version after GenEvo Restructure
    [FinalTestV8005_fixed02_0814v1.ino]
2026-08-16 VOEE Test Car Monitor Updates
    New Monitor with indicator for "Random Physical Noise" from GPIO1
    [OEETestFinal_v99.ino]
2026-08-30 论文中期检查版本里的数据持久化样本对应的软件版本
    论文中期检查版本里的数据持久化样本对应的软件版本，供指导教师组审阅
2026-08-30 Methodology and Manual
    智能体软硬件结构化的分析
2026-08-31 Simplify Chaos Triggering on V5 fixed
    To simplify chaos trigger, otherwise too much time wasted
    [OEETestFinal_v9919_Final_v6Chaos.ino]
2026-09-01 IDE Code and Python Code for analysis
    最新的嵌入式代码和数据解析脚本
2026-09-02 V72
    修复种群文件存储问题
2026-09-03 Final Version for Final Test
    2 rare issues possibly causing Generation back to 1 not fixed; download and parse code is also fixed.
    [DownParse.py, OEETestFinal_v9919_Final_v74.ino]
2026-09-27 Thesis Final version plus supporting doc
    1. Thesis file
    2. Final Code to run OEE Test (OEETestFinal)
    3. OEE Test Data Sets (OEETestData2GitHub)
    4. Mapping between OEE test data sets and historical Codes (OEE Time Mapping)
    5. Parse to decode OEE test SPIFFS bin files (PD.py)
    [OEE_Time_Mapping.xlsx]
